Scherrerll/acg720-fpga-flight-controller/mechanical/README.md

# 机械结构与 CAD 资料

## 最终版总装（2026-10-31）

用户确认的机械最终版总装见 [最终版说明](final-assembly-20261031/README.md)和[原始压缩包「飞船五颜六色版.zip」](final-assembly-20261031/飞船五颜六色版.zip)。包内包含 1 个 SolidWorks 总装文件与 28 个零件文件，总装入口为 `450机架总装.SLDASM`。

## 2026-10-22 历史资料快照

以下历史快照于 2026-10-22 从用户提供的「飞机零件」资料中导出，仅归档 CAD 模型；不是当前飞行器的已核验制造包。没有打开 SolidWorks，没有重新保存、改属性、修复引用或转换原始模型，也未改动源资料。

导出 **51 个模型，23,077,780 字节**：3MF 1, DWG 1, DXF 1, SLDASM 3, SLDPRT 33, STEP 12。最大单文件 4,453,985 字节；本次适合普通 Git 存储，无需 LFS。模型清单见 [MODEL_INDEX.md](MODEL_INDEX.md)，逐文件原相对路径、字节数和 SHA-256 见 [export_manifest.json](export_manifest.json)。原始文件字节保持一致；manifest 自身不自哈希。

### 目录与入口

`cad/` 保留源目录层级，包括重复的「飞机总装/无人机总装/无人机总装」路径。原生装配入口共三个：

- `cad/装配体1.SLDASM`
- `cad/飞机总装/无人机总装/无人机总装/450机架总装.SLDASM`
- `cad/飞机总装/无人机总装/无人机总装/Sunnysky X2216 Motor.SLDASM`

打印件、发加工 STEP、浮筒 STEP/3MF 和厂商板卡 DWG 同样只是当时提供的设计/参考资料。打印件名中的数量、厚度及电池示意尺寸不视为当前装机需求。该历史快照没有导入 ZIP/RAR、视频、文档整包或 SDK。`~$` 临时锁文件排除；两个同哈希参考件重复已在 manifest 记录别名，原生零件的同哈希多路径仍保留。

### 装配依赖检查的明确边界

对三个原生装配进行了只读二进制签名、UTF-8/UTF-16 文件名候选和有限 zlib 头扫描。本机没有使用 SolidWorks 应用或 Document Manager；三个文件均未由本次扫描解析出组件引用树。详细结果及同目录可见文件见 [assembly_dependencies.json](assembly_dependencies.json)。

**三个装配的外部缺件情况均未能确定；未检出可读引用不等于没有外部依赖。** 内嵌/虚拟组件、配置、抑制件、外部搜索路径、保存版本、方程式和特征依赖未解析；未执行打开、解析、重建、干涉、质量或尺寸验证。不能据此声称总装可重建或零件齐全。以后应在合法可用的 CAD 环境中针对副本检查，并记录实际缺件及版本提示；本次不提供未经验证的装配修复。

### 与当前装机和固件的差别

- `Sunnysky X2216 Motor.SLDASM` 是模型所标的电机组件；现有硬件记录为 AIR 动力/电调相关实物，不能将 Sunnysky 模型当成实物型号证明，安装孔位、外形、重量与螺旋桨均未逐项核验。
- 模型含 ICM42688P、TFmini-S、D435i、浮筒/防水壳等历史或扩展设计；当前固件传感器已演进至 BMI088、MTF-01P，相机和浮筒模型不代表这些扩展已用于飞控闭环或经过飞行验收。
- `AVG720`/`ACX720-V3` 是原文件名，原样保留，不据此确认它们与实际 ACG720 60K 的板卡版本、孔位或连接器完全一致。
- 电池、电调等「示意」零件属于占位参考；未验证采购替代件、装配公差、承载能力、重心、线束避让或加工可制造性。当前硬件说明见 [HARDWARE.md](../docs/HARDWARE.md)。

### 来源与权限

模型来自用户提供的原资料；其中 Sunnysky、Intel RealSense、Holybro、北醒、BMI088 模块、板卡等明显厂商参考件的最初作者、下载来源和公开再分发许可未逐项核清。私有归档不产生公开再许可，本目录不授予统一 MIT/GPL 许可。保留原始模型及内嵌属性；没有为公开发布清洗作者、公司或外部路径元数据，也不将未知格式二进制检查视为完整隐私审计。后续公开前需另行核对来源、许可与元数据。
