Scherrerll/acg720-fpga-flight-controller/analysis/20261026_landing_altitude/README.md

# B0B3 最低油门悬停与前飞掉高调查（2026-10-26）

本次调查针对用户新飞行反馈：最低油门时仍悬空、基本不下降；前飞时略掉高。飞行记录、源码机制与定向 RTL 见证分别记录，不能互相替代。当前安装的 B0B3、Flash 镜像和用户参数均未被本次分析修改，没有重新综合、布线或烧录。

**范围更新：用户随后表示飞得较低，认为掉高与地效有关，要求该项不用继续处理。因此掉高调查到此暂缓，只归档此前已完成的证据；地效记为用户判断，不记为已验证根因。后续处理聚焦最低油门仍不下降。**

## 可以下电；参数已记录

飞机落地、桨叶完全停转后可以断开电池，后续分析使用已保存记录。最后已读回的水平共享参数是 **P=0.1000、I=0.0350、generation=8**。参数银行为易失存储，断电后恢复 P=0.0500、I=0；Flash 中的程序仍保留。下次停桨时可通过地面站重新写入成对参数，并查询确认。此次记录不等于这组增益已完成飞行验收。

## 新日志确认了什么

固定窗口 SHA256 为 `c46a8f81344b5af33060c216fd0446383a6b65c477680b73e0668d7df18b469c`，UTC 02:31:09.119024 至 02:53:44.270821，共 47,013 行。原始窗口保留在本机忽略目录，收据在 INPUTS.json；不依赖继续上电或读取活动日志。以下时间为北京时间，所有字段按同一 `(epoch, sequence)` 联结，缺包不补。

| 片段（epoch 8） | 观察 | 可成立的结论 |
| --- | --- | --- |
| seq4259–4282，约10:45:20–25，24帧、4.6秒采样跨度 | CH3=1002、CH5=2000；目标高度 +1284→−1740mm；融合高度260..318mm；24/24帧Z collective=1850；XY/Z active，fallback=false，Z reason=0 | 下降操纵已收到且目标确实下降；输出持续处于上限，不能归因为遥控未到最低、目标不下降或高度降级。日志是离散采样，不证明每个未记录时刻的值。 |
| seq4283 | CH5离开高位，飞行旗标关闭，四路PWM=1000 | 与用户拨开关才停桨的描述相符；不能把停桨当成正常下降着陆。 |
| seq3715–3738，seq3724缺主帧 | 两个严格连续子段均出现低CH3、负目标高度、Z collective=1850且未降级 | 同一次飞行内还存在相似高端保持；不跨缺帧声称连续性。 |
| seq3073–3080，较早generation 7 | 低杆时Z collective=1000..1195，电机受1200运行下限限制；下一帧CH5仍高但已停机 | 并非所有低杆事件都卡1850，也不能把1200下限统一当成本次根因；内部land_lock没有直接遥测。 |
| seq3579–3595，generation 8，3.2秒采样跨度 | CH2=1552..1594、CH3接近中位；目标恒1400mm；融合高度1214→941mm，原始距离1154→873mm；Z collective全1850，无fallback | 找到目标不变而高度下降的前飞相关片段；当时总油门已无继续上调余量。没有外部高度真值，不能单独确定物理掉高的全部原因。 |

参数响应 A591 使用32位事务号，不能与飞行遥测16位序号相联结。参数只按同次启动和先前有效读回关联。详见 logs/FINDINGS.md、joined_rows.csv 和解析脚本。

## 已复现的高度积分饱和机制

B3 高度输出为 `1000 + clip(0.2*e + I + bias, 0, 850)`。bias 趋近350；I限幅却允许约 `±(2000−bias)`，没有随最终850上限停止正向积累的反馈。I每11ms最多变化1.1，即最大约100单位/秒。

因此，较长正高度误差能在输出已到1850后继续累积I。随后最低油门稳态请求约−2500mm/s，外环约−1500mm/s，加速度和实测垂速接近零时P项约−600。若先前I+bias接近2000，减掉600仍大于850，输出会继续顶满，直到积分退回。水平P/I接口并不直接修改这个Z积分器。

真实 B3 `mtf_xyz_hold_control`、Z杆处理和数学服务的定向 RTL 测试已通过：合法固定 height=300mm、vz=0、az=0；CH3=1684自然累积约20秒后改为1002，无强制私有状态。下降后目标在1.199秒转负，但前4.6秒的419/419次Z发布仍为1850；6.182秒才离开上限，12.188秒才低于1250。独立 `ano_flight_state` 测试也通过：低杆+1850不能启动着陆计时；1250不满足严格小于判据；1249持续1501逻辑毫秒才触发land_lock。

这些时间是**固定传感器定向测试的逻辑时间，不是飞行操作等待时间**。回调的墙钟间隔加速，内部1ms杆处理和11ms PID步长保留；未模拟机体、ESC、传感器闭环、四客户竞争或整机PWM。因此证明的是源码机制自然可达，不能声称完整重放了本次飞行。日志没有内部I值，历史事件的唯一根因仍未确定；该机制是有实测对应和RTL见证支持的首要候选。

P2参考也包含该积分上限与最终输出裁剪结构。FINAL_P=0.35作用于姿态率环输出，P2高度输出并未在末端再乘一次0.35；不能以‘漏乘0.35’为由直接更改B3。

## 前飞掉高的判断边界

本节记录用户要求暂缓之前已完成的检查，不继续安排掉高调查、补偿修改或飞行验证。

当前主链没有按实际roll/pitch显式加入总推力倾角前馈。总推力不变时，其垂直分量随倾角减小，这是可能的贡献；测距几何中的余弦投影并不是推力补偿。混控逐电机裁剪，1850总油门附近上侧差动余量只有150，姿态修正可能进一步受限。

上述前飞片段实测roll仅−0.70..0.67°、pitch−1.06..3.95°，对应垂直投影损失小于0.25%，不足以直接把全部掉高归因于倾角。该片段同组上报的command和physical四PWM各自均值均为1850，均未触2000；两种四元组存在不同锁存时刻，不能据此说它们来自同次混控瞬间。最后一次飞行seq4041–4282的242个A582也都报告1850，高端状态早于最低油门。不能把PWM直接当推力，也不能由内部测距独立证明世界坐标高度。倾角、混控与参考源码细节见 tilt/FINDINGS.md。

## 修改与验收状态

- 本次新增有限日志解析、定向RTL见证和调查报告；没有修改当前飞控算法、用户参数或Flash。
- 已确认输出上限与积分上限不一致可产生较长恢复过程。修复候选应让Z积分感知最终输出饱和，并验证反向操纵能及时减小输出，同时覆盖正常悬停、起飞、下降与降级。不能直接用强制低杆停桨绕过下降控制。
- 尚未实现或验收该候选，没有新布线结果或可刷入的新版本；旧版高度首次失效、旋转假速度及持续悬停的未决项也不因本次见证自动结案。
- 当前下降控制异常应先在地面验证修复，不建议继续用飞行来试探它会等待多久才下降。

运行 `python -B analysis/20261026_landing_altitude/verify_analysis.py --external-inputs` 可校验归档和本机输入字节。它不重跑仿真，也不宣称完成飞行验收。模拟命令、退出码和范围分别见 landing/rtl_results.json 与 tilt/tilt_math_results.json。
