Scherrerll/acg720-fpga-flight-controller/firmware/B0B2/hardware/v15_active_imu_20261025T131703_954633Z/README.md

# V15 短时主动控制下的 IMU 连续性

**本项通过。**用户确认继续拆桨、机架放稳，以遥控器短时提速后将 SWA/SWC 拨低、油门拉至最低；软件全程只读本机 HTTP 遥测。

| 项目 | 结果 |
| --- | --- |
| 光流 XY、Z 高度及角速度控制同时工作 | 约 5.0488 秒，23 个不同主帧 |
| 该区间 IMU 原始 / 接收 / 姿态计数增量 | 各 5,008 |
| 整段记录 | 75.6972 秒，接收计数 +75,719 |
| 新增 IMU 拒收 / 控制故障 | 0 / 0 |
| 采样检查中的更新计数停滞 | 0 |
| 报告的 dt 范围 | 0.88944–1.1226 ms |
| 已完成姿态发布间隔历史最大值 | 最终 1.1226 ms |
| 主动控制期间四路 PWM 总范围 | 1392–2000 μs |
| 触及 PWM 限幅的不同主帧 | 5 / 23 |
| Z 总油门范围 | 1438–1850 μs |
| 光流目标姿态最大绝对值 | 0.16° |
| 姿态范围 | 横滚 +0.79～+0.85°，俯仰 +3.34～+3.37° |
| 最终停机 | 未解锁、控制关闭、四路命令及 PWM 均 1000 μs |
| 解锁撤销原因 | 0x34，SWA 回低 |

固定机架没有随升高指令运动，记录到总油门升高及混控限幅；这类拆桨记录不能用于验收空中增益、带载振动或悬停精度。本次只验证已安装 V15 在短时主动控制和电机提速时的 IMU 数据连续性。主帧只有约 5 Hz，计数来自板端诊断，主机没有逐个接收到所有 1 kHz IMU 样本。

整段主遥测 370 帧，缺失 8 帧、CRC 错误 0、丢弃字节 205。MTF 模块校验、长度、UART、超时、缺样、重复及重启计数均无新增。记录器当次最终检查无错误、丢弃记录块/字节为 0。

## 证据和镜像边界

- [统计结果](summary.json)、[原始记录](samples.jsonl)、[操作者完成记录](operator_finished.json)。
- 原始记录 SHA-256：`befb4a902f730a2da9908719d93d5e0436c71f1f4c5d65d8d2f72b32f58b33b6`。
- 观察器 SHA-256：`8f7eefa897b19d4bc5849f77729a7ae85e3af89654a681a9a6b0afd5935925d7`。
- 已安装 V15 清单 SHA-256：`c0827d5331af3055770dd999aee89e82ee5074ee20cae3aa076a0956155edca1`。
- 仍为 V15 SRAM B0B2；没有下载新候选，没有 Flash 写入，没有串口控制写入。新候选的两轮布局布线已停止。

零点修正及光流目标 ±12° 候选未安装。V15 继续保留原零点偏差、±25°目标与 ±15°观测范围不一致，以及未定量确认的光流尺度/旋转分量。现有 XY 是光流速度 PI，没有固定坐标位置外环；本项通过不等于稳定定点或飞行验收通过。`flight_ready=false`。

外场前必须处理镜像保持：当前 V15 只在 SRAM，整机断电会丢失；已验证的旧 Flash 默认是 B0B0。重新上电不能直接当作 V15 试飞。此前只授权 SRAM，本轮没有擅自改写默认上电固件。
