Scherrerll/acg720-fpga-flight-controller/firmware/B0B2/hardware/v15_flow_motion_20261025T125704_865917Z/README.md

# 本轮光流动作采集已取消，未取得通过结论

用户表示无法准确执行整组动作，并要求复用此前已经做过的检查。本轮因此停止，**平移轴向、比例及旋转资格均未通过**。`capture_summary.json` 的 `capture_completed` 只表示记录已正常关闭；其中 `operator_report.movement_sequence_completed=false`，不能解释为动作完成或验收通过。

最初 10 秒发生在动作提示之前，用户已明确确认机架由水平仪确认水平、机架静止、拆桨且 SWA/SWC 低档。这段独立静止参考保存为 `level_reference.json`，47 个不同遥测帧，横滚均值 +0.808085°、俯仰 +3.381915°，标准差约 0.00789°/0.00937°。该参考只用于候选安装零点，不用于拟合光流比例或旋转补偿。

整个只读采样持续 106.98 秒，491 个不同帧，IMU 接收计数增加 106,968，拒收及控制故障增量均为 0。未解锁，四路命令/PWM 保持 1000 μs。串口写入、下载器操作及 Flash 写入均为 0。原始采样 SHA-256：`31db4eb878a30c9af8a1b39fb11f53e3e59eb5e5deb952e946b230654a1e9c50`。
