Scherrerll/acg720-fpga-flight-controller/firmware/B0B2/hardware/v15_idle_imu_20261025T124850_724044Z/README.md

# V15 拆桨怠速 IMU 检查

结果：**通过本项检查**。用户确认四个电机怠速运行后以 SWA 低档停机；遥测记录与该操作相符。本项只覆盖拆桨、最低油门怠速，不证明带桨负载、主动角速度控制或飞行性能。

| 项目 | 实测结果 |
| --- | --- |
| 四路同时 1200 μs 的记录区间 | 22.2415 秒，90 个不同遥测帧 |
| 区间内原始 IMU / 接收 / 姿态计数增量 | 各 22,235 |
| 整段观察 | 78.1514 秒，接收计数 +78,123 |
| IMU 拒收 / 控制故障增量 | 0 / 0 |
| 采样检查发现的姿态计数停滞 | 0 |
| 怠速时报告的 dt | 0.88944–1.1226 ms |
| 已完成姿态发布间隔的历史最大值 | 前后均为 1.1226 ms |
| 怠速横滚均值 / 标准差 | +0.947° / 0.0156° |
| 怠速俯仰均值 / 标准差 | +3.2811° / 0.0138° |
| 解锁准备中断增量 / 解锁撤销增量 | 0 / 1 |
| 最终撤销原因 | 0x34，解锁开关回低 |
| 最终状态 | 未解锁，控制器未启用，四路命令及 PWM 均 1000 μs |

用户估计怠速约 15 秒；表中 22.2415 秒来自四路同时输出 1200 μs 的遥测区间。电机实际运转由用户确认，记录不包含转速测量。

整段 SiK 接收统计为 380 个主帧，序号缺失 10 帧，CRC 错误 0，丢弃字节 756。上述计数来自板端诊断，主机没有逐个接收到全部 1 kHz IMU 样本。姿态计数进展与已完成间隔共同用于检查；历史最大间隔本身不能证明不存在持续停滞。

当前镜像仍是 V15 SRAM B0B2；水平安装零点修正尚未加载，表中的姿态均值不能解释为已校零。观察器只读取本机 HTTP 遥测，串口写入 0，下载器操作 0，Flash 写入 0。电机启停由用户手动操作遥控器完成。

## 证据

- [统计结果](summary.json)、[原始采样](samples.jsonl)、[用户完成记录](operator_finished.json)。
- 原始采样 SHA-256：`73ae147c9a5ea0ad537732e40c87c04ce4c19da57e3202b01631316064fd47e4`。
- 观察器 SHA-256：`41e2b12e757193a6c601ce00f0232df9f08caab46220f8155651d6cc40ff26d5`。
- V15 清单 SHA-256：`c0827d5331af3055770dd999aee89e82ee5074ee20cae3aa076a0956155edca1`。

同日独立只读核验位于 `C:\Users\ScherrerL\Desktop\apple\timing_closure_20261025\v15_independent_20261025T124648_694529Z\summary.json`：54 个源码文件及 313 项封存证据哈希一致；复用与当前源码匹配的逻辑、映射及复位证明，并在副本上重新解析全部五类 STA，通过原约束 19.5 ns，Fmax 51.400 MHz。该核验没有重新运行逻辑仿真或布线。

按用户要求，已完成且对应控制文件未变的旧电机编号、旋向和纠偏方向结果复用；单独的 RC 超时实物复测跳过，不记为通过。全部新布线及校零镜像工作继续暂停，不自动恢复。本次通过不构成飞行放行。
