Scherrerll/acg720-fpga-flight-controller/firmware/B0B2/hardware/v15_rc_suite_20261025T110730_794943Z/README.md

# V15 遥控输入与模式请求检查

四个方向/油门输入以及 SWC 请求选择检查通过。全程 SWA 低档、未解锁、控制器禁用，四路指令及 PWM 均为 1000 μs。未发送控制命令、未重新下载镜像、未写 Flash，布线继续暂停。

| 通道 | 最低 μs | 最高 μs | 回位均值 μs |
|---|---:|---:|---:|
| CH1 横滚 | 1000 | 2000 | 1499.0 |
| CH2 俯仰 | 1000 | 2000 | 1501.0 |
| CH3 油门 | 1001 | 2000 | 1004.9 |
| CH4 偏航 | 1000 | 1995 | 1500.0 |

SWC 低、中档的 FPGA XY 请求关闭；高档开启；回低档撤销。各档均有新鲜 A582 v5 FPGA 报告核对，实际控制保持待机。低、中档界面为“自稳 + 高度控制”，高档为“光流速度控制 + 高度”。

所有阶段均无新增 IMU 拒绝或控制故障。遥测接收统计在五个观测区间内累计缺 33 帧、校验错误 2 次；所有实际检查读数均保持新鲜，原始记录及逐区间统计保存在摘要中。这些接收统计不构成物理故障原因判定。

这里验证的是未解锁条件下的输入、模式请求与输出隔离；电机编号/旋向、解锁控制反馈与实际飞行性能尚未由本轮验证。

完整摘要及逐阶段证据： [summary.json](C:/Users/ScherrerL/Desktop/apple/github_publish/acg720-fpga-flight-controller/firmware/B0B2/hardware/v15_rc_suite_20261025T110730_794943Z/summary.json)
