Scherrerll/acg720-fpga-flight-controller/firmware/B0B2/hardware/v15_stick_oscillation_20261025/rotation_followup/README.md

# V15 光流振荡：去旋转、单位与时间链路补充核查

2026-10-25。本记录补充并收紧上轮调查的根因判断，原始失败记录和此前悬停成功记录均保留原范围。

**当前结论：动态打杆振荡仍未修复，唯一根因尚未锁定。未发现 PID 默认增益、速度单位、约定轴变换或报文打包错误。当前配置在确认放稳的 20 秒中没有持续静止假速度。V15 未做外部去旋转是事实，但“MTF 必须补上外部去旋转”尚未获证；不能直接搬原 P2 的 160 系数或据飞行相关性拟合后上板。**

## 已完成的独立核查

| 核查 | 结果与范围 |
|---|---|
| PID 与速度环方程 | 与所提供 ANO 工程默认值/纯光流 of_df 支路一致，未发现 P/I/FF、反馈符号、20 ms 控制周期、回中 LPF 的明确移植错误。与未知 EEPROM 或原智能光流 of_ok 支路整体相同的说法不成立。 |
| Micolink 单位 | 厂家定义 cm/s@1m；V15 `raw × distance_mm / 100` 得到 mm/s，Q16 转换一致，不应再除模块 dt。 |
| 实际原始 RTL 单位检查 | 对冻结 V15 的 `mtf_metric_observer` 执行 19 个定向仿真用例：正负号、距离比例、dt 独立、无效输入、重复/重启连续性全部通过。这不是整个控制器/实际飞行动力学的仿真。 |
| 传输与数值链 | 独立脚本逐条检查手持捕获的 956 条记录、793 份不同 Micolink 帧。帧结构/校验/11载荷字段、metric、已存在的937组A589配对及显示换算无差异；19条缺A589不做错配。 |
| 约定坐标 | 当前前向=+rawY、右向=−rawX，符合既定安装旋转180°推导与历史平移符号；代数一致不能替代对当前安装的独立物理测量。 |
| 粗粒度延迟关联 | 本轮飞行光流与相应高度×角速度，在0偏移相关约.930/.922；±200ms时明显下降。此结果不能识别10ms曝光或精确陀螺滤波相位，也不能从真实平移中分离旋转。 |

## 为什么需要收紧“缺去旋转”的判断

原 ANO 的 UP_OF 路径采用光流积分、独立积分时长、160 pixel/degree 以及0.00012的光学尺度；基础陀螺滤波之后还增加5 Hz LPF以匹配相位。MTF 输出已经是归一化速度，并非同一种输入，不能直接移植160。

更关键的是，已固定的 FMT 参考代码虽然包含可选陀螺补偿路径，`fmt_ins_interface.c:76` 的 **OPF_FIX_GAIN 默认是0**；其默认路径仍做滤波、坐标和高度换算。因此不能将“参考中存在补偿代码”表述为“该模块默认必须外部扣陀螺”。

[厂商 Micolink 原始说明](https://micoair.com/docs/decoding-micolink-messages-from-mtf-01/)只把 `time_ms` 定义为模块系统时间，说明速度单位/换算，没有定义曝光开始、中心或结束，也没有提供陀螺积分或承诺模块内部补偿算法。V15 `dt_ms` 是相邻模块时间戳的差，**不能当作已知曝光窗**。A589仅为 FPGA 收帧时抓取最新的四级过滤后gyro；不是曝光同步积分，当前约5 Hz下传不能反演精确相位。

现有旧手持俯仰记录累计位移很小，同样说明“任何姿态变化都必然产生固定系数的大伪位移”的说法过强；因未独立约束光心平移，既不能证明内部补偿，也不能用于拟合系数。

## 本次两段新增实物记录

### 手持倾斜：仅保留观察，不作为静止或标定

[采集及响应统计](../../v15_unarmed_rotation_20261025T141628_867271Z/response_analysis.json)、[信号图](../../v15_unarmed_rotation_20261025T141628_867271Z/response_overview.png)。177.08秒、956个HTTP快照组合、778份不同的A589接收配对；横滚−8.33°…+10.29°、俯仰−8.04°…+16.73°；始终未解锁且四路1000 μs，新增IMU接收177285、拒收/控制故障0。

操作者随后确认开始动作前“**没放稳**”。因此前段不能作为静止基线，不能由其读数推断模块静止噪声；整段手持平移、转轴/光心位置没有独立测量，不能据此辨识旋转补偿系数。该限制已单独保存为 operator_context_followup.json，未改原采集内容。

### 固定支撑、手离开的20秒：当前静止读数干净

[静止报告](../../v15_static_mtf_20261025T142505_861414Z/summary.json)。操作者明确确认机体已放稳、手离开，采集20.156秒、94份不同MTF快照，模块计数增加1998：

- 姿态标准差：横滚0.0117°、俯仰0.0125°；距离202–226mm。
- 下传的两轴原始速度均为0；前向累计变化0，右向累计变化约−0.002mm、跨度约0.006mm。**这些是寄存器积分数值，不代表微米级实际定位精度。**
- MTF校验、UART、丢包、重启和积分中断计数均无新增；IMU接收增加20032，拒收/控制故障0。

这支持“当前表面/光照/高度、停机条件下没有持续静止假速度”，不能排除带桨振动、不同高度/表面或动态移动时的测量问题。

## 尚可定位的动态差异与下一步

1. 原融合按20ms运行；V15预测随加速度回调、纠正随新MTF包运行。名义Kp/Ki相同不保证完整离散相位/采样保持相同。原智能光流 of_ok 支路给P和I的反馈也不同于当前纯融合速度。
2. 光流倾角越过15°会退出并重置速度融合，控制器保留已完成的PI/滤波状态；两次实飞越界退出/恢复已记录。它可放大扰动，但本次起振时目标角本来低于12°，仅限幅到12°无法改变该起振阶段。
3. 当前速度按斜距缩放，FMT使用`distance*cos(roll)*cos(pitch)`；在各轴15°内，单轴差约3.53%、双轴约7.18%。这项差异可核实，但不能据此独自解释大幅振荡。
4. 若要将旋转污染与真实平移分离，下一份有判别力的证据需要**约束/测量光心位置的固定转轴、明确的旋转/平移对照**，并据此检查尺度和相位。再重复无位置约束的手持动作不能完成这个辨识。另一条独立分离路径是先确认姿态内环的带载小信号动态，再判定外环/测量链的阻尼；当前数据不支持声称内环已经完全排除。

本轮检查到此结束；PID、产品源码、已固化位流均未改动，没有综合、布线、下载或Flash操作。V16/V17继续暂停。后续修复应由可区分的证据驱动，当前不应以“降低PID”或“直接加去旋转”替代根因辨识。

## 可复查材料

- [19项实际RTL检查](metric_contract.json)
- [飞行数据轴/粗延迟比较](axis_lag_analysis.json)
- [控制方程独立核对](C:/Users/ScherrerL/Desktop/apple/timing_closure_20261025/flow_control_equation_audit/README.md)
- [时间链路独立核对](C:/Users/ScherrerL/Desktop/apple/timing_closure_20261025/flow_rotation_timing_audit/README.md)
- [原始报文链独立核对](C:/Users/ScherrerL/Desktop/apple/timing_closure_20261025/flow_rotation_protocol_audit/receipt.json)
- [FMT 固定参考说明](C:/Users/ScherrerL/Desktop/apple/routing_rescue_20261015/mtf01p_b0a8/references/primary_mtf_axes/EVIDENCE.txt)
