Scherrerll/acg720-fpga-flight-controller/mechanical/MODEL_INDEX.md

# 模型清单

按源目录相对路径保留；SHA-256 完整值见 `export_manifest.json`。文件数量不代表零件实例数、BOM 数量或已装机数量。

| 相对源路径 | 格式 | 字节 | SHA-256 前 12 位 |
|---|---|---:|---|
| `20008. YBX-BMI088(SPI)惯性测量单元传感器模块/3D模型/YBX-BMI088 (SPI) v1.0.step` | STEP | 1523709 | `6641772b9f94` |
| `ACX720-V3机械文件/ACX720-V3.DWG` | DWG | 150108 | `f6bb623a6451` |
| `D435i.SLDPRT` | SLDPRT | 1836562 | `839288fb0c34` |
| `Holybro SiK Telemetry Radio V3 数传电台.SLDPRT` | SLDPRT | 107272 | `7786887c4ebd` |
| `ICM42688P模块.SLDPRT` | SLDPRT | 100745 | `36c5b9d62989` |
| `d.SLDPRT` | SLDPRT | 132059 | `06aa7618c517` |
| `光流直接粘.SLDPRT` | SLDPRT | 72198 | `fedb6fb6c3f2` |
| `北醒TFmini-S激光测距传感器.SLDPRT` | SLDPRT | 82417 | `3311d2527389` |
| `发加工/中板无人机3mm.STEP` | STEP | 645119 | `26f5e2730bc5` |
| `发加工/无人机底板2mm.STEP` | STEP | 426638 | `594ba1f8d638` |
| `发加工/无人机顶板3mm.STEP` | STEP | 568665 | `59e5b1299d63` |
| `发加工/机臂碳管4个.STEP` | STEP | 143882 | `8d64cf0815d9` |
| `发加工/电机碳板3mm 8个.STEP` | STEP | 82439 | `4bd21d27b8f0` |
| `打印件/imu块块.STEP` | STEP | 43874 | `a50b3956777e` |
| `打印件/相机安装件1个.STEP` | STEP | 104896 | `fb2012c7b5c6` |
| `打印件/起落架.STEP` | STEP | 273810 | `5bb3bd259127` |
| `打印件/顶板中板连接件3个.SLDPRT` | SLDPRT | 111029 | `e7cdc4bd57a4` |
| `打印件/顶板中板连接件3个.STEP` | STEP | 44147 | `be41cbc196cf` |
| `无人机顶板3mm.STEP` | STEP | 568676 | `63c44623da86` |
| `电池.SLDPRT` | SLDPRT | 99845 | `52f3f2939b77` |
| `装配体1.SLDASM` | SLDASM | 432814 | `736988e76a0d` |
| `降压模块直接粘.SLDPRT` | SLDPRT | 72517 | `5d524850c489` |
| `飞机总装/无人机总装/无人机总装/1045 propeller.SLDPRT` | SLDPRT | 332194 | `143ad68d3758` |
| `飞机总装/无人机总装/无人机总装/16mm碳管脚架.SLDPRT` | SLDPRT | 212996 | `a0b4b4bebe70` |
| `飞机总装/无人机总装/无人机总装/450机架总装.SLDASM` | SLDASM | 4453985 | `6e9389ba1f52` |
| `飞机总装/无人机总装/无人机总装/AVG720.SLDPRT` | SLDPRT | 82726 | `35e2695df5c6` |
| `飞机总装/无人机总装/无人机总装/D435i.SLDPRT` | SLDPRT | 1836562 | `839288fb0c34` |
| `飞机总装/无人机总装/无人机总装/Holybro SiK Telemetry Radio V3 数传电台.SLDPRT` | SLDPRT | 107272 | `7786887c4ebd` |
| `飞机总装/无人机总装/无人机总装/ICM42688P模块.SLDPRT` | SLDPRT | 100745 | `36c5b9d62989` |
| `飞机总装/无人机总装/无人机总装/Sunnysky X2216 Motor.SLDASM` | SLDASM | 2820805 | `0a932e6f0bda` |
| `飞机总装/无人机总装/无人机总装/中板无人机.SLDPRT` | SLDPRT | 749992 | `083a54d81c10` |
| `飞机总装/无人机总装/无人机总装/保护壳.SLDPRT` | SLDPRT | 108928 | `faac50e790e7` |
| `飞机总装/无人机总装/无人机总装/北醒TFmini-S激光测距传感器.SLDPRT` | SLDPRT | 82417 | `3311d2527389` |
| `飞机总装/无人机总装/无人机总装/无人机底板.SLDPRT` | SLDPRT | 720719 | `3f4cd946df0e` |
| `飞机总装/无人机总装/无人机总装/无人机顶板.SLDPRT` | SLDPRT | 661219 | `32264b68902a` |
| `飞机总装/无人机总装/无人机总装/机臂碳管.SLDPRT` | SLDPRT | 172217 | `0358e06cde3f` |
| `飞机总装/无人机总装/无人机总装/机臂管架.SLDPRT` | SLDPRT | 117593 | `fbaadabfbd1a` |
| `飞机总装/无人机总装/无人机总装/浮筒.SLDPRT` | SLDPRT | 71178 | `aa72d665139c` |
| `飞机总装/无人机总装/无人机总装/电机下固定碳板.DXF` | DXF | 27885 | `0c7278da54da` |
| `飞机总装/无人机总装/无人机总装/电机下固定碳板.SLDPRT` | SLDPRT | 507901 | `f2b4fe4cb5a2` |
| `飞机总装/无人机总装/无人机总装/电机碳板.SLDPRT` | SLDPRT | 478790 | `ceb4258b1126` |
| `飞机总装/无人机总装/无人机总装/电池示意43X43X80.SLDPRT` | SLDPRT | 126709 | `05a26a316286` |
| `飞机总装/无人机总装/无人机总装/电调示意.SLDPRT` | SLDPRT | 115178 | `bdf42ae1252e` |
| `飞机总装/无人机总装/无人机总装/相机安装件.SLDPRT` | SLDPRT | 149898 | `0e2aaea174b6` |
| `飞机总装/无人机总装/无人机总装/碳管固定座.SLDPRT` | SLDPRT | 247552 | `af77808e2a56` |
| `飞机总装/无人机总装/无人机总装/脚架接底板连接件.SLDPRT` | SLDPRT | 194207 | `721d042a0979` |
| `飞机总装/无人机总装/无人机总装/防水保护壳.SLDPRT` | SLDPRT | 577773 | `d94fa4c8eead` |
| `飞机总装/无人机总装/无人机总装/降压模块直接粘.SLDPRT` | SLDPRT | 72517 | `5d524850c489` |
| `飞机总装/无人机总装/无人机总装/顶板中板连接件.SLDPRT` | SLDPRT | 105384 | `ca5406aa1fd9` |
| `飞机总装/浮筒.3mf` | 3MF | 203841 | `3c0825ae7c8e` |
| `飞机总装/浮筒.STEP` | STEP | 15176 | `86a9815758c4` |

## 排除与重复处理

仅按字节相同的 SHA-256 合并两个明确的参考件重复；原生零件目录的重复副本保留，以免进一步破坏潜在相对引用。
- `20008. YBX-BMI088(SPI)惯性测量单元传感器模块/3D模型/YBX-BMI088 (SPI) v1.0(1).step`：byte-identical vendor STEP duplicate。 保留 `mechanical/cad/20008. YBX-BMI088(SPI)惯性测量单元传感器模块/3D模型/YBX-BMI088 (SPI) v1.0.step`。
- `AVG720.DWG`：byte-identical board drawing duplicate; keep named vendor drawing。 保留 `mechanical/cad/ACX720-V3机械文件/ACX720-V3.DWG`。
- `飞机总装/无人机总装/无人机总装/~$电机下固定碳板.SLDPRT`：SolidWorks temporary lock file。
