Scherrerll/acg720-fpga-flight-controller/docs/STATUS.md

# 控制边界与待验收事项（2026-10-29）

最新的 [B0B5 V8 水面双推进版本](../firmware/B0B5/README.md)使用 A13/A14 输出 50 Hz PWM，包含模式互斥和重新使能保护。该版本的 13 项离线检查和真实 20 ns 五类 STA 均已通过。2026 年 10 月 29 日，用户反馈：“好的，我测试了一下没有问题，可以的”。这里将其记录为当前接线和测试条件下运行正常；由于没有提供具体测试项目、外部波形、镜像读回或冷启动证据，不能据此认定完整硬件或飞行资格已通过。

原始离线包及打包时的硬件状态保持不变，后续反馈见 B0B5 版本说明。下面是 10 月 26 日及更早阶段的历史状态；B0B4 后续安装和验证情况见仓库中的相关归档。

## 10 月 26 日历史状态

当时最近记录的机载基线为 P005/I0（B0B2），10 月 25 日晚的独立 Flash 校验和电池冷启动证据见[历史回执](../validation/20261025_p005_i0/README.md)。本轮没有重新检查实体或操作下载器。

[B0B3](../firmware/B0B3/README.md)完成了共享 XY 速度 P/I、电脑工具和离线验收：完整布线、实际 20 ns 约束、Fmax 50.257 MHz，五类时序通过。**当时尚未安装或写入 Flash，实机参数通信和飞行动态未验收；`flight_ready=false`。**

参数默认 P=0.05、I=0，范围为 0～1，步长 0.0001，两轴共用。写入前会核对停机条件和提交边沿；CH5 处于预解锁意图时禁止写入，飞行中只允许查询。参数修改仅在本次上电期间有效。644 字节旧遥测保持兼容，参数响应通过 A591 协议和 B0B3 构建标识识别；旧遥测仍保留 B0B2 身份，不能单凭它确认新镜像。

调参实现中的位宽溢出和解锁/提交竞态已在交付前修复，并有直接对照。转动相关伪速度和高度首次失效源仍未定位，参数接口没有解决这些问题；项目也没有加入位置环或未经辨识的去旋转补偿，既有保护保持不变。详见[两天进度](WORK_20261025_26.md)和[完整分析](../firmware/B0B3/analysis/FINDINGS.md)。

P005/I0 原 19.5 ns 报告的 setup WNS 为 −0.267 ns，共 51 个违例端点；当时对 20 ns 的判断属于分析性审阅。原 V15 的 19.5 ns 通过记录和 B0B3 的新 20 ns 厂商报告分别保留，不能互相替代。回中刹停、持续悬停、高频环路和带桨负载仍未完成新镜像资格验证。

实机 SRAM 测试需要重新确认接线、拆桨和停机状态，并取得当次授权；Flash 另行处理，不自动操纵遥控或电机。本次 Git 进度上传不重启接收器或网站，也不启动实时分享。

## 10 月 24 日历史边界

本节记录的是当时状态，不是当前机载镜像说明。当时默认版本为 B0B0，已写入 Flash 并完成电池单独供电冷启动；完整结果见 [B0B0](../firmware/B0B0/README.md)和 [10 月 23～24 日记录](WORK_20261023_24.md)。原 B0AE、B0AC 说明是历史快照，不再代表当前设备版本。

当时已通过的项目包括：零未通与 51.608 MHz 时序；选中源码、网表和位流哈希核对；三个增量证明和 13 项 MTF 边界检查；拆桨条件下的正常高度控制、测距失效后手动接管和重连不抢回；一分钟融合静止观察；四向带动力修正方向；以及 Flash 编程、独立校验、重载和电池冷启动。

SWC 低、中档为自稳加高度控制，高档请求光流速度控制加高度；低档不能称为直接手动 PWM。测距失效时切换为手动油门并锁存，传感器恢复后不会自动抢回。最低油门持续后约 1.7 秒落地锁定，当时由操作者确认为预期行为。

水平方向使用融合速度 PI，没有绝对位置外部基准。累计位置用于诊断；一分钟观察得到的 4.401 mm 不代表所有表面和动作都具有相同漂移，不同条件下的较大漂移也已记录。几何链路没有因为手动倾斜观察而增加经验比例或陀螺补偿。

仍未完成的验证包括带桨振动和负载、空中稳定性、光流转动分量与真实平移的严格区分，以及活动 XY 控制下的实际动态表现。四向纠偏试验在 SWC 低档进行，且存在混控饱和，因此只验收方向，不评价空中增益。`flight_ready=false`。

此前约 10 秒掉动力的原因由操作者确认为电池松动；这是操作者提供的硬件说明，软件无法独立证明。系统没有电池电压、电流或 ESC 转速遥测，所上报的 PWM 不等于外部波形、推力或 RPM 实测。SiK 断连期间也没有机载持久日志补回能力。

官网只读摘要按数据年龄标记 fresh、延迟或断线，不能替代飞控保护。链路为 COM17 → 本地接收器 8765 → HTTP-only 旁路 8766 → gmflylog.com；8767 不得再次占用同一 COM17。旁路每次正常启动时默认关闭分享，只有明确启用后才上传实时摘要，日志仍需逐条手动选择。
