Scherrerll/acg720-fpga-flight-controller/web/flight-console/ATTITUDE_TRACKING_20261024.md

# Estimate / Setpoint 姿态跟踪显示

本次仅改地面接收、转发和网页。不修改 RTL、约束、位流或 Flash，不重新综合、布线、烧录。

## 已有遥测

B0B0 的 A579 主包已包含下列字段。目标来自 FPGA 上报，不能用遥控杆映射值替代实际控制目标。

| 网页/CSV 字段 | A579 来源 | 单位与含义 |
| --- | --- | --- |
| `roll_sp_deg` | `target_roll_cdeg / 100` | 横滚目标角，度 |
| `pitch_sp_deg` | `target_pitch_cdeg / 100` | 俯仰目标角，度 |
| `yaw_rate_sp_dps` | `target_yaw_rate_cdeg_s / 100` | 偏航目标角速度，度/秒 |
| `yaw_rate_dps` | `gz_corrected / 16.4` | 已滤波、去偏的机体 Z 轴陀螺角速度，度/秒 |

Roll/Pitch 与同一主包的姿态估计角比较。Yaw 比较的是角速度；现有包没有航向角目标，不能把角速度目标画在航向角坐标上，也不在地面端积分出一个冒充 FPGA 目标的航向角。原相对航向角仍单独保留。

目标线按阶梯绘制，缓冲回放在下一个真实目标样本到来前保持前一上报值；估计/测量线保持原平滑方式。缺失或无资格的数据保持空值，源缺口、过期提示和原始解锁/PWM 值保留。停机时上报的目标不代表控制正在生效。

## 使用

实时页分别显示 Roll、Pitch 和 Yaw Rate 的 Estimate/Setpoint 对比。日志分析新增“跟踪对比”选择框，可切换三轴，也可继续自选字段；有完整 Roll 对比字段时默认选中这一对。没有相应目标字段的旧共享日志不会补造目标。

接收器通过 `local/receiver_setpoints.py` 包装已有只读服务，在内存中增加快照与 CSV 导出字段，并在新日志元数据中记录包装器源码哈希。已有原始日志不改写；其中带有新鲜 B0B0 身份和 A579 目标字段的记录可由新版导出器重新读取。既有云日志仍使用原已分享副本，不自动重新上传。

完整仓库内可运行 `python local/receiver_setpoints.py --port COM17 --baud 115200 --source SiK --http-port 8765 --logs "原有日志目录"`，工作目录为 `web/flight-console`；先退出占用同一串口/HTTP 端口的旧接收服务。独立部署副本需另加 `--receiver-dir "原 ground_server.py 所在目录"`。HTTP 转发仍用原显式分享入口。

本机已加载包装器，并保持原 COM17/115200/SiK 配置与原日志目录。旧日志段 `20261024T025939Z_beb53bf1` 正常关闭，新段为 `20261024T091159Z_65ddb3d0`。原 `ground_server.py`、`protocol.py`、`analysis.py`、`recorder.py` 文件哈希均未变化。

## 验证与边界

- 35 项 Node 测试、26 项 Python 测试通过，包括目标阶梯、角速度单位、未知/失效字段、云端白名单、真实应用绘图和日志轴切换；实际接收器的无串口回环启动/关闭及新日志元数据也有覆盖。
- 真实同序号 A579 原始记录与网页上游目标/角速度逐字段一致；新增本地日志已导出 387 个同时具备目标值和角速度的真实样本，本地浏览器验证 Roll → Pitch → Yaw Rate 切换。
- 官网 HTML、app.js、styles.css、live-playback.js 的 SHA-256 与构建一致，均以正确 MIME 返回；正式 live API 已返回 B0B0 及新字段，112 个历史点包含目标/角速度。
- 发布到原 EdgeOne 项目，部署号 `dp7aq5hulna5`。源码 ZIP 39 文件，SHA-256 `0eae226fc84986b393df906bc7afef229c8993b0968a2c6aba77d89dde98f089`，不含凭据或本地日志。

约 5 Hz 的地面遥测快照可用于观察较慢的姿态跟踪；实时近期趋势继续使用原有约 2 Hz 历史抽样，日志则读取导出的 A579 记录。它不能等同于 PX4 高频机载 ULog，不能证明高频内环性能。此次显示验证不增加飞行资格结论。

## 同日：恢复三轴姿态总览

按用户提供的合并曲线示例，实时页默认同图显示横滚 Roll、俯仰 Pitch、相对航向 Yaw，共用角度轴（度）和时间轴。颜色分别为青、蓝、橙，不混入单位为度/秒的偏航角速度。融合高度仍单独显示，三个目标跟踪图移到下方默认折叠的“目标跟踪对比”。展开时立即绘制，收起时不重绘隐藏图。日志的选择框也增加“三轴姿态总览”，原目标对比选项保留。

35 项 Node 测试再次通过，新增检查覆盖同一 Canvas 三条角度曲线共用比例尺、未知航向不冒充零值、默认折叠/展开绘图，以及日志三轴选择。本地真实遥测页面已核对三轴同图与展开/收起效果。仅改前端，接收器、桥接进程、遥测与固件均未重启或更改。部署号 `dp4a3wmj5ies`，源 ZIP SHA-256 `dad83cb2f836cd56e1e282d3d47971cfbf2dadad8a462221c030ffec42a10c2e`。
