Scherrerll/acg720-fpga-flight-controller/analysis/agent_reviews/v22_independent_20261027/FINAL_REVIEW.md

v22 final independent offline review passed; no actionable findings.

Source55 and one-file inverse match remain exact. The original root1 is the actual alias TEMP compilation failure; four successful stages, exact-fixture alias compile/vvp/root0, and completion root0 are separately checked. All22 successful receipts, logs, immutable inputs and unchanged guard/FSM/ground dependencies were rehashed. Original top13 is byte-exact and retains its disclosed forces. No whole-flight or physical timing proof is claimed.

The five exact-hash SYN scripts retain SYN-only, original helper, CLK50/20ns, radio, gain1000/350,18scalar ports, actual vendor/audit/root0 and complete sealing gates. The supported signal-level hint still needs actual mapping measurement. Root must supply its independent review before creating the gate. No vendor was launched and no candidate file was edited.

Citation erratum only: the priority example in SUG550 is printed page34, not31.
