Scherrerll/acg720-fpga-flight-controller/analysis/20261026_landing_altitude/logs/FINDINGS.md

# 新实飞有限窗口：低油门不下降与水平杆掉高

仅分析root固化的72,327,699字节、47,013行窗口，SHA256 `c46a8f81344b5af33060c216fd0446383a6b65c477680b73e0668d7df18b469c`；UTC 2026-10-26 02:31:09.119024–02:53:44.270821（北京时间10:31–10:53），全部为epoch8。没有读取活动日志尾部，没有HTTP、串口、硬件或Git动作。所有新增文件仅在本目录。

**关键症状已在同key日志中确认：最新两段低CH3时目标高度在下降，但Z总距请求保持1850，XY/Z仍活动且没有fallback；并非目标根本未下降。更早另有总距降至1000、输出触1200下限并随后停机的不同片段，不能混成同一机制。** 为什么Z输出保持高端，需结合源码与定向RTL结果判断，日志没有内部Z积分/限幅前各项。

## 参数与数据资格

- A591的32位`sequence`是参数事务号，未与遥测组序号混用。按同epoch接收顺序，将已观察到的成功读回关联到后续组；未读回区间保留未知。
- 最新SET事务1973207201（UTC02:42:35.573542）及独立GET1973207202（35.911683）均为P_wire1000、I_wire350、generation8，即 **P=0.1000/I=0.0350**。CSV的显示文本由wire/10000生成，保留gen与读回时刻。此前gen7为0.1000/0.0300。
- 按`(epoch,sequence)`拼A579/A580/A582/A57A/A581/A585，6776个组，主帧6651、状态包6667、导航包6764；缺包不借相邻帧。947个具有主帧和导航包的可见XY活动组，实际roll/pitch目标均等于同组导航目标。
- `log_summary.json/flight_envelopes`列出10段可见taking_off活动范围；包缺失只记未知，不填成持续有效状态。严格连续的XY、低杆及正/负CH2子段另列`segments`。全包共同缺失的一处为seq3264。

## 直接证据

下表时间为FPGA uptime跨度；PWM和总距均是机上上报值，不是推力、RPM或示波器测量。高度为估计量/原生斜距，不是外部高度真值。

| epoch8窗口 | 同key输入与资格 | 目标与高度 | 总距/输出及结论边界 |
|---|---|---|---|
| **4259–4282**，24帧、4.6s，UTC02:45:20.881–25.492；gen8 | CH3恒1002、CH5恒2000；taking_off/flying/prepared、XY/Z active均真；fallback全false，Zreason0 | target_height **1284→−1740mm**；fused **271→260mm**，全段260..318；原始distance **385→360mm**，全段354..412 | **24/24 z_collective=1850**；上报各电机范围1696..2000，其中一次触2000。可排除本段“目标不下降”及“只卡1200最低输出”的简单解释；没有可见自动停机。 |
| **3715–3738**，主/状态/导航同key为23帧；gen8 | 3715–3723与3725–3738分别连续1.6/2.6s；CH3为1002..1086、CH5=2000，均正常XY/Z、无fallback | target **−238→−1490mm**；fused **511→513mm**，已知样本496..572；原始distance端点434→434 | 已知低杆23帧Z总距均1850。**3724只有导航包**（该包也为1850），不补其CH3/解锁/状态；3739也缺主/状态。3740首个完整停机组CH5=1500、四路1000。 |
| **3073–3080**，8帧、1.4s；gen7 | CH3=1002..1004、CH5=2000；XY/Z活动、无fallback | target **−812→−1800mm**；fused **177→201mm**；原始distance245→247 | Z总距 **1195→1000**，范围1000..1195；8帧至少一路为1200，3080四路均1200。**3081 CH5仍2000，但armed/taking_off/flying/prepared均false、四路1000**。这是不同的低输出/停机片段，不能说所有低杆都必须靠SWA停机；其内部停机原因不由此单独认定。 |
| **3579–3595**，17帧、3.2s，UTC02:43:04.909–08.199；gen8 | CH2=1552..1594，CH3=1488..1498；可见XY/Z活动、无fallback | target_height **恒1400mm**；fused **1214→941mm**（−273），原始distance **1154→873mm**（−281）；pitch快照−1.06..+3.95° | Z总距17/17为1850。本段可证水平杆动作时，在目标未降的情况下两类高度读数下降；不能直接把它归因于倾斜升力、XY参数或某个Z内部项。CH2正侧动作不单独证明外部真实前飞方向/轨迹。 |

最后一段4282之后，4283（UTC02:45:25.722）CH5变为1500，armed/taking_off/flying/prepared与XY/Z active全false，上报四路1000；4284 CH5为1000。该可见顺序与操作者通过SWA退出后停桨相容，不把采样间隔内的精确动作时刻补出来。

## 能排除和仍未知的内容

1. 最新两个gen8低杆片段，不能解释成“未收到最低CH3”“高度目标没有往下降”“当前进入了height_loss_fallback”或“仅被1200运行floor夹住”。输入、目标、flags和总距已有直接证据。
2. gen7低杆片段确实出现另一种1200输出floor，并在下一完整组观察到停机；不能从本窗口证明该floor物理推力足以悬停，也不能把gen7与gen8的差异直接归因于仅改变XY I。两次起飞过程和内部状态不相同。
3. 日志**没有land_lock、landing_ms、landing_delay或Z内部P/I/前馈/限幅前总距**。可以说“低杆期间仍有taking_off且未见停机”，不能直接说“landing计时器一直为0”或唯一断定未过哪条内部条件。
4. 3579–3595支持用户掉高描述的一段可见现象；没有外部位置/高度真值、推力余量和高频控制分项，不能只由倾角快照计算闭环因果。
5. 本次是新B3实飞窗口，与此前旧V15/P005问题分开。现象定位不构成修复、增益建议或飞行验收。

复算命令（需原本地固定输入）：

```powershell
python -X utf8 -B analysis/20261026_landing_altitude/logs/analyze_landing_log.py --input out/landing_altitude_20261026/snapshot_0253Z/recent_telemetry.jsonl --sha256 c46a8f81344b5af33060c216fd0446383a6b65c477680b73e0668d7df18b469c
```

实际exit0，输入前后SHA一致。`joined_rows.csv`保留缺失值与逐组来源资格；`log_summary.json`含全部飞行包络、严格连续段和状态转变；`parameter_events.json`保留27个参数响应。输入和输出字节绑定见本目录`ARTIFACT_HASHES.json`。
