Scherrerll/acg720-fpga-flight-controller/analysis/20261026_flight_followup/rotation/FINDINGS.md

# 旋转相关假速度：第二轮只读核查

本轮确认了新的观测格点和时序约束，仍未唯一识别旋转补偿遗漏、真实平移或杠杆臂各自的贡献。没有找到这条已检查链路中的确定计算错误，不能因此宣称算法无问题，也不能把下面的描述性回归系数拿去上板。未修改任何固件、约束或旧报告，未访问HTTP、串口或硬件。

当前B0B3的MTF解析、几何转换和光流融合三个文件，与冻结P005/I0逐字节相同，哈希见`rotation_summary.json/source_bindings`。因此接口和算法结构差异仍适用；这里的飞行动态证据来自历史V15/P005，**没有把新B0B3地面参数验证当作B0B3实飞数据**。

## 1. 输入、复算与新证据

在仓库根运行，仅需Python标准库：

```powershell
python -X utf8 -B analysis/20261026_flight_followup/rotation/analyze_rotation.py
```

脚本只写自身目录。7个原始JSONL均逐项核对交接包`flight_dataset_index.json`中的SHA256；原件不复制、不改写。直接解码27字节Micolink包并验和，不导入旧分析器或产品模块。`input_manifest.json`绑定原始输入、操作者限制与P2源码；`ARTIFACT_HASHES.json`绑定本轮产物。完整派生行在`paired_native_rotation.csv`，统计和描述性回归在`rotation_summary.json`。

| 历史源 | 不同下传原生帧 | 原生时间相邻快照中位间隔 | 采样器边界 |
|---|---:|---:|---|
| V15 dynamic | 2662 | 200ms | epoch9–12；本轮动态窗取epoch12 |
| V15 unarmed_rotation | 740 | 200ms | 网页轮询，部分间隔400/600ms |
| V15 flow_motion | 459 | 200ms | 原记录没有A583配对，不能补造gyro |
| P005 latest | 1524 | 200ms | epoch20–22 |
| P005 plain / texture | 269 / 141 | 200 / 200ms | 同镜像未解锁环境对照 |
| P005 unarmed_actions | 323 | 200ms | 仅地面动作，非受控光心旋转 |

合计6118个**被下传抽到的不同原生帧**。所有所查原始包的长度/头/校验、字段解码、`raw_flow × distance`整数乘法和已有A583的距离/速度/计数对应均无不一致。这里没有执行完整C或RTL仿真，也不是完整100Hz采集。

### 新发现A：所见flow字存在粗格点，不能用零值证明去旋转

6118个抽中包的`flow_x/flow_y`都为20的整数倍；大部分分组的非零值最大公约数和最小观测间隔为20。`p005_actions/flow_y`只见一个非零40，不能单独从该分组推断20步长。这个格点**已存在于Micolink原始线字节中**，不是FPGA缩放、融合或网页舍入造成。

按官方归一化单位，`velocity_mmps = flow × distance_mm / 100`：

| 距离 | 20个raw计数对应的可见速度阶梯 |
|---:|---:|
| 0.25m | 50mm/s |
| 0.50m | 100mm/s |
| 1.00m | 200mm/s |

这是抽样数据的可见格点，**不是厂家声明的固定分辨率**，也不能排除未下传的100Hz帧出现其他格点或抽样相位混叠。以小角度图像运动解释，`v/h=0.2s⁻¹`相当于约11.46°/s的角流尺度；这不是已校准的MTF角速度常数，不能据此设死区或补偿。

V15 pitch动态窗39点中，前向raw为0有18点；手持roll主轴窗口20点中，右向raw为0有15点。因此“gyro在动但flow为0”本身不能证明内部已补偿。反过来，非零flow也不能排除真实平移、表面误跟踪、滤波与部分补偿。

融合的连续小数不增加原始观测分辨率。数例：连续有效、无加速度、初始`v=i=0`的一次后续10ms融合校正，若观测阶梯为200mm/s，则`i+=200×.01=2mm/s²`、`v+=(2×200+2)×.01=4.02mm/s`；50/100mm/s阶梯同理产生1.005/2.01mm/s。平滑融合输出不能反证上游格点。

### 新发现B：时间字段能验证接收配对，不能恢复曝光gyro

下传相邻帧的MTF `sample_count`中位跳20，模块时间中位跳200ms，尽管每帧内最近一次原生`dt_ms`为10ms。dynamic各epoch按原生时间跨度估算仅保留约3.63–5.00%，手持rotation约4.19%；这是下传/轮询覆盖率，不是模块丢包率。所查`module_missing/restarts/UART/checksum`计数均为0。

5635个有同序列接收配对的快照满足：

`MTF.fpga_snapshot_ms − A583.received_ms − MTF.source_age_ms = 0ms`

A583的原生计数、距离和metric值也对应一致。因此没有发现简单的“把这一原生包配成另一包gyro/字节”的记录错误。但`source_age`衡量模块包到达FPGA以后的年龄，**不包含未知曝光、内部处理/滤波延迟**；这不能证明曝光对齐。

两个时间域不能直接相减当延迟：手持rotation的`module_ms − FPGA_received_ms`在6463–6706ms之间；描述性仿射关系约为`module_ms = 6802.64 + 0.99865876 × FPGA_received_ms`，残差RMSE约4.02ms。该常数含各自启动原点，斜率含相对时钟/时间戳实现差异，残差也不是曝光延迟精度。27字节115200/8N1仅串行传送就约2.344ms，模块在何时标记`time_ms`仍无契约。

源码[A583接收配对](../../../firmware/B0B3/source/acg720_ano_port.v:284)保存模块metric发布边沿的最新有效gyro，并明确注明不是曝光积分。MTF[metric发布](../../../firmware/B0B3/source/sensor/mtf01p_reader.v:203)和[诊断冻结](../../../firmware/B0B3/source/sensor/mtf01p_reader.v:219)保留tuple一致性；这解决的是接收事务一致性，而非成像相位。

## 2. 可证伪离线检验与识别失败的定量原因

以下窗口从原生MTF/A583同key直接取数，不使用旧报告的拟合常数。动态窗要求`xy_active`且原生距离>600mm；手持主轴窗要求该轴gyro绝对值>5°/s且大于另外两轴绝对值最大值的2倍。动态roll为69点；旧报告67点还要求同key A579，因此两者样本定义不同，不伪装同一统计结果。

正方向为前向`rawY`对应pitch gyro，右向`−rawX`对应`−roll gyro`。这只是现有映射下的符号约定，不是重新宣告物理动态映射已验收。

| 窗口/轴 | n | r(v,ω) | r(v,hω) | r(ω,hω) | 标准化双特征Gram条件数 |
|---|---:|---:|---:|---:|---:|
| V15 epoch12 seq223–308，前向 | 39 | .93656 | .92564 | .99677 | 619 |
| V15 epoch12 seq409–505，右向 | 69 | .91535 | .91479 | .98697 | 152 |
| 手持pitch主轴，前向 | 25 | .41896 | .40860 | .99832 | 1188 |
| 手持roll主轴，右向 | 20 | −.17508 | −.16368 | .99897 | 1938 |

**高度缩放没有把旋转光流与lever arm分开。** `v = k hω + Lω + b`的两个特征几乎共线，虽在数值上并非严格秩亏，分量却不稳定。pitch动态单独拟合`hω`系数为+1.437；允许同时拟合`Lω`后，`hω`系数变成−1.903、`L`约3583mm，而R²仅从.8568变到.8868。符号翻转和巨大补偿互抵说明它不是可识别的物理标定。手持高度仅211–269mm，没有固定光心，条件数更差；不能用这批数据确定内部漏补、部分补偿或外部补偿值。

**大整帧滞后不是这两段相关性的主要解释，但小延迟未知。** 用同epoch的实际seq相邻样本、无插值，对比flow(t)与gyro(t+lag)：pitch前向在约−200/0/+200ms时r=.5591/.9256/.6274；roll右向为.5882/.9148/.6292。零整帧偏移较强，不能因此声称0ms曝光延迟。10–40ms级相位、滤波与内部曝光窗在200ms快照间隔下不可识别；缺帧和周期运动还会产生滞后混叠。

**小lever arm单独解释峰值需要不现实的大半径，但真实平移仍混杂。** seq499原生右向−3029.6mm/s，rollrate64.9593°/s；若全部归为刚性绕固定中心旋转，表观半径`|v/ω|≈2672mm`。假设100mm或300mm偏置，只产生约113或340mm/s，远小于该峰值。不过飞机当时在真实飞行，平移未测；手持试验也明确没有固定旋转中心，不能把这一条件数例当作排除lever arm或证明漏补。

**姿态投影不能从零制造该原生flow。** 当前几何用斜距×cos(roll)×cos(pitch)计算垂直高度，但原生metric先按原始distance缩放速度，之后仅做yaw旋转。两轴均15°时cos乘积约.933，提示可能的几何尺度差异，但不等于一个完整的倾斜地面光流模型，更不能把它当已修复项。单纯乘法投影不能从真实raw0制造非零raw；内部视觉算法、平面与转动成像仍需独立辨识。

**恢复段的零不是观测真的归零。** epoch12 seq293原生距离1038mm、rawX/Y=−100/60，仍对应前向622.8/右向1038mm/s；但pitch16.15°时几何/融合资格撤销，导航body与fused均为0。seq294恢复时rawY=−200、distance1005，前向−2010mm/s。seq500同理rawX40、distance1012仍对应右向−404.8mm/s，导航输出却为0；seq501恢复为rawX−340、distance873，即右向2968.2mm/s。此切换保留在`recovery_rows`，不能拿门控后的零段来证明转动污染消失或模型拟合良好。

## 3. P2、当前RTL与确定计算问题核查

| 证据 | 本轮可得结论 |
|---|---|
| P2 `Application/Ano_OF_DecoFusion.c:119–125,239–245` | UP_OF路径先5Hz低通gyro，再显式加减旋转项；`65–68`常数带光学标定含义。不是MTF通用常数。 |
| 当前[MTF字段与metric](../../../firmware/B0B3/source/sensor/mtf01p_reader.v:41)及[有符号乘法](../../../firmware/B0B3/source/sensor/mtf01p_reader.v:119) | 20B payload偏移、little-endian signed16、距离mm及除100单位对应官方契约。6118抽中帧未见字段/乘法不一致。合法12000mm×signed16的绝对乘积最大393216000，容纳于signed31，不存在该乘法的位宽溢出反例。 |
| 当前[几何输入范围](../../../firmware/B0B3/source/sensor/mtf_shared_geometry.v:47)与[速度/yaw路径](../../../firmware/B0B3/source/sensor/mtf_shared_geometry.v:188) | ±1000000的metric×100输入先检查再存signed21，范围容纳；Q16缩放后以±10000mm/s界限检查。轴交换/负号和mm↔Q16未发现漏乘10/100。yaw旋转是坐标变换，不是去旋转。 |
| 当前[rotation_compensated固定0](../../../firmware/B0B3/source/sensor/mtf_shared_geometry.v:66)及端口 | 当前FPGA该flow链没有角速度输入或显式减角速度项，因此没有发现“FPGA又做了一遍显式gyro补偿”的双补偿实现。不能由此推断模块内部一定未补或一定已补。 |
| 当前[融合](../../../firmware/B0B3/source/position/mtf_shared_flow_fusion.v:121) | 累积使用实际dt，10ms校正与P2 20ms并非逐步相等；融合会平滑和掩盖原生格点。没有通过这些稀疏字段重放内部全部1kHz加速度预测。 |

没有发现确定的字节序、单位或该乘法宽度错误。此结论不覆盖所有控制/估计算术、全部状态组合或硬件动态；不是“已排除代码问题”。

## 4. 厂家契约和实际固件身份的边界

2026-10-26复核的第一手资料，链接和访问限制另存`official_sources.json`：

- [Micolink官方解析说明](https://micoair.com/docs/decoding-micolink-messages-from-mtf-01/)定义`time_ms`为系统时间、flow为cm/s@1m及速度换算。0x51载荷包含距离、flow、质量/状态和reserved，没有固件版本、gyro、补偿标志、曝光起止或滤波延迟字段。
- [MTF-01P官方手册](https://micoair.cn/zh/docs/sensors/sensors/mtf-01p-sensors)给出100Hz、115200和多协议支持。不能从“支持PX4/ArduPilot”倒推当前Micolink字段的补偿方式，更不能把抽到的20格点当官方分辨率。
- [微空助手官方说明](https://micoair.cn/zh/docs/software-tutorial/micoassistant-guide)说明可识别设备并读取配置，Auto协议从某固件版本起提供；没有当前设备的版本/配置回执就不能假定它运行该版本。

所查6118包的device_id均15、system_id均0、reserved1均255、reserved2均65535；这些不是已定义的固件版本或补偿状态。当前材料不能证明实际MTF固件版本、光学比例、内部IMU来源或补偿开关。需要对应版本的厂家明确契约，以及受控运动记录，两者相互约束；仅凭协议名、质量非零、gyro相关或flow为零都不够。

## 5. 原因排序与最小受控地面采集

1. **旋转相关分量进入速度观测仍是强候选，尚非唯一根因。** 飞行两轴关联强，源码存在P2显式处理而本链没有的结构差异；真实平移、模块内部语义和相位尚未分离。
2. **表面/跟踪、可见格点与未知模块处理同样必须保留。** 同P005静态plain/texture有效样本的原生前/右速度RMS约128/159与6.39/5.45mm/s。环境对照未随机化、无外部真值，但不能把所有波动都归给gyro，或把融合的小数当原生高精度。
3. **接收配对≠曝光配对是确定的数据限制。** 同key tuple对应没错，曝光关系仍缺；200ms滞后检验不能解决10ms级问题。
4. **lever arm、真实平移及倾斜投影仍是混杂。** 当前窗口近共线，手持中心未固定；不能唯一分解，也不能据此宣布需要双补或已经双补。

最小下一步是拆桨停机的受控地面采集，**无需带桨飞行**，也不是本报告已执行的动作：

- 先保存实际模块型号、固件版本、协议/方向/相关配置的只读回执，并向厂家确认该版本Micolink是否补偿、gyro来源、`time_ms`对应曝光何时和滤波延迟。无需为了调查先升级/重写模块。
- 在固定纹理、光照和距离0.25/0.5/1m下，用可量测旋转轴保持光心固定；标明光心到IMU/转轴的三维偏置及误差。单独roll、pitch、yaw，正反方向、静止间隔和多个速率，顺序交叉，重复少量周期。幅度保持在现有资格范围内，不删除15°保护。
- 保存完整原生100Hz包、校验和/seq/module time/质量状态，以及同一时钟下UART末字节、gyro更新、姿态和range。采用不争用现有接收串口的被动采样，或另行授权专用只读诊断采集；当前5Hz快照不能代替这些数据。曝光相位仍须厂家契约或受控动态标识确认。
- 在固定光心与已知偏置下：随高度成比例的残余角流支持视觉旋转残留；与高度无关且符合已测`ω×r`的项支持lever arm；在量化/重复性界限内接近零才能支持补偿有效。将观察和判断阈值写在采集前，不能用本轮描述性系数预先抵消信号后再宣布通过。

若不能获得上述受控条件，应保留“旋转相关强候选、内部补偿未知、无安全标定系数”的结论，停止继续对稀疏飞行曲线作无界拟合。P/I接口与实机参数回读通过不改变该边界。
