Scherrerll/acg720-fpga-flight-controller/firmware/B0B3/analysis/FINDINGS.md

# 飞行记录与匿名飞控拓空者 P2 对照调查

本支线按用户要求与在线 P/I 实施并行，只读核查交接包的日志、原 V15、当前 P005/I0 和用户已确认的 P2 源码。只在本目录写报告、复算脚本和派生数据，没有修改产品 RTL、原始记录或参考代码，没有访问串口、接收器、下载器或飞机。

**结论：P/I 不是目前唯一可成立的原因。当前速度外环确实接管并输出了实际采用的目标；输入环境对光流观测有直接影响；原 V15 动态振荡与未经确认的旋转速度分量强相关；当前两次 XY 退出直接伴随高度失效降级锁存。P005/I0 的回中刹停和持续悬停仍未验收。新增参数接口能使调参可控、可复查，不能据此认定这些飞行问题已经解决。**

## 1. 证据身份与复算方法

交接包根目录为 `C:/Users/ScherrerL/Desktop/apple/handoff_xy_pi_runtime_20261026`。下文约定：

- `P2/` = `workspace_snapshot/reference_ano/quadrotor_tm_v1_20261012/Quadrotor_TM_V1/`。
- `RTL/` = `workspace_snapshot/timing_closure_20261025/v15_xy_p005_i0_review_20261025/source/`，为本次实施前冻结的当前源码，行号始终指该副本，避免与主线随后改动混淆。
- `V15/` = `workspace_snapshot/github_publish/acg720-fpga-flight-controller/firmware/B0B2/`。
- `候选硬件/` = `workspace_snapshot/timing_closure_20261025/v15_xy_p005_i0_review_20261025/hardware/`。

参考身份来自用户确认，本调查没有重新调查 P2 来源或版本。`audit_sources.py` 对 `ano_reference_index.json` 的 376 个文件逐个重算 SHA256，全部相符。原 V15 与 P005/I0 冻结目录的 54 个共同源码/工程文件中 53 个逐字节相同，仅 `position/mtf_xyz_hold_control.v` 的四行 P/I 算术变化。差异见 `original_to_p005i0.diff`；该控制文件原 V15 SHA256 为 `41ae4ee0c4129afcc18758d93d960c415f860ca5e2a65dfb8d199129133adff2`，当前为 `78952264bf5a507f2f9e080e53fe0dd41b940cf13c699a134fb5aa12be539258`。这支持 V15→当前候选软件层面的 P/I 对照，不能证明两次飞行环境和初态相同。

`analyze_evidence.py` 重新逐行读取有限日志窗口，以 `(epoch, sequence)` 联结 A579/A57A/A580/A581/A582/A583/A585，不跨 epoch，不填补缺帧，不拿相邻帧补齐。记录轮询快照的地面试验只保留相同 sequence 的子包，重复轮询不增加样本数；这类文件没有原接收器全局 epoch，CSV 的 epoch=0 仅表示该文件内的本地代际，不能与飞行总日志 epoch=0 混同。原始窗口中的协议字节和接收器归一化 `_protocol` 分开保存；B0B2 的 pose-age 字段保留 null。

最新窗口 1505 个主帧全部有同 key 导航包；原 V15 动态窗口 2616 个主帧有 2611 个同 key 导航包，5 个缺配保留。8 个数据集共独立检查 5882 个可用原生 Micolink 帧，长度、逐字节加和校验、大小端/符号字段和 `flow × distance` 重算均无不符。其中最新窗口 1524 帧、V15 动态窗口 2662 帧。这仅验证被遥测快照抽到的帧，不意味着已经检查模块的每个 100 Hz 样本。

可复算入口（普通 Python，无硬件依赖）：

```powershell
python -X utf8 analysis_flights/analyze_evidence.py
python -X utf8 analysis_flights/audit_sources.py
```

结果见 `evidence_summary.json`、`source_audit.json`、`equation_audit.json` 和各 `*_paired.csv`。CSV 的 `utc` 是原主机接收时刻；下列面向操作者的日期/时间已换算北京时间 UTC+8，均不表示相机曝光时刻。

## 2. 固件、保护、环境与验收范围矩阵

| 记录 | 固件/实际参数依据 | 保护与可用字段 | 时间及定位 | 操作/环境及证据边界 |
|---|---|---|---|---|
| 早期两次失败 | B0B0；旧冻结源码审阅记录 P=.15、I=.10。本包没有该旧位流/完整源码，位流哈希不能重新独立绑定 | 旧 temporal 变化拒收、旧 pose-age 策略；A585 新诊断不可用 | 10月25日02:23；epoch3，第一次 seq268–313，XY291–312；第二次425–467，XY454–465 | 原始有限窗口重新核查。视频无可靠拍摄时钟。不可把旧保护故障直接套到 B0B2 |
| 原 V15 中杆悬停 | B0B2，P=.15/I=.10；位流 `3b9920ac…b4306` | B0B2 已移除按合法 IMU 数值变化整包拒收；pose-age 不再作为资格字段 | 操作者10月25日21:44附近提交结果；本包视频没有精确遥测同步凭据，**不指认某个 epoch/seq 为视频对应段** | 操作者报告稳定，视频记录保留；无量化位置误差、无与 RC/模式同步证明，限中杆悬停反馈 |
| 原 V15 打杆摆动 | 同上原位流与 .15/.10 | B0B2；XY倾角±15°、目标角±25°；Z和XY可独立撤销 | epoch12：seq223–308、409–505；10月25日21:47:39.764–21:47:56.888、21:48:17.015–21:48:36.162 | 前后与左右打杆，回中仍摆动；179个 taking_off 主/导航配对帧。视频无逐帧同步 |
| 原 V15 不解锁旋转 | 同上 | 命令停机；A583为**接收时刻**gyro配对，不是曝光同步 | `v15_unarmed_rotation_20261025T141628_867271Z`；文件内本地seq403起 | 用户后补“没放稳”；光心平移、旋转轴/杠杆臂未知。不能估计去旋转系数或把前段当静态噪声标定 |
| 原 V15 flow_motion | 同上 | 命令停机，未做完预定动作 | `v15_flow_motion_20261025T125704_865917Z` | 动作采集取消，轴/比例/旋转资格未通过。最初明确水平静置片段可作独立零点参考，不能扩展成运动标定 |
| 当前最新两次 | B0B2 P=.05/I=0，位流 `a876c8ed…db7c`；Flash安装/校验/冷启动记录在候选目录 | 与原V15源码除P/I外相同；无旧temporal变化拒收，无pose-age资格；保留±15°/±25°和高度降级 | 10月26日00:05:32.431–00:05:36.294，epoch22 seq211–230；00:05:59.987–00:06:05.061，349–374 | 用户“像自稳”。XY实际接通46帧，两次随后高度降级。第二次仍在推横杆时已降油门，没有正常回中后持续飞行的独立窗口 |
| 当前表面对照 | 同一 `a876c8ed…db7c`，.05/0 | 未解锁，四路停机；同样MTF链 | 10月25日23:37与23:43两个static目录；文件内本地seq，不强行映射总日志epoch | 纯色桌面→打印/哑光纹理面；观测波动明显变小，未作随机交叉试验，照明/距离等未完全控制 |

原 V15 完整哈希：`3b9920acc1abecf6e0ef50465f5bc408d9b74af2ac6d046cb151137a375b4306`。当前完整哈希：`a876c8ed073588e17b6289f8aac7573334a5d5e9c992d394d0d14f61ed17db7c`。固件通用 build_id B0B2 不足以区分这两个参数镜像，实际参数身份必须依赖位流、安装记录与源码绑定。

## 3. 原始证据重新核查的结果

### 3.1 当前“像自稳”不是“外环从未接通”

epoch22 seq211–230、349–374 的 46 个可见活动帧同时具备 `xy_shadow_active`、`vertical_active`、`xyz_active`，taking_off=true，XY/Z原因均0。46/46帧的导航 `shadow_roll/pitch_cdeg` 与主帧实际选择的 `target_roll/pitch_cdeg` 相同；没有发现在线路上仅计算 shadow 而未选择目标的问题。代码真实路径是 `acg720_ano_port.v:293` → `mtf_xyz_navigation_control.v:278` → **`position/mtf_xyz_hold_control.v`** → `flight_core`。目录中另有 `ano_hold_control`、`mtf_shared_hold_control`，它们的中心杆进入门、位置外环不在这条真实控制路径上，不能据此解释本机。

例：seq225，杆 CH1=1500/CH2=1501，实际目标 roll=+2.25°、pitch=+1.31°；seq371，CH1=1673，目标+4.03°/+1.28°，实际姿态+4.34°/+0.66°。这证明速度外环曾产生有意义的目标，同时不能用单点证明内环已完整跟踪。

当前活动帧反馈 roll范围−1.75°…+5.20°，pitch−0.61°…+2.51°；目标roll−0.06°…+4.03°，pitch−0.05°…+1.83°，没有达到本地±15°观测门槛，也没有达到±25°目标限幅。因此**这46帧内的可见退出不能用“目标撞25°/姿态越15°”解释**。更低的 .05 与移除I使同速误差反馈更弱，这与小角目标相容，但不证明其为全部漂移原因。

第一段 CH1始终1500…1541，仍在±50µs死区内，主要是短时起飞/降落；第二段在seq367后CH1离开死区，seq374仍1608且CH3=1000；seq377回中时已经降级。不存在足够的“完成打杆→正常回中→保持XY飞行”的窗口来验收刹停。

### 3.2 当前两次退出确实有高度降级，但首次失效原因仍未知

| epoch22 | 最后可见XY/Z活动帧 | 首个可见降级帧 | 降级帧内容 |
|---|---|---|---|
| 第一次 | seq230，00:05:36.294 | seq231，00:05:36.462 | CH3=1089；fallback=true；XY/Z active=false；原因均2；此帧native_height_ready、height_fusion_ready、velocity_fusion_ready已为true |
| 第二次 | seq374，00:06:05.061 | seq376，00:06:05.412 | seq375主帧缺失；CH3=1002；fallback=true；原因均2；高度与速度ready同样已恢复 |

代码 `height_loss_fallback.v:24,71–76` 在已 armed、taking_off、有最后有效油门且 `!height_available` 时锁存降级，直到停机/健康撤销才清；`flight_core.v:371` 在锁存后撤销 `navigation_enabled`；`mtf_xyz_navigation_control.v:311,322` 把 enabled撤销显示为reason=2。因此reason=2是下游状态，不是最初高度失效的传感器原因。可见seq231和376已恢复ready，与一个在约0.2–0.35秒采样间隔内发生且被锁存的瞬态完全相容。

当前日志不能分辨首次撤销来自range状态、距离/计算边界、加速度资格、姿态有效性、源age、内部回调或epoch切换。不能因为降级时source_age=0/8ms且ToF状态=1，就倒推“此前从未瞬断”；也不能仅凭下降阶段将它判成故障或正常设计结果。此项是需要事件级诊断才能缩小的未决问题。

### 3.3 同镜像地面静态观测对表面敏感，是 P/I 以外的直接证据

重新按distinct sequence且同key导航/gyro统计：

| 设置 | 同key导航样本 | body前向速度绝对峰值 | body右向速度绝对峰值 | MTF质量范围 | roll/pitch标准差 |
|---|---:|---:|---:|---:|---:|
| 纯色桌面 | 265 | 607.60 mm/s | 984.40 mm/s | 59…82 | 0.0114° / 0.0152° |
| 打印纹理面 | 139 | 44.40 mm/s | 45.60 mm/s | 107…117 | 0.0142° / 0.0116° |

静态对照的gyro绝对峰值都小于0.25°/s，计数拒收、控制故障、模块串口/校验错误均0。这些证据支持“模块观测受表面条件影响”，并排除“全部改善来自P/I变化”：此两段根本是同一镜像、未解锁。操作者静置陈述与小姿态变化支持静态条件，但没有外部位置真值；试验长度不同、次序固定、照明/表面反射与距离仍可能混杂，不能据此定量建立通用噪声模型或直接指定一个新的质量阈值。

### 3.4 原 V15 动态记录仍支持旋转污染候选，未得到唯一根因

两段共179个taking_off配对帧，CH7始终2000；原生Micolink错误计数、模块missing/restart、IMU rejected_count、控制故障都为0；source_age范围1…11ms。中杆后目标自身继续往复，表明外环在提供摆动目标，不能把问题全归为遥控杆仍在动。

- epoch12 seq285：CH2已1501，pitch目标+10.84°，接收配对pitchrate约+53.60°/s，距离1068mm，rawY=220，前向观测 `220×1068/100=2349.6mm/s`；融合vx约697.69mm/s。后续seq289目标−11.87°，反馈继续往复。
- seq499：CH1=1500，rollrate+64.96°/s，rawX=280、距离1082mm，右向观测 `−280×1082/100=−3029.6mm/s`。seq500 roll=+15.13°，XY reason4/ready撤销，Z仍active，seq501恢复。
- seq293 pitch=+16.15°，XY reason4撤销、融合速度输出为0，Z仍active；seq294恢复。这些0是资格撤销后的输出，不是飞机真正静止。
- 将两段分别限定为epoch12 seq223–308、409–505、XY active且原生距离>600mm，重新计算 **观测速度 vs 距离×相应接收gyro弧度率**，前向n=39，r=+0.9256；右向n=67，r=−0.9153（当前项目Y向右，负号有物理坐标含义）。筛选条件、具体seq清单在 `evidence_summary.json`，不复用旧报告的预选样本或拟合系数。

P2参考含显式旋转解耦，本机RTL没有同类输入；这使“转动相关伪速度经融合→P/I→角目标形成往复反馈”具有代码机制和实测关联支持。但飞行中同时真实平移，A583只在UART接收时刻配最新gyro，5Hz无法辨别10ms曝光、滤波和传输相位，手持旋转对照又未固定光心。因此不能说已证明模块输出完全未去旋转、不能算出安全可用的补偿系数，也不能排除比例、延迟、I积累及内环阻尼共同参与。

原 V15 起振阶段目标均未到12°，因此把25°目标上限单独降到12°不能解释/消除这些阶段的起振机制。±15°观测资格与±25°目标边界的不协调仍是已观察到的次生切换机制；当前P005两段没触发可见倾角边界，但此结构仍保留。

### 3.5 旧 B0B0 的拒收与本次不同

旧第一次窗口rejected_count从1增至532；第二次从532增至1069，seq462开始可见imu_reason=128，seq465拒收964，seq4661069。第二次seq465目标+18.37°/−17.14°，下一帧实际roll+19.32°、pitch−15.84°且XY撤销。seq467主帧缺导航，仍保留原始主帧供核查，不能因缺配将其补为有效控制。

当前及原 V15 B0B2 的 `imu_temporal_check_pipelined.v:1–9,64–77` 明确接受合法变化，保留transport/base_ok与overrun检查；本次两个新窗口拒收累计均为0。**可以排除在可见计数覆盖内重演旧B0B0“按合法变化反复整包拒收”的机制**，不能据此宣称IMU、姿态估计、振动影响或所有短时回调问题都已排除。pose_age=null是协议声明不可用，不是0ms；最大已完成姿态发布间隔1.1226ms也不能代替当前尚未完成间隔的实时年龄。

## 4. ANO/P2 参考对照：C → 实际 RTL → 飞行证据

表中“等价”限定相同单位/输入/初态和该层公式，包含定点容差，不代表真实传感器和飞机动态等价。“有意适配”说明可定位的接口/保护差异，不自动代表物理资格已验收。

| P2 C文件/行号与公式 | 当前冻结RTL文件/行号 | 类型与具体判断 | 对应飞行证据/最小验证 |
|---|---|---|---|
| `Application/Ano_Parameter.c:59–61` .15/.10/0；`SRC/fc_specific/Ano_LocCtrl.c:52–66` X/Y共用参数，P支路ki=0、I支路kp=0，FF=.02 | `position/mtf_xyz_hold_control.v:340–345` 当前P=.05且I硬清零；FF保持1/5；原V15同位置P15/10，累积I | **有意参数变化**。mm/s→cm/s与deg→cdeg合计系数10，因此原.15→1.5、当前.05→.5，FF.02→.2；两轴同值 | 最新46帧接管；运行时参数测试必须分别验证P、I进入实际算术且读回的为生效值 |
| `SRC/fc_specific/Ano_FlightCtrl.c:293–316` 50µs死区、.0022、3HzLPF、二维长度限制；速度限`clip(1.5*height_cm,50,150)` | `position/ano_xy_stick.v:53–81`；`mtf_xyz_hold_control.v:197,333–335` 使用融合高度mm生成500…1500mm/s限 | **等价+有意轴适配**。当前按已验收RC正负，X=CH2，Y=CH1向右，原Y向左；小数滤波有残差保存 | 当前第一段杆始终死区；第二段367以后横杆。无需重跑完整遥控映射；只需默认输入/滤波回归 |
| `SRC/fc_general/Ano_Imu.c:28–38` `w2h`/`h2w`；`Ano_LocCtrl.c:223–227` OFDF的航向速度反馈 | `sensor/mtf_shared_geometry.v:189–235` rawY→前，−rawX→右，再yaw到world；`mtf_xyz_hold_control.v:359–371`旋回航向轴 | **有意坐标适配，结构一致**。回转公式无可见符号/单位漏项；yaw坐标变换不是去旋转 | seq371 raw(280,140),h350mm→body(490,−980)mm/s，与Q16完全对应。物理动态轴/比例仍不能由这项算术证明 |
| `Ano_LocCtrl.c:210–224` 5Hz `h_acc` LPF，加速度0.03s提前只入P；`SRC/fc_general/Ano_Filter.h:143` α=`5*6.28*dt/(1+5*6.28*dt)` | `mtf_xyz_hold_control.v:335–340,368–371` α=`314*dt_us/(10000000+314*dt_us)`，先旋转后LPF，P误差`fix−.03*a_lpf` | **等价**（定点及yaw近似除外）。LPF状态保持在当前航向身体轴，未发现多乘10/100或lead误入I | 公式数例和2000步算术审计见下节；真实飞行缺内部a_lpf/滤波杆量，不能由5Hz字段精确反算每次P贡献 |
| `Ano_LocCtrl.c:243–253` I用`expect−fb_speed_fix`，`Ano_Pid.c:43–55` I=clip(I+ki*clip(error,±50cm/s)*dt,±10deg*taking_off) | 原V15 `mtf_xyz_hold_control.v:340–344`；当前同位置硬清0。模式事务保存/回滚在315–327 | **原V15公式等价；当前有意取消I**。恢复可调I应使用fixx/fixy，不使用含lead的ex/ey；单位系数为10I。未起飞有效OF回调清I，普通ATT模式冻结完整I/LPF | 旧V15回中摆动不等于I唯一根因；当前I0排除当前“非零I风up”，不排除观测偏差/P/FF/滤波。最小验证为原积分路径、限幅、取消回滚和切模回归 |
| `Ano_LocCtrl.c:387–399` 非OF输出由杆量转角；在该分支未调用OF PID，因此OF I/LPF未每周期清零 | `mtf_xyz_hold_control.v:96,307,315–327` XY取消清命令/回滚半事务而保留完整状态；全局取消279–286清全部；`flight_core`选择自稳目标 | **有意并发实现以保留C回调原子性**。模式关闭与高度/arm全局撤销语义不同 | 原V15越15°会让融合清状态而完整控制I/LPF可保留，恢复瞬态可参与问题；不应为调参随意把已有状态全部清掉或改变模式策略 |
| `Application/Ano_OF_DecoFusion.c:149–188` UP_OF积分流、时间与高度；`Driver/SenserDriver/Ano_OF.c:263–270` 另一种ANO模块已融合速度与FIX分量 | `sensor/mtf01p_reader.v:27–98,113–154` Micolink 20B载荷；`mtf_shared_geometry.v:203–207` raw*distance/100 | **有意协议替换**。Micolink flow为cm/s@1m，距离mm，因此除100得到mm/s；不可把UP_OF像素系数直接搬来 | 独立5882帧解码无错；这排除所查字段、字节序和该单位乘法错误，不能排除模块内部物理尺度/安装方向未校准 |
| `Ano_OF_DecoFusion.c:119–125,239–245` 5Hz gyro LPF后`+160*gyroY` / `−160*gyroX`，随后277–280按高度变速度并转world | 当前 `mtf_shared_geometry.v:5,66`明确不假设/不报告已去旋转，模块无gyro输入；`acg720_ano_port.v:275–287` A583仅收包配对 | **重要功能差异/疑似移植缺口，物理前提未知**。参考UP_OF分支有显式去旋转，而当前MTF链没有；Micolink契约没有证明内部已补偿，也不能据无gyro字段断定模块必未补偿 | 原V15epoch12相关性强，手持对照未约束平移。最小验证是固定光心/已知杠杆臂、曝光/传输对应窗口受控地面记录；不能直接拟合飞行相关系数上板 |
| `Ano_OF_DecoFusion.c:130–136` world加速度5Hz预测；312–317 `i+=e*dt`限±100cm/s²，`v+=(2e+i)*dt` | `position/mtf_shared_flow_fusion.v:121–140` mm/Q16；预测用实际accepted-IMU dt，积分限±1000mm/s² | **公式/单位等价；时间适配非逐步完全等价**。源C融合校正20ms，实际MTF校正10ms；外环仍20ms | 当前与V15 dt_ms始终10，源age小；原V15观测/融合相位与幅度差异存在，不能仅凭相关性判融合公式错误。最小离线高频同输入重放/时域辨识 |
| `Ano_Scheduler.c:71–96,99–124,132–160,171–185` IMU/杆1ms，率2ms，角6ms，高度11ms，OFDF/XY20ms | `ano_xy_stick.v:63–65`按accepted dt重放1ms杆任务；`flight_core.v:245–258,265–276,395–408`约6/2ms；`mtf_xyz_navigation_control.v:223–228,283`精确50MHz/20ms tick | **有意硬件/传感器调度适配**。角/率由新pose累计dt触发，非重复held样本；100Hz模块不等于5Hz遥测或50Hz外环 | B0B2原/新无拒收累计，但下行不能验收高频回路。不能用少量“目标≈角度”宣布内环充分跟踪 |
| `Ano_OF_DecoFusion.c:224–251,362–391` UP_OF有效0xf5、累积质量状态/1s在线；`Ano_FlightCtrl.c:396–467`质量>50持续500ms、距离<600cm持续1000ms使能OF | `mtf01p_reader.v:111–114,190–192` provisional status=1、quality!=0，200ms指标fresh；导航91–92、135–137用100ms控制fresh，几何dt1…50ms、高度10…5000mm | **有意接口/保护适配，MTF物理阈值资格未知**。不同设备的质量分数不能直接同比或照搬50/0xf5；当前质量非零仍可能有大假速度 | 纯色桌面quality59…82也能出现近1m/s观测。先固定表面/照明比较，不为对齐P2删除现有valid/age检查 |
| `Ano_AttCtrl.c:141–170` roll=−Y、pitch=−X，目标限±25° | `mtf_xyz_hold_control.v:347–353`适配Y-right后roll=+Y、pitch=−X，±2500cdeg；导航76固定flow±1500cdeg，Z±4500 | **坐标等价+有意新增门槛**；15°/25°边界有结构性不协调，P2相关片段没有同一15°门槛 | V15seq293、500实证XY掉/回，Z保留；当前46帧未越界。保留保护，不能为贴齐P2扩大危险输出范围 |
| `Ano_LocCtrl.c:207–253` OF分支是速度控制；GPS分支328–345才有显式位置目标 | 当前 `mtf_xyz_hold_control.v:328`捕获的position误差不被后续消费，333–335由杆生成速度，world_sx/sy=0 | **OF控制层一致**。当前I0没有显式位置反馈或速度积分；原I在固定yaw/连续估速未限幅时能产生隐含位移恢复，不能说原PI完全无位置作用 | “像自稳”不是新增位置环的授权；本次只做P/I，水平位置环不扩展 |
| `Ano_AltCtrl.c:106–115`高度目标、取整和自动起飞；`Ano_FlightCtrl`已有状态/有效性处理 | `mtf_xyz_hold_control.v:238–259,372–428`量化、自动起飞、高度11ms；`core/height_loss_fallback.v:24–30,67–76`本项目高度失效油门降级并锁存 | **有意安全适配，不能说与P2完全同策略**；P2以上函数无相同硬件降级锁存 | 当前seq231/376已确认降级；第一次失效原因未记录。最小新增诊断为首次height_available下降沿的原因/时间锁存，不需要重测全部遥控/姿态 |

补充参考本身的边界：UP_OF的`it_ms`为u16（`Ano_OF_DecoFusion.h:16`），C在原始时间整除后做`1000/it_ms`（`Ano_OF_DecoFusion.c:184,239`），该片段无显式零周期保护，非整除周期还有整数商误差。当前MTF1…50ms、callback范围和overrun保护有明确价值；参考代码用于审查，不能为逐字贴齐它而删除保护。当前实测dt=10ms，此原UP_OF边界并不能解释本机现象。

## 5. 可以复算的单位、算术与时序数例

`audit_sources.py` 的同输入审计是**依据所引C公式与冻结RTL状态方程的独立Python算术模型**，没有编译运行C或RTL，不能替代主线RTL仿真、硬件或闭环验证。它显式控制P/I、初态、dt与单位，不使用C默认参数掩盖当前.05/0差异。

1. **P/FF/I分支单位**：航向前向目标100mm/s、速度0、加速度滤波状态0、dt20ms。当前C参数P=.05/I=0，P=`.05×10cm/s=.5deg`，FF=`.02×10=.2deg`，总70cdeg；RTL `100/2+100/5=70`，pitch=−70cdeg。原V15/P2 .15/.10的首步为150+20+2=172cdeg，I增加2cdeg。不能用同一个raw系数直接乘mm/s后输出deg。
2. **加速度不进入I**：上一零加速度步后，a=1000mm/s²，α=.628/1.628=.385749；新a_lpf≈385.749，lead≈11.572mm/s。当前输出u≈64.213759cdeg，RTL Q16方程≈64.213867，整数输出64。原V15在已有I=2cdeg的第二步继续增加到4，u≈156.641278cdeg；I的增量仍2，未被lead减小。
3. **限幅与位置语义**：原I=.10，速度误差1000mm/s先限500，每20ms增加10cdeg，至±1000cdeg封顶；I0恒0。固定yaw、中杆、估速准确连续且未限幅时，`I_cdeg(t)=I(t0)−10*I_ANO*Δp_body_mm`，故原.10对应每100mm位移约1°恢复项；变yaw、失效中断/清零、饱和后不等于固定世界位置锁定。
4. **Micolink真实帧**：当前epoch22 seq371，distance350mm，rawX280/rawY140，按现安装映射body前向=140×350/100=490mm/s，右向=−280×350/100=−980mm/s。Q16为32112640/−64225280，原始记录完全一致；seq225同理raw100/60、370mm→222/−370mm/s。
5. **P2去旋转示意不可直接移植**：UP_OF原常数160pixel/deg、.00012cm/pixel，在100cm高度、10°/s时，仅gyro项就相当于19.2cm/s速度校正。它说明参考明确处理转动，**不是MTF-01P应使用的补偿系数**。MTF需自己的光学/时序与内部语义证明。
6. **融合公式相同不等于离散时序相同**：初v=i=0、观察100mm/s、无加速度。P2一次20ms校正，i=2mm/s²，v=(200+2)*.02=4.04mm/s；FPGA两次10ms，先v=2.01、i=1，再e=97.99、i=1.9799、v=3.989599mm/s。都是按dt缩放的FUS_KP2/KI1，不能声称每步数值相等。现有下行不足以识别它对实际稳定裕度的贡献。

对固定yaw已进入控制的2000个确定种子随机输入（目标±1500mm/s、速度±3000mm/s、加速度±5000mm/s²，dt20ms），当前.05/0的方程最大差约0.000982cdeg，最终整数输出与浮点连续公式差<1.000cdeg；原.15/.10最大方程差约0.002964cdeg，整数差约1.0012cdeg，来自长期定点舍入累计和最终向零取整。这里的局部容差分别取1.01cdeg；不覆盖正弦近似、动态yaw、杆滤波重放、融合、失效/并发事务或实际新runtime实现。新接口默认行为应由主线的真实RTL对比另行证明。

## 6. 候选原因排序、支持与反证

| 候选 | 已有支持 | 反证/混杂与不能声称的结论 | 对当前任务影响 |
|---|---|---|---|
| 表面/图像质量导致速度观测偏差 | 同镜像静态表面对照差异直接可见，串口乘法正确 | 未随机交叉控制环境；没有外部速度真值；不能定一个万能质量门限 | 调参时保持表面、照明、距离一致；只改P/I无法“修复”原生观测 |
| 转动相关速度分量进入融合和外环 | P2有去旋转，当前RTL无；V15两段观测与高度×gyro强关联；回中后目标往复 | 真平移、曝光/收包时差、模块内部实现未知；手持对照未稳固，无法单独识别补偿常数 | 保留为强候选，不在本次调参任务加未经验证的去旋转 |
| 高度短暂不ready触发锁存降级，令末段像自稳 | 当前两段首次可见退出都伴fallback，源码存在确定因果通路 | 首次高度撤销原因未知；采样时ready已恢复；阶段与降油门同时发生 | 必须把fallback纳入调参观察，不将reason2写成传感器已查明故障 |
| P/I及外内环动态匹配 | V15回中摆动；当前P降到1/3且I0，角目标较小；I可能积观测偏差 | 观测/环境有变化；5Hz不能辨识闭环；移除I未形成同条件对照验收 | 实现可控参数有价值，但不给无辨识依据的唯一增益建议 |
| ±15°观测撤销/恢复与±25°目标边界 | V15seq293/500已观察，融合重置与I/LPF保留机制清楚 | 当前活动帧未触发可见倾角边界；动态起振早于门槛 | 当前任务保留保护，不能宣称调参接口解决边界问题 |
| 姿态/率环滞后、执行余量、低侧/高侧混控限制 | V15摆幅增长时实际角度与目标有相位差；部分PWM达到2000；当前seq374同时2000与1200 | 5Hz无法高频验收；饱和可能是后果且含低侧限幅；不能全部叫“顶到2000” | 只做新参数相关回归，不重新整套映射；后续如需辨识应采高频目标/反馈/余量 |
| 当前仍是旧temporal整包拒收 | 旧B0B0确有计数/原因支持 | B0B2对应策略已移除，原V15及当前窗口拒收0 | 在所查范围可排除旧故障复现，仍不排除其他IMU/估计问题 |
| 目标仅shadow、单位乘错10/100、完全没接管 | 可通过路径和数值检查直接检验 | 当前46/46目标一致，5882原始帧单位/校验复算无错 | 在所查范围可排除此类机制；不扩展成所有传感器动态资格已通过 |

## 7. 对主线接口与最小后续验证的具体建议

**本次必须保证的参数语义**：公共P/I为ANO用户单位，停机才能更新；两轴同次原子提交；ACK与查询回读实际生效值、代际/事务号，拒绝帧不能产生半套参数；默认.05/0真实算术与冻结候选相符；非零I应恢复原fix分支、dt、±50cm/s积分误差限制、±10°状态限制及taking_off/切模/事务取消语义；上电持久性如仅RAM需明确。原B0B2 build_id不能唯一标识参数镜像，回读有效系数与构建哈希的绑定很必要。

**独立完成、不要求重新整套验收的最小验证**：

1. 离线用同一输入轨迹覆盖P=.05/I0默认、只改P、只改I、正负/限幅、两个轴、未起飞清I、ATT暂退后保留、全局撤销清I、半事务取消回滚，确认参数进入实际控制路径；不将方程审计冒充RTL执行。
2. 协议侧覆盖坏校验、越界、运行中拒绝、事务原子性、有效值查询/ACK、遥测与响应仲裁。电脑保持单一串口所有者，不为测接口停掉现有接收器。
3. 若要缩小最新高度退出原因，优先锁存首次 `height_available`下降沿的source/geometry/height-fusion/acc/pose/epoch资格、模块时间与本地时间、最后正常油门及fallback入口，而非增加泛化reason文本。该诊断可另行评估成本，当前记录不足时明确未知即可，不把扩展诊断当本次P/I实现的额外前置条件。
4. 若后续需要区分旋转与平移，做固定光心/明确杠杆臂、固定高度与纹理的受控地面记录，并保留模块timestamp、完整100Hz flow、对应gyro/姿态/加速度；先确认曝光和传输关系，再讨论补偿。现有手持/5Hz记录不足以拟合可上机的系数；不要求继续带桨试错。
5. 回中/持续悬停仍需未来独立、明确范围的物理验收；新位流布线/时序通过与参数回读通过仅分别证明数字实现和接口，不扩大为飞行效果通过。

本调查未发现可仅靠现有日志唯一定位并应在本次P/I接口任务顺手修掉的另一个RTL算术错误。已确认的功能差异、未完成的观测资格与降级首因必须保留在交付限制中。主线可以继续实现、构建和时序闭合，无需等待进一步飞行。

## 外部接口契约补充

2026年10月26日核查的[微空官方Micolink解析说明](https://micoair.com/docs/decoding-micolink-messages-from-mtf-01/)给出flow为cm/s@1m、速度为flow乘高度（m），支持本报告的单位换算；文档没有提供足以确认当前模块内部去旋转语义的说明。该页示例和本项目原生帧布局一致。[微空MTF-01P手册](https://micoair.cn/zh/docs/sensors/sensors/mtf-01p-sensors)给出模块100Hz数据率，与日志10ms一致。该补充只核查接口契约，不涉及P2版本来源。

报告产物及原始输入绑定见本目录 `ARTIFACT_HASHES.json`；该文件在报告完成后生成，以避免自引用哈希。
