Scherrerll/acg720-fpga-flight-controller/firmware/B0AE/provenance/说明.txt

B0AE 匿名控制逻辑移植候选

本轮以 reference_ano/quadrotor_tm_v1_20261012/Quadrotor_TM_V1 为依据。
详细对应关系、硬件适配差异见 CONTROL_CONTRACT.txt；原文件哈希见 baseline.json。

主要行为：
- SWA 仍用于解锁/停机；SWC 低/中为自稳，高为光流辅助，两个模式都使用高度环。
- 模式选择不要求油门先在中位，也不要求发生异常后重新拨档确认。
- 解锁后按原版流程依次让电机怠速准备，约1.2秒后可推杆起飞。
- 起飞触发在油门高于中位死区（CH3至少1555）时；不是要求推到最大。
- 起飞后，上推请求上升、中位请求悬停、下拉请求下降；SWA低档立即停机。
- 使用原版60cm/80cm/s起飞辅助与退出条件，以及85%总油门上限。
  这里高度参考是现有传感器/融合坐标，不代表机架底部离地60cm。
- 水平控制用原版光流速度PI，取消额外的位置P外环；没有油门匹配接管逻辑。
- 偏航估计器、Q12陀螺仪、Q24姿态数值格式与接线保持原版本。

验证：
qualification.json 绑定本工程源码、原版C函数参考程序、数值/状态对照、
共享运算时序、停机/切档、完整导航链、UART帧与地面站测试。
fixture/build_manifest.json 只有在完整布线、50MHz时序和17个IO检查通过后才会标为verified。
综合资源试验不等于最终布线通过。

使用边界：
这是控制流程移植候选，尚未完成新版本的拆桨实物验收与飞行验收。
原版气压计/GPS等硬件不存在，不能宣称具有原版相同的高度传感器降级能力。
MTF转动补偿资格也没有因本次控制逻辑修改而自动完成。
光流验证倾角边界与激光高度边界分开；前者退出不再直接撤掉高度参考。
测距本身失效的处理仍需要在实物验收中检查，不能据此直接宣布可起飞。

回退与板上状态：
本轮只做离线修改、仿真与编译，没有下载FPGA，没有写Flash，没有切换当前网页。
本轮最后一次有效读取为B0AD；若遥测中断，不能据此确认实时板上版本。
默认Flash沿用前次验证的B0AC，本轮没有改写。
旧工程 mtf01p_b0ad_local_cancel 保留完整回退文件。

本目录另做了有界目标高度存储优化：Q16小数位与signed64运算保持；新旧高度/XY/手动RTL轨迹必须逐字节一致，完整资格复查通过后才可编译。

本目录另做操作数/结果存储优化；全部32处calc有界证明、原始C对照和新旧RTL轨迹必须通过；算术仍为signed64，Q精度不变。

等价掩码换序候选：PWM转换分支前移，XY掩码移到现有交接/诊断寄存器后。输出时序、帧、日志位序及控制值必须与原实现逐位一致；不新增延迟或改控制参数。
