Scherrerll/acg720-fpga-flight-controller/firmware/B0B0/provenance/bound_evidence/1b5e193f6edc_OPERATOR_NOTES.txt

仅离线诊断快照复位优化实验，尚未验证映射后初始化，不得下载或飞行。
仅导航720位诊断快照寄存器在本顶层启用启动复位特例；顶层boot从0饱和至255，复位只释放一次。通用模块默认仍保留运行时复位。控制、数学、引脚、校准、UART时序和快照边沿不变。
先完成绑定源文件的银行/双顶层UART证明，再仅综合并逐位审计720位INIT、常量/别名/反相、CE和输出掩码。审计通过并经复核后才允许完整布局布线；必须零未布线及50MHz全部原门槛。
双顶层测试强制相同诊断输入及origin事件，并同时加速帧周期，UART波特率保持原值；不是物理初始化验证。
