Scherrerll/acg720-fpga-flight-controller/firmware/B0B0/provenance/closure/STATUS.md

# B0B0 布线与验证结果

**已完成布线与时序收敛，最高频率 51.608 MHz，零未连通。**

- 布局目标 19.5 ns，比实际板载 50 MHz / 20 ns 更严格；没有改变实际采样时钟或计时常数。
- setup / hold 总负裕量均为 0，违例端点均为 0。19.5 ns 下最坏 setup 余量为 0.123 ns。
- 恢复 / 移除 / 最小脉宽均通过；17 个引脚映射保持一致；未增加 false path 或 multicycle 例外。
- 采用同一份 0be 精简网表，保留 n3217_8 全局布线约束。39.162 MHz 对照方案已排除；另一试验在胜出后主动停止，没有把中止计作布线失败。

## 数据与代码验证

51 份源码文件、88 份候选包文件和 677 份关联证据按 SHA256 核对。未改动部分复用已有回归证据。

布通后补齐了三项增量证明：倾角有效标志发布/复位/保持及所有 65536 个单轴数值的门槛检查；就绪条件等价重排；速度有效条件合并。原准备脚本的路径类型和测试台 ANSI 端口初值语法问题只在已记录的验证适配层修复，断言、测试向量和电路未改。原始失败记录保留在 verification 中。

这些是源码与局部生产者范围的证明，未声称重新完成整个当前顶层或整个综合网表等价验证。

## 已完成的上板回归

已下载到 SRAM，下载器和遥测均确认为 B0B0。启动校准、MTF 与导航数据连续有效，38 个后期采样点中四路停机输出均为 1000 μs。

正常测距测试通过：66 个采样点确认高度控制有效、四路 PWM 遥测与已发布指令一致，健康条件下不进入失效接管；操作者确认四个电机均转动，并由 SWA 停机。

测距断流与手动接管回归通过：175 个接管采样点中姿态控制保持运行、四路输出均未掉到停机值，其中 125 个采样点处于模块数据超时。降低油门杆后四路 PWM 均值中位数从 1845.5 μs 降到 1592.0 μs，响应差为 253.5 μs。

测距恢复且高度重新有效后，仍有 50 个采样点保持手动接管，未自动抢回油门。最后由 SWA 停机，四路回到 1000 μs；整个断流试验中 FPGA 运行时间连续，没有重启。恢复后的 5 秒收到 499 个新传感器报文，UART/校验/长度/模块重启计数不再增加。插拔期间累计 685 次 UART 帧错误，校验及长度错误为 0，模块自身重启 1 次，原始记录保留。

这一阶段最初仅写 SRAM；后续已于 2026-10-24 经操作者授权将 B0B0 写入 Flash，编程及独立校验通过，实际断电冷启动也已通过，见后续记录。本次结果覆盖布线、时序、增量离线证明和上述拆桨回归；此前带桨掉动力已由操作者确认是电池松动，本轮不再列为待排查的软件故障；尚未完成带桨负载及试飞验收。当前飞机已停机，油门最低、SWA/SWC 低档。

## 交付位置

- 冻结候选：B0B0_51_608MHz_verified。
- 位流：该目录 fixture/impl/pnr/acg720_ano_port.fs。
- 完整校验值和证据索引：该目录 manifest.json。
- 复核：使用当前 Python 运行同目录上一级的 verify_package.py，仅核验文件，不访问硬件。
- source_snapshot 保存综合时的完整源文件；实际选中的物理约束与 19.5 ns 时序约束以 fixture 为准。

位流 SHA256：83653a2f405cc467ac553fd81ac57d2981c5a9f52543afbbd3368881ab4ac111

硬件回归证据索引：hardware_acceptance.json；全部试验原始数据保存在 bench/hardware。

## 追加代码与数据排查

操作者确认最低油门持续后触发落地锁定是预期行为，保留现有实现。本轮针对已上板冻结源码完成重点路径审阅，未确认出新的待修复故障；新增 13 项 UART/解析/度量边界测试全部通过。只读停机观察 6.4 秒收到 640 个新模块报文，错误计数无新增，四路始终为 1000 μs。光流旋转分量语义仍未完成资格验证。

完整范围、证据与限制见 [代码与数据排查](code_audit/代码与数据排查.md) 和 code_audit/audit_result.json。固件、冻结包及原验收证据均未改动。

## 追加拆桨动态采样

已完成未解锁横滚与原表面/印字纸两段静止观察。横滚范围 −3.73°～+4.56°，放稳回到 +0.47°；全程停机。共 2556 个原始载荷独立复核相符，模块通信错误无新增。纸面条件下融合速度 X/Y 均方根约 8.48/6.59 mm/s，低于原表面的 12.36/14.53 mm/s；未据此认定精确噪声原因或修改原厂系数。当前 XY 使用融合速度，累计位置主要用于显示。固件与冻结位流未改。

详见 [动态采样结果](dynamic_validation/动态采样结果.md)。本轮没有新增带动力纠偏、带载或飞行验收。

## 追加一分钟融合与带动力纠偏

实际 60 秒未解锁观察：301 个导航快照，融合累计位置净变化 4.401 mm，速度 X/Y 均方根 0.986 / 1.056 mm/s，原始载荷核对一致，模块错误无新增。此前 20 秒观察保留为不同条件，不据此宣称所有场景漂移都相同。

随后当前 B0B0 完成拆桨带动力四向纠偏：577 个运行快照，左右横滚、前后俯仰的稳定筛选点修正符号及上报 PWM 差动全部正确，控制器无新增故障、MTF 通信错误无新增，最后 SWA 正常停机，四路 1000 μs。实际运行 115.2 秒且出现混控饱和，仅验收方向，不作飞行增益证明。详见 bench/hardware/powered_direction_20261024T041227Z/带动力纠偏结果.md 和 powered_direction_acceptance.json。

前文“本轮没有新增带动力纠偏”的范围截至未解锁动态采样；由本追加记录更新。光流旋转分量的严格资格验证及带桨飞行验收仍未完成。B0B0 固化方案和 B0AC 回退文件已离线准备，7 项写入顺序/拒绝条件/失败回退模拟检查通过，尚未写 Flash，也未进行真实断电冷启动。

## 当前固化状态（2026-10-24）

B0B0 已写 Flash，写前 B0AC 校验、写后 B0B0 独立校验、最终重载与 JTAG/两路遥测确认均通过。真实电池单独供电冷启动已通过：USB 离线，SiK 记录到 B0B0 重新计时，38 个稳定停机快照和 75 份原始载荷复核相符；操作者确认四电机始终未转。尚未完成带桨或飞行验收。见[固化与冷启动结果](固化与冷启动结果.md)。
