Scherrerll/acg720-fpga-flight-controller/assets/branding/README.md

# GM-FLY 项目标识

`gm-fly.png` 是用户提供的原图，保留原始文件，仅用于本项目标识。

- `gm-fly.svg`：按原图轮廓描摹的透明矢量版，配色与原图接近。
- `gm-fly-dark.svg`：使用相同路径，为深色背景提亮了深蓝部分。
- `gm-fly-mark.svg`：单独的鹰图，用于网站页头和浏览器图标。
- `gm-fly-wordmark.svg`：单独的原标志艺术字路径，用于网站页头的横向组合。

SVG 使用路径和渐变，不嵌入位图，也不依赖字体。白色背景和图案镂空部分均为透明；原始 PNG 保留作为来源。
