Scherrerll/acg720-fpga-flight-controller/analysis/20261028_water_drive/qualified_offline_B0B5/README.md

# B0B5 离线候选审查包：禁止安装

RTL、13项针对性仿真/编译和真实50MHz完整布线通过；硬件接口尚未核实，未烧录、未试转、未飞行。用户提供的双线电机照片没有电调型号；50Hz/1000反向/1500停止/2000正向均为设计假设。

选用 `a13_a14`：{'water_left_pwm': 'A13', 'water_right_pwm': 'A14'}。原18脚、20ns时钟和原SDC保留。选中 setup/hold 最差裕量为 +0.013/+0.169 ns，Fmax=50.032 MHz。其余检查和精确哈希见 `qualification.json`。

建立时间裕量较小，按报告原值保留。B0B5是候选家族标识，GET显示B5不能证明加载了本包精确镜像；核验以源57/网表/位流哈希及对应报告为准。

| 候选 | 完整资格 | setup ns | hold ns | 峰值拥塞 | 最拥塞网格均值 |
| --- | --- | --- | --- | --- | --- |
| v2 P3/R0 b18_c18 | 未布通：[642] | — | — | — | — |
| v2 P3/R0 b18_c19 | 未布通：[642] | — | — | — | — |
| v2 P3/R0 f18_f19 | 未布通：[1190] | — | — | — | — |
| v2 P2/R0 b18_c18 | 未布通：[396] | — | — | — | — |
| v2 P2/R0 b18_c19 | 未布通：[460] | — | — | — | — |
| v2 P2/R0 f18_f19 | 未布通：[611] | — | — | — | — |
| v2 P3/R1 b18_c18 | 未布通：[7172] | — | — | — | — |
| v2 P3/R1 b18_c19 | 未布通：[7058] | — | — | — | — |
| v2 P3/R1 f18_f19 | 未布通：[8630] | — | — | — | — |
| v2 P1/R0 b18_c18 | 未布通：[565] | — | — | — | — |
| v2 P1/R0 b18_c19 | 未布通：[565] | — | — | — | — |
| v2 P1/R0 f18_f19 | 未布通：[920] | — | — | — | — |
| v2 P3/R0 +incB4 b18_c18 | 未布通：[1032] | — | — | — | — |
| v2 P3/R0 +incB4 b18_c19 | 未布通：[1032] | — | — | — | — |
| v2 P3/R0 +incB4 f18_f19 | 未布通：[1544] | — | — | — | — |
| v2 P1/R0 a13_a14 | 未布通：[872] | — | — | — | — |
| v2 P3/R0 +incB4 a13_a14 | 未布通：[1235] | — | — | — | — |
| v3 P1/R0 a13_a14 | 未布通：[924] | — | — | — | — |
| v3 P3/R0 +incB4 a13_a14 | 未布通：[1102] | — | — | — | — |
| v3 P2/R0 a13_a14 | 未布通：[481] | — | — | — | — |
| v3 P2/R0 b18_c18 | 中止：vendor退出码未知：[290] | — | — | — | — |
| v4 P2/R0 a13_a14 | 未布通：[322] | — | — | — | — |
| v4 P3/R0 +incB4 a13_a14 | 未布通：[1428] | — | — | — | — |
| v4 P2/R0 b18_c18 | False | -1.703 | +0.125 | 0.903 | 0.8904 |
| v4 P3/R0 a13_a14 | 未布通：[932] | — | — | — | — |
| v4 P3/R0 b18_c18 | False | -0.280 | +0.194 | 0.917 | 0.9044 |
| v4 P3/R0 +incB4 b18_c18 | 工具错误终止：[0] | — | — | — | — |
| v5 P3/R0 b18_c18 | 未布通：[1120] | — | — | — | — |
| v5 P3/R0 b18_c19 | 未布通：[1120] | — | — | — | — |
| v5 P3/R0 f18_f19 | 未布通：[1007] | — | — | — | — |
| v5 P3/R0 a13_a14 | 未布通：[357] | — | — | — | — |
| v5 P2/R0 b18_c18 | 未布通：[543] | — | — | — | — |
| v5 P4/R0 b18_c18 | 未布通：[10333] | — | — | — | — |
| v6 P2/R0 b18_c18 | 未布通：[454] | — | — | — | — |
| v6 P3/R0 b18_c18 | 未布通：[1925] | — | — | — | — |
| v6 P3/R0 b18_c19 | 未布通：[1925] | — | — | — | — |
| v6 P3/R0 f18_f19 | 未布通：[1658] | — | — | — | — |
| v6 P3/R0 a13_a14 | 未布通：[1761] | — | — | — | — |
| v7 P2/R0 b18_c18 | 未布通：[480] | — | — | — | — |
| v7 P2/R0 b18_c19 | 未布通：[480] | — | — | — | — |
| v7 P2/R0 f18_f19 | 未布通：[614] | — | — | — | — |
| v7 P3/R0 b18_c18 | 未布通：[810] | — | — | — | — |
| v7 P3/R0 b18_c19 | 未布通：[810] | — | — | — | — |
| v7 P3/R0 f18_f19 | False | -0.626 | +0.206 | 0.958 | 0.9210 |
| v7 P2/R0 a13_a14 | 未布通：[440] | — | — | — | — |
| v7 P3/R0 a13_a14 | 未布通：[437] | — | — | — | — |
| v8 P2/R0 b18_c18 | 未布通：[599] | — | — | — | — |
| v8 P2/R0 b18_c19 | 未布通：[599] | — | — | — | — |
| v8 P2/R0 f18_f19 | 未布通：[665] | — | — | — | — |
| v8 P3/R0 b18_c18 | True | +0.025 | +0.186 | 0.931 | 0.9128 |
| v8 P3/R0 b18_c19 | True | +0.025 | +0.186 | 0.931 | 0.9128 |
| v8 P3/R0 f18_f19 | False | -1.729 | +0.124 | 0.944 | 0.9127 |
| v8 P2/R0 a13_a14 | 未布通：[842] | — | — | — | — |
| v8 P3/R0 a13_a14 | True | +0.013 | +0.169 | 0.917 | 0.8890 |

拥塞为 vendor `report_route_congestion -max_grids 10` 的结果，均值只涉及报告的前十网格；不是全芯片平均，不声称全局最优。选脚在所有时序合格候选中先比较峰值和前十均值，再比较setup裕量；完全相同则优先普通IO并保留C18。实际可接线和电压仍须当前实体核实。

`source/` 为57个源输入，`DO_NOT_PROGRAM/` 保存精确位流供审查，`evidence/` 为新报告、真实退出码、仿真和新鲜网表，`tests/` 包含使用的测试台及生成的B0B4参考。`functional_input_map.json` 将每个仿真输入哈希映射到包内文件；Gowin的prim_sim.v记录为外部工具依赖。用 `python verify_review.py .` 可离线核验包。`xy_pi_cli.py` 为匹配B0B5的离线验证工具副本，未打开串口；旧B0B4地面站不冒用此候选的身份。完整控制及停机边界见 `DESIGN.md`，自审和证明范围见 `REVIEW.md`。

包中保留9个发生改动的B0B4原始源文件；结合候选中46个字节不变文件，可离线核验冻结源55。`mapped_resource_comparison.json` 为补充的叶级原语计数，和物理CLS/等效LUT利用率含义不同。

任何实体动作前须先解决 qualification.json 的安装阻断项；不能沿用此前B0B4的拆桨、接线、上电或冷启动事实。本包不提供自动安装脚本。
