Scherrerll/acg720-fpga-flight-controller/firmware/B0B2/hardware/v15_reported_flight_20261025T134349_719530Z/README.md

# V15 本轮实飞结果：稳定定点（操作者确认）

2026-10-25，操作者反馈：**“测试完了，可以稳定定点了，没问题了”**。按此次反馈记录本轮 V15 实飞通过，保留当前已固化的原始 V15 / B0B2 为实飞基线。

提供的视频长约 79.24 秒。检查了 12 个带时间戳的均匀抽帧，可见室内离地、多帧悬停以及末段回到垫子上，与操作者反馈相符。视频没有同步的摇杆、模式或遥测叠加；本记录不据此计算定点误差或确认各段开关档位。

- [原始视频归档](operator_flight.mp4)
- [抽帧预览](review_contact_sheet.jpg)
- [实飞结果与证据摘要](flight_result.json)
- [视频元数据](video_metadata.json)
- [此前固化与冷启动记录](../v15_flash_install_20261025T132659_439750Z/README.md)

当前位流 SHA-256：`3b9920acc1abecf6e0ef50465f5bc408d9b74af2ac6d046cb151137a375b4306`。

视频 SHA-256：`27d2c72a7b99d84a01b2e0cce1552e0e85b4bf378dd111ebb1c474b341423ed3`。

本次只增加实飞记录与视频归档。V16/V17 布线继续暂停，零点和限幅候选没有上板，既有源代码、位流及冻结资格记录均保持原样。
