Scherrerll/acg720-fpga-flight-controller/analysis/20261026_z_aw_fix/build/num_value_width_design.md

# v4 num50 / value39范围证明

基线为`compact_aw_v4/canonical/source/position/mtf_xyz_hold_control.v`，SHA **`ffddb029cb34a8d2ac8995cc43d85866e273d3d147bb650cfd5d3c66c580b642`**。沿用`operand_width_design.md`（SHA `1fb152c8962d633b9e8c953134d4b43f6a060c49cb1b810e1a1a939e02ad04ee`）闭合34个calc调用及真实service消费条件。此处仅源级证明，未以伪造math_result或force私有状态建立反例，也未据此提前声称资源节省。

**结论：没有发现合法消费路径反例。num可保存signed50，再符号扩展为原signed64；value_store可保存signed39，再符号扩展为原signed64。** 必须保持每个调用的乘数/分母配对，不能仅用“num50、最小分母5”推导商39位。

设Q=65536，S_n表示signed n位整个类型区间，RN是`position_divide`的nearest/ties-away。下面分组覆盖全部34调用（包含没有正常入口的31–34残留链）：

| 调用state（共34项） | 实际乘积绝对值保守上界 | 分母 | RN商绝对值界 |
|---|---:|---:|---:|
| 2、42：两S33差乘alpha S17 | **(2^33−1)×65536 = 2^49−65536** | 65536 | ≤2^33−1 |
| 3、4：afx/afy S33乘3 | 3×2^32 <2^34 | 100 | <2^32 |
| 43、44：nx/ny S18乘[500Q,1500Q] | 2^17×98304000=12884901888000 <2^44 | 65536 | ≤196608000 |
| 45：dt×314再乘65536 | 31400000×65536=2057830400000 <2^41 | 10000000+314dt | <65536 |
| 5、64：clip(fix,±500Q)乘dt | 32768000×100000=3276800000000 <2^42 | 1000000 | ≤3276800=50Q |
| 6、7：上一步≤50Q乘U16 gain | 3276800×65535=214745088000 <2^38 | 1000 | ≤214745088 |
| 65、8：ex/ey S32乘U16 gain | **2^31×65535=140735340871680 <2^47** | 1000 | **≤140735340872** |
| 9、10：sx/sy S29乘1 | ≤2^28 | 5 | <2^28 |
| 30–41：12个旋转调用 | a最多S32、b为S18，≤2^48 | 65536 | ≤2^32 |
| 0(Z)：ma34乘1 | ≤2^33（合法输入更紧） | 5 | <2^33 |
| 20：滤波新afz S32乘1 | ≤2^31 | 20 | <2^31 |
| 21：本回调捕获的alt_speed S32乘3 | ≤3×2^31 | 5 | <2^31 |
| 53：clip(e,±1000Q)乘11 | ≤720896000 | 10000 | ≤72090 |
| 22：350Q−bias(S33)乘6908 | ≤4317904896×6908 <2^45 | 106908 | ≤4317904896 <2^33 |
| 23：exz S31乘1 | ≤2^30 | 5 | <2^30 |
| 62：alt_speed S32乘11 | ≤11×2^31 <2^35 | 1000 | <2^31 |

乘积总体最大保守绝对值为**562949953355776=2^49−65536**，而signed50范围为`[-562949953421312,562949953421311]`；正负均严格在内。原乘法器给exact low64，因数学乘积本来就小于signed50，不存在借模2^64回绕掩盖溢出的问题。这里特意用alpha的整个S17范围（含−65536），不是假设理想浮点系数，也未将a34和b28中不可能同时出现在同一调用的极值盲乘。

最大保守商取S32负端点乘65535再除1000：`140735340871680/1000=140735340871.68`，RN绝对值为**140735340872**。它大于2^37=137438953472，严格小于2^38=274877906944；signed39的范围为`[-274877906944,274877906943]`，因此足够。按这个保守S32类型界不能选signed38；本审计未另行追求更窄的可达ex界。其余分组商均落在S34或更小范围，RN在整数上界处不会多加一而越过该界。

## 分母、返回归属和保留值

所有实际请求分母为正literal：5/20/100/1000/10000/65536/1000000/106908，或`10000000+314dt`。dt只从直接合法1000..100000的position_update接纳，动态分母在**[10314000,41400000]**，计算不发生uint32溢出。实际请求最小分母5；den寄存器初始1只属于闲置值，不是一个未经calc配对的请求。所有有效num远离INT64_MIN，因此真实divider不会因合法调用出现除0或abs(INT64_MIN)错误。

`num`仅initial0和state100 `if(md)`写入匹配product；同沿den从本次pending_den更新，div_start才置1。服务下一拍才看见请求，因而采到的是配对的新num/den。`value_store`仅initial0和state101 `if(dd && !derr)`写quotient；derr路径只置blocked、退0，没有捕获错误商。reset/cancel本来不清这些寄存器，但保留的是已证明有界的旧值，不需要也不应新增reset。

真实nav_math_service以done的response_owner、epoch和live cancel确认返回归属；其他client的共享result即使很大，也不会在此client md/dd为0时写入。取消时controller优先退0，service清pending/owner及epoch，旧响应不能变成新calc结果。已有MA非法/闲置算口差异仍属于v4语义：非法Z请求在service消费前被取消；即使只看v4的ma34本身，Z0的b恒1，已经落在本表num界内。不能用恶意外部md/dd+任意64位result替代真实服务契约后宣称本证明失败。

## 无循环论证与泛型边界

先对**现有v4**执行按固定calc/return_state路径证明以上值界，再对新存储实现做首个差异归纳：初始num/value均0；每次有效写入旧值都落在新类型范围，低位保存后64位sign-alias逐bit恢复，保持后续请求/返回与状态相同；其余拍保留相同旧值。因而本次num64/value64别名在取消及idle阶段也可严格相等，不需要为它们新增MA式idle例外。

闭合调用表不读取position_px/py/qx/qy，POSITION_KP_Q16仅改变这些未使用寄存器声明宽度；不为非默认POSITION_KP引入额外乘积。支持的VELOCITY_FRAC_BITS仍为0/16，work gain用任意U16界而非bank的10000上限。其余泛型不产生新calc。若未来恢复位置外环或改分母/返回路径，本证明必须重审，不能按该表盲缩新操作数。

允许的最小实现：num寄存器改名为signed[49:0] num_store，声明64位signed num并补14个符号位，state100写目标改num_store；value_store改signed[38:0]，64位value补25个符号位。表达式、状态、请求/取消、分母、原module接口及延迟全部不变。可在实际RTL中逐拍比num/value64别名与v4，同时保留原控制/安全及合法service grant断言；资源和布线仍须新测量，不能从源码减少位数预报DSP节省。
