Scherrerll/acg720-fpga-flight-controller/analysis/20261026_z_aw_fix/result_width_boundary/REPORT.md

# v5：num50 / value39实际RTL边界验证

真实v4 `ffddb029...` 与v5 `04e75ada...` 各连接独立的真实单客户端数学服务。v5仅把num存储64→50、value存储48→39，并恢复为原64位符号扩展别名；没有降低小数精度或改变运算/请求/返回状态。逐调用范围证明及独立源码审查见上级build目录。

两个速度小数配置FRAC=0/16均实际exit0，各包含816534个逐拍控制比较、870次合法乘法grant、29次Z发布和4个一拍非法az撤销见证。原222bit控制/安全/归一化/参数边界、数学request/cancel/status、实际消费操作数/结果断言全部保留；新增**每拍num/value64与v4完全相同且分别可表示为signed50/signed39**。两版本的MA/MB存储相同，本次还要求它们每拍一致，实际差异计数均为0。

24组合法压力组合与四个异常脉冲保留自前一夹具，覆盖范围及限制同 `../width_boundary/REPORT.md`：不是全状态穷尽、没有测试所有owner/相位组合。65535属于直接模块的16位增益压力值，超用户bank的0..10000；POSITION_KP当前未被运算读取，非默认值不构成新算法路径。数值异常由真实输入注入，没有force私有状态。

本次不再对num/value使用闲置例外：初始0和每次真实匹配写入都在证明范围内，取消/闲置保留值也严格一致。此前v3→v4的MA无条件算口差异是另一项历史实现关系，不能混用到本次结果。

原始driver/生成夹具、输入55源、两份simulation.log与结果见本目录；source_stability记录测试期间源未变。四客户端非零XY/Z积分和顶层13项结果另在 `../result_width_integration/`，五组饱和/恢复回归另在 `../result_width_regression/`。这项RTL结果不等于布线、上板或飞行验收。
