Scherrerll/acg720-fpga-flight-controller/analysis/20261026_z_aw_fix/rtl_regression/REGRESSION_REPORT.md

# B0B4 Z antiwindup 有界真实 RTL 回归

最终结果入口为 `final_results.json`：5 个场景通过，成功场景的实际 vvp 退出码全部为0。原首轮 `results.json` 保留 CASE5 人为过快输入导致的失败，不能单独把它称为全通过。无固件编辑、私有 force/预置、硬件操作、整机动力学模型或实飞重放。

输入为冻结 B3/B4 各55文件；前后哈希见 `inputs.json`、`source_stability.json`：

* B3 hold：`b7eef6d33789523cd1e8ff81b05e75db91ab3c67bf76e03483dec356055fa1a6`。
* B4 hold：`5a928e0a68db70974049a4debb0b841ca06fa00598a4ffb4cb506997cfed657c`。
* B4 参数 bank：`c7333f8d629a8eed60f0d0a1c042536ffb92eab753d23daee03bcfbdef306392`。

## 测试与实际结果

| 场景 | 实际结果 |
|---|---|
| 自然正误差积累约20s，随后最低杆 | B3 低杆前4600ms仍419/419次collective=1850。B4 在44ms离开1850，924ms低于1250；上向积分拒绝1716次，反向消积接受77次，末尾collective=1000。目标继续下降，没有依赖清空整个飞行状态。 |
| 未饱和轨迹新旧逐发布等价 | 400次Z发布的I、bias、collective、target及climb全部相同；100个正I步、150个负I步；没有AW拒绝。 |
| 自然下饱和，转正杆恢复 | 下夹持拒绝406次，正向积分接受52次，输出恢复；最终为1850。 |
| 取消/重入和taking_off=false | state22/23/24/66/67的enabled撤销，加state67的RC/height/origin撤销，共8个边界；旧候选清除、无撤销后的新发布、重入正常。另在state66撤去taking_off，I和collective增量归零，公开collective=1000。 |
| XY I0与Z独立 | 75次XY回调与冻结B3角度完全相同、XY积分始终0；与此同时Z积分非零。150次Z发布通过。XY I0不等于关闭Z固定积分。 |

所有成功场景合计 **3511 次** state67提交检查。夹具在真正提交前独立计算候选方向、候选/旧I对应的未夹紧总和和应选择的I；提交后检查 **同一个选择值** 同时进入 I 和 clipped collective，避免“保持I但输出仍用候选”或非阻塞赋值读取旧I的错误。没有任何写入DUT私有寄存器的刺激。

成功轨迹中每次Z发布均按ordinal对齐冻结B3，延迟恰好增加 **2个50MHz时钟=40ns**。这是提供轨迹的测量，不是所有可能争用组合的延迟证明。

**44/924ms属于固定合法传感器边界的离线见证，不是本机飞行等待时间或操作建议。** 正/负饱和案例使用合法固定height/vz/az及真实stick/乘除状态机，自然从复位积累I。Z-only输入每2500时钟携带11000us，内部仍重放11个原1ms步骤、Z PID仍用原11ms；物理调用节奏加速，未验证飞机运动或传感器的真实墙钟链。

## 首轮I0失败的保留与界定

首轮为了加速，把Z输入间隔设2500时钟，XY每5000时钟，不能容纳该完整XY/Z事务。首轮实际退出1已保留。独立诊断只增强fatal文本，重现 **B3/B4均blocked/xy_blocked=1/1，reason=128/128，height_due/position_due均1，state均100**；不是新补丁独有失败，也没有忽略状态机的过载保护。

`xy_i0_attempt02/slower_cadence_tb.v` 只将该I0用例输入间隔改为20000时钟，11000/22000us算术dt及原有全部断言保留；实际退出0。原日志、诊断退出1、诊断TB及两个输入哈希均保留在 `xy_i0_attempt02/`，无原地改写首轮失败。该加速输入节奏修正没有修改产品RTL。

取消测试对单体模块的范围也保持明确：enabled/height/origin的height_active遮罩检查即时效果；直接hold模块的RC取消沿用原注册路径。取消请求在注册确认前可能有一次私有原子提交，随后清零；测试断言无对外新发布且8拍内清除候选。完整nav/core的RC组合安全遮罩由根任务的独立真实top测试覆盖，本夹具没有强制最终safe输出。

## 可复现证据与范围

`run_regression.py` 生成仅改模块名的冻结B3参考，运行原5场景并原样保留I0过载失败；`retry_xy_i0.py` 复现诊断、运行保守cadence的I0场景并生成最终聚合。两脚本都绑定真实源、原始工具和实际退出码。使用Icarus绝对工具路径记录在 `inputs.json`；只向本子目录写文件。需当前仓库B3/B4源，未内嵌第三方来源。

本支线没有复跑参数协议、UART、完整top安全、四客户端或地面站测试；它们由根任务独立负责。此处没有综合/路由或物理验收结论，没有给实飞唯一内部I值，也未处理前飞掉高。共享XY开机默认1000/350与B4版本由55源绑定；本夹具多数场景显式输入1000/350，I0场景显式输入1000/0，不能把这些控制器测试误写成bank默认GET测试。

`MANIFEST.json` 只要求保留文件；所有 `*.vvp`、tmp和缓存均排除。`omitted_compiled.json` 仅记录本地可重新生成编译产物哈希，不要求发布这些二进制。`freeze.py` 检查所有最终证据和两套55源哈希，生成并验证清单。
