Scherrerll/acg720-fpga-flight-controller/history/15-b0b0-routing-stages/hardware/OPERATOR_NOTES_after_offline_pass.draft.txt

B0B0 操作说明草稿——仅在实际完整布局布线及50MHz时序通过后适用

本稿须待该候选零未布线、50MHz setup/hold均通过，并冻结实际位流及源文件/证据哈希后，才可作为离线通过版本说明。当前不是下载或飞行授权；不得写Flash，默认Flash B0AC不变。

本版包括三项修复：前置声明修复，恢复综合后的freshness至PWM连接；仅对导航720位遥测快照启用一次启动复位特例，保留INIT与默认调用者的运行时复位；两文件修复最后已发布collective的接管锚点及故障后的混控选择。当前映射INIT、720位输出/别名/掩码、CE和freshness路径审计已通过；最终完整构建仍须通过相同门槛。

高度、RC和IMU健康时继续原生导航/高度控制。标称等价仿真已通过，但实际健康高度下的电机输出回归仍待验证，不能由仿真结果替代。

只有已解锁、已进入起飞状态并有合格自动指令实际发布后，高度丢失才允许接管。入口collective精确保留最后一次实际发布的1000..1850us原值，未发布的pending请求不得成为锚点，已排队的自动结果不得重新选入旧collective。随后由独立RC杆量控制；collective变化限为1us/ms。后续手动目标范围为1200..1850us；1000..1199us入口仍保持原值，再按限速趋向目标，不瞬间抬至1200us。实际各电机输出仍经过姿态修正及原混控边界。

SWA停止、RC失效或IMU失效仍即时撤销输出，不等待油门斜坡。故障接管锁存；高度恢复不会自动返回高度控制，须停机/解除后按原流程重新解锁。

最低油门杆不是即时硬停。ch3<=1150且collective<1250并满足原有延迟和持续计时后，由land_lock停机；需要立即停止时使用SWA。不得将最低杆着陆锁止与SWA即时停止混为一谈。

所有实际验收仍待完成：新鲜且已停止的设备身份确认、获准的停止状态SRAM安装、健康高度输出回归，以及高度丢失、手动杆量、恢复锁存、最低杆着陆锁止和SWA/RC/IMU停止验收。保持已确认的拆桨测试条件；不重复光流校准或RC端点校准。本版尚未获得飞行资格，历史带载掉电问题仍未解决；本稿不授权任何Flash更改。
