Scherrerll/acg720-fpga-flight-controller/firmware/B0B2/hardware/v15_stick_oscillation_20261025/rotation_followup/dynamic_scope.md

# 支点不可用后的离线动态核查

2026-10-25。操作者说明目前只能悬空手持，且尚未做过 SWC 低档打杆对比。因此本轮**未执行固定支点采集，也未重复无位置约束的手持动作**。继续只读核查此前两段光流模式飞行记录，未操作机体。

## 目标与实际姿态的关系

只取 epoch12、taking_off=true、几何高度≥600mm且XY启用的接收帧；按连续序号和199–201ms时间步长分块，不跨丢帧或启动epoch：

| 主轴 | 合格帧/连续块 | 同时刻相关 | 姿态晚一个接收采样格的相关 |
|---|---:|---:|---:|
| 第一段俯仰 | 39 / 2 | .569 | .976（37对） |
| 第二段横滚 | 67 / 4 | .701 | .976（63对） |

回中后，俯仰目标仍在约−11.87°…+11.51°，横滚目标在约−11.00°…+10.89°之间往复；实际姿态与这些目标共同摆动。不能把它简化成“目标始终为零，机体单独自行振荡”。

但这仍是闭环相位关系，不是因果识别。一个采样格是200ms；不能将其称为精确测得的内环延迟。扫描中没有≥1秒且目标跨度≤1°的合格固定目标片段，因而没有足够输入将姿态内环与光流外环独立验收。

## 为什么 .93 的角速度相关性不能单独认定去旋转缺失

近悬停、小角度、近似正弦条件下，俯仰 θ=A sin(ωt)：

`a_forward≈−gθ → v_forward≈(g/ω²)·pitch_rate + 常数`

横滚同理：

`a_right≈gφ → v_right≈−(g/ω²)·roll_rate + 常数`

所以真实平移速度本身就可以与高度×相应角速度同相、同号。这次粗略周期约1.28–1.49秒，对应g/ω²约0.406–0.555m，相对于约1.0–1.1m飞高不可忽略。此前的相关性是线索，不能直接当成光流旋转污染的独立证明。

进一步按原始A579的yaw_relative_cdeg（与导航使用的body_yaw同源）逐帧配对，把世界线加速度转回航向坐标；没有用光流反求yaw。加速度与近悬停姿态模型的相关约.983/.975，支持上述真实平移混杂确实存在。

用约5Hz加速度做梯形积分、仅处理未知初速度常量后，估计速度RMS约.308/.313m/s，光流观察约1.032/1.099m/s；剩余分量仍与角速度相关。**这是粗略尺度对照，不是实际速度真值或补偿标定。** 同一姿态/重力估计、带桨振动、欠采样、曝光/滤波相位和光流尺度误差都可能影响结果，仍不能唯一确定是哪项造成起振。

## 当前结论与可行下一步

- 当前没有证据表明源码默认PID被改坏；也没有发现单位、报文打包或约定轴向换算的明确错误。
- 动态振荡仍未修复。现有记录说明目标、实际姿态和速度反馈组成的闭环在往复变化；不能声称光流或姿态内环中的某一层已经单独排除。
- 固定支点暂不可用时，下一轮最有判别力的可行对照是**原V15、原PID、SWC低档关闭光流XY后的短时小幅打杆/回中**。低档仍保留高度控制。已准备[采集与判断计划](manual_comparison_plan.md)，尚未执行，也未要求当前拆桨状态下装桨起飞。
- 若低档也振荡，先查姿态内环/执行器/机械；若低档基本稳定，再集中到新增光流测量、速度融合与速度PI的相位/增益，并检查目标形状是否激起内环弱阻尼。不能只由一种结果直接宣布整条内环通过。

PID、固件及原始证据保持原样，所有V16/V17布线继续暂停。本轮没有下载、Flash写入、自动控制或新物理采集。

## 可复查结果

- [目标—姿态审计](C:/Users/ScherrerL/Desktop/apple/timing_closure_20261025/flow_rotation_protocol_audit/epoch12_target_pose_lag.json)
- [真实yaw的惯性尺度对照](C:/Users/ScherrerL/Desktop/apple/timing_closure_20261025/flow_control_equation_audit/translation_confound_primary_yaw.md)
- [此前协议/静止/去旋转核查](README.md)
