Scherrerll/acg720-fpga-flight-controller/THIRD_PARTY_NOTICES.md

# 第三方来源与许可状态

本工程包含自主适配的代码，也包含从其他飞控和传感器实现派生的部分。本说明记录的是整理时的私有归档状态；私有归档不代表已经取得所有上游代码的公开再分发许可。本次没有为整个仓库统一套用新的 MIT、GPL 或其他许可证。

| 来源 | 导出范围 | 处理 |
|---|---|---|
| 用户提供的匿名/拓空者参考源码 | 有限参考 C 函数、RTL 派生模块 | 保留版权头与来源；未找到可覆盖全部代码的明确宽松许可，公开前需核清 |
| Bitcraze PMW3901 初始化 | 历史光流 reader/init | 随相关源码保留 `sensor/UPSTREAM_LICENSE.txt` 的 MIT 文本 |
| PX4 派生控制/参考实现 | 相关模块 | 保留 `core/NOTICE_PX4.txt`，历史参考模块适用时保留原 LICENSE |
| Gowin 构建报告 | 有限 PNR/时序/资源文字证据 | 保留报告原版权声明，不含编译器二进制/安装包 |

完整 `reference_ano`、TI MCU 库、Bosch API 参考包、第三方资料压缩包和手册均不在本次上传范围内。原资料树中有文件仅允许面向 TI MCU 使用，因此不能将整个资料树标为项目自有开源代码。

来源和字节清单见 `history/origins_manifest.json`、`history/early_manifest.json`、`history/late_manifest.json`、`firmware/B0AE/source_export.json` 和 `ground/export_manifest.json`。最早的方案和接线只保存事实摘要及会话来源索引，没有上传完整聊天。地面站便携化的修改逐项列在对应清单中，这些修改不改变各上游项目的许可。

原始飞行日志和实物照片没有上传。少量历史证明保留了原工作区路径及 USB 设备标识；公开前需要复核第三方权限以及这些记录的公开范围。是否公开由仓库所有者决定，本说明记录的是当时的私有归档状态。
