Scherrerll/acg720-fpga-flight-controller/docs/WORK_20261025_26.md

# 2026-10-25～26 工作记录（北京时间）

截至 10 月 26 日，B0B3 的参数接口、电脑工具、针对性验证及新网表完整布线已经完成。**实际 20.000 ns，Fmax 50.257 MHz，五类时序全部通过；尚未安装、未写 Flash，实机通信和飞行动态没有获得本次验收。**

入口：[B0B3 源码与验证](../firmware/B0B3/README.md)、[资格记录](../firmware/B0B3/qualification.json)、[飞行问题分析](../firmware/B0B3/analysis/FINDINGS.md)、[本次 Git 归档清单](WORK_ARCHIVE_20261025_26.json)。Git 使用真实提交时间，不回填昨天的日期。

## 两天的进度

| 阶段 | 已完成及证据边界 |
|---|---|
| 10-25，B0B1 | 建立被动诊断工程并保留测试；两次布线分别剩 930、575 根网络，未产生可安装镜像。它是失败阶段记录，不是当前候选。 |
| 10-25，B0B2 | 修复旧 IMU 整帧拒收/恢复饥饿机制，形成超时策略 v3；保留真实 dt、数值步长、控制命令超时及传感器新鲜度保护。原 V15 完成当次停机、SRAM、Flash、独立校验与冷启动记录，未完成飞行动态资格。 |
| 10-25，P005/I0 | 后续固定 P=.05/I=0 基线留下独立 Flash 校验和冷启动凭据。原 19.5ns 报告有 setup WNS −.267ns、51 个违例端点；当时的 20ns 结论是分析性审阅，不是厂商重新跑的 20ns STA。见[原始回执与说明](../validation/20261025_p005_i0/README.md)。不能把它与原 V15 的 19.5ns 通过记录混为一谈。 |
| 10-25～26，B0B3 | 从 P005/I0 出发实现共享 XY 速度 P/I 运行时调参、恢复原 I 路径、停机门禁、串口协议与 CLI，并解决实现中发现的位宽及解锁竞态问题。最终完成新的完整布线与真实 20ns 五类 STA。 |
| 监控与网页 | 补齐 B0B1/B0B2 的目标跟踪、v3 协议/未知年龄语义和记录来源；三组离线测试共 26 项通过，见[测试回执](../validation/20261025_26_offline/results.json)。没有为本次上传重启真实接收器或网站。 |

最近已记录的机载基线是 P005/I0（B0B2）；B0B3 是新的离线合格候选。历史安装记录不代表本次重新检查了实体状态，也不授权安装下一镜像。

## B0B3 是否符合最初要求

| 原要求 | 最终结果 |
|---|---|
| X/Y 共用 P/I，默认 .05/0 | 两轴共用一对参数，均进入真实控制运算；范围 0～1，步长 .0001。 |
| 保持原积分语义 | I 恢复原速度误差、dt、误差限幅、±1000cdeg 积分限制、停用/起飞/切模/取消回滚语义；I=0 清零。默认及原 V15 参数均做数值对照。 |
| 只允许停机修改 | 检查未解锁、控制/起飞/新鲜命令均关闭、四路实际 PWM 为 1000us，并拦截有效 CH5 高位的预解锁意图；真正提交边沿再次检查。 |
| 一对参数原子生效 | P/I/generation 同拍提交；一次 XY 运算使用同一完整参数对。飞行中允许查询。 |
| 可追溯串口协议 | B16 接收、B15 发送，115200 8N1；CRC、格式/范围、超时、序号/重发保护和唯一 TX 仲裁。ACK 报实际生效值。 |
| 可用电脑工具 | CLI 成对 SET、匹配响应，随后独立 GET 验证；SET 不自动重发，明确提示仅本次上电有效。 |
| 保留现有系统 | 相对冻结基线，45 文件逐字节未变，9 个既有文件改变，新增一个参数模块。没有加入位置环或光流去旋转，也没有重写高度/姿态/率环或取消保护。 |
| 新网表真实 50MHz 验收 | 最终 P3/R0、map2、replicate0，零未布通；实际 20ns 新报告五项通过。 |

改动逐项见 [source_review](../firmware/B0B3/provenance/source_review.json) 和完整源码差异。原审阅记录按其当时的源码哈希保留；B7 控制器已经发生结构变化，应依据后续公开输出等价证明，不能再称它与早期控制器逐字节相同。

## 为更好布线做了哪些改变

1. **减少重复响应存储。** TX 直接发送参数模块持有的冻结响应，参数模块也不再复制整帧。两次独立综合相对各自上一版分别减少 199FF/617LUT、126FF/136LUT；完整旧遥测 644 字节和混合流 692 字节保持一致，ready 仍等最后一个 UART 字节真正完成。
2. **分散快照使能。** 把完整 16 位工作 P/I 以及两个 27 位积分回滚快照移到 `state==0` 采样。XY 接纳的同一边沿仍捕获相同值，活跃工作期间冻结；取消时恢复相同积分。原回调快照 CE 从 215 负载恢复到 129；另一个闲置采样网为 86 个 CE、146 个总直接负载。
3. **保留已证实的物理约束。** 恢复已安装基线使用的 observer reset 全局资源指令；新增 RX 异步例外仅止于第一级同步器 D，后续路径仍计时。20ns 是原任务明确要求的实际 50MHz 目标，旧 19.5ns 报告未改写。
4. **固定网表再比较物理算法。** 同一份 `4497e28…` 网表在 P3 快速路由留下 1 根网络；P3 默认路由完整完成。没有重复相同输入冒充新尝试，也没有把那 1 根网络指认为某条未经识别的信号。

快照调整是 RTL 结构优化，包含明确的私有状态差异：闲置/复位期间的私有快照可以不同。两份真实参考控制器的 **450 个公开位、1,002,843 周期**比较一致，并覆盖两次非零部分积分的真实取消回滚；数值、安全 13 项及四客户端争用回归通过。这不是完整综合网表形式等价或实机飞行证明。

| 最终时序 | 最坏裕量 |
|---|---:|
| Setup | +0.102 ns，违例端点 0 |
| Hold | +0.145 ns，违例端点 0 |
| Recovery | +11.895 ns |
| Removal | +3.312 ns |
| 最小脉宽 | +7.387 ns |

原始五类表共 110 行由独立脚本复核。Fmax 50.257MHz；18 个引脚与 CST/网表一致。

## 明确做了哪些取舍

- 参数掉电恢复 .05/0，不做 Flash 保存。
- 协议一次处理一条在途请求，处理/持包时忽略额外请求；避免覆盖 ACK 和正在提交的事务。
- 可变乘数和原积分路径需要少量额外数学步骤。实测孤立 XY 最长 101.64us，四客户端持续争用下请求至发布最长 355.84us；与独占服务输出一致。这是所测时序边界，不是飞机动态辨识。
- 保留既有保护和积分位宽，没有为了布线删 I、缩小合法增益范围或降低实际 50MHz 时钟。
- 最终没有采用一拍延迟 UART 复位、独立通信复位、串行 CRC、body-only 请求或计数器缩位实验。body-only 虽减本地 FF，却使整机多 620LUT，已停止；计数器版功能/资源通过，但父版本已完成验收，未合并其未完成的物理尝试。

## 问题分析、是否及时修改

| 问题 | 结论与处理 |
|---|---|
| 大 P 时限幅前中间值溢出 | 确认的实现问题；交付前将 P+I+FF 中间量从 signed32 改为 signed36，并用最大合法 P/速度边界验证。它不是已证明的旧振荡首因。 |
| 解锁 FF 同拍更新可能漏拦 SET | 确认的实现竞态；加入 CH5 解锁意图门和提交边沿复查，真实顶层同沿 arm/commit 拒绝测试通过。 |
| 延迟 UART 复位会丢启动跨界请求 | 实验中发现反例，立即停止该方案；最终保留原启动时刻。未把有已知反例的版本装机。 |
| 速度外环是否真正接管 | 所查当前 46/46 活动帧的实际目标与导航目标一致，可排除该范围内仅 shadow 输出的解释。 |
| 表面影响光流观测 | 同一镜像静态对照有直接证据：Y 峰值约 984.4 与 45.6mm/s。未形成通用质量阈值，未以改 P/I 冒充传感器修复。 |
| 转动相关伪速度 | V15 两段有强相关及 P2/RTL 功能差异支持；真实平移、模块内部补偿、曝光/传输时序仍混杂。没有加入未经辨识的补偿系数。 |
| 两次 XY 退出伴高度降级 | 降级锁存已确认，首次高度资格撤销的触发源仍未知。未删除保护，未声称已修复。 |
| 旧 B0B0 合法变化拒收重演 | B0B2 已移除该策略，所查窗口拒收累计为 0；可排除这一可见机制重演，不能扩大成所有 IMU/高度问题均排除。 |

已确认且属于本次实现范围的缺陷在交付前修复并回归。仍属假设或需要实物辨识的问题保留为未决项，没有静默扩大成控制算法重写。回中刹停和持续悬停仍未获得新镜像实测验收。

## Git 归档与后续阶段

本次提交包含两天的源码、电脑工具、有限历史回执、选中位流、压缩后的选中网表/物理证据、问题分析、测试及哈希清单。完整原始飞行流、录像、厂商/第三方资料包和失败中间数据库留在本地；被省略文件的哈希与原因列在归档清单。原阶段 README/清单仍是当时记录，部分历史完整包核验器需要未上传的原工作区资料。

新导出的 B0B3 使用自己的导出核验器，明确区分复制、gzip 无损保存、原始本地依赖和测试复用；不冒充在新目录重跑完整原始交付包核验。

本轮没有串口、JTAG、SRAM、Flash、遥控或电机操作。下一阶段需按任务要求取得新镜像当次接线/拆桨停机确认与 SRAM 授权，再做默认查询、停机 SET/GET、锁定拒绝及重启默认值检查。旧镜像授权不适用于新镜像。
