Scherrerll/acg720-fpga-flight-controller/ground/B0B4/操作说明.md

# B0B4 地面站 P/I 操作

本说明适用于**已完成验收并安装B0B4**的设备。生成源码不会自动更新飞机；先以固件交付记录和设备查询结果确认版本。

共享水平速度参数的启动默认值为 **P=0.1000、I=0.0350**。X/Y共用这一对参数，它们不是姿态环或高度Z环增益。此次低油门问题的代码修正作用于Z积分饱和，和这组水平默认值分别处理。

## 查看当前参数

1. 打开本机地面站 <http://127.0.0.1:8765/>，找到“共享XY速度P/I”卡片。
2. 点击“查询设备参数”，以**设备回读区**的P/I、generation和B0B4功能标识为准。输入框仅是草稿，不能证明设备已使用该值。
3. 回读已经是0.1000/0.0350时，无需再写一次。读不到B4响应时先核对机载版本、连接和接收服务，不把超时当作写入成功。

## 修改一对参数

1. 地面维护时拆桨、停机，CH5/SWA、油门及CH7保持低位。等待最新同组遥测显示未解锁、控制关闭、四路PWM均1000μs，并满足页面停机预检。
2. 输入P/I，单项范围0～1、步长0.0001。该范围是接口编码范围，不表示全部数值均经过飞行调参验收。
3. 勾选页面的停机确认，点击“同时写入P/I”。设备按一对参数原子提交，不能只修改半对。
4. 等待SET确认和随后独立GET读回都成功，核对P/I与参数版本。界面只有在两者匹配后才显示验证完成。

“默认值”按钮只填入0.1000/0.0350草稿，不发送命令；要写入仍按上面步骤操作。发生超时、断线或结果未知时，先恢复连接并重新查询实际值，再决定下一步，避免重复盲写。

## 断电后会怎样

安装这次B0B4固件后，每次真正复位默认都是**0.1000/0.0350、generation=0**。以后在页面手动写入的其他值仍只对当次上电有效；本接口没有新增参数写Flash功能。固件永久安装与参数临时SET是两件事。

同一串口只能由一个接收服务占用。升级时应按交付流程切换到配套B4服务；旧B3服务不会因为新文件出现在磁盘上而自动切换。参数读写成功证明的是链路和参数一致性，实际刹停、悬停与着陆效果仍以新版后续实测记录为准。
