Scherrerll/acg720-fpga-flight-controller/firmware/B0B2/CHANGE_REVIEW_ZH.md

# 之前能自稳飞行，为什么现在光流失稳

目前能证明 B0AC 到 B0B0 有代码变化；不能证明用户更早那次成功自稳飞行使用了哪个固件。两次本次光流试飞的日志固件均为 B0B0。自稳成功不等于光流定点链路已经在相同条件下验证。

## 已核实的版本差异

- B0B0 改过起飞、自动模式、高度及水平速度 PI 控制。实际水平控制的每轴目标倾角上限从1200提高到2500（12°到25°），光流几何有效门槛仍是每轴±1500（±15°）。这会允许控制目标超出观测资格范围；实际RTL已复现目标超过15°和实际姿态越界后XY取消、Z仍可工作的路径。
- B0AC到B0B0的时间域样本判定和接受保护模块相同；姿态估计数值算法相同，另增加了同步45°标志。这次发现的合法运动输入被拒收问题不是这段版本差异新引入的，但可能在不同振动或运动条件下才暴露。
- B0B0取消了B0AC显式相对位置外环。速度PI在连续有效观测、近恒航向且积分未复位、未饱和的条件下仍可产生等效位置恢复作用，不能据此简单声称“完全没有位置恢复”。
- 网站的显示优化没有修改FPGA控制位流。

原始差异证据保留在 `../B0B1/evidence/b0ac_to_b0b0.json`。本次试飞的早期拒收先于后期大倾角，现有约5Hz记录不能确定逐次拒收、姿态发布和实际振动的完整先后关系。因此上述差异和失效复现不能单独证明本次唯一首因。

## 当前 B0B2 改动与证据

修复候选接受读出、配置和数值检查已通过的六轴帧，去掉把整帧判坏的经验性跳变规则。保留传感器ID/配置/数值检查、计算超时、真实60ms断流保护、恢复资格和已接受的落地锁逻辑。没有调整控制增益或提高光流有效门槛。

同一组90次合法交替加速度输入，冻结旧版接受16、拒收74、发布姿态0；候选接受90、拒收0、发布90。真实断流和恢复、正常运动、坏读数及计算超时回归也有独立证据。这里只说明已复现的软件失败用例得到修复，不能代替带载实测。

飞行诊断通过现有115200 SiK增加带序号、时间戳和CRC的被动摘要；USB只镜像同一数据，不再使用B0B1的921600诊断流。摘要记录发布计数、最大发布间隔、消费序号及首异常/首保护，5Hz摘要仍不能还原所有逐次输入。

## 当前边界

截至本记录，新源码没有通过布线及时序验收的位流，未安装SRAM、未写Flash。25°/15°问题也尚未在控制源码中修改。具体物理构建结果见 `evidence/STATUS.md`。

后续先完成独立物理验收，再在当次确认拆桨与低档状态后验证姿态数据连续性；随后继续光流轴向、旋转、动态融合及目标范围一致性。拆桨未复现不能写成带载修复完成，也不能据此给出恢复光流试飞的结论。
