Scherrerll/acg720-fpga-flight-controller/web/flight-console/POSE_CONTINUITY_20261025.md

# 官网姿态连续跟随修正（2026-10-25）

用户确认问题是官网姿态图“停一下再跳”。上一版160ms固定动画只消除了瞬间跳变，没有覆盖两包之间的等待：1Hz确定性回放中62帧仅10帧运动，52帧静止，约83.9%。本机15秒实测，本地新快照间隔中位203.5ms，官网HTTP新快照间隔中位1431.9ms、最大2028.5ms，符合该机制。后者是本机客户端测量，不代表所有浏览器线路。

姿态图改为连续跟随最后收到的姿态，随实际有效包间隔调整响应速度；每帧从当前显示姿态趋近最新端点，新包到达时立即换目标，既不排队回放，也不越过端点推算未来姿态。重复序号不改变节奏，横滚/航向按最短角度差跟随；首次数据、超过10秒的接收间隔、固件/序号重启、切回前台及关闭连贯显示时直接定位到真实值。

数字、控制状态、电机输出和曲线仍使用最新接收值。图形平滑必然有少量跟随滞后，页面明确标注；不承诺消除公网本身的数据等待。按钮改名“姿态连贯”，可关闭后查看完全即时的图形。曲线、采样率、发布频率和失效判断不变。

41项Node测试通过。新增回归验证1Hz时整个包间隔持续运动、2.6秒慢响应、200ms本地响应、重复序号、角度环绕、未知值、无外推和长断流；实际app集成验证数字立即更新且图形在400～800ms之间仍在跟随。1Hz相同输入下，固定动画的静止帧52/62，连续跟随静止帧0/62。

只改网页及相关测试、文档，不改FPGA或串口接收器。
