Scherrerll/acg720-fpga-flight-controller/web/flight-console/LATEST_DISPLAY_20261025.md

# 最新数据与短动画过渡（2026-10-25）

用户要求数字和曲线都尽快显示最新接收值，同时避免画面生硬跳动。之前曲线约4秒的历史回放缓冲已移除；不再提供将姿态切到旧曲线游标的模式。

- 数字、控制状态、电机输出在响应到达后立即更新；保留最后有效姿态、源龄和真实过期提示。
- 姿态图只在已接收的前后姿态间做160ms过渡，60Hz上限绘制；没有新数据时停止在已知姿态。长时间断流恢复、切回前台和固件/序号重启时直接定位到实际值。
- 曲线立即使用最新历史点，30Hz上限滚动；短过渡仅调整视窗时钟偏差和自动纵轴收缩。新极值立即扩展量程，避免被裁掉；不修改样本坐标，不填补真实断流，不推算未来数据。Setpoint仍为阶梯线。
- 两个默认开启的按钮改为“姿态过渡”和“曲线过渡”；关闭仅去掉对应动画，数据仍使用最新接收值。

仅改网页展示和相关测试，无串口、FPGA、布线、固件或遥测频率变更。公网传输本身的延迟仍由实际链路决定。

验证：36项Node测试通过，包含真实app集成测试：数字立即变化、图形80ms走到中点/160ms到终点、最新4秒历史立即可见、原始PWM与解锁状态、三轴总览、目标阶梯、缺失航向、真实断流、前台恢复和日志预设。静态构建通过。生产发布和浏览器核对记录保存在本机deployment目录。

补充回归：公网成功响应间隔约2～3秒时，最新数字仍立即更新，姿态图仍在160ms内完成过渡；不把慢响应当成需跳过动画的长时间断流。超过10秒的接收间隔、前台恢复或固件重启会直接定位到实际值。
