Scherrerll/acg720-fpga-flight-controller/web/flight-console/SMOOTH_DISPLAY_20261024.md

# 2026-10-24 连贯显示

官网已发布到原 EdgeOne 项目 `makers-pgx1ueruoas8`，部署号 `dp8d9rvivmh9`。访问地址仍是 https://gmflylog.com/ 。

公网请求实测约 1–3 秒，本地接收和 HTTP 转发约 0.1–0.2 秒。此改动针对页面跳动：默认开启“连贯显示”，在已接收历史点之间插值，使用约 4 秒缓冲。姿态和运动读数按最高 30 fps 更新，近期趋势按最高 10 Hz 重绘。页面显示估计回放延迟，可以关闭按钮切回最新接收值。

仅横滚、俯仰、相对航向、融合高度和水平速度参与回放。健康状态、模式、解锁、遥控和电机 PWM 保留原始最新接收值；不改源有效性判断、数据超时、云端轮询频率、飞控、数传或日志。角度按最短路径插值，缺失字段保持空值，不向最新历史点之后外推，不跨越超过 1.6 秒的源历史缺口。断流仍显示过期或中断，不能保证长时间断网时持续播放。

验证：

- 32 项 Node 测试通过，包括缓冲插值、网络抖动、缓存耗尽、源缺口、角度环绕、未知字段、失效标记、重启与序号正常回绕。
- 应用集成测试验证姿态推进、即时切换、原始解锁/PWM 保持、隐藏页面停止动画。
- 浏览器在本地真实遥测页面验证开关、延迟标签与页面布局；访问公网页面的浏览器检查超时，因此没有声称完成公网浏览器视觉验收。
- 生产构建成功。正式域名的 HTML、app.js、live-playback.js、styles.css 均 HTTP 200，逐文件 SHA-256 与部署构建一致，新模块以 JavaScript MIME 返回。公网 live 接口返回 B0B0 的真实遥测；公网源龄仍可能超过 5 秒过期阈值，显示优化不消除网络延迟。

此次部署源 ZIP 共 35 个文件，SHA-256：`d7ac3a0c658c959666b8154e48fd5de9c7ee386a327bb29bcea37d259389bea0`。包内不含 `.env`。原 B0B0 冻结包、归档索引和飞行验证结论不变。

## 同日：趋势窗口与相对航向

用户截图中左侧空白来自固定 60 秒横轴与较短的已接收历史。相对航向数值在原始快照和历史中都有，但原趋势图只选择横滚、俯仰和融合高度，没有绘制航向。

已改为按收到的历史自动扩展时间轴（最小 5 秒、最多 60 秒），明确显示当前时间窗口；真实缺口不补画。增加单独的紫色相对航向图及独立纵轴缩放/复位，避免航向量级压缩横滚和俯仰曲线。缓冲额外保留回放延后所需的历史。相对航向仍是原有估计值，没有绝对航向参考。

33 项 Node 测试通过，应用集成测试实际检查 Canvas 绘图路径：短历史从左侧开始、航向线真实绘出、完整窗口不超过 60 秒、源缺口保持断开、未知航向不画成零。另有缓冲历史保留检查。生产构建通过；本地真实遥测页面已看到三张曲线并保存截图。最新部署号 `dpox5zq03jv4`，源 ZIP SHA-256：`be0d2961ec206a5b52db54b84625163a034324def6186249c9a151930b47af3a`。
