Scherrerll/acg720-fpga-flight-controller/analysis/20261028_water_drive/qualified_offline_B0B5/REVIEW.md

# 离线设计复核记录

本轮为主代理自审与工具核对，没有独立人员或子代理审查，不将本文件标成独立审查通过。

1. 初始 `rtl/water_pwm_pair.v` 仅能产生波形，缺少模式、健康和重新使能所有权，动态 `stop_us` 也不足以证明停止语义。各版构建只使用明确指定的`candidate_v*/source/water_*.v`，`candidate/source`为最终提升入口。旧`rtl/`和旧两个测试台未用于新网表。
2. 水上反向时不能沿用单向飞行 PWM 的“至少 1000 μs 前缀后缩短”策略：那会把反向信号错误当作停止。新增 PWM 完成当前完整脉冲并在下一帧切中位，同时记住一次使能中断，禁止帧内重启。复位的无信号语义单独列为硬件待验证项。
3. 飞行中直接将 CH6 组合到总停机逻辑会造成误碰开关空中停转。模式在 CH5 低、低油门、中立及飞行已停稳条件下锁存；已解锁飞行不接纳 CH6。地面拒绝水上请求后仍锁住飞行准备，避免操作者以为已选水上而意外解锁四旋翼。
4. 接收机保持值不等于新包，采用真实 `rc_update` 驱动独立新鲜度。FPGA 能检测 PPM 失效，不能仅从持续发送的保持帧检测无线链路失效。接收机 failsafe 必须台架核实。
5. 所有模式/水上故障清除低位准备和高位确认，高位恢复不得重启；界限同时包含缺 CH6/7、存在但越界的 CH8、CH6 中位、CH5 中位和水上 CH3 离开低位。
6. 共享 CH5 必须禁止飞行 gate 在水上解锁。核心健康入口互锁，水上再检查飞行原始解锁/起飞/命令/PWM 状态；v4/v5通过第14项不变量恢复原live条件。模式转换 25 ms 停稳等待跨过完整水上和飞行 PWM 帧。
7. 水上新增块使用窄位宽、加减/比较和微秒计数，无乘法 DSP，保持原资源紧张工程的可布线性。三组引脚用同一新网表完整布线；没有因未通过而降低频率或放宽时序例外。
8. B0B4 55 个源输入、发布镜像及清单以有界哈希守卫保护；未读取 `.env`、`deployment.env`、凭据或 B0B2 的禁读压缩包。构建目录仅追加，失败尝试保留。vendor 生成的 `.gprj.user` 是辅助产物，检查显式声明的 57 个源码，避免把辅助文件的存在误报为源码修改。
9. 初次派生 PNR 工程的 XML 序列化产生了重复 XML 声明，被 vendor 以真实退出码 1 拒绝。修复构建脚本为单一声明后使用新目录重新执行，没有改写失败日志或把 runner 的退出码当成 vendor 通过。
10. 原参数通信版本必须与新固件区分，因此 UserCode 和 A591 feature 标识改 B0B5；XY 默认 P/I 和协议行为未改。不提供伪装 B0B4 的兼容路径。原地面参数工具可能拒绝新版本，这是待后续明确支持的限制。
11. 自审发现新 PWM 的组合计数译码直接驱动引脚，RTL 仿真无法排除物理组合毛刺。改为两个专用输出寄存器，保留精确脉宽、完整帧和异步复位静默；原 v1 三次 PNR 在完整布线前主动中止并记录真实退出码 4294967295。v2 重新综合，网表须证明输出缓冲直接由寄存器 Q 驱动，再从新网表比较引脚。
12. v2 的 P3/R0 完整物理尝试未通过：B18/C18 与 B18/C19 均 642 条未布通，F18/F19 为1190条，三个 vendor 实际退出码均为1，没有生成可验收 STA/位流。原CLS使用26399，新候选26533（均约89%）；这些事实说明原布局配方不能直接继承，不能单凭资源总量尚未满就宣称可布线。继续用同一已完成的新网表分别比较P2/R0和P3/R1，不改RTL、SDC、频率或功能。
13. 后续 v2 普通配方仍未布通。独立v3只精简新增水上块：互斥的低/高确认共用计数器，混控由3级改2级（60ns改40ns，均远小于20ms PWM帧）。水上控制块少48寄存器/55LUT，整体少47寄存器/24LUT，DSP不变；全部8项验证通过并重新综合，没有把v2的物理结果当作v3资格。
14. 网表追踪发现，直接把mode禁止加进原live组合条件会影响1127个原寄存器引脚。独立v4保留gate健康入口的禁止及水上对飞行armed/stop的检查，恢复B0B4的live条件；设计文档给出从复位开始的禁止=>未解锁归纳论证。新增300000拍快速仲裁压力测试及实际core断言通过，连同原8项共9项。新网表该组合影响降至255个原寄存器引脚，整体比v3再少53LUT。v4仍必须另行完成所有物理资格，不从仿真或原B4借用时序结论。

15. 补充v4端到端实模块联调，穿过PPM解码、原gate、新水上控制/PWM及原飞行PWM；验证1800/1600差速、反向共同中立等待后1200/1200、丢帧1500、高位恢复持续超过0.5s不能重启，以及水上已中立后原飞行1300。v4共10项检查通过；缩放计时的联调与生产终值/真实50MHz波形分别保存，避免把缩放场景称作真实时间测试。
16. v4 B18/C18两次完整布线的正常vendor退出均0，但P2/R0和P3/R0的setup分别−1.703/−0.280ns，明确拒绝物理资格。P2/R0最差路径是原MTF距离到手动角度CE，并含4.998ns长网。v5只在独立副本中缓存原距离有效性谓词，和raw_frame同一有效接纳边沿更新，复位/保持/错误所有权相同；阈值、算术、公开接口和发布周期不变。
17. v5修改前后均使用相同B0B4实际UART参考逐拍对比。最终完整11项检查全部通过，包含1,563,958比较/441样本/172有效性边沿；边界、随机32位高位、状态/质量、加和校验及错误/超时/复位/诊断冻结/新鲜度均覆盖。网表确认缓存DFFRE与原帧同CLK/RESET/CE；缓存分支至指定CE深度13，但原始距离的其他flow/geometry分支仍可达该CE、深度17，故不据此提前宣称时序改善。
18. v3 B18/C18 P2/R0在报290条未布通及Tcl错误后等待超过80分钟未返回。Windows仍枚举到vendor条目且报告HasExited=True，runner没有正常p.wait回执；已停止该离线Python runner，保存中止原因和日志哈希，vendor退出码保持未知。它作为中止失败项参与矩阵，不能伪造正常退出码或套用其他尝试的STA。

19. v5 P3/R0四组均未布通，依次为B18/C18=1120、B18/C19=1120、F18/F19=1007、A13/A14=357；B18/C18 P2/R0=543。五个vendor正常退出码均1，没有完整STA资格。P4/R0作为手册支持的另一布局策略另行记录，不改变频率、SDC或功能。
20. 独立v6把同一帧的flow有效性条件一并缓存，数值计算、范围阈值及公开发布周期不变。先扩大flow_status与quality覆盖并在修改前通过同一B4对比，再改动；最终全部11项验证通过，含1563958比较/441样本/172距离边沿。源码允许改动逆向撤销后整份MTF/core/top精确恢复；两缓存DFFRE同原帧CLK/RESET/CE。指定CE的距离缓存分支12级，剩余原始距离geometry分支15级（v5=17），flow缓存经1级LUT到flow输出；没有把拓扑深度当作物理时序通过。

21. `mapped_resource_comparison.json` 以同一图读取器统计各版网表叶级原语：B0B4为27717 FF /34546 LUT原语/9552 ALU，v6为27903/34936/9603。该计数不同于vendor的等效LUT或物理CLS利用率；不将它换算为拥塞百分比。B0B4网表仅从清单绑定压缩件读取用于对照，没有进入候选综合/PNR；所有候选仍只使用各自新鲜网表。最终选脚依完整STA及实际route congestion，资源计数仅作补充。

22. v7只精简新增水上块定时：共用50000拍1ms使能，年龄/模式/确认宽度7/5/9，加16位节拍，共37位，代替旧69位。最低保持向上、超时向下取整，故障每拍清除；新鲜度99–100ms、低/高各500–501ms、模式至少25ms。生产分频测量、终值及七种相位/不整除等待/一拍故障/高位恢复测试通过，全部12项通过。一次飞行测试台漏设新缩放分频参数的失败保留，修正测试台后完整重跑通过。水上块少32FF/49LUT原语/5ALU；两路PWM不改。
23. v7八次P2/P3引脚试验均未合格。其中F18/F19 P3完整布线、vendor0，但setup−0.626ns、Fmax48.482MHz、hold+0.206ns；实际最差路径为几何高度字经height_fusion范围检查至原核心诊断CE。v2–v7共46条的完整失败矩阵另存，未把正常退出0等同于时序通过。v4增量B18/C18曾报0未布通却错误退出1，无完整STA；匹配率2.73%不足80%，工具实际回退普通流程。该项不标成增量执行成功或路由合格。
24. v8针对真实关键路径：原几何高度初值/清除为0，唯一正常发布在有符号pending_height满足0–5000的分支中，输出因此始终有界。height_fusion新增默认0的REF_HEIGHT_BOUNDED，仅该内部实例启用1，消除重复输入范围组合检查；其他调用者默认保留检查。几何发布保护和所有其他健康/事务/数值/ROM/FSM/公开周期保留。精确逆向审计覆盖整份导航/高度融合，生产者几何文件字节不变；它是RTL可达状态契约，未声称硬件故障注入或形式工具证明。
25. 修改前的完整导航比较及最终v8整套13项均通过：1042位公开输出2720105次逐拍比较，67次几何发布、4次高度发布、1213627个ready周期、95次重叠，每拍断言几何高度范围。使用实际共享数学服务，无force数据/控制/数值状态。一次300秒模拟器墙钟超时不计通过；最终同一测试完整结束。新鲜网表高度字至原core CE/RESET/SET在已建模LUT/ALU/mux图中的引脚对11662→0，物理STA仍独立验收。

26. 最终54条物理记录全部完成，只有v8 P3/R0的B18/C18、B18/C19及A13/A14合格。A13/A14峰值0.917、前十均值0.889低于两组B18的0.931/0.9128，按既定规则选中；Fmax50.032MHz，setup/hold+0.013/+0.169ns、recovery/removal/最小脉宽+12.660/+3.030/+7.387ns、setup/hold违例0。全部由原报告独立重读并校验artifact哈希，未沿用B0B4资格。setup余量小，不扩大解释为硬件或飞行已安全；没有新增时序例外。

证明边界：RTL包含缩放场景、生产计数终值/周期、完整七相位计时、真实50MHz PWM波形、实模块PPM到PWM联调、B0B4飞行适配器/MTF/完整导航有界逐拍对比。飞行对比使用相同传感器健康和已提交命令夹具，导航对比使用数字输入及实际共享数学服务；未验证物理IMU、动力学或实际闭环飞行。精确恢复审计界定所有数值/系数/状态机和允许的适配、缓存及生产者契约优化。图模型不是完整门级或形式证明，离线STA/IO/布线只对本次精确位流有效；实物资格不得从B0B4继承。本轮未打开串口、未操作下载器、未试转、未飞行。
