Scherrerll/acg720-fpga-flight-controller/firmware/B0B0/provenance/bound_evidence/d5dabda54de3_OPERATOR_NOTES.txt

B0B0 MTF诊断启动复位候选——当前离线待验，禁止编程

当前新候选尚未通过最终资格、完整布局布线或50MHz时序验收；仅在实际零未布线、50MHz setup/hold均通过，并冻结实际位流、源文件和证据哈希后，才能声明离线通过。父候选published_anchor_p2_r2_rep1的PNR失败，530条未布线且无FS；父证据仅作原来源上下文，不能冒充本候选的新仿真或新构建通过。

本版范围包括四项：前置声明修复，恢复综合后的freshness至PWM连接；导航720位遥测快照仅启用一次启动复位特例；两文件修复最后实际发布collective的接管锚点和故障后的混控选择；MTF976位遥测快照仅启用一次启动复位特例。两种诊断优化均保留INIT和默认调用者的运行时复位；仅在实际单次启动释放的top实例选择特例。新候选的1696位实际映射INIT、输出布尔映射/别名/掩码/CE、freshness及最终完整构建仍须通过对应的当前源绑定门槛；不得把原来源证明当作当前完整top仿真PASS。

高度、RC和IMU健康时保持原生导航和高度控制；核心控制文件与已审查父候选相同。原来源标称等价及定向证据保留，但健康高度下的实际电机输出回归仍待硬件验证，仿真不替代实际验收。

只有已解锁、已进入起飞状态并有合格自动指令实际发布后，高度丢失才允许接管。入口collective精确保留最后一次实际发布的1000..1850us原值；未发布pending请求不能成为锚点，已排队自动结果不能重新选入旧collective。随后由独立RC杆量控制，collective变化限为1us/ms。后续手动目标范围1200..1850us；1000..1199us入口保持原值，再按限速趋向目标，不瞬间抬到1200us。各电机输出仍经过姿态修正和原混控边界。

SWA停止、RC失效或IMU失效仍即时撤销输出，不等待油门斜坡。故障接管锁存；高度恢复不会自动返回高度控制，须停机/解除后按原流程重新解锁。

最低油门杆不是即时硬停。ch3<=1150且collective<1250，并满足原有延迟及持续计时后，由land_lock停机；需要立即停止时使用SWA。不得把最低杆着陆锁止当作即时硬停。

所有实际验收仍待完成：新鲜且已停止的设备身份确认、明确授权后的停止状态SRAM安装、健康高度输出回归，以及高度丢失、手动杆量、恢复锁存、最低杆land_lock和SWA/RC/IMU停止验收。保持已确认的拆桨条件；不重复光流校准或RC端点校准。本任务没有硬件或接收机更改，没有SRAM编程，没有Flash更改；默认Flash B0AC保持不变。DO_NOT_PROGRAM持续有效，任何离线通过也不构成下载或飞行授权。历史4S带载掉电问题仍未解决，飞行资格尚未获得。
