Scherrerll/acg720-fpga-flight-controller/firmware/B0B0/provenance/closure/固化与冷启动结果.md

# B0B0 固化与冷启动验证

已按操作者明确授权，将已测的 B0B0 写入外部 Flash。位流 SHA256：83653a2f405cc467ac553fd81ac57d2981c5a9f52543afbbd3368881ab4ac111。未改变固件源码或系数。

写入前重载 B0AC 并独立核对 Flash 内容与保存镜像相符；随后以地址 0x000000 执行 GW5AT-60B 对应的 Arora V 编程并校验（操作 54）。重载后 JTAG 与 CRC 遥测均确认 B0B0，再做独立 Flash 校验（操作 66），最后再次重载。USB 和 SiK 两路均恢复校准完成、姿态/MTF/导航有效及四路 1000 μs 停机。

B0AC 回退位流已经保存，SHA256：212f31daed0c96e71c4cd3f1e56a580cdc1b9d425a15ba391cf2a37e74e92c34。安装工具的 8 项离线拒绝条件、执行顺序和故障回退检查通过。首个尝试因 SWA 失控保护中档 1507 被拦下，Flash 未写；随后恢复低档，修正未改动设备时不应多做 SRAM 恢复的问题，再执行成功尝试。首个尝试和后续成功记录均保留。

固化成功凭据：flash_acceptance.json，原始程序输出与阶段快照保存在以下安装目录。
C:\Users\ScherrerL\Desktop\apple\routing_closure_20261024\bench\hardware\flash_install_20261024T042524_170748Z

## 电池单独供电冷启动通过

操作者确认已断开飞机电池和板上两根 USB、等待至少 10 秒，再仅接牢电池供电；电脑端 SiK 接收器保持连接。操作者确认四个电机始终未转。

软件观测到无线遥测中断 36.454 秒，随后 B0B0 FPGA 运行时间从 199 ms 重新开始，首次观测到校准完成的快照为 2999 ms。USB 在重启后的稳定观察窗口始终离线，验证链路仅使用 SiK 无线遥测。

校准后稳定观察 10.200 秒、38 个独立快照：四路命令/PWM 均为 1000 μs，未解锁，油门/SWA/SWC 低档；姿态、MTF 与高度/速度融合就绪。新增 1019 个模块报文，模块 UART/校验/长度/超时/重启/积分断点计数、控制器故障及门控中断/撤销计数均无新增。新启动期间 75 份独立 MTF 原始载荷重新解码，均与上报单位和符号一致。

完整凭据为 cold_boot_acceptance.json，采集观测记录和操作者确认保存在：
C:\Users\ScherrerL\Desktop\apple\routing_closure_20261024\bench\hardware\cold_boot_20261024T042756_919986Z

本轮布线、时序、增量离线证明、拆桨正常/失效接管、融合静止观察、四向纠偏、Flash 固化与电池冷启动已完成各自范围的验收。固件源码和原厂光流系数未改。不能据此保证带桨后正常飞行：带载稳定性、真实空中表现及光流旋转分量的严格资格验证仍未完成。下一阶段是受控的首次带桨低空验收；本轮没有执行或授权新的电机操作。
