Scherrerll/acg720-fpga-flight-controller/hardware/材料汇总.docx

1.小梅哥ACG720

重量：200g

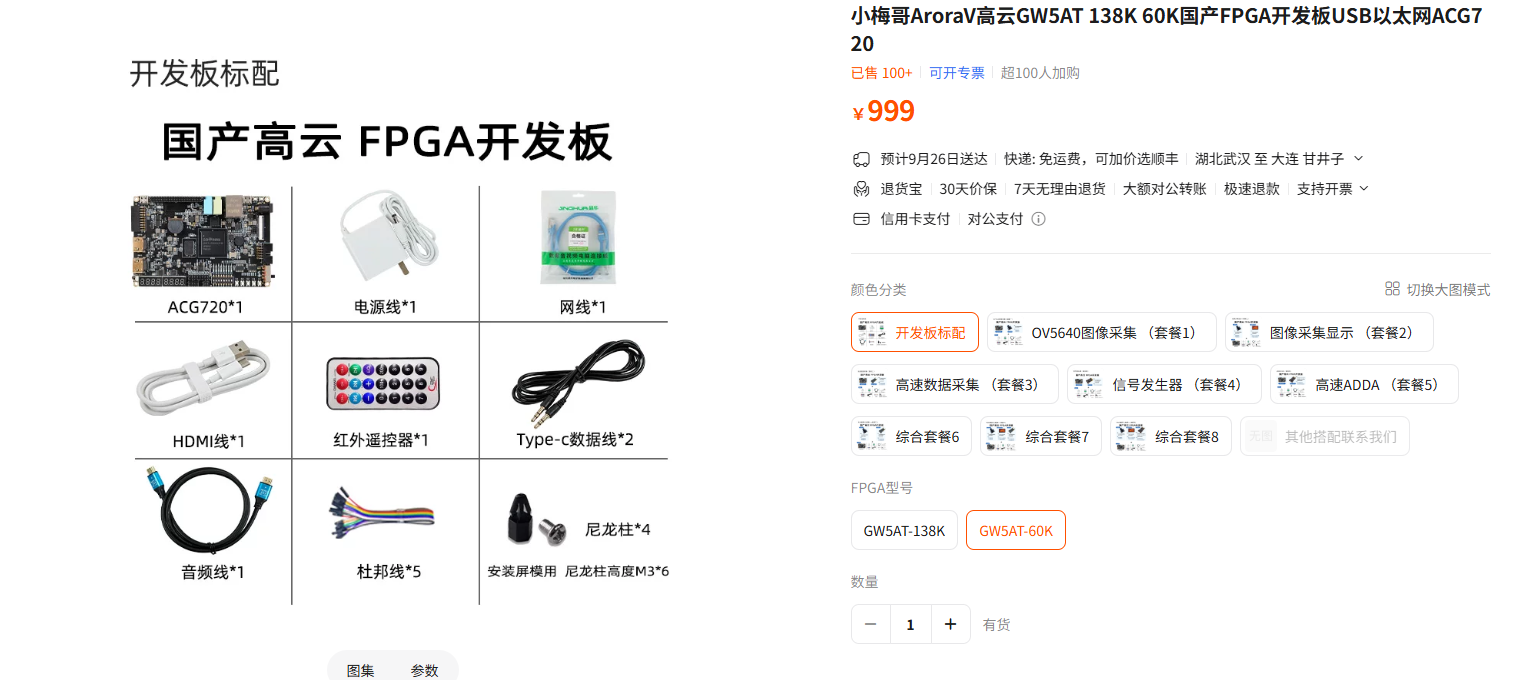
[picture p7: figure]

https://item.taobao.com/item.htm?id=849198089202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

2. ICM-42688-P 模块

重量：5g

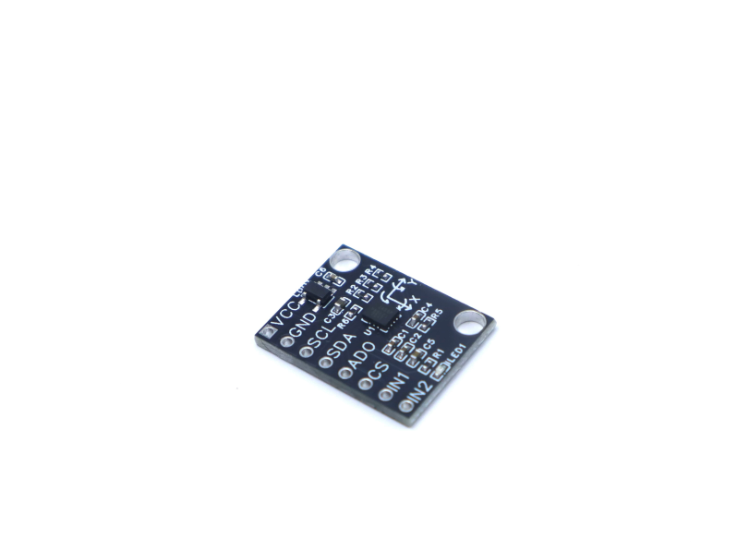
[picture p8: figure]

https://item.taobao.com/item.htm?id=910960145105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

3. PMW3901 光流传感器模块

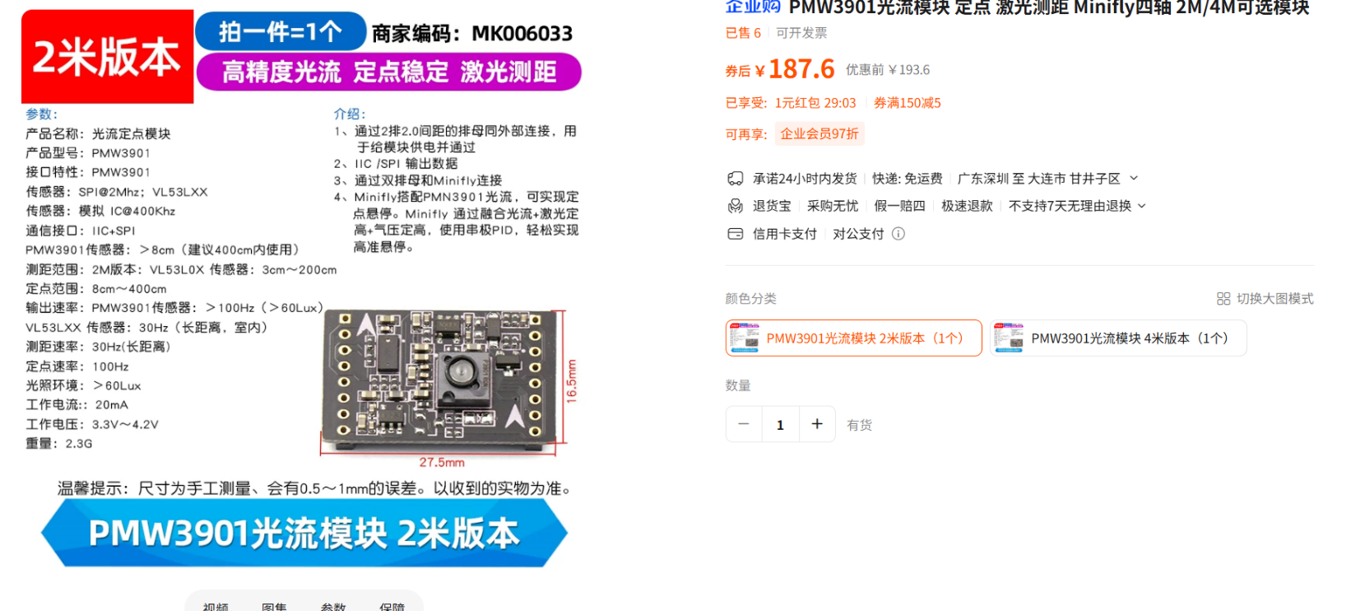
[picture p9: figure]

重量：2.3g

https://detail.tmall.com/item.htm?id=585754830280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

4. 北醒TFmini-S激光测距传感器

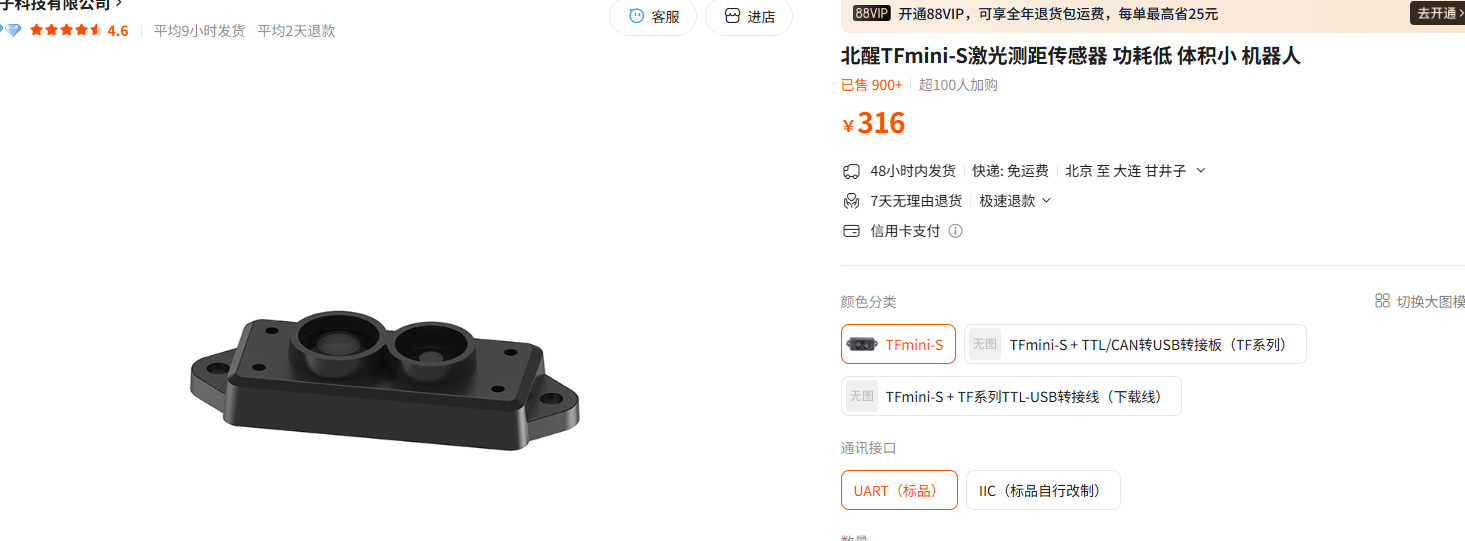
[picture p10: figure]

重量：5g

https://item.taobao.com/item.htm?id=613248440201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

5. Holybro SiK Telemetry Radio V3 数传电台

重量：21.1g

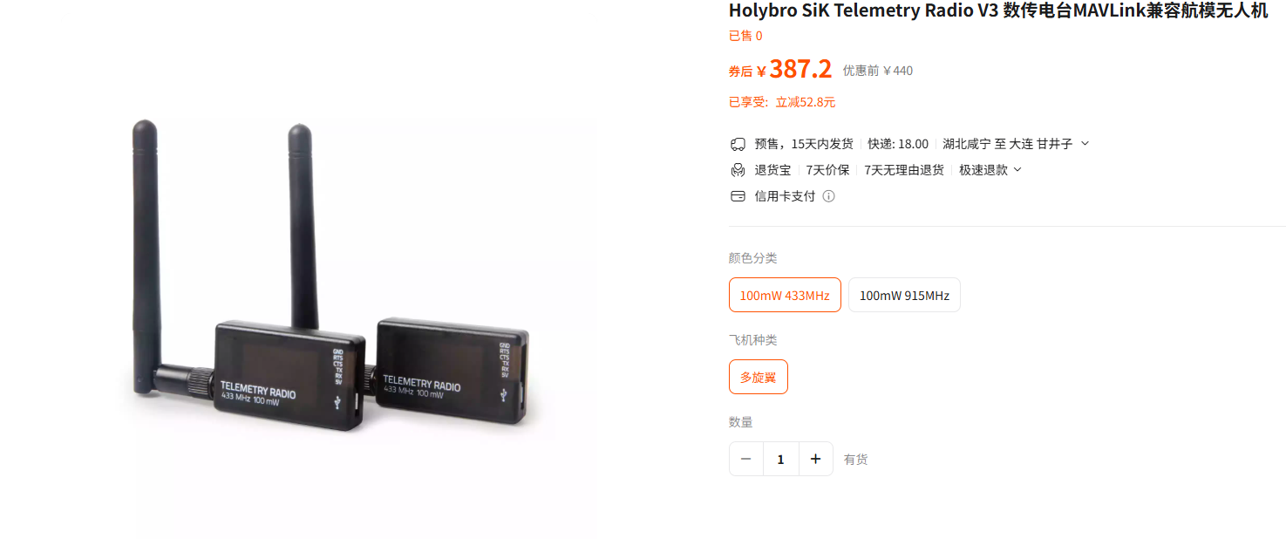
[picture p11: figure]

https://item.taobao.com/item.htm?id=971545989536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

6.d435i相机

重量：75g

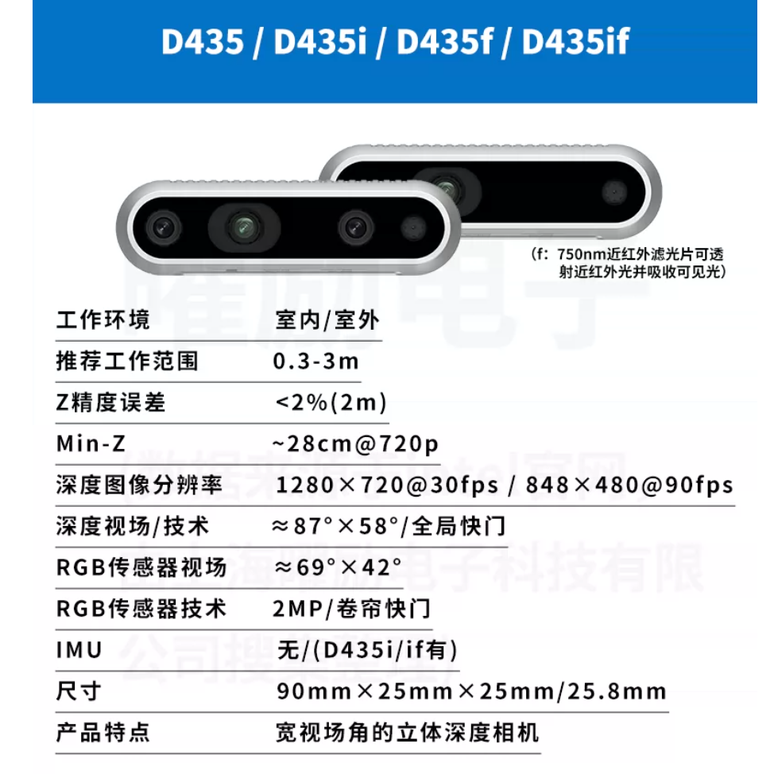
[picture p12: figure]

https://item.taobao.com/item.htm?id=632116160748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

7. TMOTOR AIR GEAR 450II 四轴多旋翼动力套装

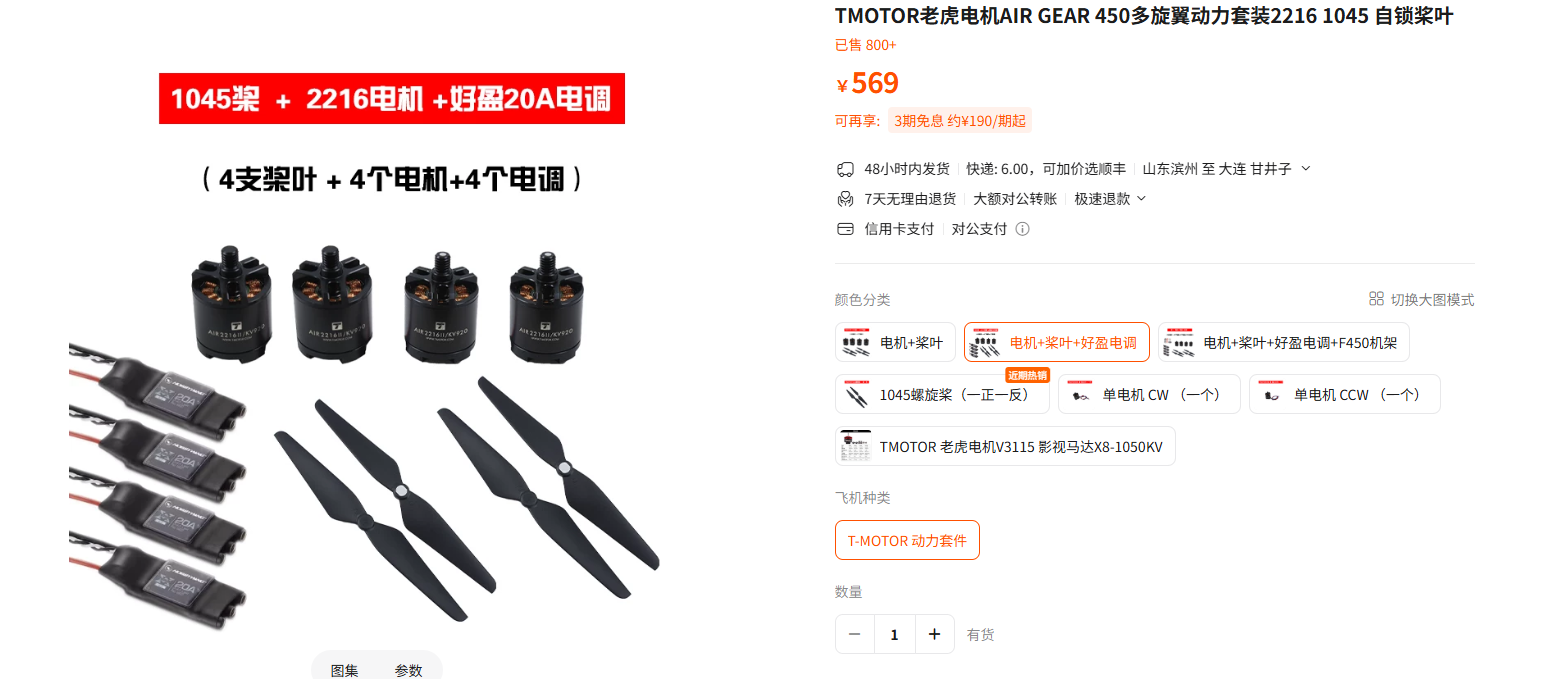
[picture p13: figure]

重量：408g

https://item.taobao.com/item.htm?id=716237885188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

8.电池

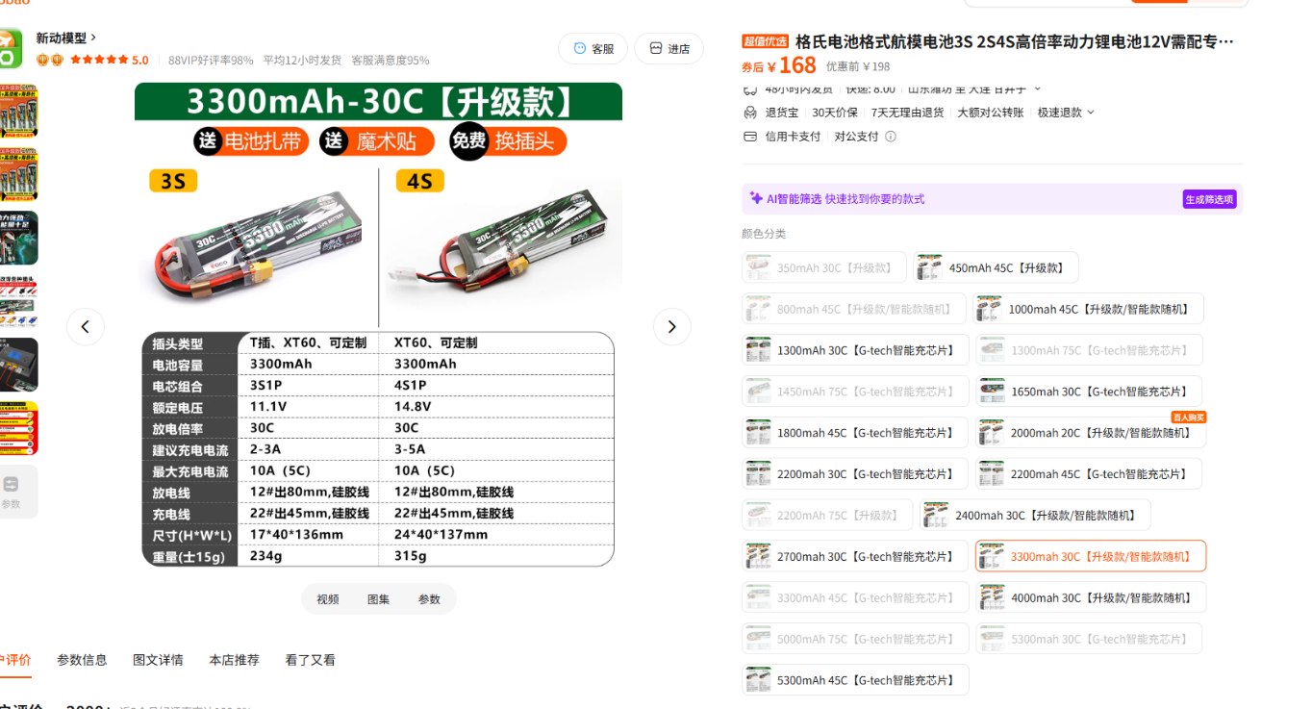
[picture p14: figure]

重量：234g

https://item.taobao.com/item.htm?id=41728701920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

9.降压模块

重量：5g

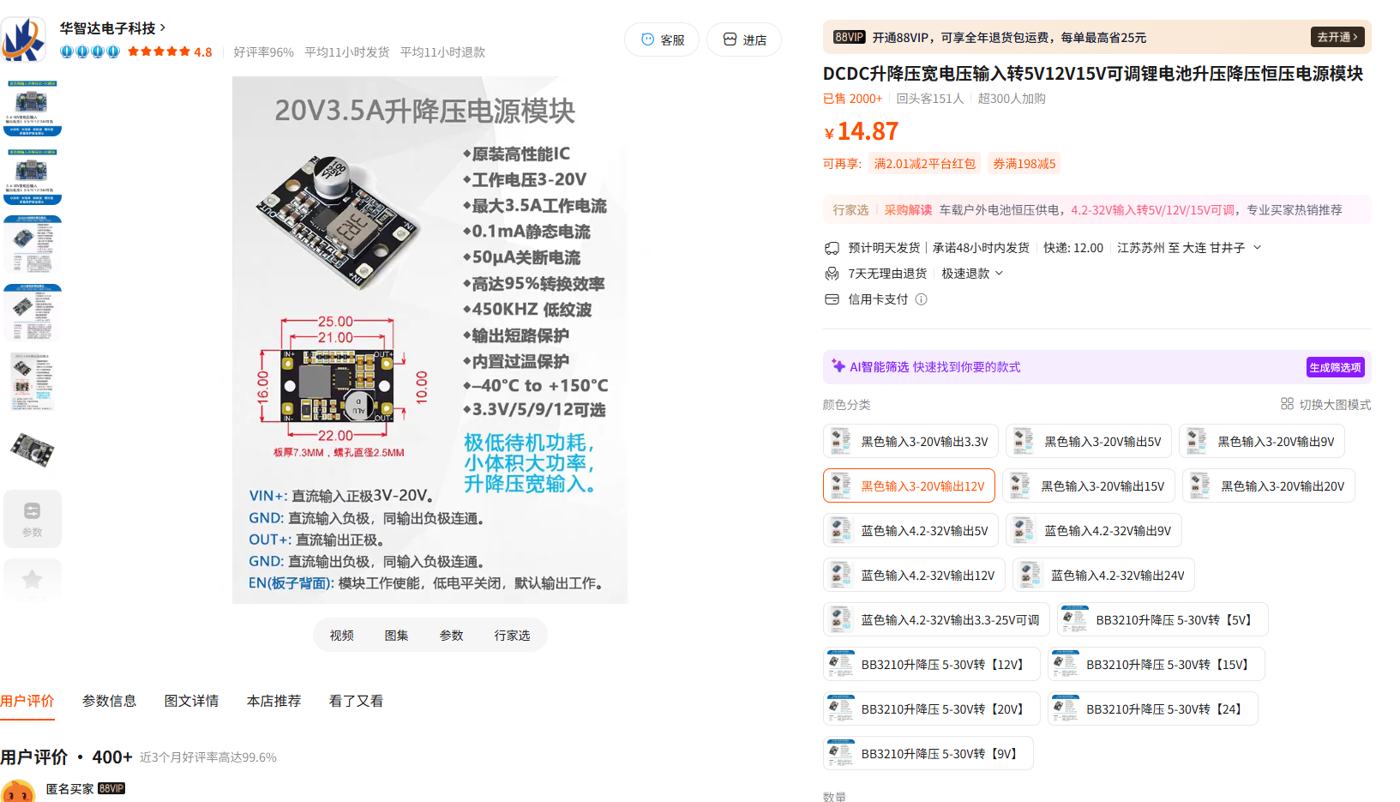
[picture p15: figure]

https://item.taobao.com/item.htm?id=893314501844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
