Scherrerll/acg720-fpga-flight-controller/firmware/B0B2/hardware/v15_stick_oscillation_20261025/aligned_telemetry.csv

epoch | sequence | utc | elapsed_s | uptime_ms | build | flags | armed | enabled | taking_off | roll | pitch | tr | tp | gx | gy | gr | gp | throttle | ch1 | ch2 | ch4 | ch7 | cx | cy | cz | pwm_min | pwm_max | height | zcollective | zactive | xyactive | xyready | xyreason | navflags | navreason | age | flowready | roll_target_nav | pitch_target_nav | range_mm | flowquality | flowvalid | flowstatus | accepted | rejected | faults | imu_reason | attitude_fault | wx | wy | accel_flags | checksum | uart | module_missing | module_restarts | body_vx | body_vy | world_vx | world_vy
9 | 1376 | 2026-10-25T13:35:00.023069+00:00 | 16020.613498099992 | 275400 | 45234 | 15 | False | False | False | 0.75 | 3.37 | 0.0 | 0.0 | -0.06097560975609757 | 0.0 | -0.030458031631097563 | -0.0657542158917683 | 1002 | 1499 | 1501 | 1500 | 1000 | 0 | 0 | 0 | 1000 | 1000 | 212 | 0 | False | False | True | 1 | 191 | 1573632 | 1 | True | 0.0 | 0.0 | 212 | 117 | True | 1 | 275182 | 0 | 0 | 0 | 0 | 3 | 20 | 3 | 0 | 0 | 0 | 0 | 0.0 | 0.0 | 0.0 | 0.0
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
