Scherrerll/acg720-fpga-flight-controller/firmware/B0B2/hardware/v15_unarmed_rotation_20261025T141628_867271Z/paired_response.csv

t | sequence | pair_sequence | pair_time_ms | roll | pitch | height | gx | gy | vx | vy | cumulative_x | cumulative_y | module_sample_count | module_time_ms | integration_breaks | quality | flow_status | mtf_sequence | exposure_time_aligned
0.0005283999780658633 | 403 | 8066 | 80792 | 0.71 | 3.38 | 234 | -0.05633098323170732 | 0.06073742378048781 | 0.0 | 0.0 | -111.098 | -980.794 | 8066 | 87498 | 1 | 67 | 1 | 403 | False
0.34879910000017844 | 405 | 8106 | 81193 | 0.7 | 3.38 | 232 | -0.06815096227134147 | 0.08537478563262196 | 46.4 | 1067.2 | -108.754 | -952.85 | 8106 | 87898 | 1 | 81 | 1 | 405 | False
0.673237099981634 | 406 | 8126 | 81393 | 0.71 | 3.39 | 239 | -0.022463914824695123 | -0.017342916349085368 | 0.0 | 239.0 | -107.34 | -932.658 | 8126 | 88098 | 1 | 72 | 1 | 406 | False
0.8424892000039108 | 407 | 8146 | 81594 | 0.71 | 3.4 | 236 | 0.08387123666158537 | 0.05761123285060976 | 0.0 | 0.0 | -105.438 | -860.466 | 8146 | 88298 | 1 | 73 | 1 | 407 | False
1.0119578999874648 | 408 | 8166 | 81794 | 0.71 | 3.39 | 238 | -0.042605516387195126 | -0.11108398437500001 | 0.0 | -47.6 | -105.914 | -858.094 | 8166 | 88498 | 1 | 71 | 1 | 408 | False
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
