Scherrerll/acg720-fpga-flight-controller/analysis/20261026_z_aw_fix/build/compact_aw_v13/PROOF_REPORT.md

# v13：MTF 同拍年龄谓词

相对 v12 只改 sensor/mtf01p_reader.v 中两个既有年龄比较。32 位年龄计数、饱和值、重复时间戳不刷新的规则、样本计数、接口、解析器、度量算术和诊断 hold/reset 均保留。初始化/reset、真正新时间戳发布和普通非饱和 tick 分支同时更新年龄与两个谓词；年龄达到 200/1000 的同拍撤销条件，新时间戳归零的同拍恢复条件不变。

两份实际完整源经真实 UART 输入，每个模式运行 1,200,513 拍，每拍比较全部 1,140 个公开位、完整年龄和在线/新鲜度条件。两个模式分别覆盖默认及当前顶层诊断配置，包含 hold、非零速度和积分、有效帧、重复时间戳、坏校验、帧错误、错误长度、帧超时、199/200 与 999/1000 边界及恢复。每个模式均有两类精确过期边沿、6 次年龄归零恢复、15,451 拍非零积分状态和 375,160 拍 hold 输入；完整 reader 无内部 force 或预置。

为可行地运行毫秒超时，完整 UART 模拟使用 CLOCK_HZ=1,152,000（10 拍/串口位），并未改变交付的 50 MHz。独立从两份真实源抽取年龄块，用夹具重种任意已知 32 位年龄及一致谓词，然后执行原始单步转移，检查不变量归纳闭包。105,632 组边界/随机/四态控制输入通过，覆盖 MAX−1→MAX、MAX 保持、重复/新时间戳和复位优先级。该夹具只对抽取年龄块设置归纳前提，不声称任意破坏完整 DUT 内部状态后等价。

新 top13 通过。全部 7 阶段和证明根驱动均有真实 wait0；6 份初始刺激哈希不变，v12 证明绑定中的 76 份原证据重新核验。其余 54 文件与 v12 完全相同，控制器、融合、AZ 生产者与数学服务按精确依赖复用通过证明。见 PROOF_BINDING.json 和 proofs/inputs.json。

本次完整顶层综合 vendor/runner 真实退出 0。严格全部 FF clk50、radio 同步边界、18 个标量端口、默认 wire1000/350 增益审计通过。精确网表 SHA256 为 001eca6c8a3e4f21e7d7fe84e33601bef9692d5fba739bff9fccb3b4c6ca639a。FF27756、LUT36224、ALU9544，较 v12 为 +4FF/+4LUT，DSP/BSRAM 不变；新增两位的源级数量不等于全局映射资源差值。

选定的实际映射中，年龄位21到遥测814/97的 D 输入组合拓扑由14/15级降至11/11级；新200ms谓词到两端点为11/12级，新1000ms谓词未连通到所选这两个组合端点。年龄位21到两个新位D为3/4级，至其 CE 的拓扑仍为11级。全部 LUT 输入弧均计入，这是拓扑上界，不是敏化路径或延迟证据。见 MAPPED_MTF_AGE_CONE_REVIEW.json。

P3/R0 与 P2/R0 均从同一精确新网表启动，原50MHz/20ns约束、18引脚和唯一 radio_rx 输入 falsepath 不变。仍须完整布线/位流、五类余量非负、setup/hold端点0、正常真实退出和独立 raw 报告复核。此报告不授予物理下载资格；没有安装、冷启动或飞行验收声明。低空前飞掉高仍在本轮范围外，固定传感器仿真时间不是飞行着陆等待指令。
