Scherrerll/acg720-fpga-flight-controller/analysis/agent_reviews/v20_dsp_physical_independent_20261027/README.md

Revision02 的独立准备审阅已通过，没有需要继续处理的问题。

独立审阅核对了实际 VG 宏名和类型的官方 52→41 筛选（39 DSP、2 BSRAM，排除 11 项）、55 份源码、原 1891 B CST 前缀、5589 B combined 及其 project 选择、唯一新增的 cst_warn_to_error1、原 helper 调用，以及 23 项独立原始检查。当时 standard v20 仍在运行，thin runtime 尚不存在，receipt 目录为空。

初审发现的 seal/snapshot 状态标记缺口已在 revision02 修正。审阅时从实际脚本独立抽取纯函数和调用表达式，验证了 1183 组真值、2366 次表达式，全部通过，实际检查进程退出码为 0。旧 revision20 和新 revision34 文件均已复核，当前 737 个绑定输入已重新计算哈希；原准备记录和首轮测试夹具失败记录均保留。

`REVIEW.json` 只批准本次准备的 recipe，后续是否启动由主执行方根据 standard 结果安排。此次没有执行绑定脚本的顶层代码、创建 runtime、启动 vendor 或访问硬件，也没有给出物理资格结论。
