Scherrerll/acg720-fpga-flight-controller/analysis/20261026_z_aw_fix/build/compact_aw_v11/PROOF_REPORT.md

# v11：同拍发布年龄谓词验证

相对v9仅修改高度融合一文件，所有55输入已冻结；控制器仍为v4宽状态/压缩MA34及MB28实现。新增状态位在每个年龄赋值点按原优先级保存更新后年龄的原比较式，初始化、饱和保持、cleanup和发布覆盖均纳入归纳不变量，超时撤销同拍发生。

真实完整融合差分：RANGE_AGE_PRECHECKED=0/1两模式分别1686784/1508078拍，每拍比较公开152位、请求228位、真实数学服务135位、sources_ok、32位年龄，以及新位等于旧年龄原谓词；全部相同。原数值边界、发布阶段坏az即时撤销、epoch取消及算术中复位保留。六组AGE=1/31/65536测试另872442拍，原阈值前最后一拍有效、阈值本拍无宽限、发布本拍恢复、取消后重发布均通过；16位进位案例仅在模块数学响应边界施加停顿，不强制或预置DUT内部状态。共4067304拍；这不是任意内部寄存器破坏后的等价声明。

完整top13保护门通过，沿用已注明的core依赖/解码RX输入force夹具。五场景、FRAC0/16与四客户端非零XY/Z积分按六个完全相同依赖哈希复用v9真实通过记录；生产者范围标志未改。所有17阶段及proof root真实wait0，详见PROOF_BINDING.json。

初始inputs.fixtures将运行器实时日志也索引为启动快照。最终绑定只把四份.v与top/run.py列为冻结刺激，五者前后哈希完全相同；原快照不改。封装器Windows路径过滤遗漏top驱动导致一次封装失败，随后未检查前序失败的PowerShell块触发一次脚本尚不存在的空综合启动；全部记录保留在SEAL_AND_EMPTY_LAUNCH_CORRECTION.json。修正仅涉及元数据封装和分步检查，未重写模拟结果或补造退出码。

正式SYN retry02一次完成；vendor/runner真实0，全FF clk50、radio同步边界、18scalar引脚、P/I wire1000/350审计通过。新VG f239c61b25007920c57057d8b5f1a34b3b63b4acfa7e19f60acc8f1f6a489d43；相对v9实测FF+7、LUT+789、ALU+3，DSP/BSRAM不变。源码新增一位不等于映射仅增加一位；资源和路径收益必须以实际报告为准。

精确VG中确认publication_fresh_s1为INIT0的DFFRE，时钟别名归于clk50。选定age10→manual_angles/pending_np路径的映射组合拓扑由v9的18级变为v11新位起点15级；age10→新位D有10级。这里只是全LUT弧的拓扑上界，不是敏化路径、延迟或STA资格，详见MAPPED_AGE_CONE_REVIEW.json。

P3/P2物理试验单独使用精确新VG，不重跑综合，不引用旧Fmax取得资格。仍须完整路由、真实20ns、Fmax≥50、五类余量非负、setup/hold端点0、18引脚/B4位流身份及真实正常退出，随后独立解析raw TR。当前没有下载或飞行验收声明。固定传感器模拟时间不是实机着陆等待建议；低空前飞掉高仍在范围外。
