Scherrerll/acg720-fpga-flight-controller/analysis/20261026_z_aw_fix/build/compact_aw_v12/PROOF_REPORT.md

# v12：下一年龄比较的等价改写

相对v11只改高度融合普通年龄自增分支的一条比较式，保留全32位年龄及饱和值、原赋值优先级、发布/cleanup、所有控制器/数学服务与54个其他文件。非饱和分支中A+1不溢出，L=0单列；其余按原32位无符号比较化为A<L−1。没有改变超时周期、算法系数、精度、PID步长或实时撤销。

从两份实际源提取的表达式，在原integer参数类型下对九种阈值（含0、1、31、65536、5000000及有符号高位/最大值边界）、200040组32位边界/随机向量比较通过。饱和值不属于自增分支，单独沿用原保持语义；不声称任意破坏内部年龄或不变量后的X状态等价。

真实完整融合差分仍为两种RANGE_AGE_PRECHECKED模式、六组AGE=1/31/65536同拍超时/恢复/取消用例，共4067304拍；每拍检查公开152位、请求228位、真实数学服务135位、sources_ok、全32位年龄和新鲜性不变量。无需强制或预置DUT内部状态。top13使用原已注明core依赖/解码RX输入force夹具。全部19阶段及proof root真实wait0，六份刺激从初始到结束哈希一致。见PROOF_BINDING.json。

控制器六依赖与v9完全相同，五场景、FRAC0/16及四客户端非零XY/Z积分复用其真实通过记录；原生产者范围标志未改。普通未饱和回调保持原P2算式；阻止继续推向饱和的积分是本轮有意行为变化。共享水平开机P=0.1000/I=0.0350，generation0，SET仍易失。固定传感器模拟时间不是飞行着陆等待指令。

一次新full-top SYN完成，vendor/runner真实0；全FF clk50、radio同步边界、18scalar引脚及wire1000/350默认增益审计通过。精确VG为f18ac77212a4b17ded9c5a6025a034dda91f8af8d13ca77bbf12caaa033eb0c1。FF27752/LUT36220/ALU9544，较v11为−6FF/−792LUT/−3ALU，较v9为+1FF/−3LUT/ALU相同；DSP/BSRAM不变。高度局部与跨模块映射均须实测，不能将所有资源差值归因于单个算式。

精确VG中age10→新位D的组合拓扑10→5级，新位→选定manual_np路径15→14级，见MAPPED_AGE_CONE_REVIEW.json。这是含全部LUT输入弧的拓扑上界，不是敏化路径或延迟证据。

P2先行并安排P3独立物理试验，均复用精确新VG，不重跑综合。验收仍要求完整路由/位流、实际20ns、Fmax≥50、五类余量非负、setup/hold端点0、18引脚/B4身份、真实正常退出及独立raw TR复核。当前不声明下载、冷启动或飞行验收；低空前飞掉高仍在范围外。
