Scherrerll/acg720-fpga-flight-controller/analysis/20261026_z_aw_fix/build/compact_aw_v8/PROOF_REPORT.md

# v8 同拍 az 范围标志：离线证明

候选以v7为基线，只改pose_time_adapter、顶层连线、导航谓词接收和高度融合谓词接收四文件。控制器、共享运算、Q16和默认P=0.1000/I=0.0350不变。

生产者真实RTL差分444003拍，11022次发布；6199次发布越界值、2066次发布X/Z不确定值，7117个fault周期、12388个cancel周期。所有旧输出逐拍4态相等，范围标志逐拍等于同一输出az的原比较式。没有私有force或预置内部状态。复位/取消发布0与flag1；正常发布同时取held_az与其谓词；其他分支两者保持，构成源级归纳不变式。

真实高度融合、乘除服务与旧v7差分：PRE0为1686784拍、PRE1为1508078拍，共3194862拍。每拍比较152个公开位、228个请求位、135个服务位及sources_ok；共49次发布。每组4次坏az在实际发布边界立即撤销并阻止提交，每组5次epoch/有效性变化；两种年龄检查路径均覆盖。该测试通过输入谓词保证生产者契约，生产者契约由前项独立验证。未改变任何高度/控制状态机或发布周期。

实际顶层13项保护门通过，含同时解锁和参数提交拒绝。该夹具沿用原有公开记录的核心依赖force，仅证明所述门和连线。Z抗饱和五场景、控制器宽度边界和四客户端测试依赖文件均与v7相同，按精确哈希复用，不作无理由重跑。

最初驱动在PRE0仿真exit0后，因日志额外含vvp的`$finish called`提示，整段fullmatch解析失败，原runner实际exit1。原收据与脚本保留；completion02改为验证唯一PASS行，仍强制真实仿真exit0，复用已完成阶段，只运行未完成的PRE1和top13。completion02最终runner真实exit0。更正记录见ORCHESTRATION_CORRECTION.json，不补造历史返回码。

上述为有限轨迹和源级契约证明；综合、物理时序、地面/冷启动和着陆实效仍需分别验收。不能以固定传感器仿真时间指导实机等待。
