Scherrerll/acg720-fpga-flight-controller/analysis/20261026_z_aw_fix/build/compact_aw_v9/PROOF_REPORT.md

# v9 行为与综合验证

v9保留曾完整布通的v4抗饱和控制器（hold ffddb029…），只加入逐字节相同的v8生产者范围标志四文件。与v8相比，回到较宽的num/value/I/bias存储；64位运算、Q16精度、状态机和发布周期不变。该取舍是为了检验已布通逻辑基线配合真实关键路径修复的物理结果，不以资源最少作为选择标准。

五场景重新完成5/5，每个仿真及批次真实exit0：自然上饱和/最低杆恢复、400次未饱和回调等价、自然下饱和/正向恢复、取消及重入边界、XY I=0不关闭Z积分。实际RTL与共享数学服务运行，无私有force/预置状态；固定传感器场景不是飞行或着陆等待时间。

FRAC0/FRAC16边界、顶层13项保护门、四客户端非零XY/Z积分争用也全部真实exit0，最终proof runner真实wait0。边界逐拍比较公开控制/安全/归一化输出和请求状态，核对实际消费运算；顶层夹具沿用其已注明的核心门依赖force。生产者444003拍不变式及高度融合3194862拍证明按完全相同源码和运算依赖哈希复用v8结果。

第一轮验证启动器漏改自指文件名，编译和仿真尚未执行即exit1。原回执保留；retry02新目录仅修正该路径，再执行所有未开始验证。见PROOF_LAUNCH_CORRECTION.json，不把启动失败改写为功能通过。

一次新SYN及网表审计通过，vendor/runner真实wait均0。精确VG为e99d1ec0928fa9c1650cbc6a7ac9c08d4b2ef0758cdb3a9eec11b04af5d0eb20。资源FF27751/LUT36223/ALU9544；相对v4为FF−15、LUT+10、ALU不变。全FF clk50、radio同步器、默认wire1000/350和18端口审计通过。

普通未饱和回调仍沿用P2算式；饱和时有意阻止继续推向饱和的候选积分，反向消积允许。同一个选中积分用于状态提交与输出，保留原rails、RC/倾角/高度保护和落地判据。最初抗饱和实现增加两拍40ns，v9范围标志不再增加延迟。共享水平开机P=0.1000/I=0.0350，手动SET仍易失。

物理实现另行验收：全新P3R0与复制v4数据库的增量P3R0，均使用新VG和55源指纹。v4的49.456MHz/−0.220ns仅作为布局参考，不沿用其时序。增量若出现PA2136低匹配自动回退，独立runner通过自己创建的Popen句柄精确取消重复普通流程，并保存真实wait。

本报告不赋予下载资格。必须新完整布通、五类slack非负、setup/hold端点0、50MHz、18引脚和B4身份及正常退出全部通过，再独立复核raw。实体下载、完全断电及实际着陆效果仍分别验收。

实际增量试验匹配率2.75%，PA2136低于80%阈值，runner通过自己的Popen句柄取消自动回退的重复普通流程。vendor/runner实际wait1/1，原PR及复制件SHA保持不变；该项分类为取消，不是正常完成、增量成功或产品route失败。空出的计算名额用于原v4精确VG的P2R0，只变物理布局、不重新综合或改原源码；与v9全新P3R0并行，最多两项实际物理计算。
