Scherrerll/acg720-fpga-flight-controller/assets/branding/gm-fly.png

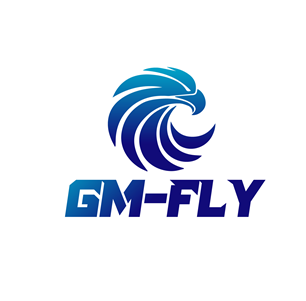
assets/branding/gm-fly.png
