Scherrerll/acg720-fpga-flight-controller/firmware/B0B2/hardware/v15_reported_flight_20261025T134349_719530Z/frame_00_000048.jpg

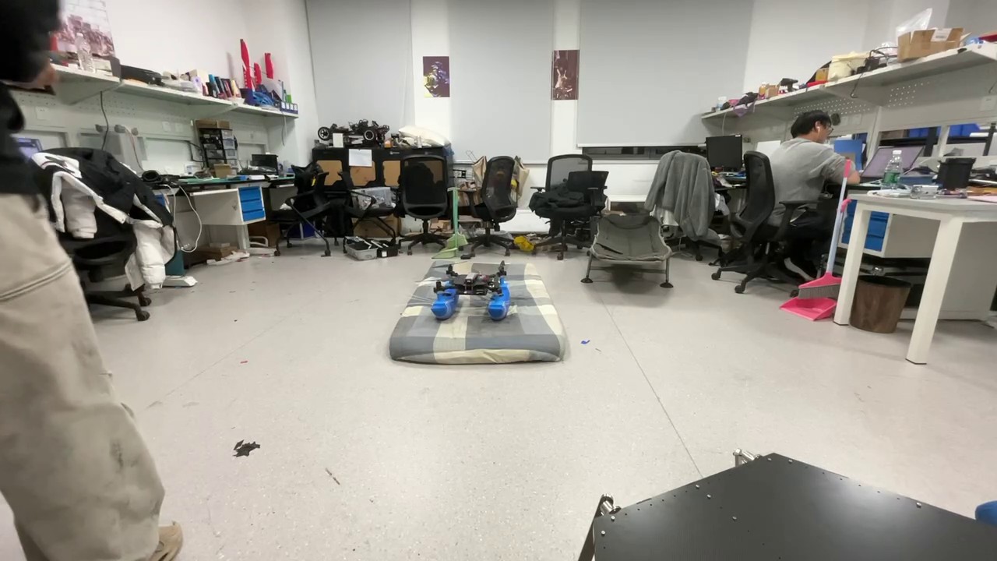
firmware/B0B2/hardware/v15_reported_flight_20261025T134349_719530Z/frame_00_000048.jpg
