Scherrerll/acg720-fpga-flight-controller/firmware/B0B2/hardware/v15_reported_flight_20261025T134349_719530Z/frame_02_000431.jpg

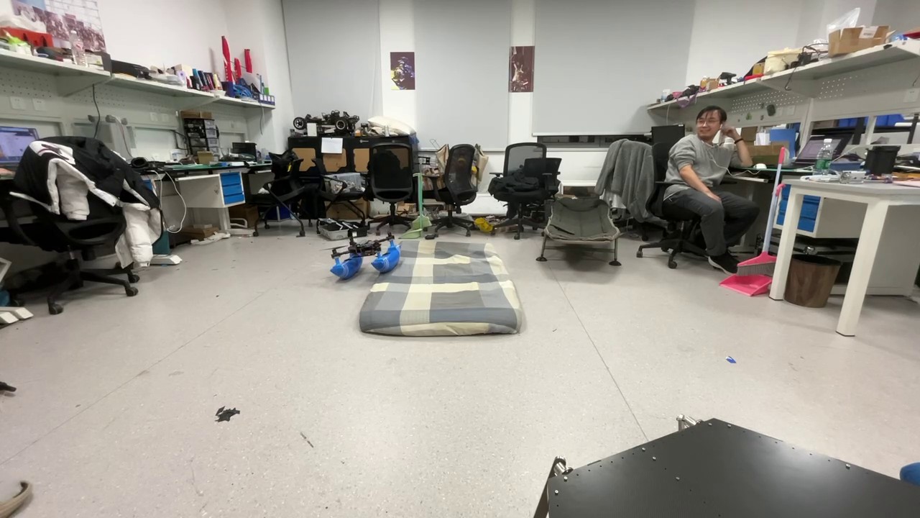
firmware/B0B2/hardware/v15_reported_flight_20261025T134349_719530Z/frame_02_000431.jpg
