Scherrerll/acg720-fpga-flight-controller/firmware/B0B2/hardware/v15_reported_flight_20261025T134349_719530Z/review_contact_sheet.jpg

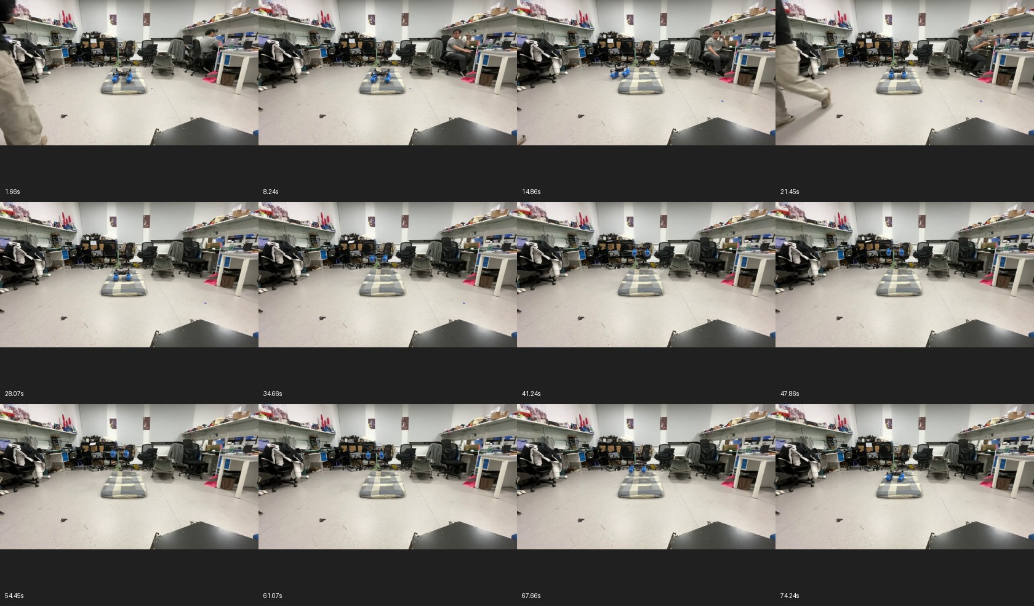
firmware/B0B2/hardware/v15_reported_flight_20261025T134349_719530Z/review_contact_sheet.jpg
