Scherrerll/acg720-fpga-flight-controller/firmware/B0B2/hardware/v15_stick_oscillation_20261025/review_frame_04.jpg

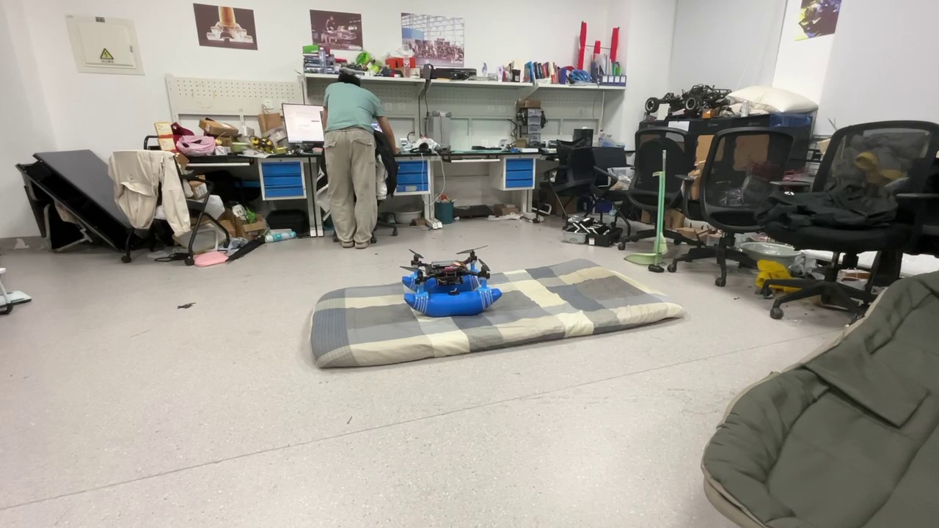
firmware/B0B2/hardware/v15_stick_oscillation_20261025/review_frame_04.jpg
