Scherrerll/acg720-fpga-flight-controller/firmware/B0B2/hardware/v15_stick_oscillation_20261025/video_contact_sheet.jpg

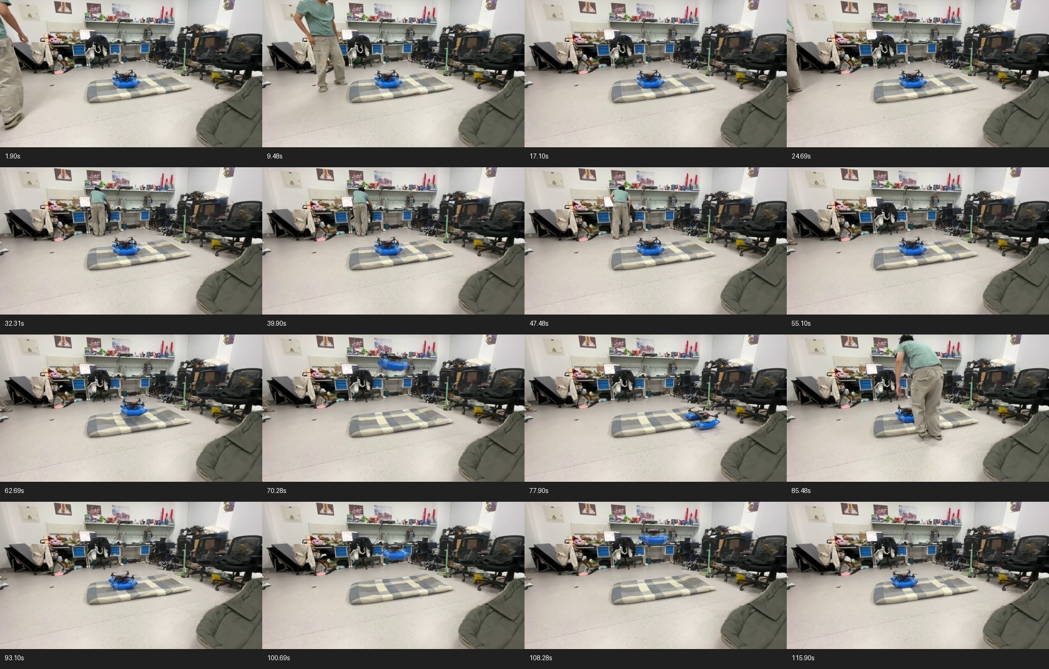
firmware/B0B2/hardware/v15_stick_oscillation_20261025/video_contact_sheet.jpg
