Scherrerll/acg720-fpga-flight-controller/firmware/B0B2/hardware/v15_unarmed_rotation_20261025T141628_867271Z/response_overview.png

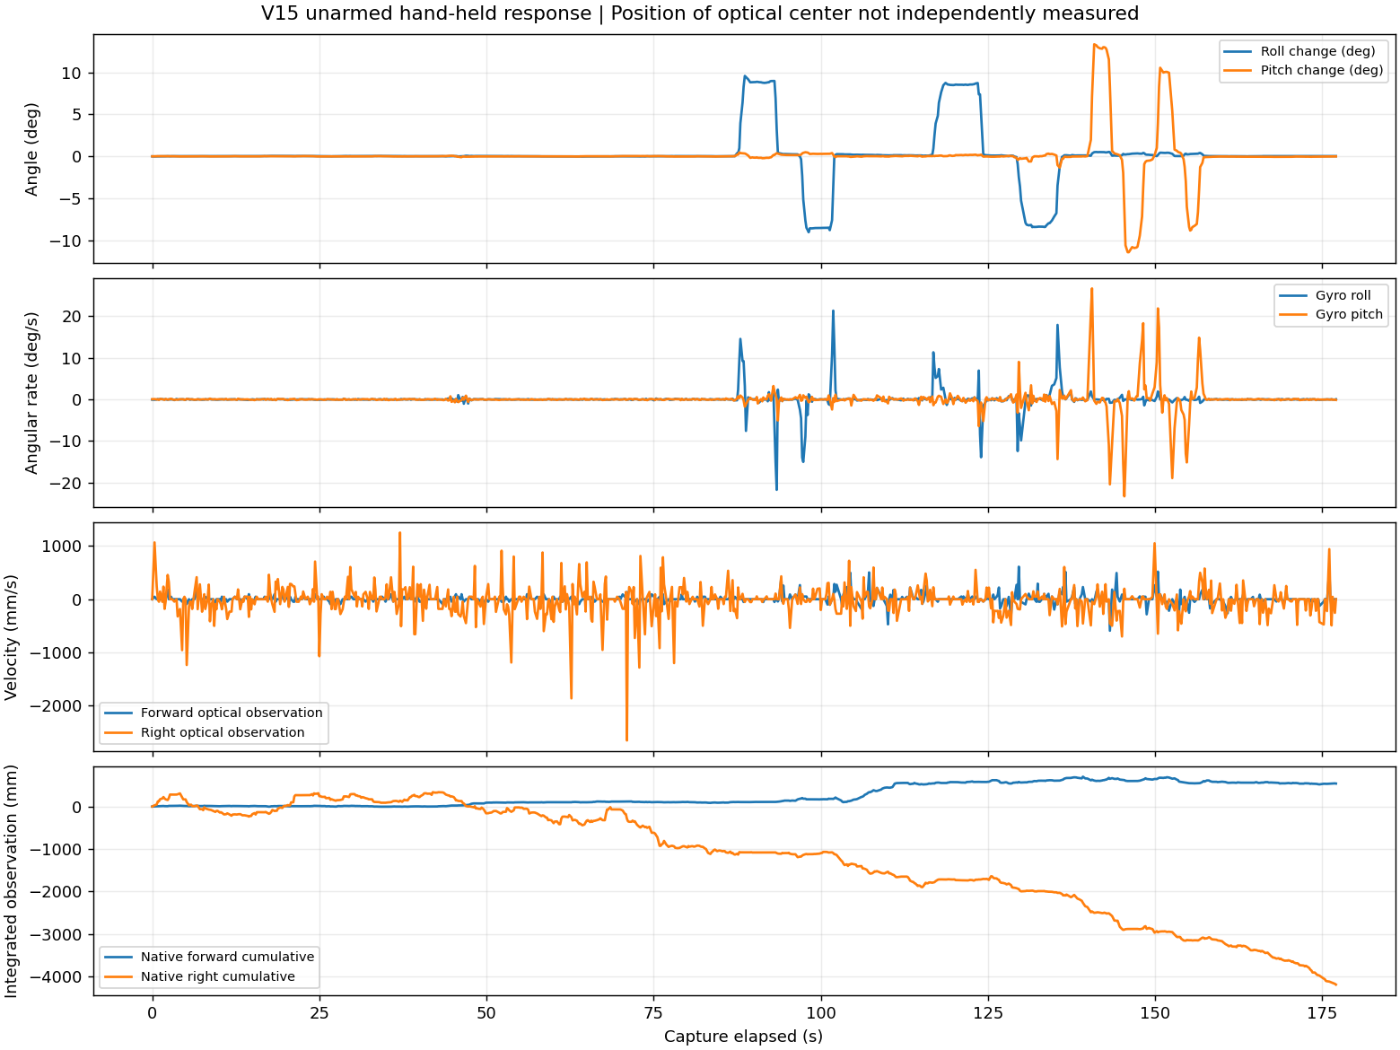
firmware/B0B2/hardware/v15_unarmed_rotation_20261025T141628_867271Z/response_overview.png
