Scherrerll/acg720-fpga-flight-controller/mechanical/cad/装配体1.SLDASM

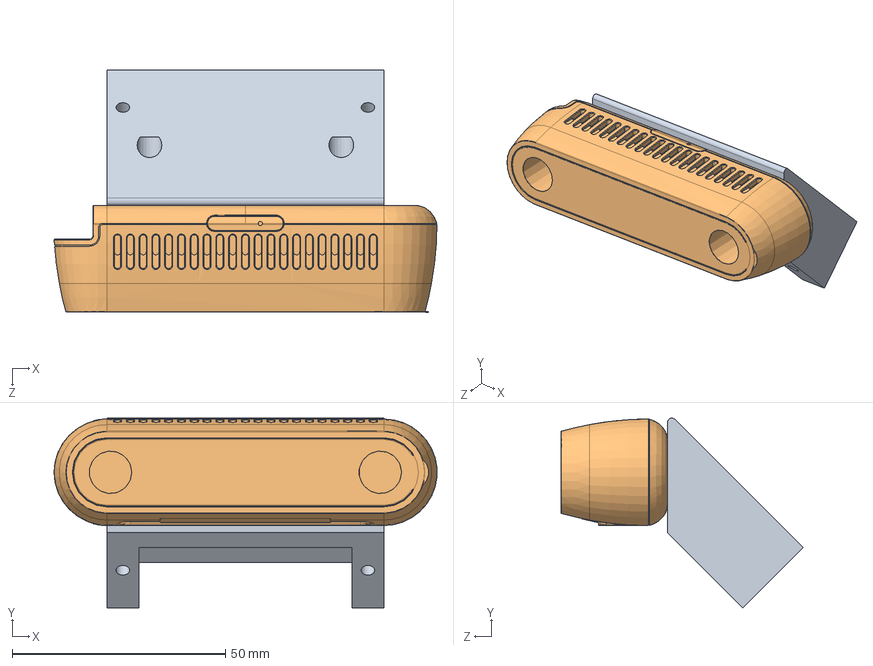
[picture p31: CAD file, 2026-10-22]
mechanical/cad/装配体1.SLDASM
89.9 x 44.5 x 56.9 mm
D435i
d
