Scherrerll/acg720-fpga-flight-controller/mechanical/cad/20008. YBX-BMI088(SPI)惯性测量单元传感器模块/3D模型/YBX-BMI088 (SPI) v1.0.step

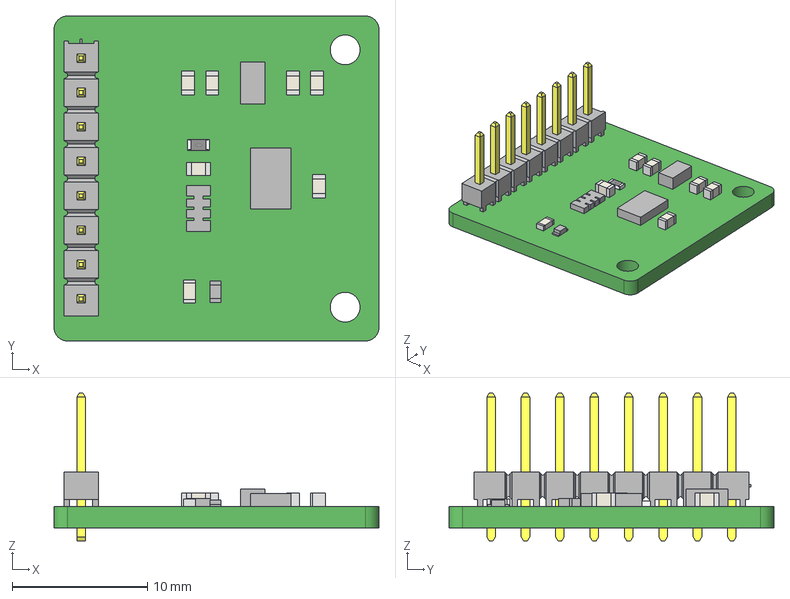
[picture p32: CAD file, 2026-10-22]
mechanical/cad/20008. YBX-BMI088(SPI)惯性测量单元传感器模块/3D模型/YBX-BMI088 (SPI) v1.0.step
24.0 x 24.0 x 10.9 mm
Extruded x 26
_TSW-108-07-F-S_body
_T-1S6-07-TSW-1-07-8-S
R 0603
LOGOԲ
