Scherrerll/acg720-fpga-flight-controller/mechanical/cad/发加工/无人机底板2mm.STEP

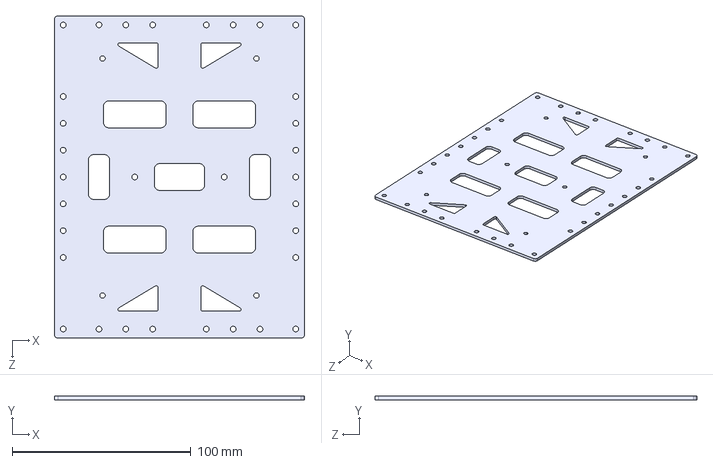
[picture p33: CAD file, 2026-10-22]
mechanical/cad/发加工/无人机底板2mm.STEP
140.0 x 2.00 x 180.0 mm
