Scherrerll/acg720-fpga-flight-controller/mechanical/cad/打印件/imu块块.STEP

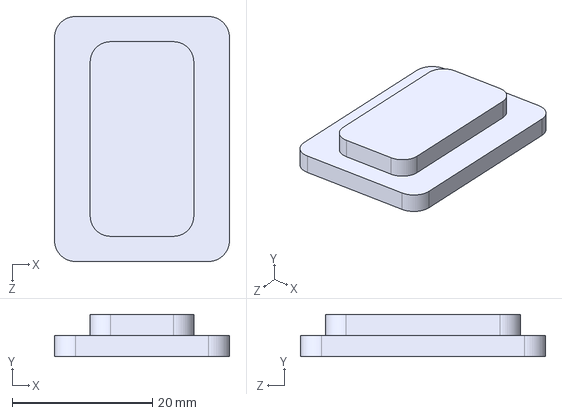
[picture p34: CAD file, 2026-10-22]
mechanical/cad/打印件/imu块块.STEP
25.0 x 6.00 x 35.0 mm
