Scherrerll/acg720-fpga-flight-controller/mechanical/cad/飞机总装/无人机总装/无人机总装/防水保护壳.SLDPRT

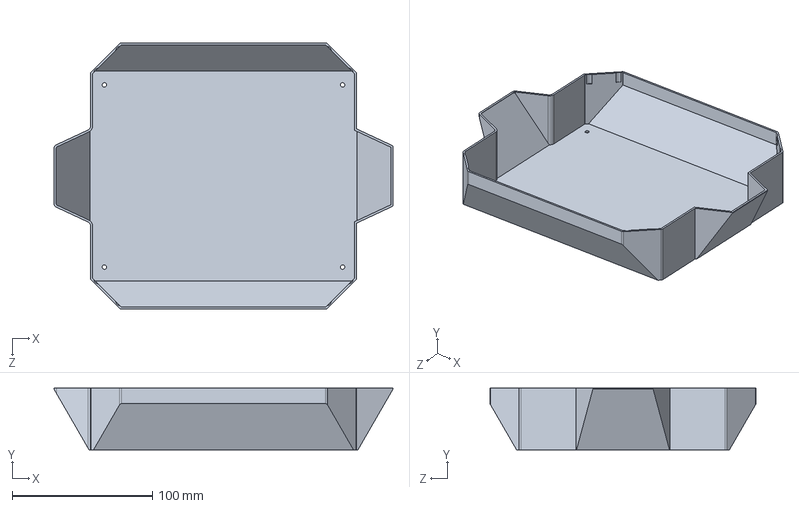
[picture p35: CAD file, 2026-10-22]
mechanical/cad/飞机总装/无人机总装/无人机总装/防水保护壳.SLDPRT
242.0 x 44.0 x 190.0 mm
