Scherrerll/acg720-fpga-flight-controller/mechanical/cad/飞机总装/浮筒.STEP

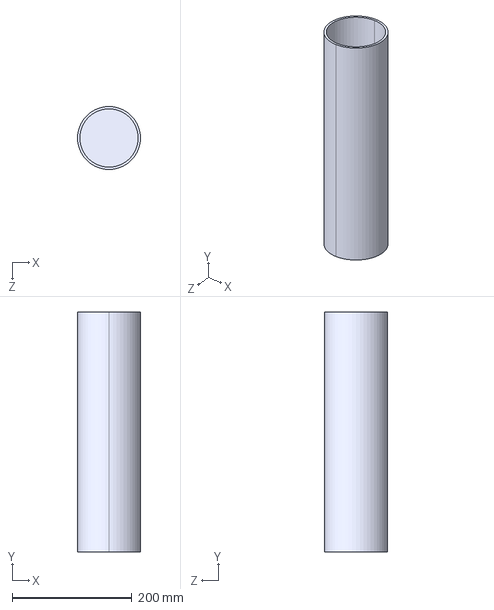
[picture p36: CAD file, 2026-10-22]
mechanical/cad/飞机总装/浮筒.STEP
105.0 x 400.0 x 105.0 mm
