Scherrerll/acg720-fpga-flight-controller/mechanical/cad/发加工/中板无人机3mm.STEP

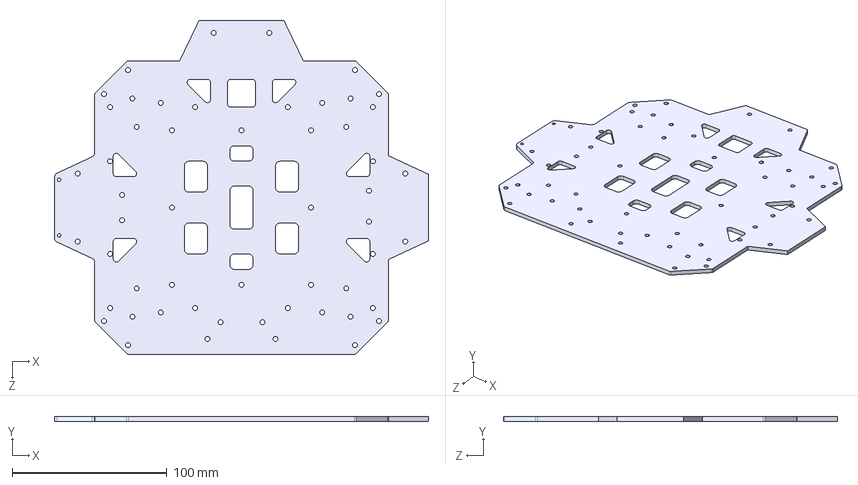
[picture p37: CAD file, 2026-10-22]
mechanical/cad/发加工/中板无人机3mm.STEP
242.0 x 3.00 x 216.0 mm
