Scherrerll/acg720-fpga-flight-controller/mechanical/cad/打印件/顶板中板连接件3个.STEP

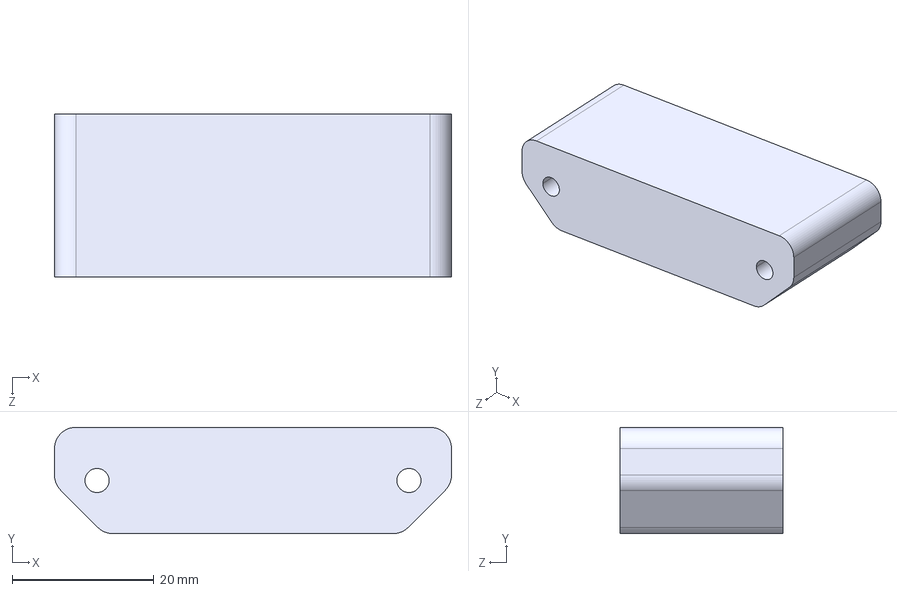
[picture p38: CAD file, 2026-10-22]
mechanical/cad/打印件/顶板中板连接件3个.STEP
56.0 x 15.0 x 23.0 mm
