Scherrerll/acg720-fpga-flight-controller/mechanical/cad/d.SLDPRT

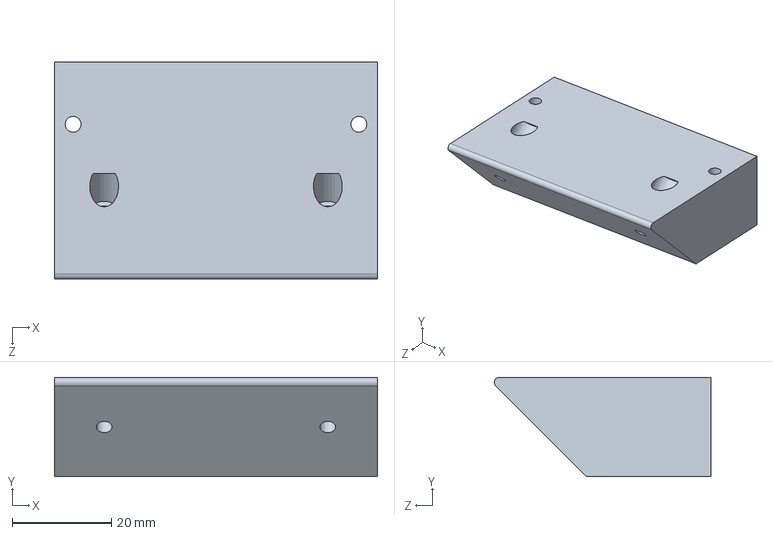
[picture p39: CAD file, 2026-10-22]
mechanical/cad/d.SLDPRT
65.0 x 20.0 x 43.6 mm
