Scherrerll/acg720-fpga-flight-controller/mechanical/cad/发加工/电机碳板3mm 8个.STEP

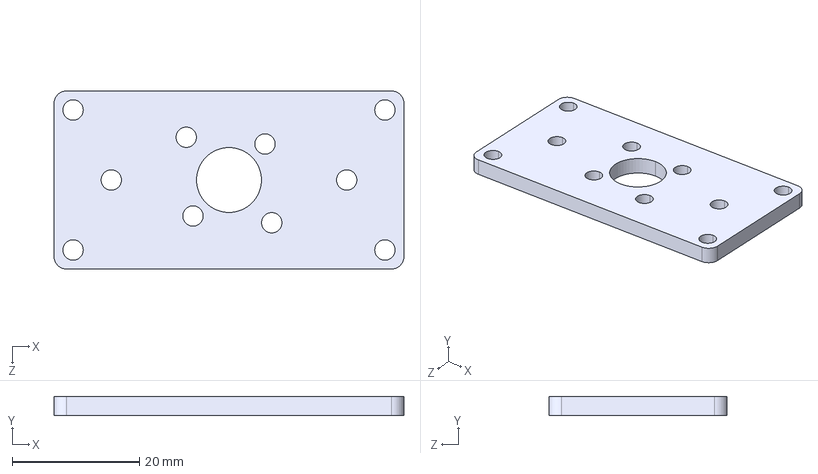
[picture p40: CAD file, 2026-10-22]
mechanical/cad/发加工/电机碳板3mm 8个.STEP
55.0 x 3.00 x 28.0 mm
