Scherrerll/acg720-fpga-flight-controller/mechanical/cad/打印件/起落架.STEP

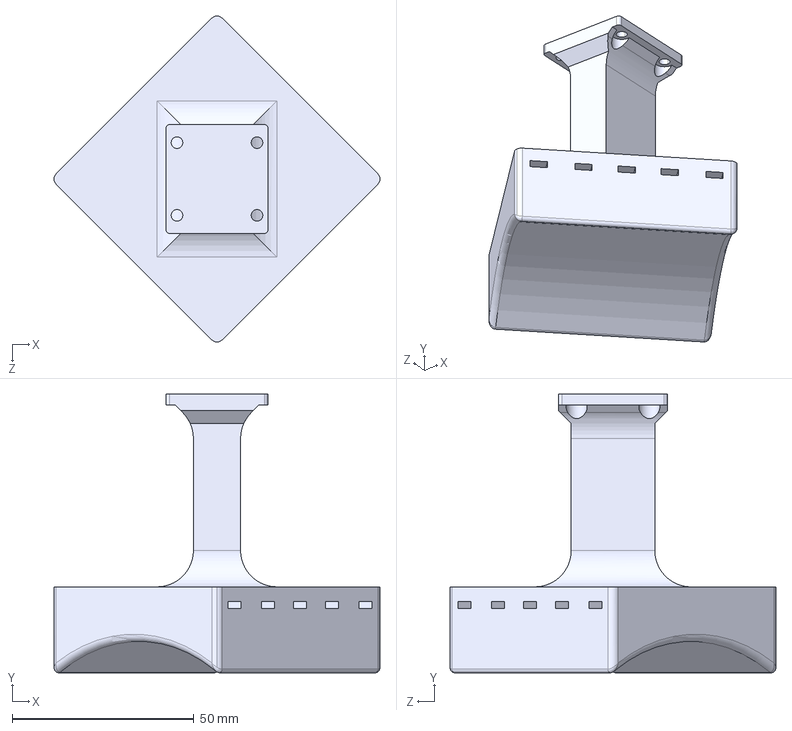
[picture p41: CAD file, 2026-10-22]
mechanical/cad/打印件/起落架.STEP
89.7 x 76.6 x 89.7 mm
