Scherrerll/acg720-fpga-flight-controller/mechanical/cad/飞机总装/无人机总装/无人机总装/电调示意.SLDPRT

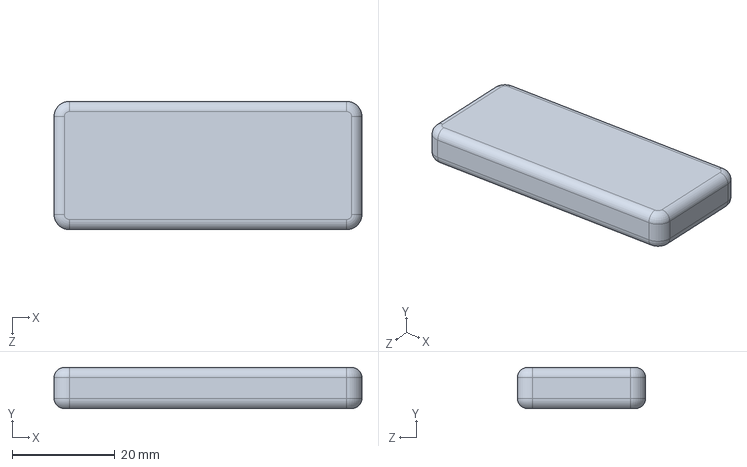
[picture p42: CAD file, 2026-10-22]
mechanical/cad/飞机总装/无人机总装/无人机总装/电调示意.SLDPRT
60.0 x 8.00 x 25.0 mm
