Scherrerll/acg720-fpga-flight-controller/mechanical/cad/发加工/无人机顶板3mm.STEP

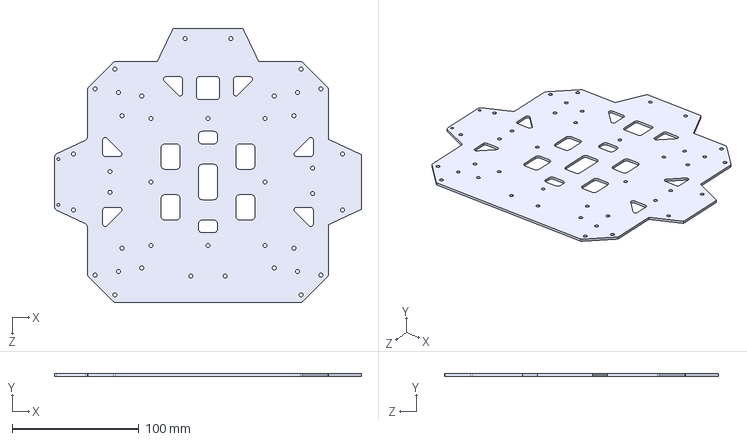
[picture p43: CAD file, 2026-10-22]
mechanical/cad/发加工/无人机顶板3mm.STEP
242.0 x 2.00 x 216.0 mm
