Scherrerll/acg720-fpga-flight-controller/mechanical/cad/打印件/相机安装件1个.STEP

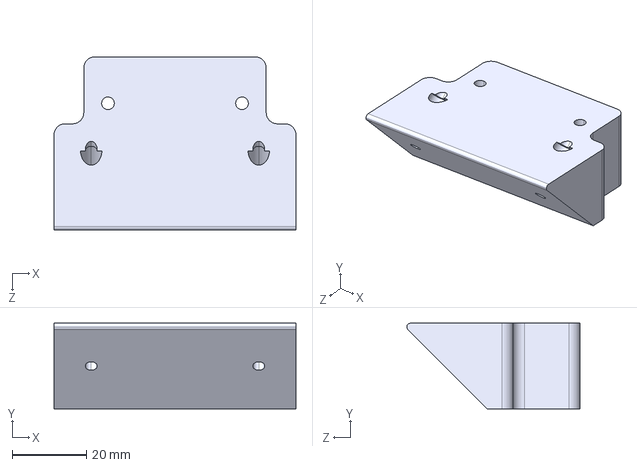
[picture p44: CAD file, 2026-10-22]
mechanical/cad/打印件/相机安装件1个.STEP
65.0 x 23.0 x 46.6 mm
