Scherrerll/acg720-fpga-flight-controller/mechanical/cad/电池.SLDPRT

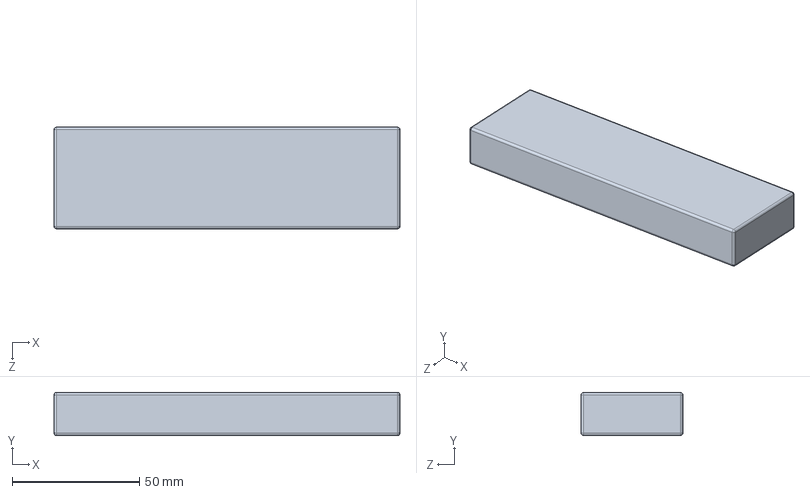
[picture p45: CAD file, 2026-10-22]
mechanical/cad/电池.SLDPRT
136.0 x 17.0 x 40.0 mm
