Scherrerll/acg720-fpga-flight-controller/mechanical/cad/飞机总装/无人机总装/无人机总装/AVG720.SLDPRT

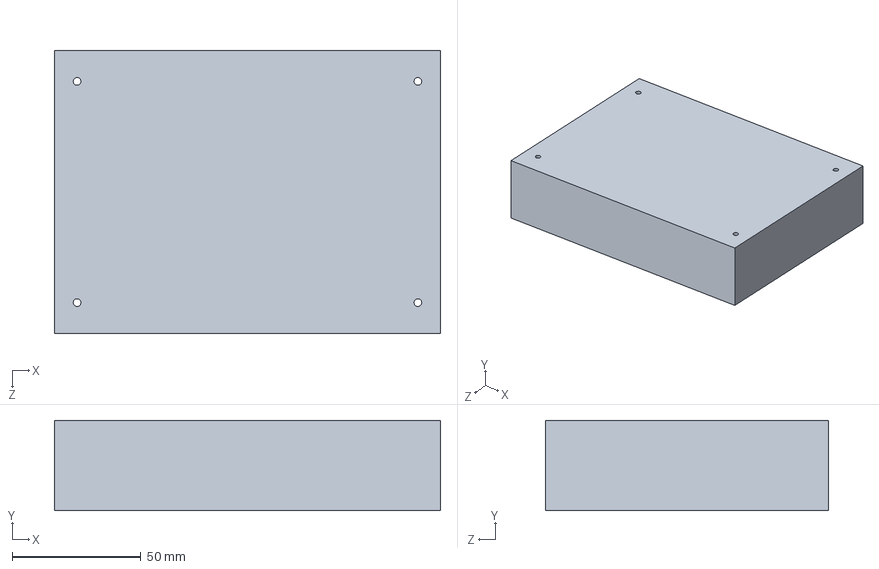
[picture p46: CAD file, 2026-10-22]
mechanical/cad/飞机总装/无人机总装/无人机总装/AVG720.SLDPRT
150.0 x 35.0 x 110.0 mm
