Scherrerll/acg720-fpga-flight-controller/mechanical/cad/光流直接粘.SLDPRT

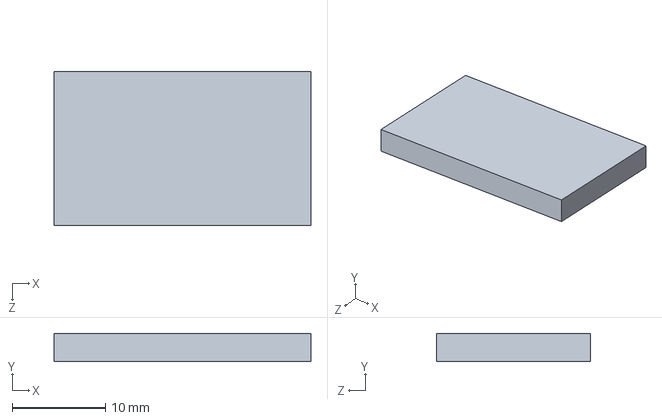
[picture p47: CAD file, 2026-10-22]
mechanical/cad/光流直接粘.SLDPRT
27.5 x 3.00 x 16.5 mm
