Scherrerll/acg720-fpga-flight-controller/mechanical/cad/发加工/机臂碳管4个.STEP

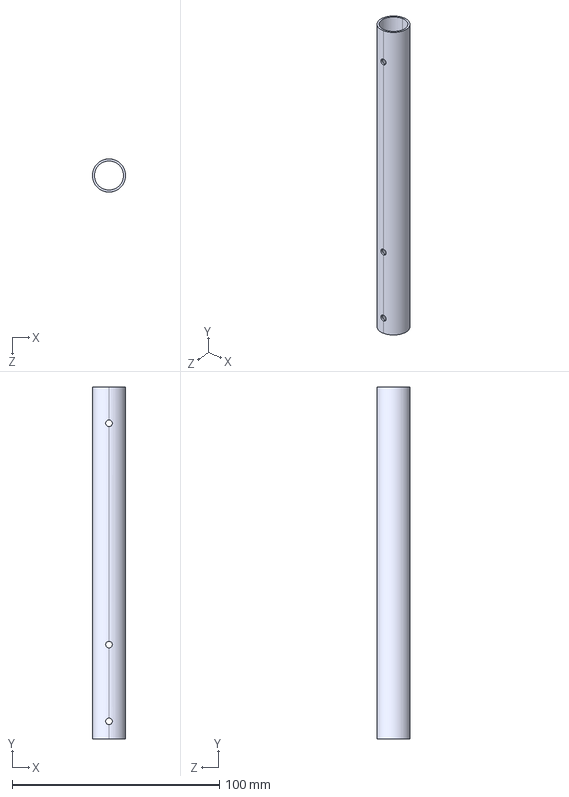
[picture p48: CAD file, 2026-10-22]
mechanical/cad/发加工/机臂碳管4个.STEP
16.0 x 169.7 x 16.0 mm
