Scherrerll/acg720-fpga-flight-controller/mechanical/cad/飞机总装/无人机总装/无人机总装/浮筒.SLDPRT

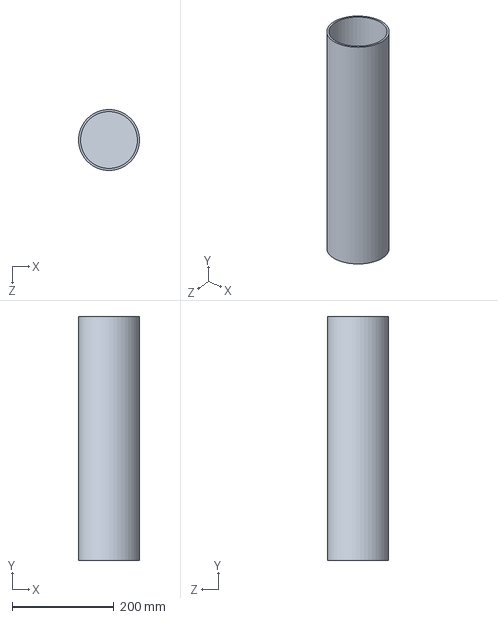
[picture p49: CAD file, 2026-10-22]
mechanical/cad/飞机总装/无人机总装/无人机总装/浮筒.SLDPRT
119.7 x 480.0 x 120.0 mm
