Scherrerll/acg720-fpga-flight-controller/mechanical/cad/飞机总装/无人机总装/无人机总装/D435i.SLDPRT

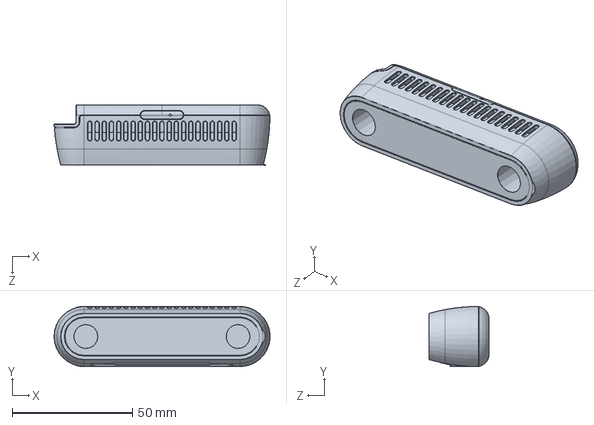
[picture p50: CAD file, 2026-10-22]
mechanical/cad/飞机总装/无人机总装/无人机总装/D435i.SLDPRT
89.9 x 25.0 x 25.1 mm
