Scherrerll/acg720-fpga-flight-controller/mechanical/cad/飞机总装/无人机总装/无人机总装/保护壳.SLDPRT

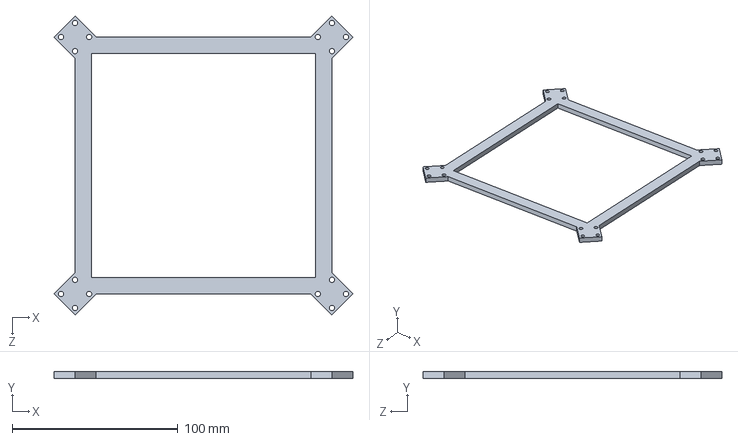
[picture p51: CAD file, 2026-10-22]
mechanical/cad/飞机总装/无人机总装/无人机总装/保护壳.SLDPRT
180.5 x 4.00 x 180.5 mm
