Scherrerll/acg720-fpga-flight-controller/mechanical/cad/飞机总装/无人机总装/无人机总装/16mm碳管脚架.SLDPRT

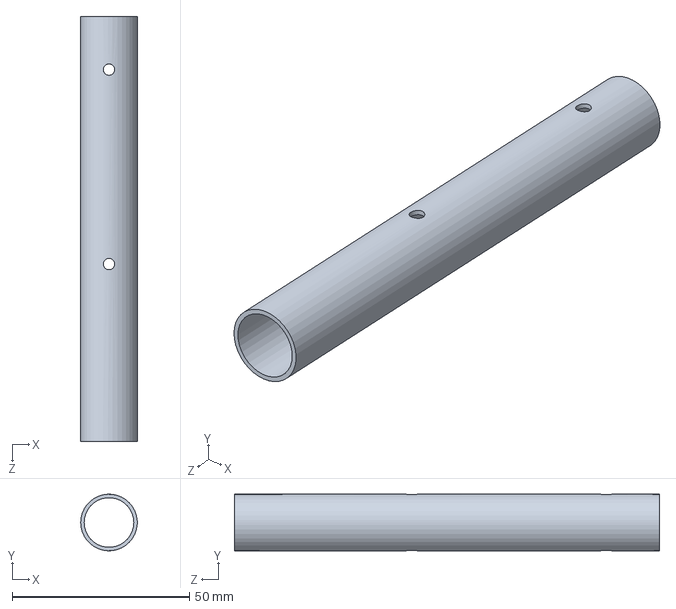
[picture p52: CAD file, 2026-10-22]
mechanical/cad/飞机总装/无人机总装/无人机总装/16mm碳管脚架.SLDPRT
16.0 x 16.0 x 120.0 mm
