Scherrerll/acg720-fpga-flight-controller/mechanical/cad/飞机总装/无人机总装/无人机总装/降压模块直接粘.SLDPRT

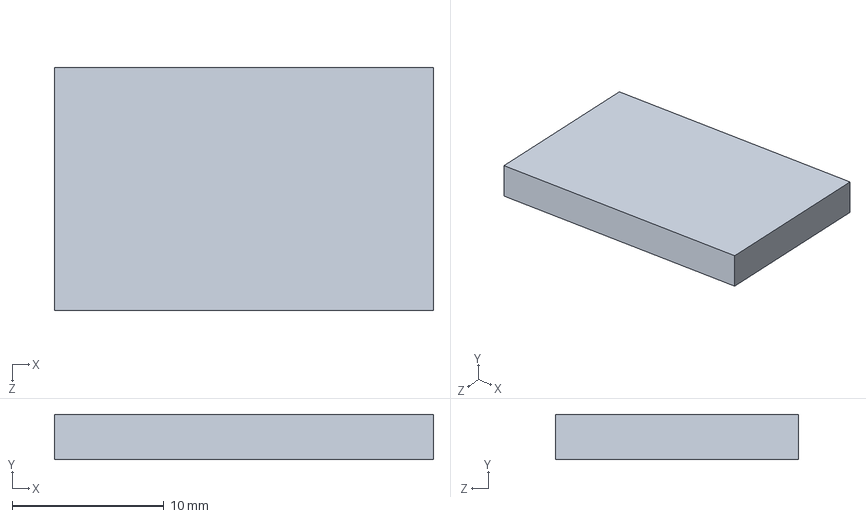
[picture p53: CAD file, 2026-10-22]
mechanical/cad/飞机总装/无人机总装/无人机总装/降压模块直接粘.SLDPRT
25.0 x 3.00 x 16.0 mm
