Scherrerll/acg720-fpga-flight-controller/mechanical/cad/飞机总装/无人机总装/无人机总装/Holybro SiK Telemetry Radio V3 数传电台.SLDPRT

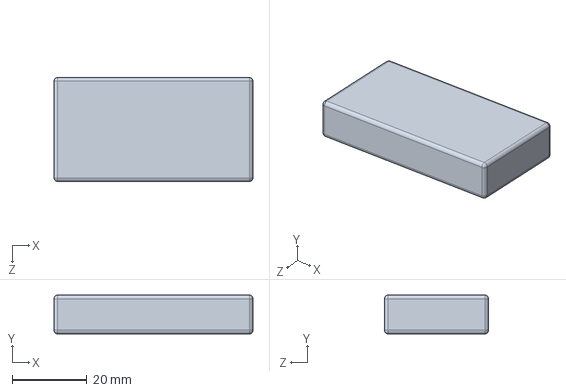
[picture p54: CAD file, 2026-10-22]
mechanical/cad/飞机总装/无人机总装/无人机总装/Holybro SiK Telemetry Radio V3 数传电台.SLDPRT
53.2 x 10.4 x 27.8 mm
