Scherrerll/acg720-fpga-flight-controller/mechanical/cad/飞机总装/无人机总装/无人机总装/脚架接底板连接件.SLDPRT

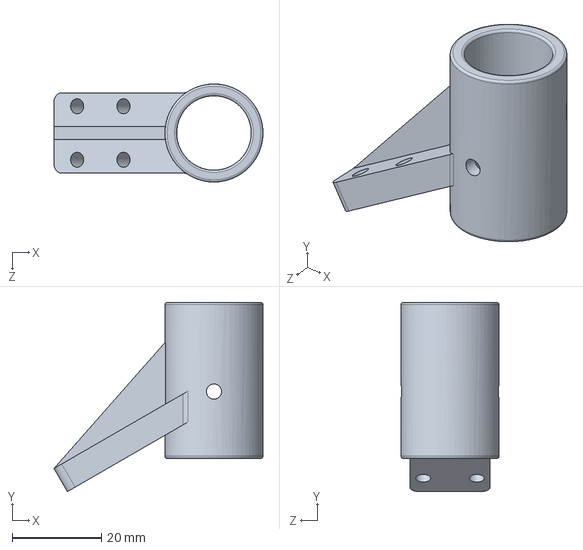
[picture p55: CAD file, 2026-10-22]
mechanical/cad/飞机总装/无人机总装/无人机总装/脚架接底板连接件.SLDPRT
46.9 x 42.4 x 22.0 mm
