Scherrerll/acg720-fpga-flight-controller/mechanical/cad/飞机总装/无人机总装/无人机总装/碳管固定座.SLDPRT

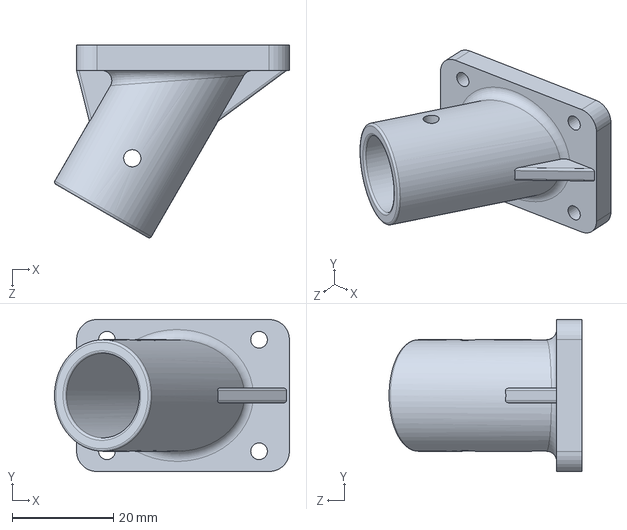
[picture p56: CAD file, 2026-10-22]
mechanical/cad/飞机总装/无人机总装/无人机总装/碳管固定座.SLDPRT
46.3 x 30.0 x 38.0 mm
