Scherrerll/acg720-fpga-flight-controller/mechanical/cad/飞机总装/无人机总装/无人机总装/北醒TFmini-S激光测距传感器.SLDPRT

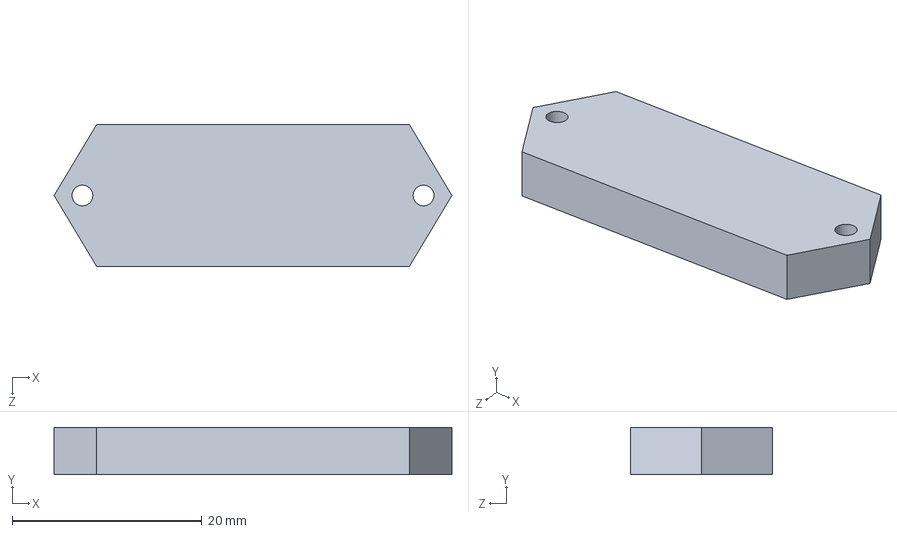
[picture p57: CAD file, 2026-10-22]
mechanical/cad/飞机总装/无人机总装/无人机总装/北醒TFmini-S激光测距传感器.SLDPRT
42.0 x 5.00 x 15.0 mm
