Scherrerll/acg720-fpga-flight-controller/mechanical/cad/飞机总装/无人机总装/无人机总装/1045 propeller.SLDPRT

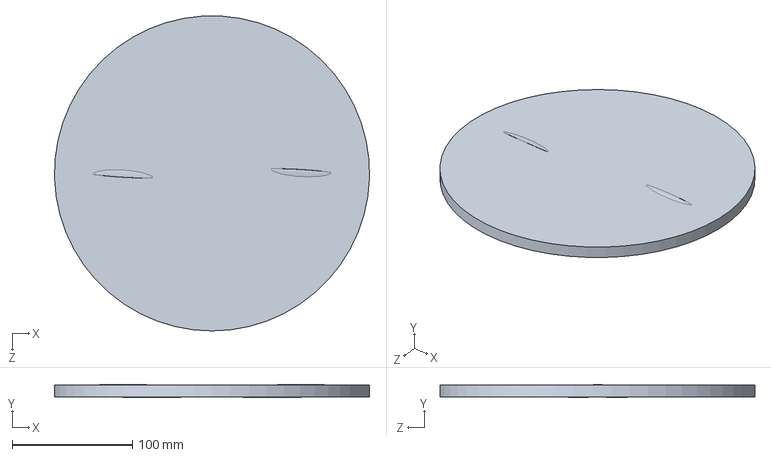
[picture p58: CAD file, 2026-10-22]
mechanical/cad/飞机总装/无人机总装/无人机总装/1045 propeller.SLDPRT
262.3 x 11.2 x 262.2 mm
