Scherrerll/acg720-fpga-flight-controller/mechanical/cad/飞机总装/无人机总装/无人机总装/机臂管架.SLDPRT

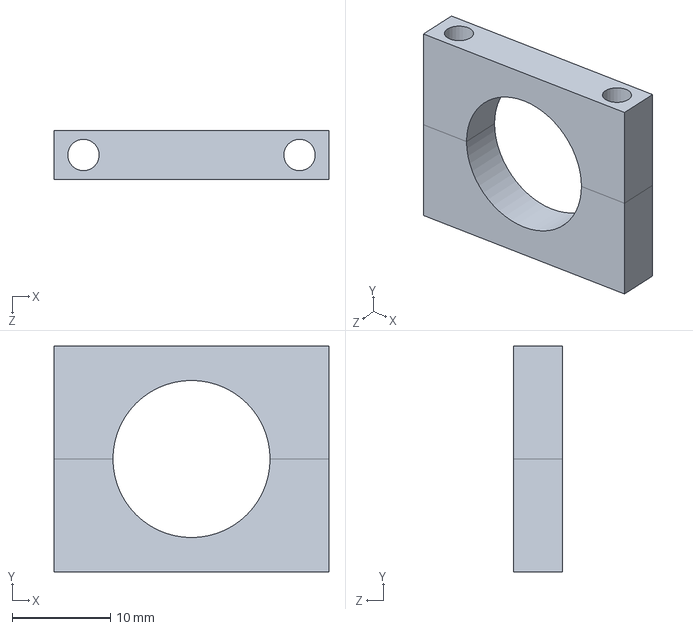
[picture p59: CAD file, 2026-10-22]
mechanical/cad/飞机总装/无人机总装/无人机总装/机臂管架.SLDPRT
28.0 x 23.0 x 5.00 mm
