Scherrerll/acg720-fpga-flight-controller/mechanical/cad/飞机总装/无人机总装/无人机总装/电池示意43X43X80.SLDPRT

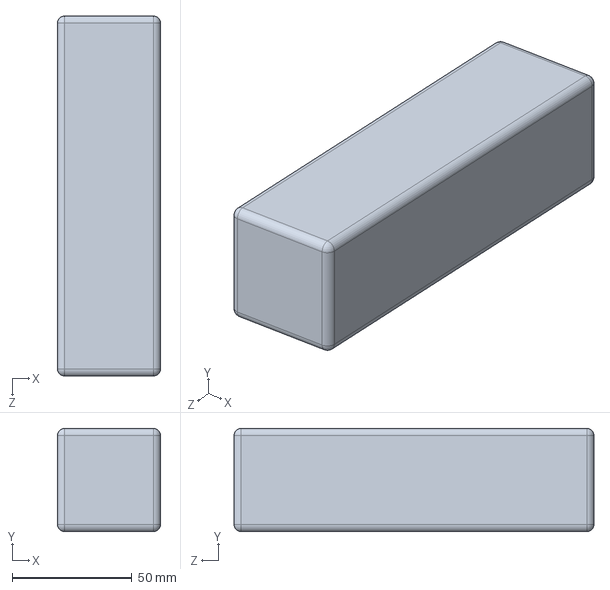
[picture p60: CAD file, 2026-10-22]
mechanical/cad/飞机总装/无人机总装/无人机总装/电池示意43X43X80.SLDPRT
43.0 x 43.0 x 150.0 mm
