Scherrerll/acg720-fpga-flight-controller/mechanical/cad/飞机总装/无人机总装/无人机总装/电机下固定碳板.SLDPRT

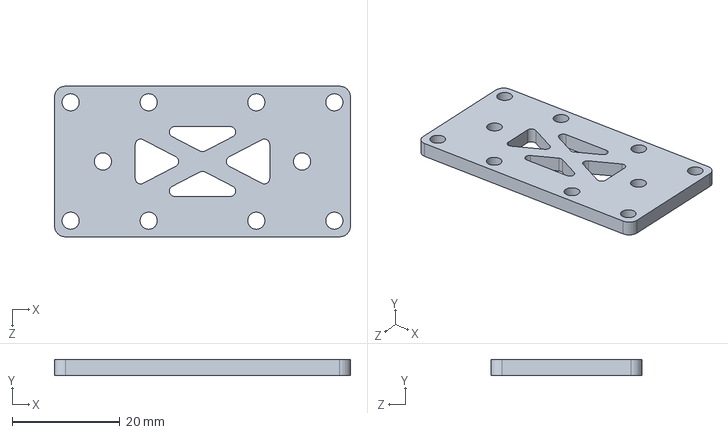
[picture p61: CAD file, 2026-10-22]
mechanical/cad/飞机总装/无人机总装/无人机总装/电机下固定碳板.SLDPRT
55.0 x 3.00 x 28.0 mm
