Scherrerll/acg720-fpga-flight-controller/mechanical/cad/飞机总装/无人机总装/无人机总装/450机架总装.SLDASM

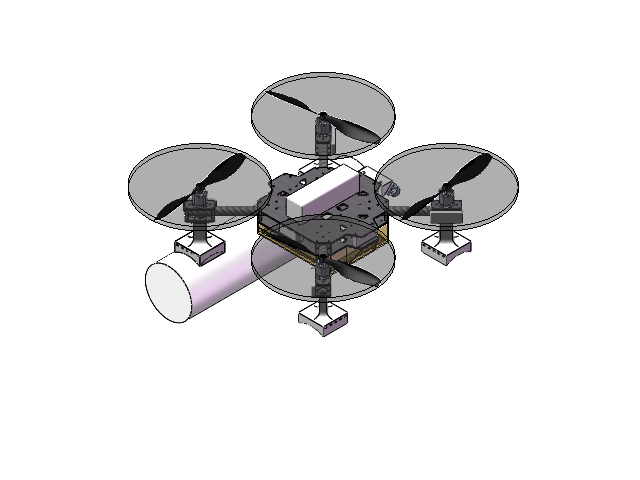
[picture p62: CAD file, 2026-10-22]
mechanical/cad/飞机总装/无人机总装/无人机总装/450机架总装.SLDASM
中板无人机
机臂管架 x 13
机臂碳管 x 4
电机碳板 x 4
X2216 Stator Base.STEP x 4
X2216 Brass Washer.STEP x 4
X2216 Magnet Ring.STEP x 4
X2216 Rotor Top.STEP x 4
X2216 Shaft.STEP x 4
Ball Bearing_60355K41.STEP x 8
External Retaining Ring_98410A111.STEP x 4
电机下固定碳板 x 4
1045 propeller x 4
电调示意 x 4
无人机底板
AVG720
ICM42688P模块
降压模块直接粘 x 2
北醒TFmini-S激光测距传感器
Holybro SiK Telemetry Radio V3 数传电台
D435i
相机安装件
无人机顶板
顶板中板连接件 x 3
电池示意43X43X80
起落架 x 4
浮筒
起落架镜像
防水保护壳
