Scherrerll/acg720-fpga-flight-controller/mechanical/cad/飞机总装/无人机总装/无人机总装/Sunnysky X2216 Motor.SLDASM

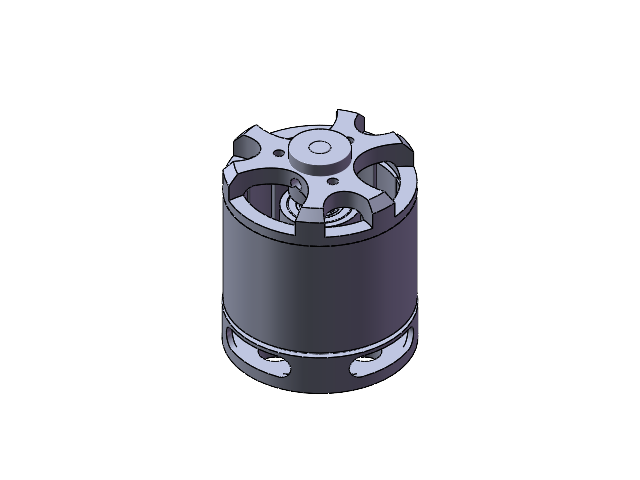
[picture p63: CAD file, 2026-10-22]
mechanical/cad/飞机总装/无人机总装/无人机总装/Sunnysky X2216 Motor.SLDASM
X2216 Stator Base.STEP
X2216 Brass Washer.STEP
X2216 Magnet Ring.STEP
X2216 Rotor Top.STEP
X2216 Shaft.STEP
Ball Bearing_60355K41.STEP x 2
External Retaining Ring_98410A111.STEP
