Scherrerll/acg720-fpga-flight-controller/(list of files, cad)

Other CAD files:
mechanical/cad/无人机顶板3mm.STEP
mechanical/cad/飞机总装/无人机总装/无人机总装/中板无人机.SLDPRT
mechanical/cad/飞机总装/无人机总装/无人机总装/机臂碳管.SLDPRT
mechanical/cad/飞机总装/无人机总装/无人机总装/无人机顶板.SLDPRT
mechanical/cad/飞机总装/无人机总装/无人机总装/电机碳板.SLDPRT
mechanical/cad/飞机总装/无人机总装/无人机总装/相机安装件.SLDPRT
mechanical/cad/飞机总装/无人机总装/无人机总装/无人机底板.SLDPRT
mechanical/cad/飞机总装/无人机总装/无人机总装/顶板中板连接件.SLDPRT
mechanical/cad/ICM42688P模块.SLDPRT
mechanical/cad/打印件/顶板中板连接件3个.SLDPRT
mechanical/cad/飞机总装/无人机总装/无人机总装/电机下固定碳板.DXF
mechanical/cad/飞机总装/浮筒.3mf
