Scherrerll/acg720-fpga-flight-controller/firmware/B0B2/hardware/v15_stick_oscillation_20261025/rotation_followup/manual_comparison_plan.md

# 下一轮 SWC 低档动态对照计划

状态：仅完成准备，尚未执行。2026-10-25，操作者确认目前只能悬空手持、尚未做过低档打杆对比。固定支点条件不成立，本轮没有再启动倾斜采集。

## 目的与保持项

保留原始 V15 / B0B2、原 PID 和传感器设置，比较关闭光流 XY 后同类小幅打杆及回中的姿态响应。SWC 低档关闭光流 XY，当前固件仍保留高度控制；不能将其写成完全手动油门模式。

正式对照在操作者准备好下一轮实飞条件后进行。当前机体处于拆桨停机状态；本计划不要求现在装桨起飞。地面接收器保持只读，沿用现有连续日志；开始和结束时另外记录 UTC、固件启动 epoch 和姿态/模式快照。

## 最小数据段

1. SWC 低档，稳定的短时悬停参考。
2. 一次小幅单轴输入，回中后观察是否自然衰减，再落地。先做一个轴，避免多轴和大幅输入混合。角度、距离和推杆时长不要求手工精确复现。
3. 依据实际动态和日志，再决定是否需要另一轴；不能仅凭控制器没有报告故障判定稳定。

## 必须保存的信号

- A579/A586：CH1/2/3/5/7、目标与实际横滚/俯仰、机体角速度、电机命令、控制状态与故障计数。
- A580/A588：固件 B0B2 身份、运行时间、taking_off 等状态；该标志不是独立离地证明。
- A582：XY 请求与实际启用状态、垂直控制状态、速度观察/融合、源数据年龄及模式撤销原因。
- MTF、IMU 诊断及地面串口丢帧/校验计数；记录饱和，避免把饱和下的响应当作未饱和的内环特性。

当前约5 Hz下传只用于低频动态与模式对照，不能据此声称完成高频内环辨识或测得精确延迟。

## 对照后的判断

- **低档也持续振荡**：优先检查姿态/角速度内环、执行器余量、机械振动和输入链，再处理光流。
- **低档基本稳定，而高档出现原症状**：将重点放到新增的光流测量、速度融合与速度 PI 整体相位/增益；仍需考虑其目标指令可能激起内环在不同频率下的弱阻尼，不能宣称内环全面排除。
- **没有有效可比较的数据段**：保留为未完成，不记为通过，也不据此改变 PID 或增加去旋转。

已有第一轮约3秒的低档起飞控制片段高度不超过约0.42m，混有起降，不能替代本次缺少的有效低档动态对照。

所有布线仍暂停；本计划不包含固件下载、Flash 写入或自动控制命令。
