Scherrerll/acg720-fpga-flight-controller/firmware/B0B0/provenance/build_reports/acg720_ano_port.power.html

- Power Messages
  - Configure Information
- Power Summary
  - Power Information
  - Thermal Information
  - Supply Information
- Power Details
  - Power By Block Type
  - Power By Hierarchy
  - Power By Clock Domain

# Power Messages

Report Title | Power Analysis Report
Design File | C:\Users\ScherrerL\Desktop\apple\routing_closure_20261024\fine_global_guardband195\fixture\impl\gwsynthesis\acg720_ano_port.vg
Physical Constraints File | C:\Users\ScherrerL\Desktop\apple\routing_closure_20261024\fine_global_guardband195\fixture\acg720_ano_port.cst
Timing Constraints File | C:\Users\ScherrerL\Desktop\apple\routing_closure_20261024\fine_global_guardband195\fixture\acg720_ano_port.sdc
Tool Version | V1.9.12.04 (64-bit)
Part Number | GW5AT-LV60PG484AC1/I0
Device | GW5AT-60
Device Version | B
Created Time | Sat Oct 24 10:47:32 2026
Legal Announcement | Copyright (C)2014-2026 Gowin Semiconductor Corporation. All rights reserved.

## Configure Information:

Grade | Commercial
Process | Typical
Ambient Temperature | 25.000
Use Custom Theta JA | false
Heat Sink | None
Air Flow | LFM_0
Use Custom Theta SA | false
Board Thermal Model | None
Use Custom Theta JB | false
Related Vcd File
Related Saif File
Filter Glitches | false
Default IO Toggle Rate | 0.125
Default Remain Toggle Rate | 0.125

# Power Summary

## Power Information:

Total Power (mW) | 162.657
Quiescent Power (mW) | 83.635
Dynamic Power (mW) | 79.022

## Thermal Information:

Junction Temperature | 27.790
Theta JA | 17.153
Max Allowed Ambient Temperature | 82.210

## Supply Information:

Voltage Source | Voltage | Dynamic Current(mA) | Quiescent Current(mA) | Power(mW)
VCC | 0.950 | 80.749 | 71.281 | 144.428
VCCX | 3.300 | 0.350 | 4.000 | 14.355
VCCIO33 | 3.300 | 0.350 | 0.824 | 3.873

# Power Details

## Power By Block Type:

Block Type | Total Power(mW) | Static Power(mW) | Average Toggle Rate(millions of transitions/sec)
Logic | 27.844 | NA | 7.037
IO | 8.265 | 5.624 | 8.673
BSRAM | 0.547 | NA | NA
DSP | 47.984 | NA | 5.530

## Power By Hierarchy:

Hierarchy Entity | Total Power(mW) | Block Dynamic Power(mW)
acg720_ano_port | 76.375 | 76.375(75.944)
acg720_ano_port/acc_time/ | 0.079 | 0.079(0.000)
acg720_ano_port/command_handoff/ | 0.004 | 0.004(0.000)
acg720_ano_port/core/ | 33.182 | 33.182(31.812)
acg720_ano_port/core/controller/ | 4.084 | 4.084(0.465)
acg720_ano_port/core/controller/divider/ | 0.301 | 0.301(0.000)
acg720_ano_port/core/controller/multiplier/ | 0.164 | 0.164(0.000)
acg720_ano_port/core/fallback_control/ | 1.621 | 1.621(0.000)
acg720_ano_port/core/fallback_sticks/ | 5.127 | 5.127(0.179)
acg720_ano_port/core/fallback_sticks/div/ | 0.179 | 0.179(0.000)
acg720_ano_port/core/flight_state/ | 0.054 | 0.054(0.000)
acg720_ano_port/core/gate/ | 0.102 | 0.102(0.000)
acg720_ano_port/core/imu/ | 17.218 | 17.218(17.201)
acg720_ano_port/core/imu/estimator/ | 11.814 | 11.814(3.336)
acg720_ano_port/core/imu/estimator/angle/ | 2.830 | 2.830(0.000)
acg720_ano_port/core/imu/estimator/div/ | 0.163 | 0.163(0.000)
acg720_ano_port/core/imu/estimator/mul/ | 0.164 | 0.164(0.000)
acg720_ano_port/core/imu/estimator/sqrt/ | 0.179 | 0.179(0.000)
acg720_ano_port/core/imu/guard/ | 0.199 | 0.199(0.000)
acg720_ano_port/core/imu/reader/ | 0.351 | 0.351(0.050)
acg720_ano_port/core/imu/reader/spi/ | 0.050 | 0.050(0.000)
acg720_ano_port/core/imu/temporal/ | 4.838 | 4.838(0.000)
acg720_ano_port/core/manual_angles/ | 0.990 | 0.990(0.184)
acg720_ano_port/core/manual_angles/divider/ | 0.184 | 0.184(0.000)
acg720_ano_port/core/mixer/ | 0.382 | 0.382(0.000)
acg720_ano_port/core/outputs/ | 0.106 | 0.106(0.000)
acg720_ano_port/core/receiver/ | 0.065 | 0.065(0.000)
acg720_ano_port/core/yaw_controller/ | 2.064 | 2.064(0.446)
acg720_ano_port/core/yaw_controller/divide/ | 0.281 | 0.281(0.000)
acg720_ano_port/core/yaw_controller/multiply/ | 0.164 | 0.164(0.000)
acg720_ano_port/height_fusion/ | 0.000 | 0.000(0.000)
acg720_ano_port/laser_geometry/ | 0.000 | 0.000(0.000)
acg720_ano_port/mtf/ | 3.655 | 3.655(3.472)
acg720_ano_port/mtf/metric/ | 3.085 | 3.085(0.000)
acg720_ano_port/mtf/parser/ | 0.370 | 0.370(0.000)
acg720_ano_port/mtf/uart/ | 0.017 | 0.017(0.000)
acg720_ano_port/native_navigation/ | 38.411 | 38.411(38.118)
acg720_ano_port/native_navigation/controller_proof/ | 13.632 | 13.632(7.003)
acg720_ano_port/native_navigation/controller_proof/t/ | 0.234 | 0.234(0.000)
acg720_ano_port/native_navigation/controller_proof/xy_stick/ | 5.143 | 5.143(0.179)
acg720_ano_port/native_navigation/controller_proof/xy_stick/div/ | 0.179 | 0.179(0.000)
acg720_ano_port/native_navigation/controller_proof/z_stick/ | 1.626 | 1.626(0.000)
acg720_ano_port/native_navigation/divide_service/ | 0.325 | 0.325(0.202)
acg720_ano_port/native_navigation/divide_service/division_engine.engine/ | 0.202 | 0.202(0.000)
acg720_ano_port/native_navigation/geometry/ | 1.239 | 1.239(0.346)
acg720_ano_port/native_navigation/geometry/d/ | 0.091 | 0.091(0.000)
acg720_ano_port/native_navigation/geometry/t/ | 0.255 | 0.255(0.000)
acg720_ano_port/native_navigation/height_fusion/ | 8.018 | 8.018(0.000)
acg720_ano_port/native_navigation/multiply_service/ | 6.002 | 6.002(5.168)
acg720_ano_port/native_navigation/multiply_service/multiplication_engine.engine/ | 5.168 | 5.168(0.000)
acg720_ano_port/native_navigation/position/ | 3.196 | 3.196(0.309)
acg720_ano_port/native_navigation/position/divide/ | 0.309 | 0.309(0.000)
acg720_ano_port/native_navigation/velocity_fusion/ | 5.706 | 5.706(0.000)
acg720_ano_port/telemetry/ | 0.612 | 0.612(0.022)
acg720_ano_port/telemetry/uart/ | 0.022 | 0.022(0.000)

## Power By Clock Domain:

Clock Domain | Clock Frequency(Mhz) | Total Dynamic Power(mW)
clk50 | 51.282 | 76.381
NO CLOCK DOMAIN | 0.000 | 0.000
