Scherrerll/acg720-fpga-flight-controller/mechanical/final-assembly-20261031/README.md

# 机械最终版总装

[下载原始压缩包](飞船五颜六色版.zip)

原包 SHA-256：

```text
96ee75f5ea7ae4c32dd097ecebca59caed1e7f2f51bb7223f19e8c941eef18c9
```
