Scherrerll/acg720-fpga-flight-controller/firmware/B0B2/hardware/v15_flash_install_20261025T132659_439750Z/README.md

# V15 Flash 固化与冷启动结果（2026-10-25）

本次已完成用户授权的原位 V15 固化、独立 Flash 校验，以及仅电池供电的冷启动检查。上电默认程序现为 V15 / B0B2。最后一次遥测核对为未解锁，四路命令与 PWM 均为 1000 μs，油门、SWA、SWC 均在低档。

## 完成证据

- [原始安装记录](flash_install.json)：写入前独立校验原 B0B0 回退镜像；V15 使用厂商 op54 完成擦写和校验，再用 op66 独立校验成功，重载后识别 B0B2。安装流程的 20 项离线 mock 检查通过。
- [电池冷启动记录](cold_boot_20261025T132935_908607Z/summary.json)：用户确认所有电源断开、板卡 USB 和下载器断开，随后仅接电池。采集实际记录到遥测中断及新启动计数归零。停机观察 60.206 秒、253 个不同遥测帧，IMU 新增接收 60,295 次，新增拒收、控制故障、门控中断和撤销均为 0。
- [最终停机快照](completion_stopped.json)：只读 HTTP 核对，通过停机、低档输入和健康检查。
- [短时控制启用检查](../v15_active_imu_20261025T131703_954633Z/README.md)：拆桨下 rate 与原生光流 XY/Z 同时启用约 5.05 秒，IMU 与姿态计数连续，新增拒收和控制故障为 0。该测试仅验证连续性，不能据此确认带桨负载下的增益或稳定性。

原始 flash_install.json 中 physical_cold_boot_verified=false 是安装刚完成时的记录，保持原样；后续独立冷启动报告给出 physical_cold_boot_verified=true。

## 镜像与回退

- 原始 V15 位流 SHA-256：`3b9920acc1abecf6e0ef50465f5bc408d9b74af2ac6d046cb151137a375b4306`
- V15 manifest SHA-256：`c0827d5331af3055770dd999aee89e82ee5074ee20cae3aa076a0956155edca1`
- 原 B0B0 回退位流 SHA-256：`83653a2f405cc467ac553fd81ac57d2981c5a9f52543afbbd3368881ab4ac111`
- [回退镜像](../v15_flash_plan_20261025T132207_545161Z/rollback_B0B0.fs) 已保留；本次未发生回退。

## 当前范围与后续

地面检查及固化阶段完成。所有 V16/V17 布线仍暂停，本次固化使用原始已验证 V15；可选的姿态零点修正和光流目标限幅改动没有上板。

原 V15 静置姿态仍约横滚 +0.8°、俯仰 +3.4°。其光流 XY 使用速度 PI，没有固定坐标位置外环。光流尺度、旋转干扰、带桨振动/负载与实际定点效果尚未验收；flight_ready 保持 false。下一阶段是操作者控制下的实飞评估，不能将此次停机观察等同于定点精度或带载稳定性通过。

按用户要求，未重复此前已验证且实现未变的电机编号、旋向等项目；遥控超时参数的单独实物复测明确跳过，未记为通过。静置、手动姿态方向与回正、遥控输入、怠速和短时控制启用的现有证据继续复用。
