Scherrerll/acg720-fpga-flight-controller/analysis/20261026_z_aw_fix/build/COMPLETED_ATTEMPTS_CURRENT.md

# 当前已归档物理尝试分类

共59条记录：route_failure=42，project_XML_failure=1，fullroute_timing_failure=8，cancelled_duplicate_fallback=3，unknown_exit=1，cancelled_resource_priority=1，vendor_failure_unclassified=1，cancelled_orphan_after_runner_assertion=1，qualified_physical_pass=1。完整物理门及独立raw复核通过1项；实体安装另验。

| ID | 分类 | vendor/runner wait | 未布通 | Fmax MHz | 原始清单 |
|---|---|---|---|---|---|
| first_p3r0 | route_failure | 1/未知/未收录 | 1416 | 未知/未收录 | [原证据](raw_terminal_receipts\frozen_11_terminal_20261026\MANIFEST.json) |
| first_p2r0 | route_failure | 1/未知/未收录 | 721 | 未知/未收录 | [原证据](raw_terminal_receipts\frozen_11_terminal_20261026\MANIFEST.json) |
| first_p3r1 | route_failure | 1/未知/未收录 | 10483 | 未知/未收录 | [原证据](raw_terminal_receipts\frozen_11_terminal_20261026\MANIFEST.json) |
| compact_v1_project01 | project_XML_failure | 1/未知/未收录 | 未知/未收录 | 未知/未收录 | [原证据](raw_terminal_receipts\frozen_11_terminal_20261026\MANIFEST.json) |
| compact_v1_p3r0 | route_failure | 1/未知/未收录 | 746 | 未知/未收录 | [原证据](raw_terminal_receipts\frozen_11_terminal_20261026\MANIFEST.json) |
| compact_v2_map2_p2r0 | route_failure | 1/未知/未收录 | 792 | 未知/未收录 | [原证据](raw_terminal_receipts\frozen_11_terminal_20261026\MANIFEST.json) |
| compact_v2_map1_p3r0 | route_failure | 1/未知/未收录 | 667 | 未知/未收录 | [原证据](raw_terminal_receipts\frozen_11_terminal_20261026\MANIFEST.json) |
| compact_v3_p3r0 | route_failure | 1/未知/未收录 | 898 | 未知/未收录 | [原证据](raw_terminal_receipts\frozen_11_terminal_20261026\MANIFEST.json) |
| compact_v3_p2r0_nt0 | route_failure | 1/未知/未收录 | 1073 | 未知/未收录 | [原证据](raw_terminal_receipts\frozen_11_terminal_20261026\MANIFEST.json) |
| compact_v3_p1r2 | route_failure | 1/未知/未收录 | 1096 | 未知/未收录 | [原证据](raw_terminal_receipts\frozen_11_terminal_20261026\MANIFEST.json) |
| compact_v4_p3r0 | fullroute_timing_failure | 0/未知/未收录 | 未知/未收录 | 未知/未收录 | [原证据](raw_terminal_receipts\frozen_11_terminal_20261026\MANIFEST.json) |
| compact_v4_p4r0 | route_failure | 1/未知/未收录 | 7273 | 未知/未收录 | [原证据](raw_terminal_receipts\followup_closed\MANIFEST.json) |
| compact_v5_p3r0 | route_failure | 1/未知/未收录 | 648 | 未知/未收录 | [原证据](raw_terminal_receipts\followup_closed\MANIFEST.json) |
| compact_v5_inc_b3_cancelled | cancelled_duplicate_fallback | 4294967295/未知/未收录 | 未知/未收录 | 未知/未收录 | [原证据](raw_terminal_receipts\followup_closed\MANIFEST.json) |
| compact_v5_p2r0_interrupted | unknown_exit | 未知/未收录/未知/未收录 | 未知/未收录 | 未知/未收录 | [原证据](raw_terminal_receipts\followup_closed\MANIFEST.json) |
| compact_v5_repl1_p3r0 | route_failure | 1/未知/未收录 | 2670 | 未知/未收录 | [原证据](compact_aw_v5_repl1\final\FINAL_STATUS.json) |
| compact_v6_p1r0 | fullroute_timing_failure | 0/1 | 未知/未收录 | 44.286 | [原证据](compact_aw_v6\physical_p1r0_01\TERMINAL_MANIFEST.json) |
| compact_v6_p2r0 | fullroute_timing_failure | 0/1 | 未知/未收录 | 47.942 | [原证据](compact_aw_v6\physical_p2r0_01\TERMINAL_MANIFEST.json) |
| compact_v6_p3r0 | route_failure | 1/1 | 389 | 未知/未收录 | [原证据](compact_aw_v6\physical_p3r0_01\TERMINAL_MANIFEST.json) |
| compact_v7_p3r0 | route_failure | 1/1 | 447 | 未知/未收录 | [原证据](compact_aw_v7\physical_p3r0_01\TERMINAL_MANIFEST.json) |
| compact_v7_p2r0 | route_failure | 1/1 | 568 | 未知/未收录 | [原证据](compact_aw_v7\physical_p2r0_01\TERMINAL_MANIFEST.json) |
| compact_v8_p3r0 | route_failure | 1/1 | 1271 | 未知/未收录 | [原证据](compact_aw_v8\physical_p3r0_01\TERMINAL_MANIFEST.json) |
| compact_v8_p2r0 | route_failure | 1/1 | 294 | 未知/未收录 | [原证据](compact_aw_v8\physical_p2r0_01\TERMINAL_MANIFEST.json) |
| compact_v9_p3r0 | route_failure | 1/1 | 2228 | 未知/未收录 | [原证据](compact_aw_v9\physical_p3r0_01\TERMINAL_MANIFEST.json) |
| compact_v9_inc_v4_p3r0 | cancelled_duplicate_fallback | 1/1 | 未知/未收录 | 未知/未收录 | [原证据](compact_aw_v9\physical_p3r0_inc_v4_01\TERMINAL_MANIFEST.json) |
| compact_v4_p2_followup_p2r0 | route_failure | 1/1 | 640 | 未知/未收录 | [原证据](compact_aw_v4_p2_followup\physical_p2r0_01\TERMINAL_MANIFEST.json) |
| compact_v4_p3r1_followup_p3r0 | route_failure | 1/1 | 4609 | 未知/未收录 | [原证据](compact_aw_v4_p3r1_followup\physical_p3r1_01\TERMINAL_MANIFEST.json) |
| compact_v10_p3r0 | route_failure | 1/1 | 2496 | 未知/未收录 | [原证据](compact_aw_v10\physical_p3r0_01\TERMINAL_MANIFEST.json) |
| compact_v10_pp1mf60r0 | route_failure | 1/1 | 655 | 未知/未收录 | [原证据](compact_aw_v10\physical_p1r0_mf60_01\TERMINAL_MANIFEST.json) |
| compact_v4_p3mf60_followup_p3r0 | fullroute_timing_failure | 0/1 | 未知/未收录 | 49.456 | [原证据](compact_aw_v4_p3mf60_followup\physical_p3r0_mf60_01\TERMINAL_MANIFEST.json) |
| compact_v4_timing_p3r0 | cancelled_resource_priority | 1/1 | 未知/未收录 | 未知/未收录 | [原证据](compact_aw_v4_timing\physical_p3r0_01\TERMINAL_MANIFEST.json) |
| compact_v4_loc3_followup_p3r0 | vendor_failure_unclassified | 1/1 | 0 | 未知/未收录 | [原证据](compact_aw_v4_loc3_followup\physical_p3r0_inc_loc3_01\TERMINAL_MANIFEST.json) |
| compact_v4_incplace_loc3_followup_p3r0 | cancelled_duplicate_fallback | 1/1 | 未知/未收录 | 未知/未收录 | [原证据](compact_aw_v4_incplace_loc3_followup\physical_p3r0_incplace_loc3_01\TERMINAL_MANIFEST.json) |
| compact_v4_p1_followup_p1r0 | route_failure | 1/1 | 1069 | 未知/未收录 | [原证据](compact_aw_v4_p1_followup\physical_p1r0_01\TERMINAL_MANIFEST.json) |
| compact_v4_partial_floorplan_followup_p3r0 | fullroute_timing_failure | 0/1 | 未知/未收录 | 45.46 | [原证据](compact_aw_v4_partial_floorplan_followup\physical_p3r0_partial_01\TERMINAL_MANIFEST.json) |
| compact_v4_data_routing_followup_p3r0 | route_failure | 1/1 | 306 | 未知/未收录 | [原证据](compact_aw_v4_data_routing_followup\physical_p3r0_data_route_01\TERMINAL_MANIFEST.json) |
| compact_v4_data_routing_followup_p2r0 | route_failure | 1/1 | 1042 | 未知/未收录 | [原证据](compact_aw_v4_data_routing_followup\physical_p2r0_data_route_01\TERMINAL_MANIFEST.json) |
| compact_v11_p3r0 | route_failure | 1/1 | 1012 | 未知/未收录 | [原证据](compact_aw_v11\physical_p3r0_01\TERMINAL_MANIFEST.json) |
| compact_v12_p2r0 | route_failure | 1/1 | 941 | 未知/未收录 | [原证据](compact_aw_v12\physical_p2r0_01\TERMINAL_MANIFEST.json) |
| compact_v12_p3r0 | route_failure | 1/1 | 1620 | 未知/未收录 | [原证据](compact_aw_v12\physical_p3r0_01\TERMINAL_MANIFEST.json) |
| compact_v13_p3r0 | route_failure | 1/1 | 2903 | 未知/未收录 | [原证据](compact_aw_v13\physical_p3r0_01\TERMINAL_MANIFEST.json) |
| compact_v13_p2r0 | route_failure | 1/1 | 1032 | 未知/未收录 | [原证据](compact_aw_v13\physical_p2r0_01\TERMINAL_MANIFEST.json) |
| compact_v13_map1_p3r0 | route_failure | 1/1 | 2959 | 未知/未收录 | [原证据](compact_aw_v13_map1\physical_p3r0_01\TERMINAL_MANIFEST.json) |
| compact_v13_map1_p2r0 | route_failure | 1/1 | 713 | 未知/未收录 | [原证据](compact_aw_v13_map1\physical_p2r0_01\TERMINAL_MANIFEST.json) |
| compact_v13_native_p3r0 | route_failure | 1/1 | 2903 | 未知/未收录 | [原证据](compact_aw_v13_native\physical_p3r0_01\TERMINAL_MANIFEST.json) |
| compact_v4_native_p3r0 | fullroute_timing_failure | 0/1 | 未知/未收录 | 49.456 | [原证据](compact_aw_v4_native\physical_p3r0_01\TERMINAL_MANIFEST.json) |
| compact_v4_clockbuf1_followup_p3r0 | fullroute_timing_failure | 0/1 | 未知/未收录 | 49.283 | [原证据](compact_aw_v4_clockbuf1_followup\physical_p3r0_clkbuf1_01\TERMINAL_MANIFEST.json) |
| compact_v4_rep1_followup_p3r0 | route_failure | 1/1 | 1117 | 未知/未收录 | [原证据](compact_aw_v4_rep1_followup\physical_p3r0_rep1_01\TERMINAL_MANIFEST.json) |
| compact_v4_fan100_native_p3r0 | route_failure | 1/1 | 707 | 未知/未收录 | [原证据](compact_aw_v4_fan100_native\physical_p3r0_01\TERMINAL_MANIFEST.json) |
| compact_v14_p3r0 | route_failure | 1/1 | 480 | 未知/未收录 | [原证据](compact_aw_v14\physical_p3r0_01\TERMINAL_MANIFEST.json) |
| compact_v14_p2r0 | route_failure | 1/1 | 778 | 未知/未收录 | [原证据](compact_aw_v14\physical_p2r0_01\TERMINAL_MANIFEST.json) |
| compact_v4_incplace_native_p3r0 | cancelled_orphan_after_runner_assertion | 未知/未收录/1 | 未知/未收录 | 未知/未收录 | [原证据](compact_aw_v4_incplace_native\physical_p3r0_01\TERMINAL_MANIFEST.json) |
| compact_v15_p3r0 | route_failure | 1/1 | 314 | 未知/未收录 | [原证据](compact_aw_v15\physical_p3r0_01\TERMINAL_MANIFEST.json) |
| compact_v16_p3r0 | route_failure | 1/1 | 507 | 未知/未收录 | [原证据](compact_aw_v16\physical_p3r0_01\TERMINAL_MANIFEST.json) |
| compact_v17_p3r0 | route_failure | 1/1 | 546 | 未知/未收录 | [原证据](compact_aw_v17\physical_p3r0_01\TERMINAL_MANIFEST.json) |
| compact_v18_dsp_followup_p3r0 | fullroute_timing_failure | 0/1 | 未知/未收录 | 48.148 | [原证据](compact_aw_v18_dsp_followup\physical_p3r0_dsploc_01\TERMINAL_MANIFEST.json) |
| compact_v20_p3r0 | route_failure | 1/1 | 813 | 未知/未收录 | [原证据](compact_aw_v20\physical_p3r0_01\TERMINAL_MANIFEST.json) |
| compact_v22_p3r0 | qualified_physical_pass | 0/0 | 未知/未收录 | 50.075 | [原证据](compact_aw_v22\physical_p3r0_01\TERMINAL_MANIFEST.json) |
| compact_v22_dsp_followup_p3r0 | route_failure | 1/1 | 2033 | 未知/未收录 | [原证据](compact_aw_v22_dsp_followup\physical_p3r0_dsploc_01\TERMINAL_MANIFEST.json) |

原始冻结索引、Manifest及失败日志均不改写。unknown-exit不补造退出码；取消不算正常完成；完整布线但setup失败不算合格。当前运行任务见[接续状态](../CONTINUATION_STATUS.md)。

最初v8验证驱动解析失败属于软件编排记录，单列在[更正回执](compact_aw_v8/ORCHESTRATION_CORRECTION.json)，不混入物理route失败计数。
