Scherrerll/acg720-fpga-flight-controller/analysis/20261026_z_aw_fix/build/compact_aw_v4_incplace_native/source_review.md

# v4 同源完整原生工程对照

55份源码逐字节等于冻结v4，仍为B3相对三文件变化：已证明的宽位Z抗积分饱和、共享水平INIT/reset wire1000/350及B4构建身份。普通未饱和P2算式、64位/Q16精度、保护/降级/着陆条件不改。该源曾完整布通49.456MHz、setup−0.220ns/32端点，因此仍不合格，不能下载。

本轮只换构建入口：保留原RTL工程，在一个真实gw_sh进程内完成SYN、实际网表审计成功后PNR。map2/replicate0/area/P3或P2/R0、50MHz/20ns、18引脚和唯一原radio_rx例外不改。原helper字节不动；流程审计区分实际原生SYN与旧VG导入，不改50MHz/五余量/端点/位流/引脚/B4身份/实际退出门。不补造独立SYN进程wait0。

功能由v4_release_proofs/RESULT.json绑定：新跑的准确v4 top13 root实际wait0；五场景、FRAC边界、四客户端及地面站测试按原已验证依赖哈希复用，无新仿真声明。所有失败、v4原始源和旧布通证据保留。

选择该对照是因它仍是最接近50MHz的完整布通参考。若原生流仍差少量时序，但实际完整路由成功，可进一步检查这个真实工程的布局/回标；不能伪造GUI状态或把49.456当50通过。当前只准备，未开始vendor或任何硬件操作。
