Scherrerll/acg720-fpga-flight-controller/analysis/20261026_z_aw_fix/build/compact_aw_v22/proofs_attempt01/five/cancel_and_takingoff/trace.csv

logical_ms | ch3 | new_collective | old_collective | target_mm | climb_mmps | new_iz_q16 | old_iz_q16 | bias_q16 | upper_rejects | lower_rejects
22 | 1684 | 1022 | 1022 | 308 | 770 | 0 | 0 | 1482143 | 0 | 0
33 | 1684 | 1138 | 1138 | 317 | 860 | 33916 | 33916 | 2868515 | 0 | 0
44 | 1684 | 1171 | 1171 | 328 | 950 | 72407 | 72407 | 4165305 | 0 | 0
55 | 1684 | 1203 | 1203 | 339 | 1040 | 115544 | 115544 | 5378301 | 0 | 0
66 | 1684 | 1234 | 1234 | 352 | 1120 | 163399 | 163399 | 6512918 | 0 | 0
99 | 1684 | 1022 | 1022 | 315 | 1390 | 0 | 0 | 1482143 | 0 | 0
110 | 1684 | 1214 | 1214 | 331 | 1480 | 61225 | 61225 | 2868515 | 0 | 0
121 | 1684 | 1249 | 1249 | 348 | 1560 | 127516 | 127516 | 4165305 | 0 | 0
22 | 1684 | 1022 | 1022 | 308 | 770 | 0 | 0 | 1482143 | 0 | 0
33 | 1684 | 1138 | 1138 | 317 | 860 | 33916 | 33916 | 2868515 | 0 | 0
44 | 1684 | 1171 | 1171 | 328 | 950 | 72407 | 72407 | 4165305 | 0 | 0
55 | 1684 | 1203 | 1203 | 339 | 1040 | 115544 | 115544 | 5378301 | 0 | 0
66 | 1684 | 1234 | 1234 | 352 | 1120 | 163399 | 163399 | 6512918 | 0 | 0
99 | 1684 | 1022 | 1022 | 315 | 1390 | 0 | 0 | 1482143 | 0 | 0
110 | 1684 | 1214 | 1214 | 331 | 1480 | 61225 | 61225 | 2868515 | 0 | 0
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
