Scherrerll/acg720-fpga-flight-controller/analysis/20261026_z_aw_fix/build/compact_aw_v19/source_review.md

# v19: exact AZ guard composed with v17 landing and fanout changes

The frozen v4 source55 is the functional baseline. The candidate preserves the three v17 core files byte for byte and copies the proven v9/v8 pose-time adapter, navigation consumer and shared height consumer byte for byte. The top is exact v9 with the existing v17 previous_pose_valid syn_maxfan10 comment merged once. Seven files differ from v4; ten differ from B3; the other48 v4 files are byte-identical. No VY changes are present.

There is one new registered same-publication AZ predicate bit. This is new predicate state, so this candidate must not be described as having no new state. Every legacy public output retains its original publication cycle. The flag is initialized/reset/cancelled to1 beside output_az0, publishes the exact signed32 inclusive +/-30000 expression beside held_az, and holds beside the public AZ during fault, start-while-busy, nonfinal busy and idle branches. Acceleration validity remains independently governed by the original branches. Default PRECHECKED_AZ_RANGE=0 callers select the original numeric expression; the native top enables1 and passes the matching public tuple flag. All full32-bit axes, original Q16 precision and64-bit arithmetic remain unchanged.

SOURCE_EQUIVALENCE_BASIS records every normalized edit and mechanically reverses the complete edit inventory to frozen v4. That establishes source scope and unchanged residual only. It does not prove correctness of the new predicate register or consumer replacement. Guard correctness instead relies on exact copied module bodies and the actual producer444003-cycle invariant plus full height-fusion3194862-cycle differential evidence, whose current sources, logs, receipts and successful completion02 root are separately rehashed in GUARD_REUSE_RECHECK. Original v8/v9 failed roots remain bound as actual failure1; their successful continuation/retry roots are distinct actual wait0 records.

Landing logic retains the exact v17 two-branch threshold distribution, default-off interface, same numeric1250 threshold and original FSM priorities. The same-value fallback fanout wire and previous-pose synthesis comment add no core state or cycle. A fresh candidate old/new/default full-state FSM miter, real fallback implication and all16-bit threshold values are required; the landing algebra statement covers hardware binary inputs and does not assert arbitrary X-state equivalence.

The already fresh v19 top13 may be reused only after exact source55, path-only driver derivation, original-v4 TB bytes, result/log hashes and actual compile/vvp/root exits are rechecked. Its documented private forces include gate readiness/counts, controller state/cancel and decoded RX/core dependencies; this is gate and wiring evidence. Producer/fusion tests use no DUT force or private preload, but the fusion component fixture accelerates timer/sample admission while retaining actual11000us integration and real math services. Neither component proof nor top13 establishes unforced full-flight behavior, real50MHz timing or installation acceptance.

SYN-only preparation retains the original B4 helper and v2 mapped/gain/port auditor hashes, clk50 FF checks, radio synchronizers, default XY1000/350 and18-port checks. The exact ten B3-relative source changes are checked before any vendor call. A fresh SYN and later complete real50MHz physical qualification are separate requirements; no vendor process is launched by this preparation.
