Scherrerll/acg720-fpga-flight-controller/analysis/20261026_z_aw_fix/build/compact_aw_v12/source_review.md

# v12：下一年龄谓词的等价比较

仅将v11普通自增分支的f(age+32d1)改为AGE_LIMIT!=0 && age<(AGE_LIMIT-32d1)。分支原有age!=FFFFFFFF保证32位无符号加一不溢出；对L=0，两式对已初始化的已知年龄均为0；对非零32位L，A+1<L等价A<L-1。减数32d1令结果保持32位无符号，保留原integer参数参与比较时的无符号转换，含高位为1的参数。饱和保持、初始化/cleanup与发布覆盖不动，原32位年龄及同拍新鲜性不变量保持。

不声称任意强制破坏内部年龄或不变量后的X状态等价。原源输入可以四态，但年龄只从已知初始化/复位值、常数0及已知年龄加一产生；这些分支优先级不改。将用从两份实际源提取的表达式检查九种integer阈值的随机32位及边界值，并重做完整融合差分/同拍超时及top13。控制器、生产者、所有算术服务和54个其他文件完全不变。

动机是v11 age10到新位D的映射组合拓扑10级，局部高度融合+1FF/+45LUT；全顶层+789LUT中大部分来自跨模块重排，不能称作此加法器直接成本。去除比较前加一有明确逻辑取舍，但最终资源/延迟仍以新综合与完整物理报告判断。当前无综合、布线或下载资格。
