Scherrerll/acg720-fpga-flight-controller/analysis/20261026_z_aw_fix/build/compact_aw_v13/source_review.md

# v13：MTF同拍年龄谓词

仅改v12的sensor/mtf01p_reader.v年龄块与两个内部比较。原全32位age_ms、重复时间戳不刷新、样本计数、解析器/度量算术、UART、诊断hold/reset、外部接口全部保留。新增两位始终等于(age_ms<1000)/(age_ms<200)。初始化和reset的FFFFFFFF两位均0；真正新时间戳与age=0同拍置1；非饱和tick分支下一年龄不溢出，分别按旧age<999/199计算下一谓词；饱和与非tick分支保持。分支优先级原样，公开模块在线/新鲜度撤销和恢复均不增加周期。

依据实际v4 clockbuf1完整raw TR Path6：mtf/age_ms_21_s1至staged_telemetry.extension_q_814_s0，setup -0.242ns，18级，数据路由13.026ns，占64.536%。前两级为mtf/module_online_s13/s4，随后经过metric有效性、geometry、nav_xy_ready和xy_active。该名称可由综合共享比较产生，不能仅据名称断言是1000ms而非200ms比较；本候选精确缓存这两个既有谓词。v12未修改此生产者文件，因此这是有独立raw依据的局部后续尝试，不从拓扑推断STA通过。

将用两份实际完整源通过真实UART帧比较所有公开输出与内部年龄/两个新鲜度条件，覆盖两个诊断reset模式、hold、有效/重复/损坏帧、199/200和999/1000超时及同拍恢复。独立提取实际年龄逻辑检查全32位边界/随机转移和不变量，再重做top13。其他控制/融合/算术文件按哈希复用v12及其依赖证明。已初始化可达年龄为已知值，不声称任意强制破坏内部不变量后的四态年龄等价。共享水平默认与Z抗饱和不改，低空前飞掉高仍不处理。当前只是未验证的源候选，不具综合/布线/下载资格。
