Scherrerll/acg720-fpga-flight-controller/analysis/20261026_z_aw_fix/build/compact_aw_v9/source_review.md

# v9：已布通v4控制器与同拍范围标志

v7 P3/P2剩447/568未布通；v8 P3剩1271未布通。它们没有新TR，不能从数量认定单网根因。v8 P2仍独立运行。下一条有依据的实现路径以v4 P3完整route/49.456MHz/setup−0.220ns为参考，加入修复该raw关键路径的v8同拍az范围标志。

v9的控制器逐字节为v4 hold ffddb029…，不采用v5的num50/value39和v7的进一步I/bias窄存储。MA34/MB28与signed64算术别名保持v4实现。较宽的控制器存储换取回到曾布通的逻辑基线，尚不保证新布局布线成功。

另外四个改动文件逐字节来自已完成生产者444003拍、真实融合3194862拍及top13验证的v8；它们不增加延迟。其他50文件在v4/v8间完全相同。P/I=0.1000/0.0350、抗饱和算法、原保护和50MHz约束保留。

v9重新执行真实控制器五场景、FRAC0/16边界、四客户端非零XY/Z积分与顶层13门。生产者/融合的原文件与共享运算依赖完全相同，按哈希复用v8证明。新SYN必须重新审计全部时钟、同步器、增益、18端口，物理资格仍需独立完整route与五类时序门。
