Scherrerll/acg720-fpga-flight-controller/validation/20261028_flight_followup/README.md

# 2026-10-28：B0B4 试飞与供电复盘

本记录补充已推送的 B0B4 50 MHz 固件和硬件安装验收后的试飞及供电排查。固件提交为 `e8fcb45`，完整 Flash 和冷启动证据提交为 `66a54d3`，安装记录见 [20261028_b0b4_install](../20261028_b0b4_install/README.md)。本轮没有修改固件、时钟、混控或 P/I 参数。

## 地面站恢复

用户报告网页没有数据。检查发现本地8765端口无监听、Python接收服务已停止，COM17电台仍存在。重新启动 `ground/B0B4/launch.py`，使用 SiK/COM17/115200、B0B4参数入口和8765端口，页面恢复实时姿态、遥控、测距/光流显示。新GET实际读回0000B0B4、P=0.1000/I=0.0350、generation0。该操作是接收服务恢复，不是重新烧录或参数SET；未配置系统自动启动。

## 上午试飞

08:43:47～08:44:11 有约 24 秒解锁记录，固件的 flying 标志持续约 19.5 秒；飞行期间没有发现 IMU 或控制器故障，也没有重启。中段目标高度为 1.177 m，融合高度约为 0.939～1.125 m，该时间窗口的绝对误差中位数为 8.5 cm。

输出余量较紧，末段 Z 输出达到 1850 μs，部分电机达到 2000 μs。下降末段出现融合资格退出和高度失效降级，最终 CH5 低位撤销解锁，四路 PWM 回到 1000 μs。

完整解释和采样限制见 [上午复盘](morning_flight_review.md)。这段记录不能单独证明最低油门下降或自动落地已全面通过验收。

## 傍晚低空升力不足与充电反馈

18:35:37～18:36:09 和 18:36:35～18:36:58 两段解锁期间，Z 总量的中位数均为 1850 μs。后一次 XYZ 有效的 98 个同序列组合样本中，有 85 个达到 1850 μs；CH3 中位数约为 1995.5，目标高度约为 2.3～2.5 m，融合高度约为 0.3～0.5 m。控制器故障、姿态故障和 IMU 拒绝计数均为 0。日志支持“当前输出范围内爬升余量不足”的判断，但不能仅凭指令值区分电池、动力和重量因素。

用户确认，当时使用的是上午试飞过、之后没有充电的同一块电池，随后反馈：“好了，充完电就好了”。充电后恢复的反馈支持电池电量和带载供电余量是本次表现的重要因素。本轮没有测量电池电压、电机转速或推力，因此不能据此排除其他动力因素，也没有据此调高 1850 μs 上限。

## 保存范围

`summary.json` 保存分段统计、原解码日志已读取前缀的长度和 SHA256，以及用户的充电反馈。`input_manifest.json` 绑定该统计和上午报告的原始字节。原始无线流、持续接收日志、截图及临时构建和测试缓存留在本地，没有混入本次 Git 提交。正式飞行资格仍未完成。
