Scherrerll/acg720-fpga-flight-controller/firmware/B0B2/VALIDATION.md

# B0B2 验证记录与未完成项

## 已复现并修复的机制

`tests/run_policy_tests.py` 用冻结 B0B0 和候选 B0B2 的实际输入管线、guard、估计器及算术模块做对照。物理读数接口施加相同刺激，保持 50MHz 和真实 60ms 截止；仅将校准样本数缩为 2 以缩短启动仿真。结果绑定在 `evidence/policy_tests.json`，可用 `--verify-existing` 只读复核输入、工具、日志和源码哈希。

| 90 次合法交替加速度输入 | 接受 | 拒收 | 姿态发布 | 末态 link |
| --- | ---: | ---: | ---: | ---: |
| 冻结 B0B0 | 16 | 74 | 0 | 0 |
| B0B2 | 90 | 0 | 90 | 1 |

此外覆盖启动运动、正常动态、加速度重力纠正外窗中的 gyro 积分、gyro 回零、显式读取错误、完整全零/全一、错误 ID、20/30ms 空窗、真实 60ms 丢失、五个合格样本恢复、重建重力、计算冲突、样本身份和 dt 对应。`evidence/temporal_contract.json` 独立检查三拍锁存、1–3 拍碰撞、最小四拍输入间隔和旧参数兼容。

这些结果证明上述拒收机制已经改变且对应保护仍工作。它们不能证明真实 SPI 数值从不受污染，也不能证明两次实飞偏移只有这一个原因。

## 被动诊断版本2的范围

当前两项观测源码改动及旧版完整归档由`evidence/v2_integration.json`绑定，其余51个源文件与copy99/v1逐字节相同。实际tap驱动的12万拍对照证明保留的448位payload及capture tick一致，两个已声明不可用的32位槽恒零；这是一项明确的投影等价，不能写成完整512位等价。

独立影子综合观察到寄存器27716→27460（减少256）、LUT35924→35735（减少189）、ALU9206→9237（增加31），DSP和BSRAM数量不变。增加的ALU位于诊断计数映射，不能由此声称全部综合网表映射不变。正式工程仍须重新综合、布线和STA，影子综合不构成安装资格。

`tools/analyze_bench.py`只读分析显式选定的JSONL及UTC区间，要求至少60秒稳定覆盖，并联合核对接受/发布/消费序号、20ms源龄与dt筛查、首因、停机RC/PWM及丢帧。旧全局最大空窗或已占用首因不能用于证明后续无故障；仅解码JSONL无法给出CRC错误数。分析结果始终不授权安装或飞行，真实60ms保护阈值也没有因此改变。

## 以前能自稳、后来出现问题的解释边界

B0AC 到 B0B0 确实改过起飞状态、自动起飞、垂直控制和水平速度 PI 的部分行为；自动起飞阶段还调整了 rate Ki。比较证据保留在 `../B0B1/evidence/b0ac_to_b0b0.json`。本次发现的 temporal 拒收与 guard 在这两个版本中相同，估计器数值方程未因这些修改改变。

其中一项明确改动是 XY 控制器默认 `MAX_ANGLE` 从 1200 改为 2500（12° → 25°），而当前光流几何有效范围是各轴 ±1500。冻结 B0B2 的实际控制器在中心杆、yaw/acc=0、20ms 回调下，以 −1200mm/s 的控制器输入产生约 −1810cdeg 目标；下一次 −2000mm/s 输入达到 −2500cdeg 限幅。这是控制器输入的合成复现，不代表原始 MTF 测量或真实机体动力学。它确认了目标范围和观测有效范围不一致，尚未证明完整实飞因果。

因此，不能把以前一次成功自稳和此次失败简单等同为“最近新加了这段拒收”。不同振动、运动和控制模式可能触发已有缺陷；过去未记录程序身份的飞行也不能用于精确归因。后续网站显示修改不会改变已固化的 FPGA 控制代码。

B0B2 的控制修改仅为输入策略；起飞、增益、混控、光流控制、融合及落地锁继续保持 B0B0。详见 `POLICY.md` 和 `evidence/design_source.json`。

## 飞行前还需取得的证据

1. 新位流独立通过完整布线、单一 19.5ns 时钟、setup/hold 及其余 STA 类别、原 17 个引脚约束。B0B0 的既有时序结果不能代替。
2. 取得当次拆桨和遥控低档确认后，临时 SRAM 加载并核对 JTAG 身份、SiK 程序身份及停机状态；暂不写 Flash。
3. 拆桨静止与人工运动验证输入接受、姿态发布、保护恢复及光流轴向。地面不能复现的现象必须记为“未复现”。
4. IMU 链路可靠后，核对光流旋转影响、动态融合以及水平目标倾角和光流有效范围的一致性。第二次试飞日志出现目标超过 15° 后实测越界并退出光流，尚不能据此证明具体限幅或积分处理就是首因。

载荷振动和实际定点性能仍需独立验证。静态、仿真或拆桨结果均不等于已完成飞行验收。SRAM 程序在整机断电后消失；重启默认仍为 Flash 中的 B0B0，试验必须以新鲜遥测身份为准。
