Scherrerll/acg720-fpga-flight-controller/validation/20261024/dynamic_validation/动态采样结果.md

# B0B0 拆桨动态采样结果

最新追加的一分钟静止观察：连续 60 秒、301 份导航快照，融合位置相对本次起点净偏移 **4.40 mm**，过程中最大偏移也是 4.40 mm；融合速度 X/Y 均方根约 0.99/1.06 mm/s。全程未解锁，模块和控制错误计数无新增。详见 [一分钟融合静止结果](minute_20261024T040533Z/一分钟融合静止结果.md)。本段没有改动固件，下面较早的 20 秒记录仍作为不同时间条件下的观测保留。

本轮完成未解锁横滚观察及两种地面纹理的静止对照，未确认新的 RTL 故障，未修改固件或模块参数。布线、时序和原有回归结论保持原范围，不把本轮观察记作飞行验收。

## 横滚观察

操作者确认拆桨、未解锁、低油门、SWA/SWC 低档，完成左右小角度横滚并放稳。当前设备全程上报 B0B0。

- 初始横滚约 +0.46°，观测范围 −3.73° 至 +4.56°，最后回到 +0.47°；俯仰最后约 +1.92°，与初始 +1.93°接近。
- 475 组接收快照中，IMU、姿态、测高及速度融合持续有效，四路命令和上报有效 PWM 均为 1000 μs。
- 模块 UART、校验、长度、超时、缺样、重复、重启与积分断点计数均没有增加。IMU 拒收计数增加 1，姿态故障、控制器故障与解锁门控计数没有增加。
- 独立重新解码 475 份原始 Micolink 载荷：报文结构、校验、时间、距离、状态、光流及有符号速度乘积全部相符，没有发现换算不一致。

记录包含拿起、放下及调整机架时的平移与偏航。横滚正向倾斜区间约 11.6 秒，原始模块累计双轴变化范围约 2.48/2.07 mm；负向区间包含其他运动，累计变化更大，不能当作纯旋转误差。未知镜头杆臂和手持平移没有被拟合或补偿。

## 两种地面纹理的静止对照

操作者分别确认固定有纹理地面无遮挡、印字纸铺平后各静止 20 秒。为避免把等待回复时间全部当作已确认静止，分析分别使用记录末段约 20 秒的数据。

| 指标 | 原表面 | 印字哑光纸 |
|---|---:|---:|
| 分析时长 | 19.79 s | 19.79 s |
| 接收快照 / 新模块包 | 100 / 1979 | 100 / 1979 |
| 模块累计 X/Y 变化 | −63.22 / +65.00 mm | +32.24 / +65.75 mm |
| 融合速度 X/Y 中位数 | +1.49 / +0.19 mm/s | +0.94 / −1.01 mm/s |
| 融合速度 X/Y 均方根 | 12.36 / 14.53 mm/s | 8.48 / 6.59 mm/s |
| 融合速度 X/Y 绝对值第 95 百分位 | 29.75 / 33.61 mm/s | 18.39 / 14.84 mm/s |
| 测距中位数 | 215 mm | 202 mm |
| 光流质量范围 | 77–97 | 86–95 |

两段中，IMU、测高、速度融合均持续有效，四路始终为 1000 μs，模块错误计数均无新增。两份完整采集窗口分别独立校验 1375 和 706 个原始载荷，全部与 FPGA 上报速度整数乘积一致。

换纸后观测到融合速度波动减少，支持表面或输入条件影响观测的解释；这是一组短时对照，不能单独证明具体噪声来源。两段上报测距中位数也有变化，不能视为严格的恒定距离光学台架试验。未测量照度、电源噪声或镜头状态，未声明模块硬件故障已定位。

厂家的[MTF-01P 手册](https://micoair.cn/zh/docs/sensors/sensors/mtf-01p-sensors)给出光流最小距离 8 cm、环境光要求大于 60 Lux、数据频率 100 Hz；当前上报距离高于该最小距离，现场照度未独立测量。[Micolink 定义](https://micoair.cn/zh/docs/sensors/micolink)给出的速度单位是 cm/s@1m，换算为本工程单位即 `speed_mm_s = raw_flow * distance_mm / 100`，与本轮独立检查相符。

## 对代码和下一步的影响

### 追加：融合后的位置与速度（按操作者要求重点核对）

同一纸面静止窗口里，实际融合速度 X/Y 均方根约 8.48/6.59 mm/s，平均残余速度约 +2.23/−2.57 mm/s；各轴绝对值第 95 百分位约 18.39/14.84 mm/s。速度波动较小，但残余速度积分仍会形成位置偏移。

直接读取融合速度对应的 Q8 位置积分输出，19.8 秒 X/Y 变化约 +50.10/−54.44 mm，合计约 **73.98 mm（7.4 cm）**；原表面对应融合位置净偏移约 **83.26 mm（8.3 cm）**。前文 7.3/9.1 cm 指原始模块坐标累计量，与这里的融合局部坐标输出属于不同数据层。不能把速度波动下降比例写成位置漂移同比下降。

当前 XY 速度 PI 使用融合速度；上述位置积分输出不是固定坐标位置外环。静止观测不能直接换算为带载悬停位置误差，也没有独立的预设精度验收门槛。操作者最新关注点是融合结果是否足够小，本记录给出速度与位置两类实测量，不擅自替操作者设定放行阈值。详细数值与证据绑定在 `fused_drift_review.json`。

当前 ANO 水平控制消费融合速度，未用上述诊断位置积分构成回到固定坐标的外环。累计位置在静止时变化不能单独证明 RTL 有故障，也没有预先约定的“必须为零”精度门槛。本轮没有证据要求修改单位、原厂比例或直接增加陀螺扣除。

本轮没有重新实测 B0B0 带动力纠偏方向。旧 B0AB 的位置外环纠偏记录仅作历史参考；B0AE 曾按操作者要求不重复方向测试，不将其写成新固件已经重新实测通过。本轮未解锁观察不能代替带动力闭环、带载或飞行验证。

旋转分量补偿语义仍未量化验收：A583 是接收时刻配对的 5 Hz 快照，不是曝光同步的完整陀螺积分；未知镜头杆臂也未测量。后续需要在实际控制验证中保留这些限制，而不是为了消除显示漂移改动工厂系数。

保留当前原厂参数和 B0B0 固件，停止重复静止/手持试验。本轮没有新增电机操作、下载或 Flash 写入。当前镜像仅在 SRAM；断电会回到 B0AC。带载与飞行验收仍未完成。

## 证据

- `roll_20261024T033604Z/review.json`：横滚全过程、状态及计数。
- `roll_20261024T033604Z/payload_and_phases.json`：独立载荷和分段检查。
- `static_20261024T034051Z/static20_review.json`：原表面静止末段。
- `static_20261024T034852Z/static20_review.json`：纸面静止末段。
- 各采样目录保存 `start.json`、`end.json` 和 `selected_telemetry.jsonl`，包含源日志字节偏移及 SHA256。
- `historical_pitch_20261021/review.json`：历史俯仰参考及与当前接收模块的源码对照；未冒充当前整机新验收。
