Scherrerll/acg720-fpga-flight-controller/firmware/B0B2/evidence/policy_v3_offline_20261025/FINAL_RESULT.md

当前结论：已能布通，50MHz 时序仍未解决。

已将可迁移的优化与用户确认的超时策略落入当前 B0B2 源码。保留的配置为 P4/R0、资源复制关闭，原 17 引脚和 19.5ns 时钟约束保持。供应商正常结束、零未布通、位流身份与引脚检查通过，但 Fmax 仅 39.234MHz；setup 有 1,194 个违例，最差余量 −5.988ns。hold、recovery、removal、最小脉宽均无负余量。

实际 RTL 的策略回归、启动和坏帧/数值拒绝、真实 dt 与恢复、RC/MTF/控制及几何边界检查通过。实际顶层字节状态机输出 644B/7 帧，接收解析与年龄 unavailable/null 语义通过。未伪造样本、dt 或新鲜度。

| 试验 | 未布通 | Fmax MHz | setup 违例 |
|---|---:|---:|---:|
| final_p1r0 | 634 | 无完整时序 | — |
| final_p3r0 | 1910 | 无完整时序 | — |
| final_p4r0 | 0 | 39.234 | 1194 |
| final_logic_globals_p2r0 | 540 | 无完整时序 | — |
| final_live_globals_p4r0 | 313 | 无完整时序 | — |
| final_replicated_p4r0 | 0 | 31.011 | 2029 |
| pwm_timing_candidate_v2/pwm_p4r0 | 0 | 30.385 | 1937 |
| pwm_timing_candidate_v2/pwm_live_globals_p4r0 | 0 | 37.923 | 1522 |

PWM 第二版通过了 4,194,304 组组件选择/锁存用例、额外 40,000 周期对比，以及实际 flight_core 的原始命令遥测/锁存/PWM 集成对比；但两种物理配置均更慢，因此没有合入。第一版的遥测反例与取消凭据保留。

当前最佳最差路径：IMU 资格有效位 → 姿态/导航有效性 → 高度回退 → 输出锁存，数据路径约 81% 延迟来自连线。资源复制的较差结果把最差路径转移至遥测 bank 选择，PWM 定向副本又转移至偏航有效位和导航控制事件；现有措施不足以完成全局时序收敛。

没有任何候选通过完整物理验收。源码、综合网表哈希、准确配置、完整 STA 和各组失败证据均已保存；没有下载、刷 Flash、串口操作、上电或电机操作。
