Scherrerll/acg720-fpga-flight-controller/firmware/B0B0/provenance/bound_evidence/cacf23b1e2ba_published_anchor_validation.md

Published collective anchor repair

Only core/flight_core.v and core/height_loss_fallback.v differ from the diagnostic-reset candidate. The exact legal1000..1850us collective is retained on the same controller_update edge that publishes motor commands. A height-loss entry immediately selects this held fallback collective at the mixer, including when an automatic result was already queued. The below1200us entry remains exact; its lower unsigned division numerator is zero, and the existing1200us target clamp plus1us/ms slew raises it gradually. Stop, RC, IMU, arming and landing gates are unchanged.

The final same directed bench fails10of13 checks against the preserved pre-fix RTL and passes13of13 after the repair. It tests first publication, loss-before-first-publication,1000/1100us anchors, an unpublished1500us pending request, queued result completion, exact four-motor continuity with nonzero attitude corrections (both clamped and unclamped outputs), and exactly1us increase after1ms. This bench forces controller-health and publication boundary inputs; the separate actual-core regression covers the real gate and pilot paths.

The existing component test now covers42,042 curve points across collective anchors1000,1100,1199,1200,1500,1850us and stick entry boundaries, endpoint reachability, entry continuity and slew. The actual core test passes healthy height loss, independent pilot input, latch/recovery, preflight block and immediate SWA/IMU/RC stops. Nominal B0AE comparison passes3,170,330 clocks including telemetry and all four actual PWM signals. Top elaboration and both UART/CRC tests pass.

Synthesis-only completed with35978 LUT,9261 ALU and27829 FF. Fresh actual mapped INIT/720bit/CE/Boolean output and freshness-to-PWM audits pass. The unchanged diagnostic optimization is qualified by immutable original-source actual dual-top/bank evidence plus an explicit current-context algebraic reset-induction bridge. The redundant current-core full-top rerun was cancelled incomplete and is not counted as passed. Full routing/timing and hardware acceptance remain outstanding; no hardware action is authorized by this report.
