Scherrerll/acg720-fpga-flight-controller/validation/20261024/dynamic_validation/minute_20261024T040533Z/一分钟融合静止结果.md

# 一分钟融合静止结果

实际采集 60.0 秒，取得 301 份连续导航快照，相邻机上时间均为 200 ms。使用当前 B0B0 的融合速度 Q16 和对应位置积分 Q8，按本次起点计算变化。

| 项目 | 结果 |
|---|---:|
| 融合位置 X 净变化 | +3.66 mm |
| 融合位置 Y 净变化 | −2.44 mm |
| 末端合计净偏移 | **4.40 mm** |
| 过程中最大偏离起点距离 | **4.40 mm**，出现在 60 秒 |
| 融合速度 X/Y 均方根 | 0.99 / 1.06 mm/s |
| 融合速度 X/Y 绝对值第 95 百分位 | 1.93 / 2.05 mm/s |
| 融合速度 X/Y 最大绝对值 | 2.99 / 3.10 mm/s |

10、20、30、40、50 秒时的合计偏移分别约为 1.31、1.78、2.01、2.05、1.93 mm。

全程未解锁，四路命令及上报有效 PWM 为 1000 μs；位置、速度、高度有效性保持连续。模块新包计数增加 5994，UART、校验、长度、超时、缺样、重复、重启及积分断点计数均无新增；IMU 拒收、控制器故障、门控中断和撤销计数均无新增。301 份原始模块载荷独立检查全部相符。

本段上报横滚范围 0.41–0.47°、俯仰 1.89–1.96°，光流质量 106–127、测距 201–225 mm。此前两段约 20 秒记录在其他时段获得，仍完整保留；不能把本段更稳定的结果归因于已经修复算法，本轮没有改动固件、传感器系数或发送串口命令。

独立按保存的 A582 源记录重新计算起终点与时间：60 秒内融合积分位置由 (5138.27, 285.41) mm 变化到 (5141.93, 282.97) mm；不存在采样点处的坐标归零或有效性撤销。这里给出的是相对本次起点的偏移，不是上电以来的绝对累计值。

这段静止条件下的融合偏移很小。结果不包含电机振动、带载或飞行闭环；尚不能代替实际悬停验收。

原始数据与哈希见 `selected_telemetry.jsonl`、`review.json`、`independent_check.json`，连续采样条件见 `start.json`、`guard_polls.json`、`end_state.json`。
