Scherrerll/acg720-fpga-flight-controller/validation/20261026_b0b3_flash/README.md

# B0B3 Flash 固化记录 — 2026-10-26

用户在确认重启会丢失SRAM配置后，明确选择“长期呗，反正其他的都一样吧”，授权将先前验证的同一份B0B3固化到Flash。已说明固化来源不会改变同一B0B3镜像的运行逻辑，但相对旧P005不能称所有源码不变；P/I仍易失，重启恢复P=.05/I=0。操作说明见[长期调参入口](../../docs/B0B3_FLASH_20261026.md)。

## 镜像与原始边界

新镜像为 `firmware/B0B3/release/B0B3_selected_P3R0.fs`，SHA256 `a5b893b25a5e510348c8a4ac75c914b8a14473bbfb054b4cc4040b86800f64dd`，与本次先前SRAM验证完全相同。回退为原Flash的P005/I0镜像，SHA256 `a876c8ed073588e17b6289f8aac7573334a5d5e9c992d394d0d14f61ed17db7c`，并在独立校验旧Flash通过后才允许新镜像擦写。新镜像641项导出验真再次通过，55份源码与资格证据未改；没有重新编译固件、改动FPGA算法或替换旧资格报告。

## 执行前审查与回归

采用独立的本次操作脚本；未运行硬编码旧V15/P005目标的旧安装器入口。固定Gowin GW5AT-60B、唯一serial6下载器、每步重新枚举并核对下载线位置，镜像与programmer/helper SHA固定。只允许身份0、Flash重载1、回退SRAM2、外部Flash擦写校验54及独立校验66；Flash地址固定0x000000。Flash边界检查新鲜停机、CH3/CH5/CH7低位、摇杆居中、四路上报PWM和命令1000μs、参数服务无在途请求。

独立审查在实际操作前找出并修复两个恢复流程边界：首次预检失败不得意外重载设备；新Flash擦写标志不得在真正I/O边界前置位而误触发擦写回退。同时补充逐帧uptime倒退重新采集与bytes/str超时日志。固定最终脚本SHA256 `4a4adf876cc3912124fcb17f4a696962d6a4f1772e9af0c9e9bea9121cc77057` 通过15项纯mock回归、实际exit0，覆盖白名单、哈希与停机门禁、健康等待、精确次序、失败回退、unsafe停止及超时记录；测试不操作真实HTTP、串口或programmer。

第一轮实物预检发现CH5/SWA约1507μs中位，故在任何设备操作前拒绝；回执operations为空，device_change_started=false，未重载、未擦写。用户随后明确确认已将CH5/SWA拨到低位、其他拆桨及低位条件保持。第二轮使用同字节脚本，在新会话中重新检查后才执行。

## 实际Flash操作

第二轮下载器为VID0403/PID6014、serial6、COM22；当次新鲜下载线index1/location292，不作为下次操作常量。电台为COM17，继续由已有地面站唯一串口线程接收。既有遥测保留B0B2标签，JTAG与A591分别验证实际B0B3身份和参数能力。

执行0→1→等待旧镜像健康停机→0→66(P005独立校验)→1→等待停机→0→54(B0B3擦写及校验)→1→等待健康停机→0(B0B3)→66(B0B3独立校验)→1→等待健康停机→0(B0B3)。每次均记录真实退出码，要求exit0、Finished，无error/failed；54另要求明确Program and Verify Flash successfully，66要求Verify Flash successfully。新54用时50.867秒，新66用时12.983秒。最后ID为0001481B、UserCode为0000B0B3。未触发回退。

08:57:13通过地面站同一串口所有者执行一笔GET，收到A591/B0B3，P500/I0、generation0，证明从Flash重载后的默认参数接口可用。此阶段没有SET，没有恢复之前用户的P=.075，也没有电机、解锁、遥控或飞行命令。

## 物理断电启动

此项在软件重载和独立校验之后单独进行，需用户断开电池、板USB及下载器与板端连接，等灯灭5秒后仅电池重新上电，电脑端SiK保持连接。只读HTTP观察器记录断流和新uptime，以及新启动中的停机和IMU计数连续推进。最终是否通过由本目录 `completion.json` 与 `cold_boot/` 证据共同给出；不把programmer操作1记作物理冷启动。

## 证据与限制

本目录保存原始操作回执、脚本、mock测试与选择后的健康快照。大量厂商进度输出用确定性gzip压缩，清单同时绑定压缩与解压身份；原始全量文件在本地out会话中保留。完整持续遥测和原始无线流不上传。旧固件与先前地面站交付清单不改，新清单只记录本次新增文件及固定依赖。

Flash写入与独立校验仅证明指定启动镜像已固化，不能证明非默认增益、链路连续可靠性或带桨飞行效果。P/I参数存储仍按原协议易失；本次没有增加永久参数保存。归档脚本仅是当次受授权的操作过程，不是通用重烧入口，不应在归档目录重跑或复用历史授权说明。
