Scherrerll/acg720-fpga-flight-controller/validation/20261028_flight_followup/morning_flight_review.md

# B0B4 试飞日志复盘 — 2026-10-28

结论：最近这段短时试飞显示基本可控，与用户“感觉还可以”相符；飞行中未记录 IMU/控制器故障或重启。输出余量、下降末段高度降级仍值得保留关注，不能据此认定全部飞行与自动落地资格通过。

## 数据范围

读取地面站会话 `20261028T002255Z_6fde37ef` 的解码遥测与事件记录。分析脚本和输入文件已读取前缀的长度、SHA256 保存在 `analyze.py`、`analysis.json`，选中飞行段及前后数据保存在 `flight_samples.json`。未打开第二个串口、未发送参数或电机命令，也未修改固件。原始日志继续由地面站保留，没有上传。

本次有两段解锁记录：08:38:26～08:38:34 仅自稳、输出最高1200μs，没有上报 flying；最近一段为08:43:47～08:44:11，解锁约24.3秒。以下主要分析后者：118个主帧，软件 flying 状态覆盖08:43:51.807～08:44:11.332，约19.5秒。flying 是固件状态，不能代替对实际离地/触地时刻的物理测量。

## 主要发现

| 项目 | 日志结果 |
|---|---|
| 控制模式 | 97个主帧处于定点，末段短暂退至定高、自稳 |
| IMU / 控制器 | 飞行段 rejected_count、controller_fault_count、attitude_fault、imu_reason 均为0；未记录飞行中重启 |
| 姿态 | flying 样本横滚−7.89～+10.03°，俯仰−5.60～+13.71°，包含收油门末段；相对目标的绝对误差中位数分别0.65°、0.35° |
| 中段高度 | 08:43:58～08:44:08目标为1.177m，融合高度0.939～1.125m，绝对误差中位数8.5cm；该窗口仍包含爬升末段，不等同长期定高稳态精度 |
| 油门余量 | XYZ有效样本Z总量中位数1806μs；08:44:09.099～08:44:10.375共7个样本达到1850μs上限，随后回落。118个解锁主帧中有12帧至少一个电机指令达到2000μs |
| MTF传感器 | flying样本模块链路均有效；源年龄1～11ms，光流质量89～121。模块原始有效不等于每拍融合资格均有效 |
| 无线记录完整性 | 解锁段序列估计缺4个主帧，最大接收间隔约0.297秒；无此前那种长接收空窗 |

单个电机触顶与Z总量触顶是两个不同层次的限幅；前者还受姿态/偏航混控影响，不能据此推断某一电机或电池存在故障。5Hz左右的遥测也不足以排除更高频的振荡。

## 下降、停机末段

- 08:44:10.428：Z仍1850μs，目标高度1.058m、融合高度0.768m。
- 08:44:10.668：CH3约1179，Z降至1792μs，目标0.805m、融合高度0.657m，说明没有一直保持在1850上限。
- 08:44:10.767：横向融合资格短暂失效，XYZ退出，垂直控制仍有效；之后有定高状态。
- 08:44:11.235～11.370：CH3已到1000，高度融合资格曾失效一帧，`height_loss_fallback_active=true`，转入高度失效降级。此时导航Z=0是控制状态退出，不能解读成物理总油门已归零；电机仍有非1000指令。
- 08:44:11.528：CH5由高位降至1000，记录0x34“开关离开要求档位”，撤销解锁，四路实际上报PWM均为1000。随后的IMU diagnostic trigger=4对应gate事件，first_protection_code仍为0，不能误判为IMU读取故障。

末段原厂测距从约1m降到约0.18～0.26m，但日志本身无法确认触地、手接或其他外力的准确时刻。最低CH3到CH5关闭之间仅有约0.34秒接收记录，因此这次不能单独证明最低油门下降/自动落地问题已全面解决，也不能根据本次下降形状直接认定仍存在积分饱和。

建议结论保持为“完成一次短时试飞，基本可控，飞行日志未见IMU/控制器故障”；先保留当前参数作为基线。后续若要优化，优先明确末段降级和输出余量的影响，再决定是否调整，避免仅凭这一段日志同时改动多项参数。
