Scherrerll/acg720-fpga-flight-controller/validation/20261024/bench/hardware/flash_install_20261024T042524_170748Z/09_B0B0_program_verify.txt

 Target Cable: Gowin USB Cable(FT2CH)/0/353/null@2.5MHz
 Target Device: GW5AT-60B(0x0001481B)
 Operation "exFlash Erase,Program,Verify Arora V" for device#1...
 Status Code is: 0x30020020
 Try to program spi flash: 0xC22018!

 Reading BitStream File...: [                         ] 0%                 
 Reading BitStream File...: [#########################] 100%                 
 Programmning Flash starts from 0x000000.

 Programming...: [                         ] 0%                 
 Programming Flash...: [                         ] 0%                 
 Programming Flash...: [                         ] 0%                 
 Programming Flash...: [                         ] 0%                 
 Programming Flash...: [                         ] 0%                 
 Programming Flash...: [                         ] 0%                 
 Programming Flash...: [                         ] 0%                 
 Programming Flash...: [                         ] 0%                 
 Programming Flash...: [                         ] 0%                 
 Programming Flash...: [                         ] 0%                 
 Programming Flash...: [                         ] 0%                 
 Programming Flash...: [                         ] 0%                 
 Programming Flash...: [                         ] 0%                 
 Programming Flash...: [                         ] 0%                 
 Programming Flash...: [                         ] 0%                 
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
 Programming Flash...: [########                 ] 32%                 
 Programming Flash...: [########                 ] 32%                 
 Programming Flash...: [########                 ] 32%                 
 Programming Flash...: [########                 ] 32%
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
