Scherrerll/acg720-fpga-flight-controller/validation/20261024/bench/hardware/flash_install_20261024T042524_170748Z/13_B0B0_independent_verify.txt

 Target Cable: Gowin USB Cable(FT2CH)/0/353/null@2.5MHz
 Target Device: GW5AT-60B(0x0001481B)
 Operation "exFlash Verify Arora V" for device#1...
 Status Code is: 0x30020020
 Try to program spi flash: 0xC22018!

 Verify Flash...: [                         ] 0%                 
 Verify Flash...: [                         ] 0%                 
 Verify Flash...: [                         ] 0%                 
 Verify Flash...: [                         ] 0%                 
 Verify Flash...: [                         ] 0%                 
 Verify Flash...: [                         ] 0%                 
 Verify Flash...: [                         ] 0%                 
 Verify Flash...: [                         ] 0%                 
 Verify Flash...: [                         ] 0%                 
 Verify Flash...: [                         ] 0%                 
 Verify Flash...: [                         ] 0%                 
 Verify Flash...: [                         ] 0%                 
 Verify Flash...: [                         ] 0%                 
 Verify Flash...: [                         ] 0%                 
 Verify Flash...: [                         ] 0%                 
 Verify Flash...: [                         ] 0%                 
 Verify Flash...: [                         ] 0%                 
 Verify Flash...: [                         ] 0%                 
 Verify Flash...: [                         ] 0%                 
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
 Verify Flash...: [##                       ] 11%                 
 Verify Flash...: [##                       ] 11%                 
 Verify Flash...: [##                       ] 11%                 
 Verify Flash...: [##                       ] 11%
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
