Scherrerll/acg720-fpga-flight-controller/ground/B0B4/ui-verification/mobile-log-analysis.jpg

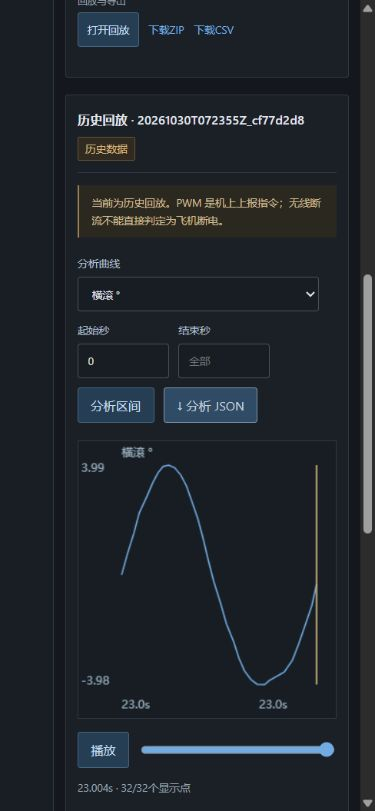
ground/B0B4/ui-verification/mobile-log-analysis.jpg
