Scherrerll/acg720-fpga-flight-controller/ground/B0B4/ui-verification/mobile-logs.jpg

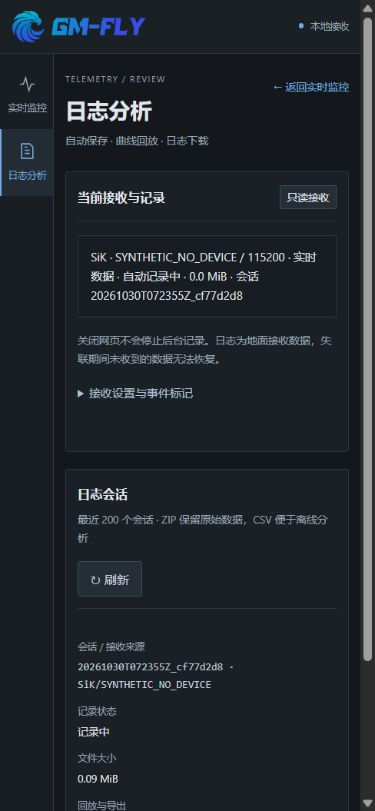
ground/B0B4/ui-verification/mobile-logs.jpg
