Scherrerll/acg720-fpga-flight-controller/ground/B0B4/ui-verification/parameters-mobile.jpg

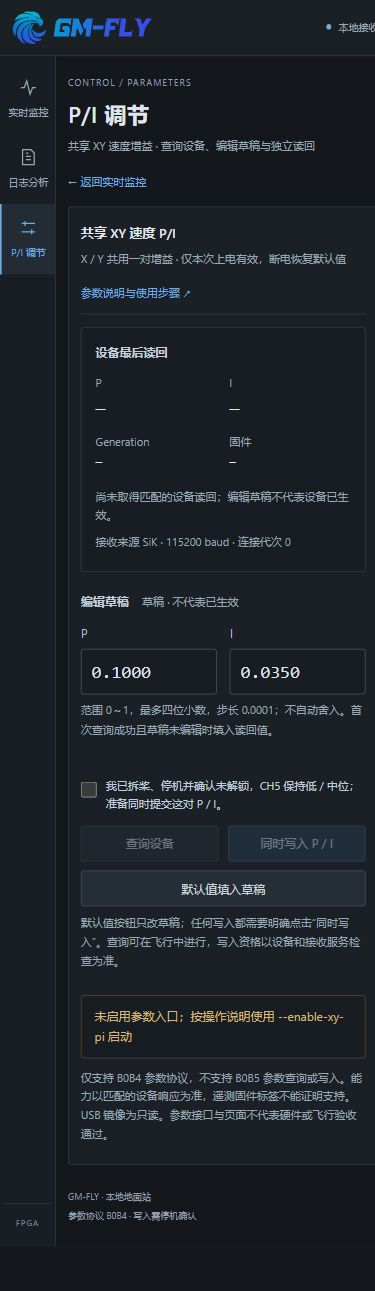
ground/B0B4/ui-verification/parameters-mobile.jpg
