Scherrerll/acg720-fpga-flight-controller/validation/20261026_xy_pi_ground/bench/live_ground_station.png

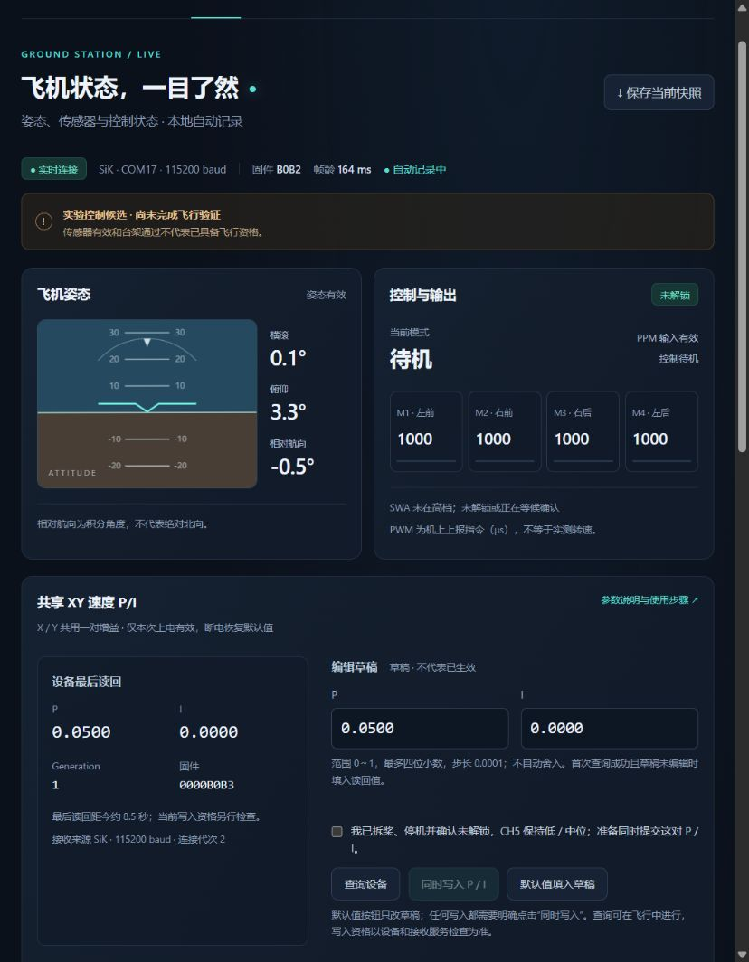
validation/20261026_xy_pi_ground/bench/live_ground_station.png
