Scherrerll/acg720-fpga-flight-controller/validation/20261026_xy_pi_ground/bench/user_pi_0075_verified.png

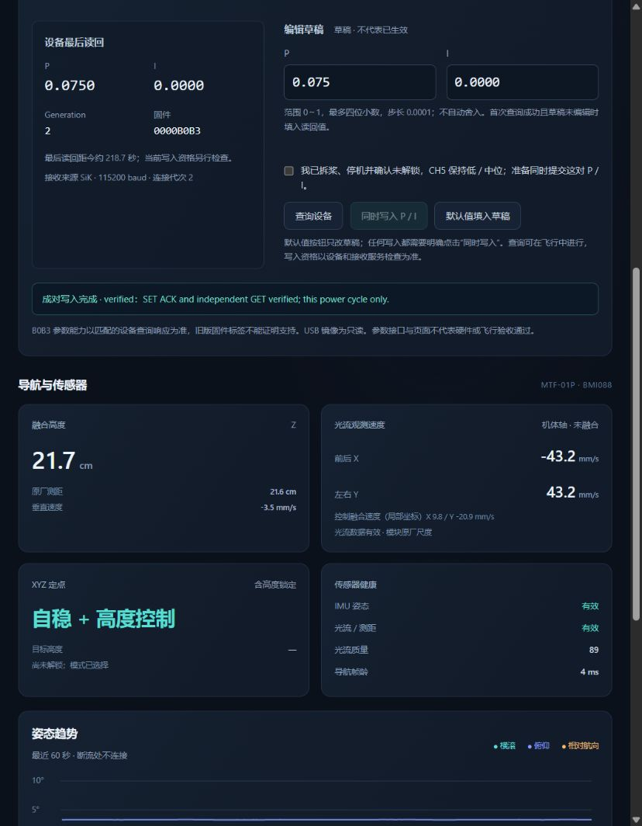
validation/20261026_xy_pi_ground/bench/user_pi_0075_verified.png
