Scherrerll/acg720-fpga-flight-controller/web/gmflylog-live-verified.png

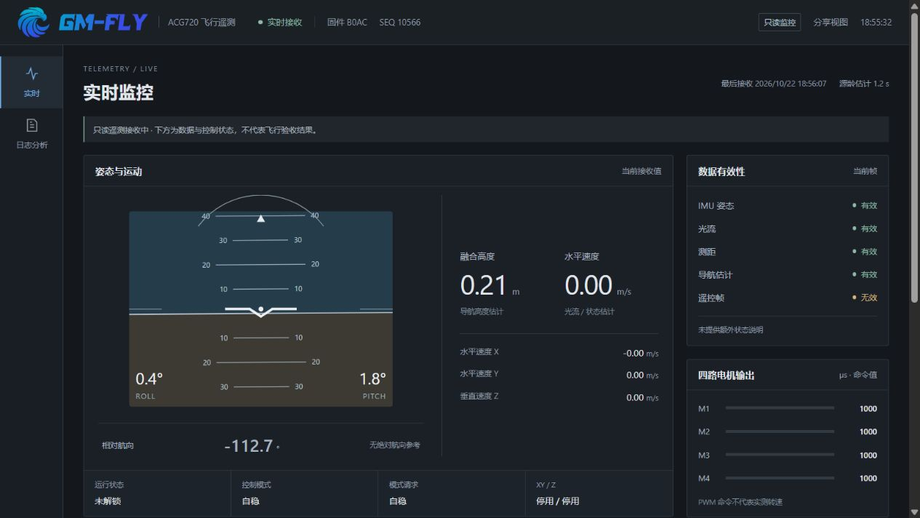
web/gmflylog-live-verified.png
