Scherrerll/acg720-fpga-flight-controller/history/00a-selection/README.md

# 00a：目标、架构取舍与硬件选型

根据先前会话重建的设计记录，时间为北京时间。**这里只记录当时目标和决策，不将方案参数倒写成已实现性能。** 本文于2026-10-22整理，原始聊天、购买订单、软件许可证、账号或MAC信息未上传。

## 2026-09-18：架构讨论

“FPGA无人机方案”会话在19:21～19:26讨论开放选题：核心实时控制由FPGA承担，包括传感器接口、滤波、姿态/速度等控制及电调输出；推荐以参考算法、C/Python模型、定点RTL逐步对照，避免把完整单片机固件直接套入软核当作移植完成。

这一阶段提到ACG525/GW5A、BMI088、PMW3901、VL53L1X和室内低空定点，属于候选组合。PWM/DShot、2kHz/500Hz/100Hz分层速率、更多串级环路同样只是设想。软核不是必需项，ROS仅作为可选上位机。**这些候选与后来实际ACG720工程不能混为同一配置。**

该会话最早可见回复提及更早的PicoRV32/Crazyflie讨论，但工具未返回被引用原文，故不补造其日期或最终取舍。9月22日的水空两栖、浮筒/水面推进器、GNSS/RTK、D435i、视觉和八路动力扩展也属于构想，不是本仓库的已实现功能。

## 2026-10-01：落实ACG720与现有器件

12:23:39，用户明确选择“小梅哥ACG720 60K＋现有材料”制作无人机并询问接线。由此进入实际板卡与外设适配阶段。

| 子系统 | 当时规划 | 后续演进入口 |
|---|---|---|
| 主控制器 | ACG720 60K / Gowin FPGA，RTL承担实时控制 | [板卡/PPM验证](../01-bringup/) |
| IMU | 当时实物ICM-42688-P小板，SPI | 后因读取/电气问题转[BMI088](../05-bmi088/) |
| 光流 | ATK-PMW3901，SPI | [厂家诊断](../07-b09e/)，之后改MTF |
| 测距 | 独立TFmini-S，UART | 后合并至MTF-01P光流/测距模块 |
| 遥控 | 接收机型号/协议待实物确认 | 10月3日落实FS-iA6B的PPM |
| 动力输出 | FPGA独立输出四路电调控制 | [拆桨电机验证](../03-control-motor/) |
| 通信 | SiK机载数传与电脑端接收 | [B0A0](../08-b0a0/)→[B0A6](../09-b0a6/) |
| 控制供电 | 动力支路与控制稳压分开、信号共地 | [初始接线](../00b-initial-wiring/) |
| D435i | 需要USB3主机；板卡设备侧USB不能直接当主机 | 暂缓，未实现相机飞控链路 |

13:14:56，用户补充实物IMU针名照片与独立5V、3.3V、12V稳压模块，要求按实际小板修正接线。此时接收机、交付电调、电池和稳压带载能力仍待核实；不能将商家标题、候选协议或理论频率作为已验收规格。

来源日期、会话与turn标识见[证据索引](evidence_sources.json)。当前实际候选配置请看[当前硬件文档](../../docs/HARDWARE.md)，不要照早期候选购买或改线。
