Scherrerll/acg720-fpga-flight-controller/history/02-imu-attitude/README.md

# IMU读取与姿态保护（2026-10-10至11）

IMU README第27行起记载10月10日六轴读取、异常和恢复。姿态README第91行起记载10月11日13:23保护构建，141行起记载13:59修订构建与2938帧静置采集。历史711C记录与本次复制的当前源码不保证字节对应；偶发IMU读取异常未因此证明消除。

本目录为2026-10-22从工作区当前文件导出的源码归档，按历史功能出现顺序分组，并非从Git恢复的当日快照。历史报告、UserCode、频率或硬件结果不自动适用于这份源码。

构建：用Gowin FPGA Designer打开对应子目录GPRJ，工作目录设为该工程目录，核对GW5AT-60B目标和本机工具版本，再运行综合与布局布线。有build.tcl时也可在工程目录用gw_sh执行。这里只检查了GPRJ引用与递归include完整性，没有在归档目录重新编译。

不包含生成器、下载脚本、FS、impl、raw日志或硬件快照。历史README提到的跨工程生成/恢复步骤不在本归档提供；不要在本目录运行旧生成流程。源码头原样保留，未授予新的统一许可证。

来源证据（均指原工作区路径；未随归档完整复制）：
- `acg720_imu_check/README.md`
- `acg720_attitude_bench/README.md`
