Scherrerll/acg720-fpga-flight-controller/history/14-b0af-height-loss/provenance/OPERATOR_NOTES.txt

B0AF 故障接管说明（开发候选，未上板验收）

测距正常时：维持 B0AE 的匿名源码控制流程和摇杆含义。
起飞前或怠速时测距丢失：仍禁止解锁／撤销解锁；不凭未知推力起飞。
起飞控制已输出过有效总油门之后，测高失效：退出光流和高度控制，
保留 IMU 姿态／偏航／角速度控制，地面站显示“测高失效，手动油门接管”。

接管时以最近提交的有效总油门与当前杆位作为锚点；杆位在中间范围
且不动时，总油门连续。上下杆位控制推力，不再表示升降速度。
杆的下／上端对应 1200／1850us 总油门，过渡每毫秒最多变化1us。
切换时杆已在端点，会按端点请求平滑调整，而不会瞬间跳变。
这不是新的油门匹配准入条件，不要求居中等待或重新拨模式开关。
1850us 是原总油门上限；四电机经姿态混控后仍受原各路2000us上限约束。
下拉到低推力后，原源码的低油门落地判定依然可能执行自动上锁。

测距恢复不会在解锁期间自动抢回油门。落地停机、测高恢复有效，
再按原低／高档解锁流程，恢复自动控制。SWA低档总是优先停机；
RC／IMU／倾角／控制器故障停机不等待油门平滑过渡。
当前没有遥控器端语音告警，也没有凭惯性保持高度／自动降落的承诺。

本轮只是离线代码与仿真，不代表飞行通过。旧4S带载掉动力尚未定因；
此修改不会修复电池压降、稳压模块重启、电调保护或功率接线问题。
