Scherrerll/acg720-fpga-flight-controller/history/README.md

# 开发历史：从选型与接线开始

最早阶段：[00a 目标/架构/硬件选型](00a-selection/README.md)（9月18日～10月1日）→[00b 初始接线](00b-initial-wiring/README.md)（10月1～4日）→以下板卡与算法验证。原始会话仅保存事实摘要/来源索引，早期规划、用户进展报告与已验证成果分别标注。

# 早期开发阶段源码归档

按README、验证报告内时间与功能依赖排序：01板卡/PPM → 02 IMU/姿态 → 03虚拟控制/拆桨电机 → 04综合监控/控制工程化 → 05 BMI088。01中Smoke缺少明确日期；04 UTC时间已按北京时间解释。

这些文件于2026-10-22从现有工作区复制，保留各工程basename和相对RTL结构。它们不是历史当天的精确Git快照，不假称与历史位流逐字节一致。早期工程可能含后来修订；历史证据只是阶段来源，未重新执行Gowin、硬件、仿真或下载。

每个工程可直接打开GPRJ；全部GPRJ条目（包含enable=0条目）及递归include已复制并检查存在。省略跨阶段生成器，避免暗示生成依赖完整。历史结果仅摘入每阶段evidence_summary.json，并绑定原始证据SHA256；原始大报告、原始日志和硬件快照未打包。early_manifest.json记录每个导出文件的相对来源和SHA256；派生文档以source_evidence标识来源，original_workspace_path为null。清单自身不自哈希。

上游版权头原样保留；适用PX4/Bitcraze许可随源码复制。ANO派生算法许可仍待核查，没有复制完整ANO、Bosch、PX4或其他第三方参考库。不要将此归档的私有保存视为公开再许可结论。05为B088停机回退源码，B089默认源码另有来源。

## 后续阶段（06–13）

06 B089 厘米台架 → 07 B09E ATK 诊断 → 08 B0A0 SiK 候选 → 09 B0A6 无线日志/冷启动 → 10 MTF 独立工具 → 11 B0AB 完整控制 → 12 B0AC 默认 Flash → 13 B0AD 历史 SRAM 候选。详见各数字前缀目录的 README 和[完整时间线](../docs/TIMELINE.md)。

晚期来源与导出 SHA-256 见 `late_manifest.json`。这些目录保留选用的 fixture 与有限文字证据，没有打包旧位流、原机器工具或全量原始记录，不能宣称完整硬件/飞行验收链可离线重放。
