Scherrerll/acg720-fpga-flight-controller/history/15-b0b0-routing-stages/README.md

# B0B0：10-23 综合、映射和布线排查阶段

本目录保留根工具、合同、测试和各阶段状态。变体的来源绑定文本见 `firmware/B0B0/provenance/bound_evidence` 和 `inherited_evidence_index.json`；失败试验按原结果保留，不计为通过。选中版本和 10 月 24 日的实物验收见 [B0B0 版本说明](../../firmware/B0B0/README.md)。
