Scherrerll/acg720-fpga-flight-controller/history/14-b0af-height-loss/README.md

# B0AF：10-23 测距失效后的手动油门接管阶段

`fixture/` 保存原始源输入，`provenance/` 和 `tests/` 保留资格、失败及硬件拒绝记录。B0AF 是历史阶段，后来由 B0B0 取代，不是当前默认版本。此前掉动力和低油门落地锁定的操作者说明见 [10 月 23～24 日工作记录](../../docs/WORK_20261023_24.md)。
