Scherrerll/acg720-fpga-flight-controller/analysis/20261026_z_aw_fix/README.md

# B0B4：修正高度积分饱和并设置用户选择的水平默认值

本次工作有两项要求：修正最低油门时目标下降、高度总油门却仍处于上限的代码机制；将定点模式共用的水平参数开机默认值改为 **P=0.1000、I=0.0350**。按照用户要求，低空掉高问题不再继续调查；本轮没有修改倾角补偿、高度融合或传感器处理。

新代码位于 `firmware/B0B4/`，新地面站位于 `ground/B0B4/`，冻结的 B0B3 和原证据均保留。最终可交付状态以 B0B4 的 qualification.json 为准；源码、行为测试和物理时序资格分别记录，离线结果不能作为已经装机或通过飞行验收的证明。

## 改了什么、为什么

旧实现中，高度 I 在输出达到 0..850 增量范围的上限后仍可能同向累积，因此最低油门时需要较长时间退回。新实现保留原误差、积分步长和积分 rail，先暂存候选 I，等本次回调的 P 项和更新后的 bias 可用后，再判断最终输出。超出上限且候选 I 仍在增加，或低于下限且候选 I 仍在减小时，拒绝该步；反向消积仍然接受。选中的同一个 I 同时提交到积分器和输出，避免非阻塞赋值误用旧 I。reset/cancel 时丢弃尚未提交的候选值。

新增两个流水状态后，Z 发布比旧版增加 2 个 50 MHz 时钟（40 ns），PID 仍按 11 ms 计算。未饱和时，按回调比较的输出和内部积分等价；饱和时有意改变了原 P2 的积分行为，因此不宣称与原 P2 逐状态完全一致。低杆直接停桨、着陆判据、运行 PWM 上下限、降级逻辑和原安全门均未改变。

参数银行的 INIT 和 reset 均改为 wire1000/350、generation=0，控制器的开机工作快照与之保持一致。后续手动 SET 仍仅在本次上电期间有效，重启后恢复新的 0.1000/0.0350；本次没有增加 Flash 参数保存协议。A591 和 FPGA UserCode 使用 B0B4，新地面站严格识别 B4，并同步更新初始草稿、默认按钮和重启说明。旧 A580 的公共 B0B2 标签为兼容而保留，不能据此判断新固件身份。

## 行为验证结果

| 检查 | 实际结果与边界 |
| --- | --- |
| 自然上饱和→最低杆，新旧真实RTL | 同样从复位、固定合法height300/vz0/az0和上杆刺激自然积累。旧版最低杆后前4.6秒419/419发布为1850；新版44ms离开上限、924ms低于1250。新上向拒绝1716次、反向消积接受77次。仅为固定传感器加速回调见证，不能用作实机着陆等待时间。 |
| 未饱和轨迹 | 400次Z发布的数值与旧版完全一致，含100次正I步及150次负I步；发布时间差恰2拍。 |
| 下饱和→正向恢复 | 阻止406次继续负向积累，并接受52次正向消积。 |
| 安全撤销/重入 | 8个阶段边界与taking_off=false均通过，无旧候选跨取消发布。直接模块的注册cancel与整机组合mask分别记录。 |
| 运行时XY I=0 | 修正夹具后150次Z发布、75次XY回调通过，XY积分为0、角度与旧版一致；Z积分仍非0，避免把XY I0误当成关闭Z I。 |
| 四客户端共享数学 | 12次XY/20次Z与同B4单客户实例数值一致；dummy每路乘法至少5811次、除法2614次。最大XY请求至发布355.84μs、Z为251.08μs；这是RTL预算，不是物理STA。 |
| 实际参数bank与UART | 121个协议用例、碎片/合包解码、CRC、范围、重放拒绝、锁定竞争、原子边界、背压、复位新默认和115200接收通过。 |
| 真实顶层安全接线 | 13项停机/ARM/有效命令/起飞/四路PWM与同时解锁竞争测试通过；首个顶层默认1000/350/gen0。含受控仿真forces，范围见原日志。 |
| 地面站 | 53项Python及Node HTML/JS合约通过；新B4默认响应经严格codec验证，CRC正确但build为B2/B3的帧仍被拒绝。全部mock/临时测试服务，未连接实际设备。 |

真实新旧控制器、数学服务以及失败和成功的原始日志保存在 rtl_regression/，最终汇总见 **final_results.json**。

### 保留的首轮测试失败

`rtl_regression/results.json`保留首轮I0夹具失败：夹具把高度/XY并发输入加速到原事务无法完成的间隔。增强诊断在相同过快间隔下复现B3/B4同时overrun、reason128/128，属于原保护被夹具触发，未据此改产品源。

只为I0创建独立attempt02，把间隔2500→20000clk，保留原11000/22000us逻辑dt和全部原断言；该用例实际exit0。前4项已通过场景没有重复运行或覆盖，原失败没有改成通过。最终资格使用单独final_results.json，不能只看首轮failed汇总或只删掉失败记录。

## 物理交付与复现

2026-10-27选中 `compact_aw_v22/physical_p3r0_01`：实际完整布线及位流生成通过，vendor和runner正常返回整数0，Fmax **50.075MHz**，setup/hold违规端点 **0/0**。五类最差裕量依次为setup **+0.030ns**、hold **+0.200ns**、recovery **+12.073ns**、removal **+2.646ns**、最小脉宽 **+7.387ns**。原始报告的独立解析通过。setup余量为30ps，不能把其它源码、网表或配方冒充该次验收。

选中v22由完整同拍AZ/速度范围谓词和等价状态门优化组成，并对Z速度常数乘法添加局部logic映射提示；与原抗积分饱和方案相比没有增加公开周期。综合为map2/area/max_fanout200/replicate0，物理为P3/R0/route_maxfan23，完整原CST/SDC不变，没有追加DSP LOC。另做的max_fanout100仅通过综合，未启动PNR，已停止推进。

实际选中VG的SHA256为 `e84a81f4a5abb4c15c9e599cc4c2d2e77397a328c9372d0a94c8949fbbf7f4f8`；终端清单、独立原始报告审查与真实进程回执见 `build/compact_aw_v22/physical_p3r0_01/`。最终交付保存完整源55、功能证明和综合/物理证据闭包，原初始原型55在promotion时单独备份。

本轮从新的55源码快照重新综合，使用精确新VG进行netlist-only布局布线；20ns时钟、18脚约束及radio同步边界保留。不能沿用B3的50.257MHz或旧时序余量作为B4验收。

构建原始记录在 `out/z_aw_fix_20261026/`；最终保留的原始TR/RPT/CFG、进程真实wait、源/网表/FS哈希与资格收据由B0B4交付清单绑定。新功能回归、完整布通、五类非负slack及Fmax≥50MHz均须满足后，才可标记离线可交付。

`firmware/B0B4/verify_release.py`只校验已归档字节和资格，不重跑仿真或操作下载器；`--external-build`另检查本机原构建输入。重新构建需已安装的Gowin、Icarus及构建回执记录的只读辅助工具。不要直接运行冻结B3/R/H原驱动来覆盖旧证据。

## 下一步的实体边界

机上安装的版本和正在运行的地面站不会因为生成新源码而自动切换。需要先完成新包的离线资格检查，再确认当前拆桨、停机和下载连接状态，进行 SRAM、冷启动和地面读回验证，之后才决定是否永久写入。实飞后不能沿用此前“已拆桨”的旧实体确认。

不建议通过“拉到最低后一直等待”来绕过旧版问题。本次修复针对的是已定位并复现的机制；由于实飞时没有记录内部 I，不能保证它能够解释此前所有下降事件，新版本的实机和飞行验收也尚未完成。
