Scherrerll/acg720-fpga-flight-controller/history/12-b0ac/README.md

# 12-b0ac

日期：2026-10-19（离线）；2026-10-20（实物）。

B0AC 保留 FSM，Fmax 50.191 MHz；历史实物 XYZ 进入、独立电池拆桨电机运行、Flash 验证和冷启动通过。当前默认 Flash 为 B0AC；XYZ 飞行验收待完成。较早 status/selected JSON 的未安装状态是当时的历史记录。

历史来源：`routing_rescue_20261015/mtf01p_b0ac_preserve_fsm/fixture`。

入口：Gowin IDE 打开 `fixture/acg720_ano_port.gprj`；在 fixture 目录用已安装的 Gowin `gw_sh build.tcl` 重新编译。这些命令只编译；不提供硬件下载入口。

导出保留原 GPRJ 的全部本地文件引用、递归 Verilog include、约束和 Tcl，以及少量历史验证摘要；未附 bitstream、impl、仿真可执行文件、大型日志、硬件快照或旧 ground。

证据 JSON 内个人机器绝对路径仅为原机器的历史 provenance；本副本不承诺完整证据重放。重新编译可能因工具版本、布局布线及环境不同产生不同结果，不能替代原 bitstream/hash 绑定的历史证明。验证状态仅限各报告明确的范围；重新编译或自测不等于硬件或飞行验收。

每个导出文件的原相对路径及 SHA-256 见 `../late_manifest.json`。
