Scherrerll/acg720-fpga-flight-controller/analysis/20261026_z_aw_fix/handoff_20261026_APPROVED.md

# 新会话接续已获确认

用户于2026年10月26日在原会话明确回复：“可以，确认新会话能同步进度即可”。据此已创建新会话，原归档的待批准字段保留为创建前历史快照，不改写其manifest。

- 新会话：B0B4 布线与着陆修复续接
- threadId：01a17788-4242-79e0-9a84-aa5021c9aad4
- host：local
- 项目：apple（0b8bb271-3e8c-4da5-86a1-3b303407e9ed），本地环境，沿用同一磁盘工作区。
- 仓库：C:/Users/ScherrerL/Desktop/apple/github_publish/acg720-fpga-flight-controller

启动说明已提供完整归档入口、当前源码/VG指纹、全部软件验证通过与尚缺合格PNR的事实、未提交目录、50MHz验收要求、冻结B0B3/R/H边界，以及用户已批准按NEXT_PLAN继续工作的说明。v7五场景批次实际完成5/5且退出0，综合与各审计已过，未开始v7PNR。

本次确认授权新会话接续离线工作，不能替代固件下载前对当前拆桨和低位状态的重新核实。此附记不表示B0B4已物理验收、固化或飞行验证。
