Scherrerll/acg720-fpga-flight-controller/analysis/20261026_z_aw_fix/handoff_20261026/NEXT_PLAN.md

# 待用户确认的新会话规划

新会话沿用apple本地项目和当前仓库，不创建新worktree，不丢弃现有未提交内容；先读HANDOFF/STATE并核实真实终态。

1. **收尾现有证据**：核对v7最后五场景是否全部actual0，复用已经完成的SYN和审计，整理当前所有尝试分类。先读取现有结果，不重复综合。
2. **优先验证v7物理实现**：以已冻结v7 source55和精确VG为输入，每轮安排1～2个有依据的布局方案；坚持50MHz、五类时序和完整路由。v4已布通49.456MHz作为距离目标最近的参考；v6额外guard实现保留为已验证但未通过物理门的对照。
3. **依据真实关键路径继续优化**：若仍失败，先区分未布通、setup不足或编排中断。针对acc/高度可用性/诊断复位等真实路径分析，逐项实现可证明的等价优化；保留原控制算法、精度和紧急保护响应。每项改动先验证，再构建，持续到产生合格位流。
4. **形成可审查升级包**：首个完整通过者独立复核raw TR，冻结最终源码、FS、精确VG、配置、测试和哈希；更新配套B4地面站与操作说明，确认启动P=0.1000/I=0.0350。说明与P2的名义一致处、饱和积分的有意差异和实际实现取舍。
5. **地面与冷启动验收**：核实当前拆桨/低位/连接后，先SRAM验证，再固化Flash、完全断电重启读回。着陆实效和悬停另留实机验收记录。
6. **提交进度到Git**：配套上传代码、通过与失败记录、操作说明和已验收件；保留B0B3回退，明确仍待验证的项目。

**本规划尚待用户确认；当前不会创建新会话或新增构建。**
