Scherrerll/acg720-fpga-flight-controller/firmware/B0B2/evidence/source_revisions/copy99_v1/POLICY.md

# B0B2 输入策略修复候选

本候选从 B0B1 源码独立复制。B0B0 冻结源码、Flash、回退资料及 B0B1 被动诊断工程保留。它修复一条已经由真实 RTL 复现的失效机制；现有实飞日志不能证明这是两次偏移的唯一首因。

## 参考依据与修改

本地参考 `reference_ano/quadrotor_tm_v1_20261012/Quadrotor_TM_V1/SRC/fc_general/Ano_Sensor_Basic.c:320–332` 对加速度和陀螺使用四级 0.25 低通。`Ano_Imu.c:249–276` 在加速度模长不适合重力修正时清零修正误差，仍构造陀螺增量并更新四元数。B0B0 的估计器已有相应的模长门控；额外的 quiet/motion/candidate 整帧拒收发生在滤波和融合之前。

B0B2 取消合法运动数据的 quiet/motion/candidate 拒收，包括“陀螺全零/全一且发生跳变”的推测性填充判据。静止陀螺零值、运动起始以及正常加速度振动不再仅因相邻差值而丢失整个六轴记录。保留三时钟的锁存延迟、完整元数据身份和输入管线碰撞拒收；不采用插值、重复旧样本或延长截止时间。

该输入政策对启动、运行和恢复均生效；校准静止检查及重建重力检查仍在估计器中执行。重建只核对相应的重力模长及连续样本资格，并不构成完整静止检测。保留旧的命名参数仅为源码兼容，它们在本版本不控制运动接受。

无碰撞时输入在 t0 锁存、t3 发布 checked，guard 在 t4 消费。1–3 拍内的新输入触发原有碰撞拒收：放弃先前快照，立即报告碰撞输入及 detail=0x80。这不是一个保证任何输入节拍均可接收的队列。

## 保留的保护

- BMI088 读取器的 ID、配置、时序和归一化溢出检查；全零或全一的完整记录检查。
- 原估计器的校准、重力重建、数值范围、计算冲突及时间差检查。
- guard 接受源计时、真实 60ms 新数据截止与连续合格恢复；保护触发后的停机链路。
- 原电机混控、增益、自动起飞、落地锁及光流有效倾角判据。

取消相邻差值判断也意味着某些“数值看似合法、但实际被污染”的 SPI 数据不会再被这层启发式规则发现。BMI088 链路没有可证明覆盖所有数据错误的 CRC；此版本不能作出这种保证。传感器记录有效性和计算输出资格仍分开记录。

例如加速度正常而 gyro 三轴为 0 或 −1，可能是合法读数，也可能是看似合法的污染；ID、DRDY 和源年龄不能证明其数值真实。旧 gyro-fill 也不是持久坏值检测：重复相同候选通常能通过，较小跳变不会触发该判据。

继承的内部诊断 ABI 中 quiet_count、candidate_pending 和 candidate 恒零表示策略停用；trusted 仅是上一个 base-valid 历史记录，不能证明当前仍新鲜或已发布姿态。detail=0 不等于 base_ok，detail=0x80 仅为管线碰撞。原 tap 的 rejected triple 只记录 temporal 拒收，不记录 reader/base 坏帧；SiK 汇总另行保留 reader/base 拒收来源和子码，不能将 triple 的 source_id=0 解释成从未出现任何坏帧。

## 验证边界

对照应使用同一刺激驱动冻结旧版与候选真实 temporal/guard/estimator：合法交替振动、运动、加速度修正外窗、显式坏帧、20–60ms 空窗、恢复、样本身份及 dt。正常动态连续发布与真实故障停机必须同时成立。

SiK 必须独立记录关键拒收原因、最大姿态发布间隔和首个保护原因；实飞不依赖 USB。B0B2 移除新增 USB 高频发送器及队列，USB 仅复制原 SiK 遥测；完整高频诊断只保留在历史 B0B1 工程。新位流重新综合布线与时序验收。默认只做拆桨 SRAM 验证，不写 Flash；静止或拆桨未复现不能写成带载问题已经解决。
