Scherrerll/acg720-fpga-flight-controller/analysis/20261026_z_aw_fix/compact_regression/natural_lower_and_positive_recovery/trace.csv

logical_ms | ch3 | new_collective | old_collective | target_mm | climb_mmps | new_iz_q16 | old_iz_q16 | bias_q16 | upper_rejects | lower_rejects
22 | 1002 | 1022 | 1022 | 998 | -170 | 0 | 0 | 1482143 | 0 | 0
33 | 1002 | 1022 | 1022 | 995 | -260 | -7488 | -7488 | 2868515 | 0 | 0
44 | 1002 | 1031 | 1031 | 991 | -350 | -19075 | -19075 | 4165305 | 0 | 0
55 | 1002 | 1037 | 1037 | 986 | -440 | -34832 | -34832 | 5378301 | 0 | 0
66 | 1002 | 1043 | 1043 | 980 | -520 | -54831 | -54831 | 6512918 | 0 | 0
77 | 1002 | 1048 | 1048 | 974 | -610 | -78703 | -78703 | 7574220 | 0 | 0
88 | 1002 | 1050 | 1050 | 966 | -700 | -106951 | -106951 | 8566945 | 0 | 0
99 | 1002 | 1052 | 1052 | 957 | -790 | -139647 | -139647 | 9495524 | 0 | 0
110 | 1002 | 1052 | 1052 | 948 | -880 | -176863 | -176863 | 10364101 | 0 | 0
121 | 1002 | 1051 | 1051 | 937 | -960 | -218669 | -218669 | 11176554 | 0 | 0
132 | 1002 | 1050 | 1050 | 925 | -1050 | -264697 | -264697 | 11936509 | 0 | 0
143 | 1002 | 1047 | 1047 | 913 | -1140 | -315450 | -315450 | 12647359 | 0 | 0
154 | 1002 | 1043 | 1043 | 899 | -1230 | -371000 | -371000 | 13312276 | 0 | 0
165 | 1002 | 1038 | 1038 | 885 | -1320 | -431418 | -431418 | 13934229 | 0 | 0
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
