Scherrerll/acg720-fpga-flight-controller/analysis/20261026_z_aw_fix/width_regression/natural_upper_and_low_stick/trace.csv

logical_ms | ch3 | new_collective | old_collective | target_mm | climb_mmps | new_iz_q16 | old_iz_q16 | bias_q16 | upper_rejects | lower_rejects
22 | 1684 | 1022 | 1022 | 308 | 770 | 0 | 0 | 1482143 | 0 | 0
33 | 1684 | 1138 | 1138 | 317 | 860 | 33916 | 33916 | 2868515 | 0 | 0
44 | 1684 | 1171 | 1171 | 328 | 950 | 72407 | 72407 | 4165305 | 0 | 0
55 | 1684 | 1203 | 1203 | 339 | 1040 | 115544 | 115544 | 5378301 | 0 | 0
66 | 1684 | 1234 | 1234 | 352 | 1120 | 163399 | 163399 | 6512918 | 0 | 0
77 | 1684 | 1263 | 1263 | 365 | 1210 | 215602 | 215602 | 7574220 | 0 | 0
88 | 1684 | 1293 | 1293 | 379 | 1300 | 272657 | 272657 | 8566945 | 0 | 0
99 | 1684 | 1321 | 1321 | 395 | 1390 | 334636 | 334636 | 9495524 | 0 | 0
110 | 1684 | 1350 | 1350 | 411 | 1480 | 401610 | 401610 | 10364101 | 0 | 0
121 | 1684 | 1377 | 1377 | 428 | 1560 | 473651 | 473651 | 11176554 | 0 | 0
132 | 1684 | 1403 | 1403 | 446 | 1650 | 545741 | 545741 | 11936509 | 0 | 0
143 | 1684 | 1429 | 1429 | 465 | 1670 | 617831 | 617831 | 12647359 | 0 | 0
154 | 1684 | 1447 | 1447 | 483 | 1670 | 689921 | 689921 | 13312276 | 0 | 0
165 | 1684 | 1461 | 1461 | 501 | 1670 | 762011 | 762011 | 13934229 | 0 | 0
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
