Scherrerll/acg720-fpga-flight-controller/analysis/20261026_z_aw_fix/width_regression/xy_i0_independence/trace.csv

logical_ms | ch3 | new_collective | old_collective | target_mm | climb_mmps | new_iz_q16 | old_iz_q16 | bias_q16 | upper_rejects | lower_rejects
22 | 1500 | 1022 | 1022 | 1000 | 0 | 0 | 0 | 1482143 | 0 | 0
33 | 1500 | 1043 | 1043 | 1000 | 0 | 0 | 0 | 2868515 | 0 | 0
44 | 1500 | 1063 | 1063 | 1000 | 0 | 0 | 0 | 4165305 | 0 | 0
55 | 1500 | 1082 | 1082 | 1000 | 0 | 0 | 0 | 5378301 | 0 | 0
66 | 1500 | 1099 | 1099 | 1000 | 0 | 0 | 0 | 6512918 | 0 | 0
77 | 1500 | 1115 | 1115 | 1000 | 0 | 0 | 0 | 7574220 | 0 | 0
88 | 1500 | 1130 | 1130 | 1000 | 0 | 0 | 0 | 8566945 | 0 | 0
99 | 1500 | 1144 | 1144 | 1000 | 0 | 0 | 0 | 9495524 | 0 | 0
110 | 1500 | 1158 | 1158 | 1000 | 0 | 0 | 0 | 10364101 | 0 | 0
121 | 1500 | 1170 | 1170 | 1000 | 0 | 0 | 0 | 11176554 | 0 | 0
132 | 1500 | 1182 | 1182 | 1000 | 0 | 0 | 0 | 11936509 | 0 | 0
143 | 1500 | 1192 | 1192 | 1000 | 0 | 0 | 0 | 12647359 | 0 | 0
154 | 1500 | 1203 | 1203 | 1000 | 0 | 0 | 0 | 13312276 | 0 | 0
165 | 1500 | 1212 | 1212 | 1000 | 0 | 0 | 0 | 13934229 | 0 | 0
176 | 1500 | 1221 | 1221 | 1000 | 0 | 0 | 0 | 14515994 | 0 | 0
187 | 1500 | 1229 | 1229 | 1000 | 0 | 0 | 0 | 15060167 | 0 | 0
198 | 1500 | 1237 | 1237 | 1000 | 0 | 0 | 0 | 15569178 | 0 | 0
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
