Scherrerll/acg720-fpga-flight-controller/analysis/20261028_water_drive/qualified_offline_B0B5/evidence/device.cfg

set JTAG regular_io = false
set SSPI regular_io = false
set MSPI regular_io = false
set READY regular_io = false
set DONE regular_io = false
set I2C regular_io = false
set CPU regular_io = false
set CRC_check = true
set compress = false
set encryption = false
set security_bit_enable = true
set bsram_init_fuse_print = true
set secure_mode = false
set program_done_bypass = false
set wake_up = 0
set user_code = 0x0000B0B5
set format = binary
set power_on_reset_monitor = true
set seu_handler = false
set ext_cclk = false
set vccx = 3.3
set vcc = 0.95
set unused_pin = default
