Scherrerll/acg720-fpga-flight-controller/validation/20261024/dynamic_validation/historical_pitch_20261021/parser_diff.txt

--- B0AD parser
+++ B0B0 parser
@@ -1,23 +1,33 @@
 module micolink_parser(
  input wire clk,rst_n,tick_ms,byte_valid,byte_error,input wire [7:0] byte_data,
  output reg sample_valid=0,output reg [215:0] raw_frame=0,
- output reg [31:0] time_ms=0,output reg [31:0] distance_mm=0,
- output reg [7:0] module_seq=0,output reg [7:0] strength=0,output reg [7:0] precision=0,
- output reg [7:0] tof_status=0,output reg [7:0] quality=0,output reg [7:0] flow_status=0,
- output reg signed [15:0] flow_x=0,output reg signed [15:0] flow_y=0,
+ output wire [31:0] time_ms,output wire [31:0] distance_mm,
+ output wire [7:0] module_seq,output wire [7:0] strength,output wire [7:0] precision,
+ output wire [7:0] tof_status,output wire [7:0] quality,output wire [7:0] flow_status,
+ output wire signed [15:0] flow_x,output wire signed [15:0] flow_y,
  output reg [31:0] samples=0,output reg [31:0] checksum_errors=0,output reg [31:0] length_errors=0,
  output reg [31:0] uart_errors=0,output reg [31:0] timeouts=0
 );
  reg [2:0] state=0;reg [3:0] gap_ms=0;
- reg [7:0] sum=0,message_id=0,pending_seq=0,payload_length=0,payload_index=0;
- reg [159:0] payload=0;reg [215:0] shift=0;
+ reg [7:0] sum=0,message_id=0,payload_length=0,payload_index=0;
+ reg [215:0] shift=0;
+ // Published fields share the committed frame and its reset/hold behavior.
+ assign time_ms={raw_frame[143:136],raw_frame[151:144],raw_frame[159:152],raw_frame[167:160]};
+ assign distance_mm={raw_frame[111:104],raw_frame[119:112],raw_frame[127:120],raw_frame[135:128]};
+ assign strength=raw_frame[103:96];
+ assign precision=raw_frame[95:88];
+ assign tof_status=raw_frame[87:80];
+ assign flow_x={raw_frame[63:56],raw_frame[71:64]};
+ assign flow_y={raw_frame[47:40],raw_frame[55:48]};
+ assign quality=raw_frame[39:32];
+ assign flow_status=raw_frame[31:24];
+ assign module_seq=raw_frame[183:176];
  always @(posedge clk) begin
   sample_valid<=0;
   if(!rst_n) begin
-   state<=0;gap_ms<=0;sum<=0;payload_index<=0;payload<=0;shift<=0;
+   state<=0;gap_ms<=0;sum<=0;payload_index<=0;shift<=0;
    samples<=0;checksum_errors<=0;length_errors<=0;uart_errors<=0;timeouts<=0;
-   raw_frame<=0;time_ms<=0;distance_mm<=0;module_seq<=0;strength<=0;precision<=0;
-   tof_status<=0;quality<=0;flow_status<=0;flow_x<=0;flow_y<=0;
+   raw_frame<=0;
   end else if(byte_error) begin uart_errors<=uart_errors+1'b1;state<=0;gap_ms<=0;end
   else if(byte_valid) begin
    gap_ms<=0;
@@ -29,15 +39,14 @@
      1:state<=2;
      2:state<=3;
      3:begin message_id<=byte_data;state<=4;end
-     4:begin pending_seq<=byte_data;state<=5;end
+     4:state<=5;
      5:begin
-      payload_length<=byte_data;payload_index<=0;payload<=0;
+      payload_length<=byte_data;payload_index<=0;
       if(byte_data>64 || (message_id==8'h51 && byte_data!=20)) begin
        length_errors<=length_errors+1'b1;state<=0;
       end else state<=byte_data==0 ? 7:6;
      end
      6:begin
-      if(payload_index<20)payload[payload_index*8 +:8]<=byte_data;
       payload_index<=payload_index+1'b1;
       if(payload_index+1==payload_length)state<=7;
      end
@@ -46,10 +55,6 @@
       if(byte_data==sum)begin
        if(message_id==8'h51 && payload_length==20)begin
         samples<=samples+1'b1;sample_valid<=1;raw_frame<={shift[207:0],byte_data};
-        time_ms<=payload[31:0];distance_mm<=payload[63:32];module_seq<=pending_seq;
-        strength<=payload[71:64];precision<=payload[79:72];tof_status<=payload[87:80];
-        flow_x<=payload[111:96];flow_y<=payload[127:112];
-        quality<=payload[135:128];flow_status<=payload[143:136];
        end
       end else begin
        checksum_errors<=checksum_errors+1'b1;
