Scherrerll/acg720-fpga-flight-controller/firmware/B0B5/source_cn/position/ano_height_fusion.v

`timescale 1ns/1ps
// 移植自 ANO Tech 的 Ano_MotionCal.c：WCZ_Data_Calc 与 Ano_Filter.c 数值算法。
// WCZ 按 11 ms 运行：加速度偏置 Ki=0.1，速度校正 Kp=0.6（限幅 100 cm/s），
// 高度校正 Kp=0.3；参考速度和加速度每 5 个 WCZ 周期更新一次。
// 使用 TFmini 经倾斜修正后的距离，替代源算法中的气压计/TOF 选择。
// 保留源算法以整 cm 量化观测和导数的规则；公开接口统一使用 mm 系列单位。
// 用原点偏置对外还原真实测得的绝对距离，内部仍保留源算法
// 复位后相对高度为零的规则；未修改源算法系数。
// 默认标定掩码为 0 时允许显示估计值，但绝不授予控制有效性。
module ano_height_fusion #(
 parameter integer CLK_HZ=50000000,AGE_LIMIT=5000000,
 parameter [7:0] CAL_MASK=0
)(
 input wire clk,rst_n,origin_reset,
 input wire range_valid,acc_valid,acc_update,
 // acc_dt_us 为接受的加速度样本间隔（us）；range_age_ticks 与 AGE_LIMIT 均为 clk 拍数。
 input wire [31:0] acc_dt_us,
 input wire [31:0] range_age_ticks,
 // 输入为倾斜修正后的高度 mm 与向上为正的线加速度 mm/s²；原点复位会重新建系。
 input wire signed [31:0] ref_height_mm,az_up_mmps2,
 // estimate_ready 允许读出合格估计；valid 另要求高度相关标定位，qualified_* 再寄存一拍。
 // update 仅在完整高度事务提交时脉冲；vz_q16 是 Q16 mm/s，须同时检查 vz_q16_valid。
 output wire valid,estimate_ready,
 output reg qualified_ready=0,output reg qualified_valid=0,
 output reg update,
 output reg signed [31:0] fused_height_mm,vz_mmps,sample_az_mmps2,
 output reg signed [31:0] vz_q16,output wire vz_q16_valid,
 output reg [15:0] reason);
 localparam PERIOD_TICKS=CLK_HZ*11/1000;
 reg [31:0] timer=0,publication_age=32'hffffffff;
 reg seeded=0,seen=0,fault=0;
 reg [2:0] cycle5=0;
 reg acc_pending=0,height_pending=0;
 reg pending_height_epoch_ok=0,height_transaction_epoch_ok=0,seed_epoch_ok=0;
 reg [31:0] pending_acc_dt=0;
 reg [31:0] held_acc_dt=0;
 reg signed [31:0] pending_acc=0,pending_height=0,pending_rawaz=0,held_rawaz=0;
 reg signed [63:0] filtered_acc=0,filter_input=0;
 reg [6:0] filter_steps=0;reg [9:0] filter_fraction=0;
 reg signed [31:0] origin_mm=0,held_relative_mm=0,held_acc_mm=0;
 reg signed [31:0] ref_height_old=0,ref_speed_old=0,ref_speed=0,ref_acc=0;
 reg signed [63:0] acc_i=0,acc_out=0,vq=0,hq=0,vel_e=0,height_e=0;
 // hq 为 Q16 相对高度 mm，vq 为 Q16 垂速 mm/s；加速度、偏置与误差校正量均保留 Q16。
 // origin_mm 在输出端恢复绝对高度；参考导数仍保持源算法整 cm 量化后再换算的规则。
 reg [7:0] state=0,return_state=0;
 reg mul_start=0,div_start=0;
 reg signed [63:0] ma=0,mb=0,num=0,value=0,trunc_magnitude=0;
 reg trunc_negative=0;reg signed [31:0] publish_h_integer=0,publish_v_integer=0;
 reg signed [31:0] publish_v_q16=0;
 reg publish_v_q16_range=0,v_q16_range=0;
 // 缩窄位宽前先检查完整的 64 位有符号状态，防止高精度速度总线
 // 溢出回绕后伪装成范围合法的控制速度。
 assign vz_q16_valid=estimate_ready && v_q16_range;
 reg [31:0] den=1,pending_den=1;
 wire md,mbusy,dd,dbusy,derr;wire signed [63:0] product,quotient;
 wire sources_ok=range_valid && acc_valid && range_age_ticks<AGE_LIMIT &&
     ref_height_mm>=0 && ref_height_mm<=5000 && az_up_mmps2>=-30000 && az_up_mmps2<=30000;
 reg cleanup=1;
 always @(posedge clk) if(!rst_n) cleanup<=1;else cleanup<=origin_reset || !sources_ok || fault;
 assign estimate_ready=sources_ok && !origin_reset && !cleanup && seeded && seen && publication_age<AGE_LIMIT && !fault;
 assign valid=CAL_MASK[3] && CAL_MASK[4] && estimate_ready;
 always @(posedge clk)begin
  if(!rst_n || origin_reset)begin qualified_ready<=0;qualified_valid<=0;end
  else begin qualified_ready<=estimate_ready;qualified_valid<=valid;end
 end
 // 数据源失效时，常规清理同时撤销当前事务所属的有效时段。
 // 提交阶段另外复核当前数据源健康状态及锁存的事务时段资格。
 wire new_acc_fault=acc_update && (acc_pending || acc_dt_us==0 || acc_dt_us>100000);
 wire new_height_fault=seeded && timer==PERIOD_TICKS-1 && height_pending;
 position_multiply m(.clk(clk),.rst_n(rst_n),.start(mul_start),.cancel(cleanup),.a(ma),.b(mb),.busy(mbusy),.done(md),.result(product));
 position_divide d(.clk(clk),.rst_n(rst_n),.start(div_start),.cancel(cleanup),.numerator(num),.denominator(den),.busy(dbusy),.done(dd),.error(derr),.quotient(quotient));
 function signed [63:0] clip;
 input signed [63:0] a,lo,hi;begin clip=a<lo ? lo:a>hi ? hi:a;end endfunction
 // 源算法每 1 ms 的 0.03 低通系数，对应分数时间系数采用 Q24。
 // 采用同步 ROM 读，将 1024×24 查找表映射到 BSRAM，避免形成
 // 千路组合选择网络。表中系数保留此前精确整数值，
 // 未使用的地址填零。
 (* rom_style="block", syn_romstyle="block_rom" *) reg [23:0] fraction_rom [0:1023];
 reg [23:0] fraction_q=0;
 initial begin
  fraction_rom[0]=24'd0;
  fraction_rom[1]=24'd511;
  fraction_rom[2]=24'd1022;
  fraction_rom[3]=24'd1533;
  fraction_rom[4]=24'd2044;
  fraction_rom[5]=24'd2555;
  fraction_rom[6]=24'd3066;
  fraction_rom[7]=24'd3577;
  fraction_rom[8]=24'd4088;
  fraction_rom[9]=24'd4599;
  fraction_rom[10]=24'd5109;
  fraction_rom[11]=24'd5620;
  fraction_rom[12]=24'd6131;
  fraction_rom[13]=24'd6642;
  fraction_rom[14]=24'd7153;
  fraction_rom[15]=24'd7664;
  fraction_rom[16]=24'd8174;
  fraction_rom[17]=24'd8685;
  fraction_rom[18]=24'd9196;
  fraction_rom[19]=24'd9707;
  fraction_rom[20]=24'd10217;
  fraction_rom[21]=24'd10728;
  fraction_rom[22]=24'd11239;
  fraction_rom[23]=24'd11749;
  fraction_rom[24]=24'd12260;
  fraction_rom[25]=24'd12771;
  fraction_rom[26]=24'd13281;
  fraction_rom[27]=24'd13792;
  fraction_rom[28]=24'd14302;
  fraction_rom[29]=24'd14813;
  fraction_rom[30]=24'd15324;
  fraction_rom[31]=24'd15834;
  fraction_rom[32]=24'd16345;
  fraction_rom[33]=24'd16855;
  fraction_rom[34]=24'd17366;
  fraction_rom[35]=24'd17876;
  fraction_rom[36]=24'd18387;
  fraction_rom[37]=24'd18897;
  fraction_rom[38]=24'd19408;
  fraction_rom[39]=24'd19918;
  fraction_rom[40]=24'd20428;
  fraction_rom[41]=24'd20939;
  fraction_rom[42]=24'd21449;
  fraction_rom[43]=24'd21960;
  fraction_rom[44]=24'd22470;
  fraction_rom[45]=24'd22980;
  fraction_rom[46]=24'd23490;
  fraction_rom[47]=24'd24001;
  fraction_rom[48]=24'd24511;
  fraction_rom[49]=24'd25021;
  fraction_rom[50]=24'd25532;
  fraction_rom[51]=24'd26042;
  fraction_rom[52]=24'd26552;
  fraction_rom[53]=24'd27062;
  fraction_rom[54]=24'd27572;
  fraction_rom[55]=24'd28083;
  fraction_rom[56]=24'd28593;
  fraction_rom[57]=24'd29103;
  fraction_rom[58]=24'd29613;
  fraction_rom[59]=24'd30123;
  fraction_rom[60]=24'd30633;
  fraction_rom[61]=24'd31143;
  fraction_rom[62]=24'd31653;
  fraction_rom[63]=24'd32163;
  fraction_rom[64]=24'd32673;
  fraction_rom[65]=24'd33183;
  fraction_rom[66]=24'd33693;
  fraction_rom[67]=24'd34203;
  fraction_rom[68]=24'd34713;
  fraction_rom[69]=24'd35223;
  fraction_rom[70]=24'd35733;
  fraction_rom[71]=24'd36243;
  fraction_rom[72]=24'd36753;
  fraction_rom[73]=24'd37263;
  fraction_rom[74]=24'd37773;
  fraction_rom[75]=24'd38283;
  fraction_rom[76]=24'd38793;
  fraction_rom[77]=24'd39302;
  fraction_rom[78]=24'd39812;
  fraction_rom[79]=24'd40322;
  fraction_rom[80]=24'd40832;
  fraction_rom[81]=24'd41342;
  fraction_rom[82]=24'd41851;
  fraction_rom[83]=24'd42361;
  fraction_rom[84]=24'd42871;
  fraction_rom[85]=24'd43381;
  fraction_rom[86]=24'd43890;
  fraction_rom[87]=24'd44400;
  fraction_rom[88]=24'd44910;
  fraction_rom[89]=24'd45419;
  fraction_rom[90]=24'd45929;
  fraction_rom[91]=24'd46438;
  fraction_rom[92]=24'd46948;
  fraction_rom[93]=24'd47458;
  fraction_rom[94]=24'd47967;
  fraction_rom[95]=24'd48477;
  fraction_rom[96]=24'd48986;
  fraction_rom[97]=24'd49496;
  fraction_rom[98]=24'd50005;
  fraction_rom[99]=24'd50515;
  fraction_rom[100]=24'd51024;
  fraction_rom[101]=24'd51534;
  fraction_rom[102]=24'd52043;
  fraction_rom[103]=24'd52553;
  fraction_rom[104]=24'd53062;
  fraction_rom[105]=24'd53571;
  fraction_rom[106]=24'd54081;
  fraction_rom[107]=24'd54590;
  fraction_rom[108]=24'd55100;
  fraction_rom[109]=24'd55609;
  fraction_rom[110]=24'd56118;
  fraction_rom[111]=24'd56628;
  fraction_rom[112]=24'd57137;
  fraction_rom[113]=24'd57646;
  fraction_rom[114]=24'd58155;
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
  fraction_rom[469]=24'd237965;
  fraction_rom[470]=24'd238469;
  fraction_rom[471]=24'd238972;
  fraction_rom[472]=24'd239476;
  fraction_rom[473]=24'd239980;
  fraction_rom[474]=24'd240484;
  fraction_rom[475]=24'd240987;
  fraction_rom[476]=24'd241491;
  fraction_rom[477]=24'd241995;
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
