Scherrerll/acg720-fpga-flight-controller/(commit log)

2026-10-22 docs(history): record initial wiring and receiver decisions
2026-10-22 feat(history): archive board and PPM bring-up
2026-10-22 feat(history): archive IMU and guarded attitude stages
2026-10-22 feat(history): archive virtual control and motor benches
2026-10-22 feat(history): archive B09E vendor optical-flow diagnostics
2026-10-22 feat(history): archive B0A6 wireless logging and cold boot
2026-10-22 feat: archive airframe CAD and materials document
2026-10-22 feat: archive deployed GM-FLY flight console
    Add the sharing frontend, local relay, EdgeOne backend, deployment evidence and verification steps. Record mainland access acceptance without credentials or private flight logs.
    Validation: 20 Node tests, 16 Python tests, static build and existing export integrity checks passed.
2026-10-24 feat: archive B0B0 routing closure and restore GM-FLY live sharing
    Record Oct 23-24 B0AF/B0B0 development, the 51.608 MHz routed image,
    props-off acceptance, verified Flash and battery-only cold boot.
    Preserve exact source/netlist/bitstream hashes and bounded evidence;
    keep flight acceptance explicitly incomplete.
    Restore the HTTP-only publisher and add an explicit share launcher.
    Include existing slow-network frontend fixes and portable B0B0 decoder
    fixtures, with 68 host/web tests and archive integrity checks passing.
2026-10-24 perf: smooth live telemetry with buffered history playback
    Interpolate received motion history with an explicit four-second buffer, keep raw status and PWM values, and preserve source-gap handling. Add playback and app integration coverage; deploy verified assets to the existing GM-FLY site.
2026-10-24 fix: adapt live trend windows and plot relative yaw
    Fill short-history windows with received samples and add an independently scaled relative yaw chart. Preserve source gaps and missing values, retain buffer history, and verify rendered chart paths in integration coverage.
2026-10-24 feat: compare reported attitude targets with estimates
    Expose existing B0B0 A579 targets through a read-only receiver wrapper, live relay, cloud allowlists, CSV, and axis comparison controls. Compare roll/pitch angles and yaw rates with stepped setpoints while keeping missing values and original firmware unchanged.
    Validation: 35 Node and 26 Python tests; same-sequence raw packet crosscheck, real local log/UI, and production asset/API verification.
2026-10-24 feat: combine roll pitch and relative yaw in attitude overview
    Show a shared degree/time plot by default, keep target tracking in an expandable section, and add the three-angle log preset. Verify shared scales, missing yaw, collapsed rendering, and existing tracking controls.
2026-10-24 fix: improve live response and retain valid attitude
    Reuse realtime HTTPS connections, separate successful slow responses from disconnects, and show the latest valid pose independently of buffered charts. Preserve received history through delay, map B0B0 modes, and keep missing/aged data explicitly labelled.
    Validation: 41 Node and 33 Python tests; matching production assets, real local UI, and one-minute 36-sample live API observation without errors or missing angles.
2026-10-24 fix(web): show latest telemetry with short visual transitions
    Remove the four-second chart playback delay. Keep readouts and plotted
    samples current while easing only the pose drawing and chart viewport.
    Retain source gaps, setpoint steps, stale labels, and last valid attitude.
    Validated with 36 Node tests and real local telemetry; production dprebjdfkd3l.
2026-10-24 fix(web): follow live attitude continuously between cloud packets
    Adapt drawing response to real arrival cadence instead of finishing a
    fixed 160ms tween and holding for most of each cloud update interval.
    Numeric readouts and plotted samples remain latest received values.
    41 Node tests pass, including continuous motion at 1Hz, slow responses,
    fast local updates, duplicate snapshots and no extrapolation.
    Production dpvnpeu0mqnv assets verified.
2026-10-25 feat: archive B0B3 runtime PI and Oct 25-26 progress
    Publish the selected shared XY P/I source, CLI, tests and actual 20 ns
    P3/R0 timing qualification with exact bitstreams and bounded B0B1/B0B2
    history. Record fixed overflow and arm races alongside unresolved flight
    findings without claiming hardware installation or flight acceptance.
    Include B0B1/B0B2 monitoring compatibility and 26 passing offline tests.
    Preserve source/evidence bytes, verify the exact staged archive, and index
    omitted local raw recordings and large intermediate artifacts by hash.
2026-10-26 feat(ground): add B0B3 XY PI controls and bench verification
    Add a paired P/I editor and capability query through the existing single
    serial owner. Require stopped telemetry, session/epoch/generation checks,
    SET ACK and independent GET; never automatically resend SET.
    Record 53 passing offline tests, UI checks, the authorized SRAM-only load,
    default-pair bench validation and the user's successful manual P=.075/I=0
    page transaction. Preserve the initial unanswered SET and recovery evidence.
    No Flash write or flight qualification is claimed.
2026-10-26 docs(hardware): record verified B0B3 Flash boot
    Record the authorized Flash installation of the exact SRAM-tested B0B3
    image, old-image verification, independent new Flash verification, and
    operator battery-only cold boot with default parameter GET.
    Include 15 passing mock tests and the initial CH5-mid preflight rejection.
    Preserve original firmware and evidence. Runtime P/I remain volatile;
    no motor commands or flight qualification are included.
2026-10-26 docs(analysis): investigate height loss and optical flow response
    Recheck historical V15/P005 packets and tighten the second fallback boundary
    to sequence375. Add five actual RTL witnesses for height qualification,
    stick decay, and velocity-braking versus position-restoration behavior.
    Audit native flow quantization, sparse sampling, receipt alignment and
    regression identifiability. Preserve unresolved historical causes and a
    minimal first-event diagnostic plan. No live firmware or hardware changed.
2026-10-26 docs: record B0B3 landing saturation investigation
    Capture the finite new-flight window and distinguish low-stick high-output
    holding from a separate motor-floor event. Add real RTL witnesses showing
    reachable Z integral windup and the landing collective threshold.
    Record the user's decision to defer the low-altitude height-drop issue.
    Bind source and evidence hashes; preserve firmware, Flash, and runtime gains.
    No product patch or flight-acceptance claim is made.
2026-10-27 fix(firmware): qualify B0B4 anti-windup at 50 MHz
    Qualify exact v22 P3/R0 at 20 ns: Fmax 50.075 MHz, setup +0.030 ns,
    and zero setup/hold endpoints. Set XY startup defaults to P=0.1000 and
    I=0.0350 while preventing further Z integration into saturated output.
    Archive source-bound proofs, raw physical reports, the exact bitstream,
    and the initial prototype55. Preserve frozen B0B3 and failed attempts.
    Hardware installation, cold-boot readback, and flight remain pending.
2026-10-28 docs(validation): record flight reviews and recovery after charging
2026-10-29 docs: revise B0B0 ground station guide
2026-10-29 docs: revise hardware wiring guide
2026-10-30 docs: clarify B0AF stage overview
2026-10-30 docs: clarify B0B0 stage overview
2026-10-31 feat: update ground station and Chinese B0B5 sources
2026-10-31 fix(ground): open the local parameter page from the desktop
2026-10-31 fix(ground): enable explicit desktop parameters and match device version
2026-10-31 docs(mechanical): archive final colorful assembly package
2026-11-01 Update README for mechanical final assembly
    Removed outdated information about the package and its contents.
